Sienci-Labs/Resources/_bp-icons.md

sections: bp-folder ["bp-check","bp-laptop","bp-puzzle-piece","bp-wrench","bp-book","bp-thumbs-up","bp-compress"]
post: bp-caret-right ["bp-file","bp-files","bp-file-text","bp-file-word","bp-file-excel","bp-file-powerpoint","bp-file-image","bp-file-archive","bp-file-audio","bp-file-movie","bp-file-code","bp-image","bp-camera-retro","bp-camera","bp-video-camera","bp-film","bp-play-circle","bp-home","bp-pencil","bp-trash","bp-gear","bp-gears","bp-sliders","bp-tasks","bp-server","bp-plug","bp-lightbulb","bp-life-bouy","bp-key","bp-microphone","bp-flash","bp-power-off","bp-wrench","bp-legal","bp-magic","bp-refresh","bp-info-circle","bp-exclamation-circle","bp-question-circle","bp-music","bp-headphones","bp-volume-up","bp-bullhorn","bp-bell","bp-search","bp-envelope","bp-phone","bp-star-o","bp-star","bp-star-half-empty","bp-user","bp-group","bp-thumbs-up","bp-thumbs-down","bp-comment","bp-comments","bp-check","bp-close","bp-signal","bp-bar-chart","bp-clock","bp-download","bp-lock","bp-unlock-alt","bp-tag","bp-tags","bp-book","bp-bookmark","bp-globe","bp-map-marker","bp-chevron-left","bp-chevron-right","bp-angle-left","bp-angle-right","bp-expand","bp-compress","bp-random","bp-eye","bp-calendar","bp-list-alt","bp-table","bp-briefcase","bp-thumb-tack","bp-trophy","bp-upload","bp-bookmark-o","bp-credit-card","bp-wifi","bp-feed","bp-link","bp-cloud","bp-cloud-download","bp-cloud-upload","bp-flask","bp-scissors","bp-paperclip","bp-dashboard","bp-sitemap","bp-desktop","bp-laptop","bp-tablet","bp-mobile-phone","bp-quote-left","bp-print","bp-folder","bp-folder-open","bp-smile","bp-frown","bp-meh","bp-flag","bp-shield","bp-rocket","bp-paper-plane","bp-bank","bp-language","bp-archive","bp-newspaper","bp-calculator","bp-eyedropper","bp-paint-brush","bp-area-chart","bp-line-chart","bp-pie-chart","bp-diamond","bp-user-secret","bp-safari","bp-chrome","bp-firefox","bp-opera","bp-internet-explorer","bp-map-signs","bp-shopping-bag","bp-shopping-cart","bp-file-pdf","bp-circle","bp-long-arrow-right"]
