Sienci-Labs/Resources/lmmk3/index.md

---
title: LongMill MK3 Post
menu_order: 0
post_status: draft
post_excerpt: Resources and documentation for the LongMill MK3 CNC. You will find info about routers, software, assembly, end mills - everything you need to get started.
post_date: 2026-05-19 08:14:53
taxonomy:
    knowledgebase_cat: lmk3-the-basics lmk3-assembly lmk3-handbook
    knowledgebase_tag:
        - lmk3
custom_fields:
    KBName: LongMill MK3
    basepress_post_icon: bp-caret-right
skip_file: yes
featured_image: _images/post-image.jpg
---

LongMill MK3 page order should be as follows: (last updated as of March 05, 2026)

👍 The Basics

1. Welcome
2. Specifications
    - Machine drawings
    - Carton weights and sizes
3. Prep for your LongMill
(model after the 4x8 one)
    - Add-ons
    - Feeds and Speeds
    - Auto-spin
    - Workspaces and Homing
    - Fundamentals
    - Software
    - Prepare a perfectly flat table so MDF is parallel to it
    - Link to how to setup and use the add-ons
4. Inductive Sensors
    Don’t use LongMill MK2 page, there is a lot of MK2 specific information
    Link to Workspaces and Homing page
5. Closed Loop Stepper Motors
    Link to alarms
6. AutoSpin Router
    Link to Auto-spin knowledge base

🔧 MK3 Assembly

1. Best Practices
2. Unboxing
3. Table Mounting & Surfacing
4. Final Checks
5. First Project

📙 Handbook

1. Squaring & Tramming
2. Maintenance 🛠️
3. Open Source
