Sienci-Labs/Resources/spindlevfd/index.md

---
title: Spindle VFD Post
menu_order: 0
post_status: draft
post_excerpt: Info on how to use Sienci Labs spindles and source third-party spindles.
post_date: 2026-06-02 14:48:53
taxonomy:
    knowledgebase_cat: spindlevfd-handbook
    knowledgebase_tag:
        - spindlevfd
custom_fields:
    KBName: Spindle VFD
    basepress_post_icon: bp-caret-right
skip_file: yes
featured_image: _images/post-image.jpg
---
