Sienci-Labs/Resources/gsender/index.md

---
title: gSender Post
menu_order: 0
post_status: draft
post_excerpt: 
post_date: 2024-07-18 18:14:53
taxonomy:
    knowledgebase_cat: gdocs gs-advanced gs-ex
    knowledgebase_tag:
        - gsender
custom_fields:
    KBName: gSender
    basepress_post_icon: bp-caret-right
skip_file: yes
featured_image: _images/post-image.jpg
---

gSender page order should be as follows:

📙 The Basics

1. Installation
2. Setup & Layout
3. Using gSender
4. Feedback/Problems/Bugs?

Advanced

1. Shortcuts
2. Homing & Limits
3. Calibration
4. Macros & Automations
5. Tool Changing
6. Wireless Control
7. Add-Ons
8. grbl Alarms & Errors

Experimental

1. Edge Features
2. Classic
3. Compile!
