Sienci-Labs/Resources/gsender/gs-additional-features.md

---
title: Additional Features
menu_order: 1
post_status: publish
post_excerpt: Learn the advanced features of gSender such as shortcuts, macros, workspaces, calibration tools, controlling spindles, lasers, coolant, and more.
post_date: 2021-07-01 15:50:00
taxonomy:
    knowledgebase_cat: gs-advanced
    knowledgebase_tag:
        - gsender
custom_fields:
    KBName: gSender
    basepress_post_icon: bp-caret-right
skip_file: no
featured_image: _images/_gsender/_features/gs_fe_p1_KeyShort.jpg
---

This page covers all the advanced features of gSender such as shortcuts, macros, workspaces, calibration tools, controlling spindles, rotary axes, lasers, coolant, and more. Remember, you can always quickly navigate the page by clicking the headings in the 'Page Contents'.

## Touch Plate Setup

gSender has support for three types of touch plates:

1. The **Standard Block** design
1. **Z Probe**, also sometimes referred to as a 'puck'
1. And our specialized **AutoZero** touch plate

If you're trying to set up a custom **Standard Block** plate, use some calipers to make the measurements shown below. Once these are noted down, enter these into gSender's 'Probe' settings in similarly named entries, apply the changes, and now you should find that gSender's probing routine has been altered to fit the shape of your touch plate.



For a custom **Z Probe**, setting up is simple since you just need the thickness of the 'puck'. Enter that value into gSender's 'Probe' settings under 'Z Thickness', apply the changes, and you should be good to go!



The AutoZero touch plate doesn't require any setup at all, other than selecting it, and applying the changes!

## Calibration Tools

The **Tool Tab** is always available near the bottom left of the screen. Here you'll find some tools that you can use to make finer adjustments to your machine for improved performance:

- XY Squaring
- Movement Tuning
- Surfacing

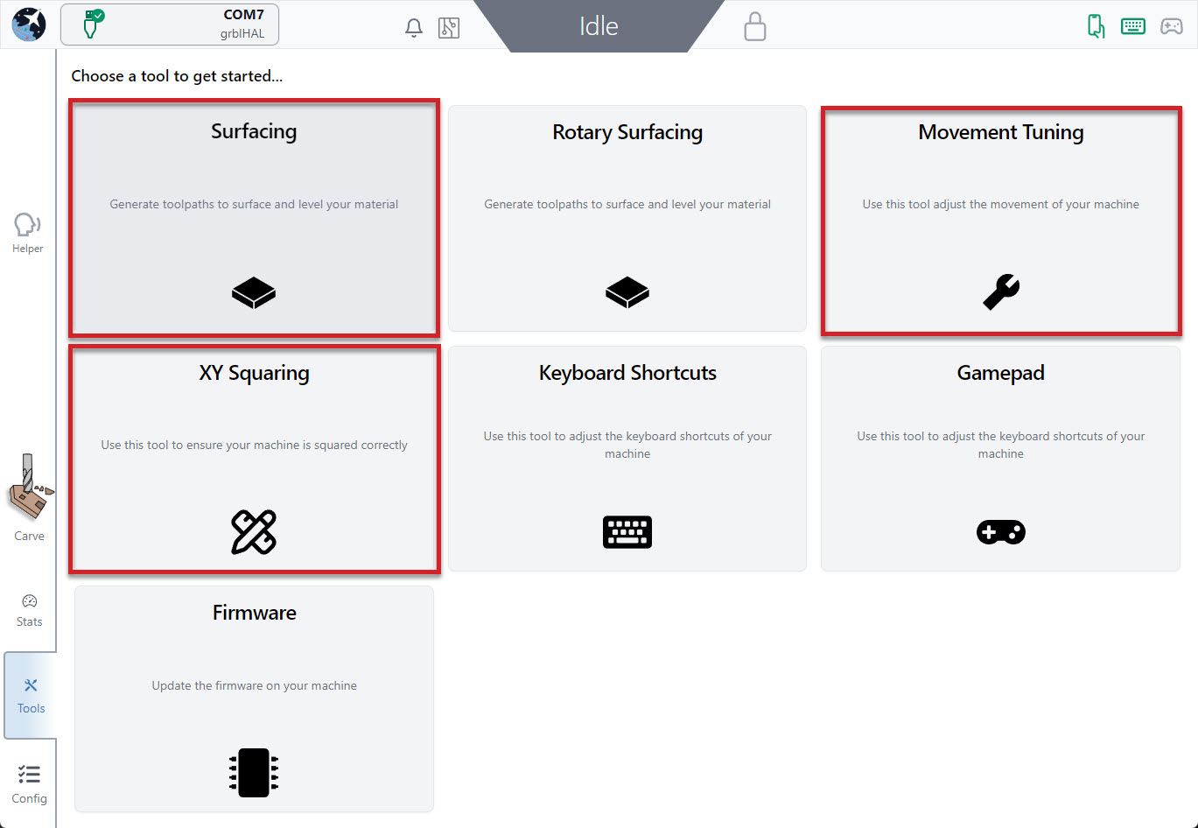
[picture p148: _images/_gsender/_features/_tools/gs_fe_to_main.jpg]


### XY Squaring

When setting up any CNC, like when mounting <a href="https://resources.sienci.com/view/lm-table-mounting/#mounting-your-LongMill">a LongMill to a table</a>, usually a squaring step is needed to ensure cuts don't come out skewed. This **Software Wizard** (step by step guide) is a great asset to help speed things up by turning a typically 'guess-and-check' process into some easy measurements and behind-the-curtain math in 3 main steps:

1. Mark 3 points on your machine to make a triangle (the larger the triangle, the better)
1. Measure & enter the distance between the triangle points
1. See the results and adjust accordingly

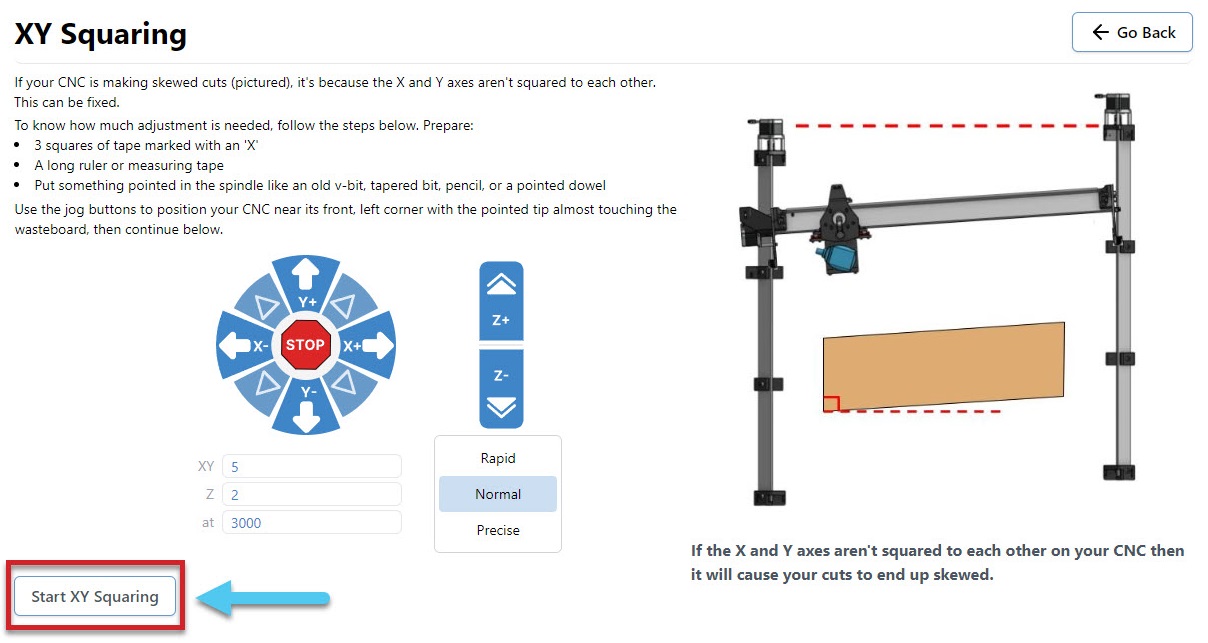
[picture p149: _images/_gsender/_features/_tools/gs_fe_to_xysquaring.jpg]


You will need the following:

- Ruler or measuring tape
- Tapered bit or V-bit
- 3 tape pieces marked with an 'X'

1. Jog the machine to the front left corner, with the bit raised slightly over the surface of your wasteboard
1. **Mark** the point with tape marked with an X, and move the machine as directed (Default 300mm)
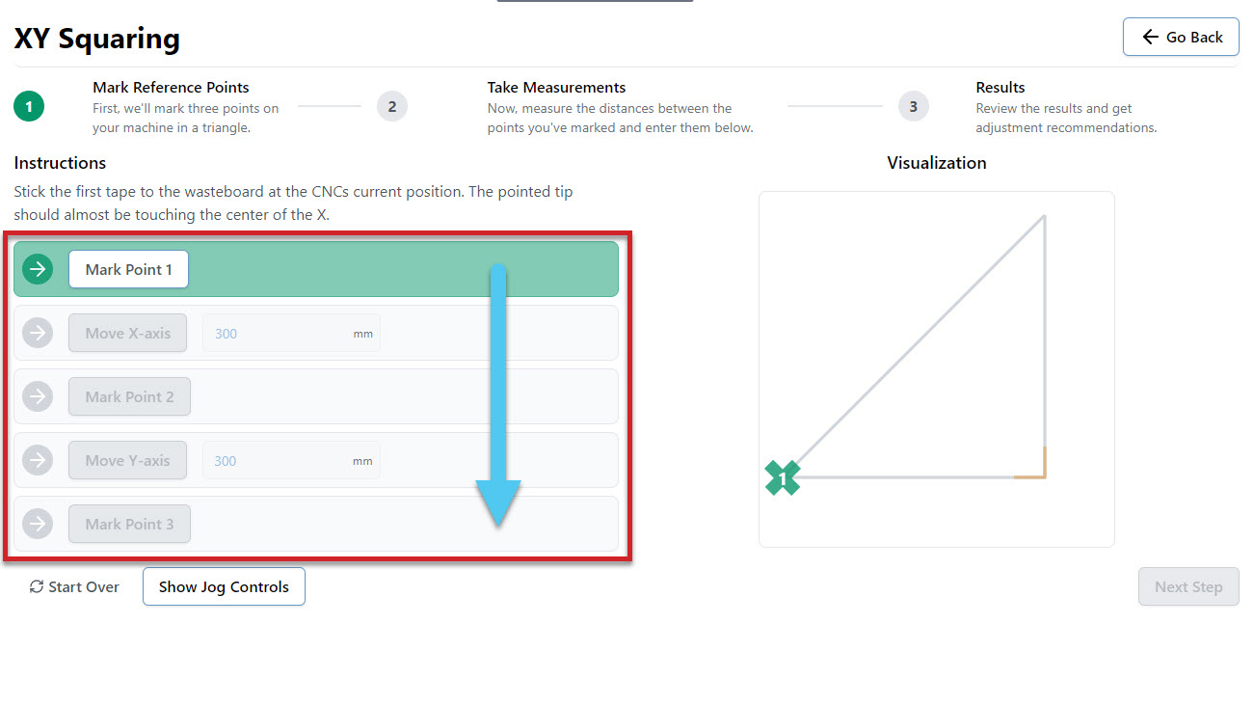
[picture p150: _images/_gsender/_features/_tools/gs_fe_to_xysquaring1.jpg]
  
1. Continue to mark points and move the machine until all boxes are complete and your triangle is marked
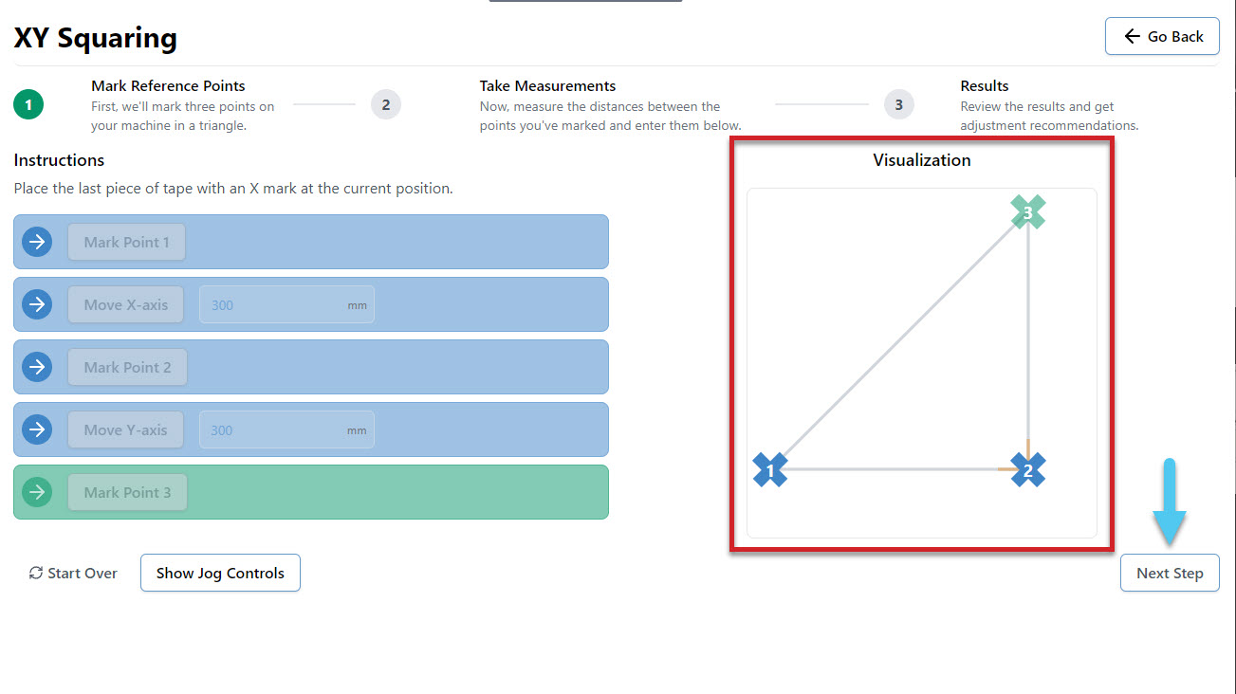
[picture p151: _images/_gsender/_features/_tools/gs_fe_to_xysquaring2.jpg]
  
1. Measure the distance between each X and enter the values into the 3 boxes. For instance you might measure 306mm, instead of the expected 300mm. Hit the Confirm button to move to the results page.
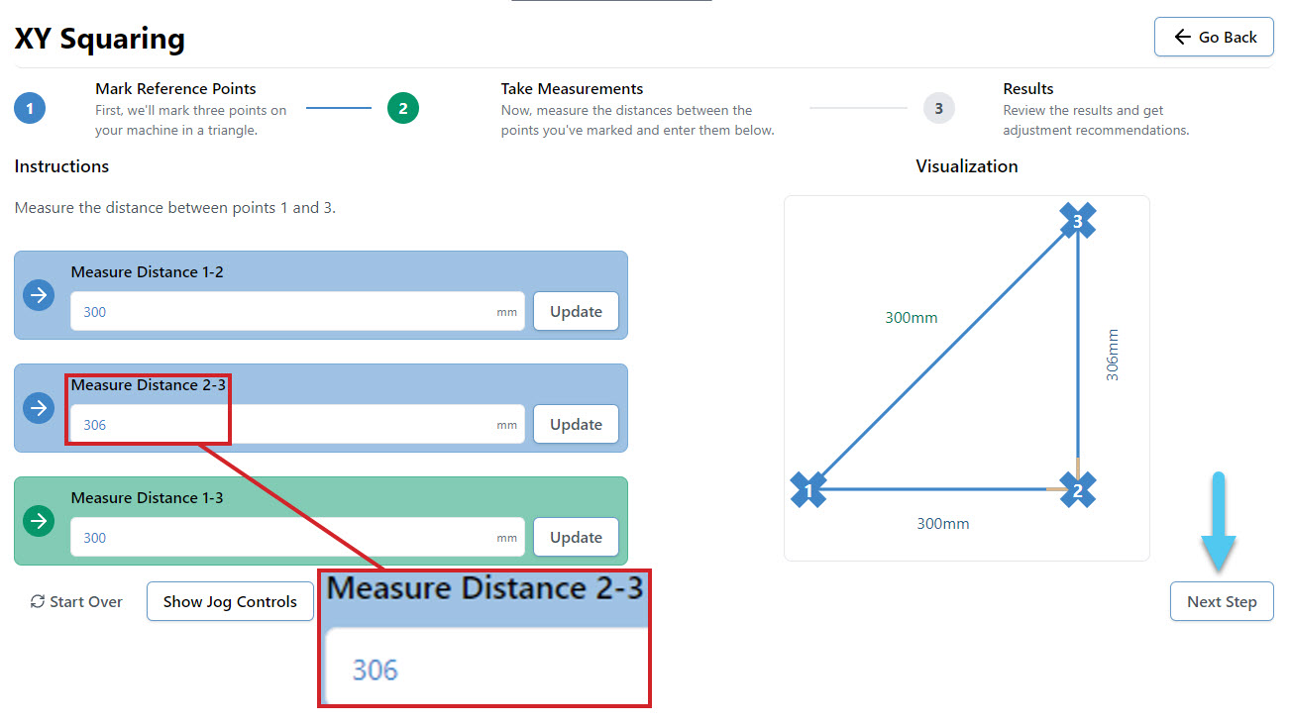
[picture p152: _images/_gsender/_features/_tools/gs_fe_to_xysquaring3.jpg]
  
1. At the end you'll be told how square your machine is and whether you need to take action to adjust it further or if it's close enough that you can leave it. The squaring tool also keeps an eye out for if your steps/mm (axis travel resolution) are off and can adjust those too.
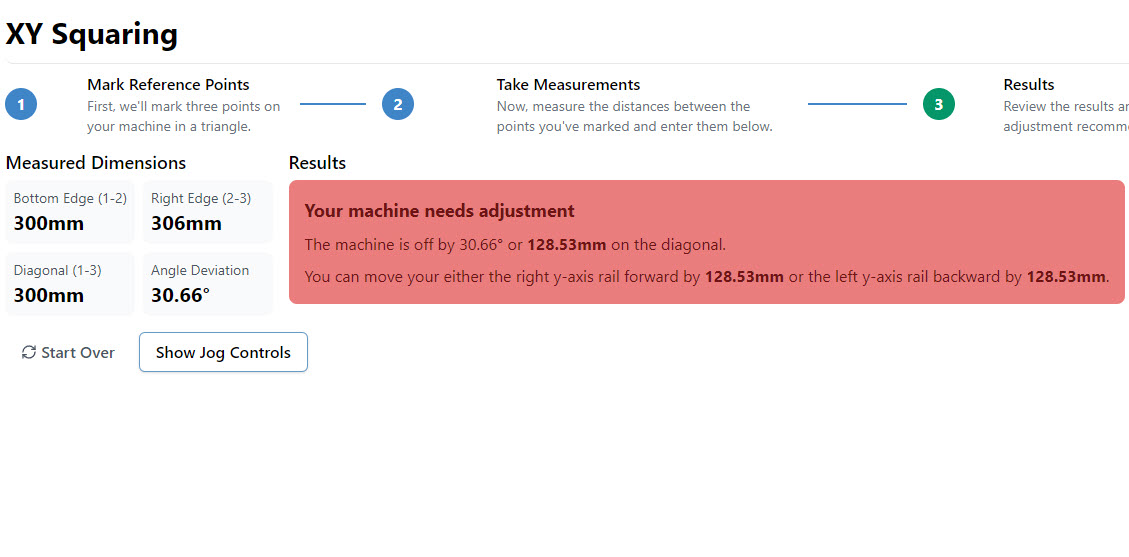
[picture p153: _images/_gsender/_features/_tools/gs_fe_to_xysquaring4.jpg]
  

You can also try watching how this process works in this <a href="https://youtu.be/CCpb70ypulY" target="_blank" rel="noreferrer noopener">user-made video by SparksTech</a>!

### Movement Tuning

Another **Software Wizard** (step by step guide) found in the **Tool tab**. This one is designed to help fine tune how much your motors turn to improve the accuracy of your machine movements. This is done through modifying the EEPROM settings stored on your CNC. You can tune the X, Y and Z axes individually.

You will need:

- Marker or tape
- Measuring tape

1. Jog your machine to the middle of whichever axes you choose to tune, so that there is enough room to complete this procedure. For example, on the X-axis you would jog halfway on the X-axis rail
1. Select what axis to tune on the drop down menu
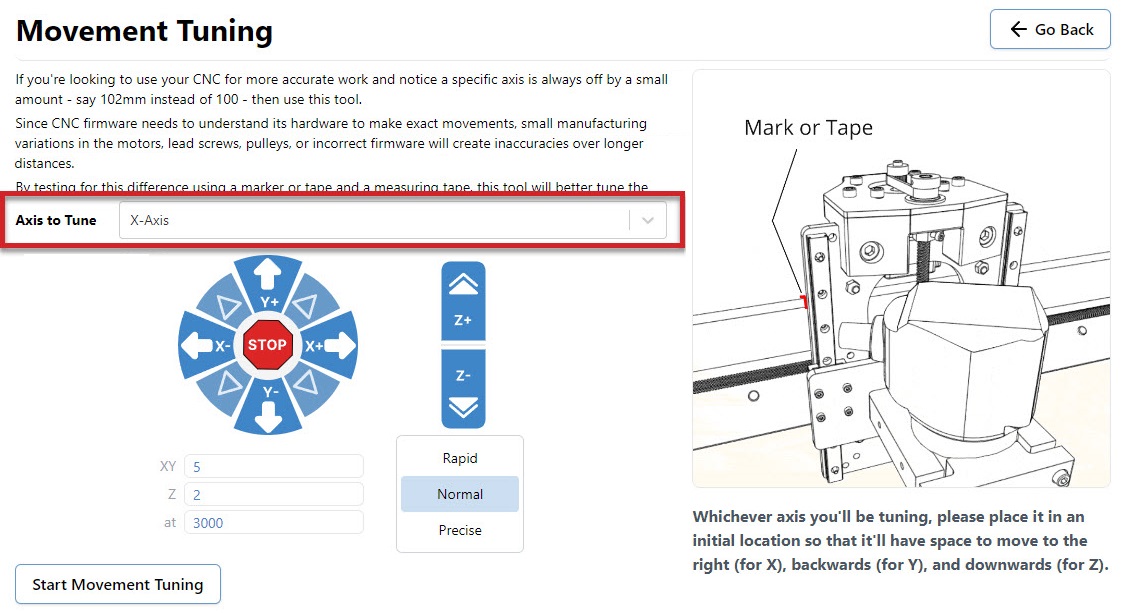
[picture p154: _images/_gsender/_features/_tools/gs_fe_to_movementtuning.jpg]
  
1. **Mark down the starting location** as a reference point on the machine. For example the X-axis tuning references the edge of the XZ gantry on the X rail.
1. **Move** the axis a chosen distance (Default 100mm)
1. **Measure** the distance between the starting location and the finishing location
1. Enter the measured value into the **Set Distance Travelled** box
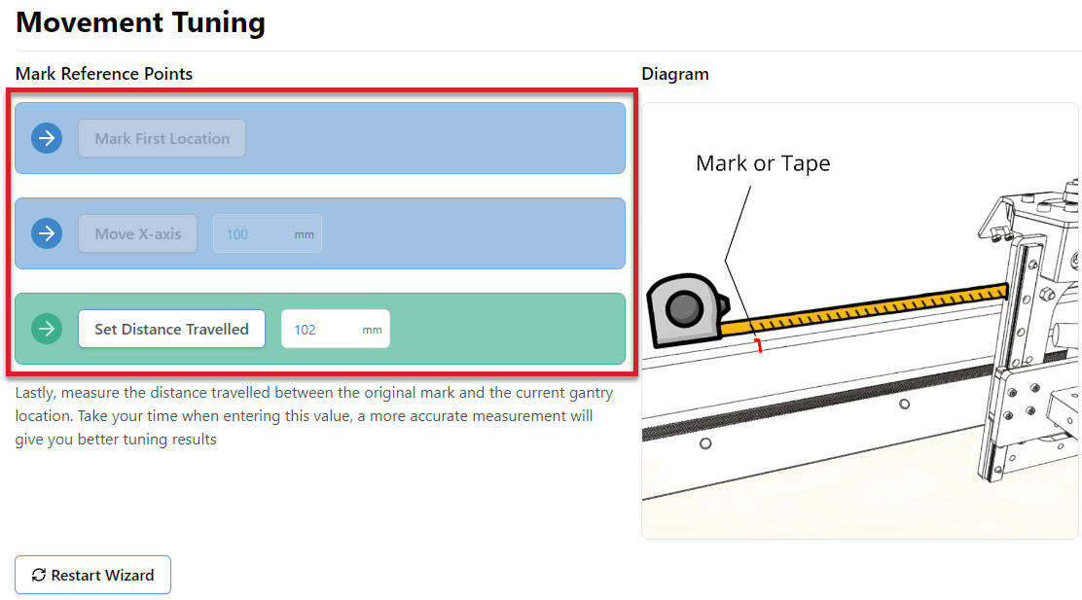
[picture p155: _images/_gsender/_features/_tools/gs_fe_to_movementtuning2.jpg]
  
1. You can now change the EEPROM setting if recommended by the procedure by pressing **Update Steps-per-MM**. This will bring up a popup that explains the change about to be made, and allows you one last chance to cancel the update.
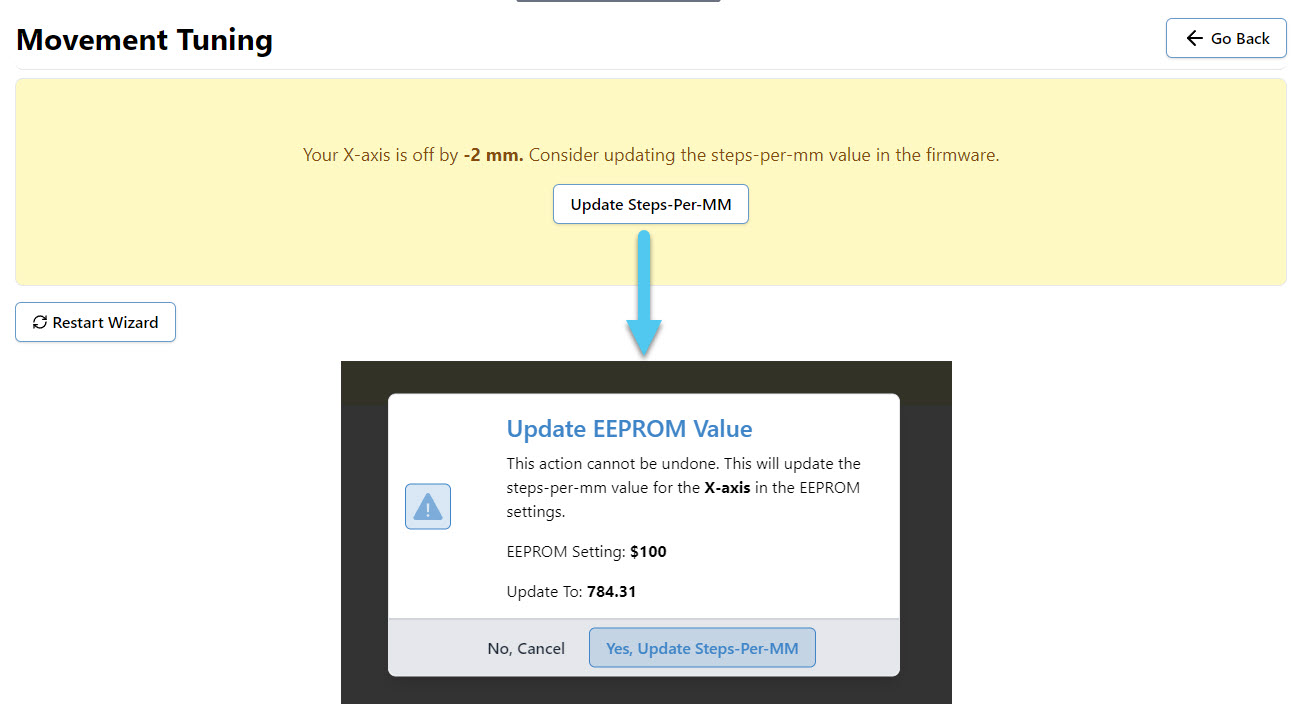
[picture p156: _images/_gsender/_features/_tools/gs_fe_to_movementtuningfin.jpg]
  
1. Repeat the procedure for each axis you wish to tune

### Surfacing

Surfacing the wasteboard of your machine or any project or blank material, can easily be done right inside gSender from the **Tools tab**! This saves the hassle of drawing rectangles in your CAD/CAM program and moving files around until you get the settings right. It's also great for creating a perfectly flat surface of your starting materials, just like a jointer or surface planer would. You can also use the [Rotary Surfacing Tool](#rotary-surfacing-tool) if you are wanting round stock off a rotary axis.

https://youtu.be/hZ8ltb0w3Ao

If you plan to use this tool to surface your wasteboard or larger pieces of material, some extra advice we'd give is to remove any accessories that might get in the way of your machine travelling to its limits as well as have a good vacuum on hand because surfacing can get really messy.

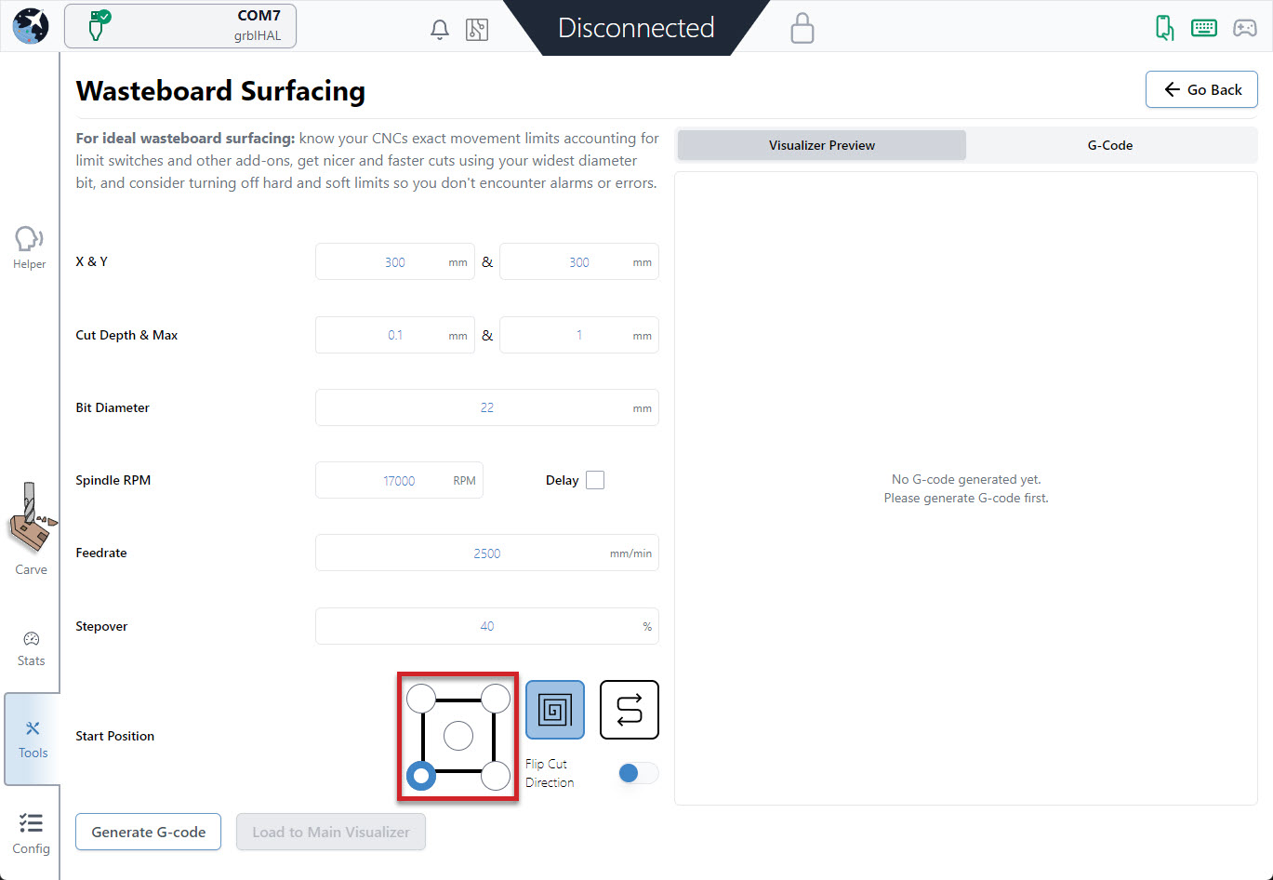
[picture p157: _images/_gsender/_features/_tools/gs_fe_to_surfacing.jpg]


1. Start by entering the settings you'd like to use to generate your surfacing job on the left side:
   - **X & Y**: decides the cutting size (width and depth) you want to surface. If you're surfacing your wasteboard, use the manufacturer's spec on max machine travel or manually jog to the limits to cover the full cutting area, or if you're surfacing a piece of material then you can use a measuring tape.<br>- **AltMill**: 1265mm (49") x 635mm (25") or 1251 (49")<br>- **LongMill MK2**: 818mm (32.2”) or 1278 (50.3”) x 366mm (14.4”) or 866 (34.1”)<br>(if using limit switches, remove about 8mm/0.3” in X and 11mm/0.43” in Y)<br>- **LongMill MK1**: 320mm (12.6”) or 805 (31.7”) x 344mm (13.54”) or 844 (33.23”)<br>(if using limit switches, remove about 35mm/1.38” in X and 24mm/0.94” in Y)<br>(if using magnetic dust shoe, remove about 34mm/1.34” in X)<br>- **Mill One**: 235mm (9.25”) or 257 (10.1”) x 185mm (7.28”)
   - **Cut Depth & Max**: describes how deep you want to cut per pass and the total depth you want to cut down. For larger surfacing bits usually you should keep cut depth below 1mm, max depth should be increased to a couple millimeters if you think your material is very warped.
   - **Bit Diameter** (typically 6 - 25mm): make sure you have the right bit for the job like a surfacing tool or a large, flat end mill since this will give you a better surface finish.
   - **Spindle RPM** (default 17000): only applies if you have an automatic speed control, otherwise set this manually on your router.
   - **Feed rate** (default 2500mm/min): influenced by the RPM, step over, bit diameter, and cut depth. Luckily if you set it incorrectly you'll be able to override it during the job since surfacing can cause burning when cutting too slow or can have worse surface finish when cutting too fast.
   - **Stepover** (default 40%): sticking around 40% tends to be a good balance between speed (using a higher %) and better surface finish (using a lower %).
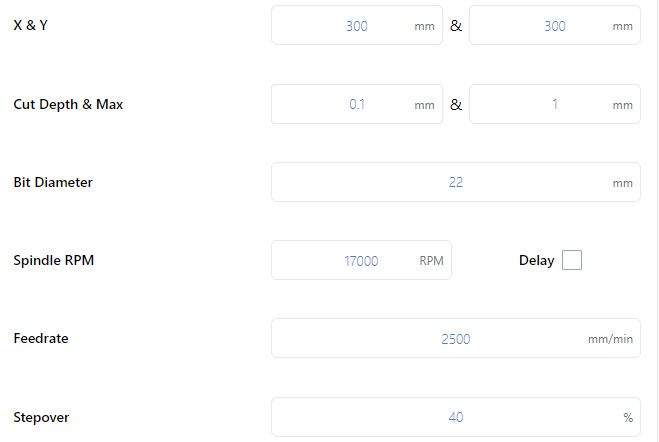
[picture p158: _images/_gsender/_features/_tools/gs_fe_to_surfacing2.jpg]
  
1. Decide where you want to start surfacing from by clicking any of the corners or the center. In most cases the front, left of the machine is the most convenient, and is the default setting. You can also select a surfacing pattern of spiral or zig-zag. The spiral will only cut from the inside-out if the start position is the centre. If you toggle the flip cut direction, the spiral will cut conventional instead of climb, and the zig-zag pattern will cut vertically instead of horizontally.
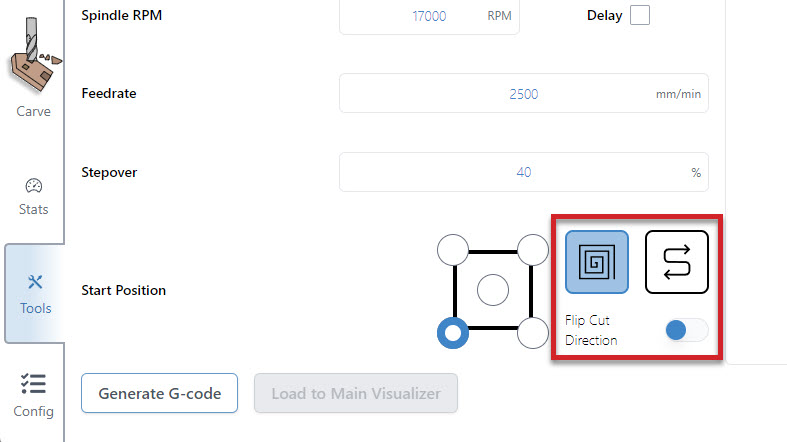
[picture p159: _images/_gsender/_features/_tools/gs_fe_to_surfacing3.jpg]
  
1. Press '**Generate G-code**' and check your surfacing tool path using the 'Visualizer Preview' tab. You can also see the raw g-code using the 'G-code Viewer' tab and can copy and save it to a g-code file if you'd like to use it again later.
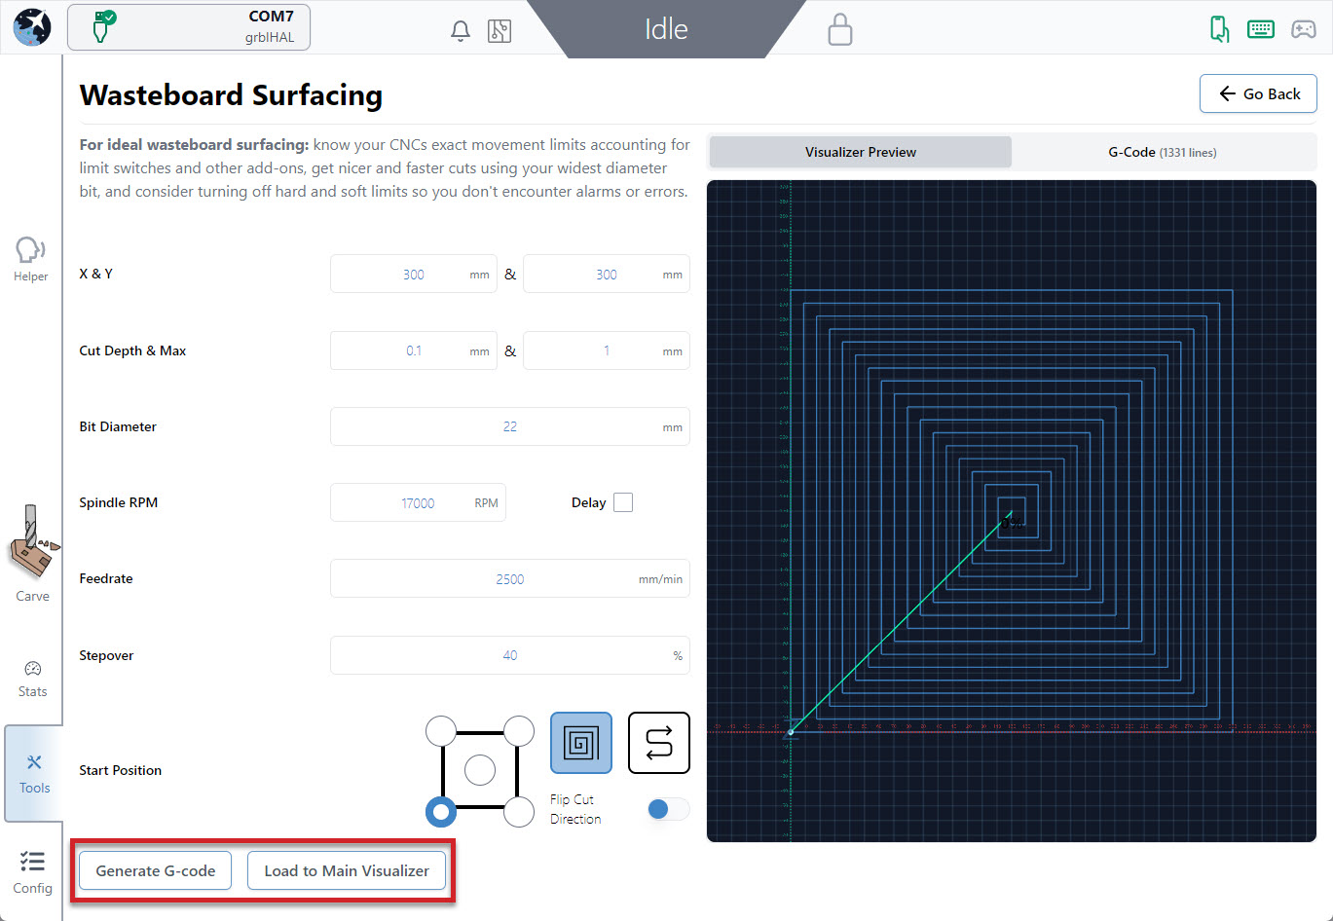
[picture p160: _images/_gsender/_features/_tools/gs_fe_to_surfacing4.jpg]
  
1. Press '**Load to Main Visualizer**' to bring the g-code into gSender's main screen. Make sure that you jog to the starting point and set your zero in the right place before starting the job. You can also press the '**Outline**' button as an easy way to check that you'll be surfacing where you expect and if you find the dimensions aren't correct you can always re-open the surfacing tool, tweak the size, and try again. Feel free to start the job whenever you're ready!
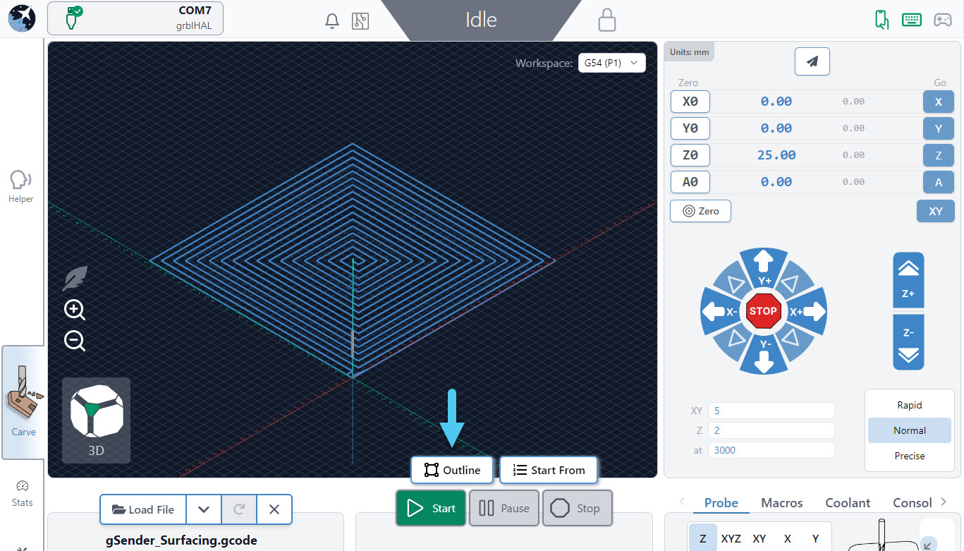
[picture p161: _images/_gsender/_features/_tools/gs_fe_to_surfacing5.jpg]
  

## Spindle & Laser Support

Similar to the manual coolant control, this area is for manual control of a spindle or laser outside of g-code sending. If you have a spindle or laser, you can activate these controls by going to the Config tab ➜ Spindle/Laser section. Here you can enable these functions by flipping the 'Spindle/laser controls' toggle. Don't forget to apply your new settings!



Back at the main Carve screen, you'll see the 'Spindle/Laser' tab at the bottom right. Here you can click to toggle between 'Spindle Mode' and 'Laser Mode', changing your grbl settings for you and displaying buttons specific to each device. For each mode there is also a warning that will appear in the right, top bar of gSender to inform you if the spindle or laser are active. This will happen both during manual control but also during job sending.

In '**Spindle Mode**' you can select your current spindle, adjust the spindle speed with a slider, spin it up in either direction, and stop it again with the 'Stop' button. These are all based on g-code commands that can also be entered into the console manually if desired. The speed slider is set from your grbl firmware settings, so max and min speed can be altered in the Config ➜ Spindle/Laser.



'**Laser Mode**' is very similar, allowing for On/Off control, a slider for setting the laser power during manual control, and a 'Laser Test' button. The laser testing function is handy when troubleshooting your laser setup or for other sorts of locating and alignment because it only enables the laser for a short time before turning it back off again. Though this is much safer than regular on/off control, we still highly advise that you have you have a hand on a kill switch or E-stop during testing or control of either Laser or Spindle modes so that in case something goes wrong with your computer or the program they can still be safely deactivated.



### Laser Diode Support

Some accessories can be really handy to add to a CNC router like a laser diode, drag knife, or pen plotter. These would all perform better on a faster, dedicated machine, but for occasional use why not use the existing motion system of the router to do other things for you? A laser diode in particular can be great because you can clamp the material to carve and then laser engrave afterwards and know that everything is still aligned.

Since many CNCs are coming with diode accessories, gSender has some unique features to also support lasers. Once 'Laser Mode' is turned on, gSender will:

- Automatically apply an offset from the router/spindle to the laser so all your g-code files stay aligned (configured in the Spindle/Laser settings, or with Firmware settings $741 and 742 on the SLB).
- Turn on the laser at low power when running a job outline (enabled in the Spindle/Laser settings). This will help you to better see where your project is going to be located on the material.
- Switch to a specialized visualization designed to show raster engraving images better than typical g-code visualizers. Seeing the laser intensity in the movements is very useful to get a better idea of what your projects are going to look like when they're run. This will only apply to files loaded after 'Laser mode' is enabled, where you'll see the colour change from the default **blue** to **red**.



## Coolant Control / IOT Relay

If you have a coolant control pin on your CNC machine, gSender has a tab for manually controlling it. Under the 'Coolant' tab on the main Carve screen, you can find the 'Mist' and 'Flood' buttons to activate the different modes of coolant use, as well as an indicator for whether the coolant function is active or inactive. This indicator also functions during job sending. You can turn off both coolant pins by pressing the 'Off' button.

Many hobby CNCers don't have a need for coolant and so prefer to use these outputs for controlling other periphery. The most common is an IOT relay that can be used to automatically control a vacuum for dust collection, the CNC's router, LED lighting, and more. See an example of how to set that up here: <a href="https://resources.sienci.com/view/lm-iot-relay/" target="_blank" rel="noopener">https://resources.sienci.com/view/lm-iot-relay/</a>



## Homing / Limits

Before getting into the weeds on how you can set up limit switches and homing on your CNC for various benefits, it would be good to briefly cover some of the basics:

- On the main Carve page, above the jog controls, you should see a set of numbers and buttons that make up your machines 'DRO' (Digital Read Out). You can think of it as similar to a car navigation system.
  - The buttons around this area allow you to make quick movements (blue buttons) and set the <span style="color: #3e85c7;">blue numbers</span> back to a value of 0.
  - You'll see two sets of numbers, where the blue ones on the left are your **<span style="color: #3e85c7; text-decoration: underline;">Work Coordinates</span>** and the gray ones on the right are your **<span style="color: #777; text-decoration: underline;">Machine Coordinates</span>**; these are the two primary coordinate systems that guide a CNCs movements.
  
- A CNC's **<span style="color: #3e85c7; text-decoration: underline;">Work Coordinates</span>** are very often used/edited in day-to-day cutting since they describe the exact location of the project that you're planning to cut.
  - This is effectively the 'working area' of your project.
  - Once you've placed your material on the machine bed, you'll bring the cutting head to the starting point for the project (also known as the 'zero point' or 'origin') then let the machine know that it's now at the starting location.
  - When you're at the starting location for your project, the <span style="color: #3e85c7;">work coordinates</span> should all read as '0', but if you manually move your CNC to the left, down, or towards you then the number will start to decrease, or they'll increase if you move right, up, or away from you.
- The **<span style="color: #777; text-decoration: underline;">Machine Coordinates</span>** starts to become more important once you've set up **Homing** on your CNC
  - These numbers are very similar to <span style="color: #3e85c7;">work coordinates</span>, except they describe the 'working area' of the CNC itself.
  - This means that once you turn on your machine and home it, it'll now know exactly where it's located within its physical size constraints, it'll also know the exact offset between the homing location and the location of your <span style="color: #3e85c7;">work coordinates</span>.
  - This starts to become powerful because you can then do things like resume cutting your job after a loss of connection or power-outage for example. Using homing and <span style="color: #777;">machine coordinates</span> gives your CNC the memory of its location no matter the circumstances.
  - Using <span style="color: #777;">machine coordinates</span> without homing is also still possible, but you'd need to bring your machine to a reliable location using probing or some other method, then power-cycle the machine, since without homing the machine coordinates are set at the time the machine first powers on.
  

### Workspaces

Another concept worth mentioning is **workspaces**. Usually you would only have one 'zero position' per project, but what about cases where:

- You need to reorient your material to cut at it from a different side
- You plan to do a series of carves that require different zero positions
- You want to align your projects to jigs you've fixed to the CNC bed

In these cases, workspaces are basically the ability for you to set multiple **<span style="color: #3e85c7;">work coordinates</span>** that your machine will remember and can toggle between. All you have to do to use these is select a new workspace using the dropdown on the Carve page, after which everything else will continue to behave as normal including zeroing, probing, running files, and more.



In the image below you can see a demonstration of setting up 4 different workspaces to align to jigs on the wasteboard of the CNC. Each of these has their zero set to the bottom left corner, except the circle jig which has the zero placed at the middle.



This is also discussed at about 5:30 of the video below:

https://youtu.be/jmiaWA5tiVw

### Setting up Homing

The summary of the benefits of homing is that it allows your CNC to reliably know its own location. This provides many benefits like job recovery and using workspaces for more complex jobs or batch cutting. To get homing working on your CNC, you'll need:

1. **Limit switches** (also referred to as *end stops* or *homing switches*) which are installed at one or both ends of each movement axis of the CNC. You can see an example of these [on our store](https://sienci.com/product/inductive-sensor-kit-for-the-longmill-mk2/).
1. **Homing enabled in firmware** which can be done through the Config tab
1. **Machine limits set up** to match the physical travel distances of your CNC
1. Any other customization you'd like to make for your particular setup

Going to the Config Tab and scrolling to the Homing/Limits section you'll see an option to turn Homing on:



**grblHAL** machines will also have additional options to choose from, like homing single axes, requiring homing on startup, set machine origin to 0, and more. Typically you'll at least want to turn on 'Set machine origin to 0'.



While you're here, we'd also recommend that you use the lights at the top of the Homing/Limits section to check that all your limit switches are plugged in and working correctly. They should be red by default and light up green when they're triggered, and if that's not the case then you might want to change your settings or check your wiring.

Once you apply settings, you'll find back on the main Carve screen that there are some new buttons available:



1. The **Home** button will help you to manually home your machine any time you need (sends the typical $h command). For your first time homing, have your hand on the machines E-stop in case the homing goes the wrong direction. Many machines home to the front left corner or the back right, so if your machine is behaving incorrectly then go back to Config to adjust your homing directions.
1. Four **Rapid-Travel** buttons to move your CNC at its maximum speed to any of your machine's 4 corners (offset by 5mm). **These should only be used once your machine is homed and you've correctly set up [your machines maximum travel](#setting-limits).**
1. A configurable **Park Location** that acts similarly to the Rapid travel buttons but instead moves to a custom location you set yourself. To set up your parking spot, go to Config ➜ Homing/Limits and scroll down to the bottom of the section. Here you can enter the coordinates of your parking spot manually, or move your router/spindle to the spot you wish to park and hit the **Grab** current position button. Test out your new spot by hitting the 'Go to' button in settings or hitting the 'P' button on the DRO. Don't forget to hit the Apply Settings button to save your new spot!
  

### Setting Limits

Things like machine limits for the **<span style="color: #777; text-decoration: underline;">Machine Coordinate</span>** system are usually set up by the manufacturer and so might never need changing. There are cases though where depending on your model or if you've assembled a kit and installed add-on your maximum travel area might need to be adjusted to properly reflect your machines travel limits.

We recommend you do this especially if you're planning to use the 'quick-travel' buttons. You can find these settings by going to Config ➜ Homing/Limits ➜ X-axis maximum travel (Y, Z-axes are here too). Remember to hit the **Apply Settings** button afterwards.

In this example the Y-axis value has been adjusted.

If you'd like more information on how to set up and use limit switches, read here: <a href="https://resources.sienci.com/view/lm-adding-limit-switches/" target="_blank" rel="noopener">https://resources.sienci.com/view/lm-adding-limit-switches/</a>

### Soft Limits

With homing working, you can optionally choose to turn on soft limits. This feature will keep an eye out after you home your machine to see if any movements are trying to go past your [machine limits](#setting-limits), and stop those movements from happening to protect your machine. Enable these in Config ➜ Homing/Limits ➜ Soft limits enable. Don't forget to hit the Apply Settings button to save!



### Hard Limits

If you have a sensor on both sides of each axis, all 6 sensors can provide you a hardware backup solution, to the software solution provided above with the soft limits. With hard limits on, if your machine get's close to the edge of an axis, your sensor will trigger, stopping any further movement. Enable this in Config ➜ Homing/Limits ➜ Hard limits enable.



## Wireless Control

If you've ever wanted to run your CNC without being stuck right next to it, this is the feature you're looking for. Once enabled, it will allow other devices on the same internet network to connect to the main computer that's running your CNC. These '**remote devices**' can be anything that can connect to the internet and run a web browser, meanwhile the '**inline computer**' plugs into your CNC with a USB or Ethernet cable and will receive commands over the internet from the remote device.

This feature is handy if you'd like to:

- Load in a file from your design computer outside your shop then run it on your computer inside the shop
- Use a tablet as the primary means of controlling your CNC rather than a mouse and keyboard
- Use a phone for occasional use when jogging or running functions
- Leverage a mini PC or Raspberry Pi as the inline (tethered) computer for cheap, fanless, and reliable operation without taxing them with a display, keyboard, and mouse (though this still doesn't create a fully 'headless' setup)

Before diving into the setup, here are some quirks and warnings that are important to keep in mind:

- Both systems need to be on the same internet network to work
- The '**remote device**' needs to be able to run a web browser
- The setup process can be a little more involved, so we don't advise using this feature if you're not confident with troubleshooting your own setup
- You may need to be an Administrator of the inline computer to make the changes needed
- If you intend to use this feature for more important projects or with expensive tools or materials, keep in mind that it will always be inherently less reliable than a hard-wired connection
- This feature is **NOT** intended to enable use of your CNC while **AWAY FROM YOUR WORKSHOP**. A CNC should always be run while you or another knowledgeable operator is in the vicinity to ensure safe machine operation and be able to react if intervention is required. CNCs can cause fires from electronics, material friction, and can have other safety hazards if not properly monitored.

### Wireless Setup

All setup steps need to happen on the inline computer (the computer you'll have connected via USB or Ethernet to your CNC) and have been simplified to mostly happen within gSender:

1. To begin, click the cell phone icon on the top right of the screen.
  
1. This is where wireless control is set up. First, click the '**Enable Wireless Control**' toggle. Second, you'll see the boxes for 'Addr' (address) and 'Port' become available. The default values for these should work but if you have a particular setup or require troubleshooting then consider changing these.
  
1. Once you click the 'Save' button, gSender will automatically restart in order for the changes to take place.
  
1. You'll know the setup was successful if gSender restarts and the remote connect icon is green.
  
1. To connect with your '**remote device**', click the cell phone icon again to open the wireless control settings. If you plan to use a phone, use the camera to scan the QR code, and for any other device 'copy' the text at the bottom right  into the address bar of a web browser like Chrome or Edge. After the page loads, you should see a copy of gSender running in the web browser!
  
1. If there was a problem during setup, then you might've encountered a firewall or unavailable port. Solutions to these are covered in the **[troubleshooting](#troubleshooting)** section.

### Using gSender Remotely

With setup complete, regular use is very straightforward:

1. As long as your 'inline computer' is on and connected to your CNC, and your CNC is powered on, then re-using the same text on the web browser of any device will give you access to a copy of gSender running fully remotely. Example text could look like this "192.168.68.155:8000" where for the phone interface it would have "/#/remote" added onto the end.
1. For phones and tablets, it can also be easy to re-use this webpage by saving it to a bookmark on your home-screen so you can open Remote gSender easily anytime you want! <a href="https://youtu.be/UrlDJOY3i-8">Check out this video</a> for details.
1. Once connected, you'll be able to control your CNC remotely with most of the same features and functions you’d normally expect:
   - Use both the remote and inline devices simultaneously to control your CNC like jogging, opening and closing files, probing, macros, and more
   - Notice that both their screens look exactly the same so you can watch the visualizer move around or check on the machine state
   - On phones the screen will look different since we've optimized it for jogging, setting zeros, and probing
   - When you click to 'load a file' you'll only be able to load files from the device you're currently on, don't expect to gain access to the files stored on the opposite device. However once the file is loaded into gSender, you'll be able to run it from any device.
   - There can be multiple remote devices all connected to the same inline computer at the same time to control your CNC from multiple devices. There can also be multiple inline computers controlled from the same remote computer, giving you multi-CNC control from the same device.
1. Some gSender-specific 'local' settings like won't carry over to the remote device so if you want to make sure files are run the same way every time you'll need to transfer your gSender settings over by following the ['Transfer Settings' instructions](#gsender-preferences)

### Troubleshooting

If you ran into issues during remote control setup, here are some checks you can make:

1. Make sure you have gSender open, have gSender connected to your CNC, and you've turned wireless control on
1. Ensure both your computers / devices are on the same internet network and the IP numbers match on both devices
1. If on the remote device you get a popup for "Server Connection Lost", this just means that either gSender on the inline computer was closed or the shared internet is disconnecting. You should be able to fix this by restarting gSender on the inline device, then clicking "Attempt Reconnect" on the remote device.

1. If there was a problem using the specified IP address or Port, you'll get an error window to let you know. In this case you should be able to reopen gSender, go back to the Wireless Control settings, and try another IP or Port until the setup is successful. Common port values are 3000, 8000, and 8080 and generally don't go below 1024 since those are considered privileged. Changing IP addresses can also help if you're running a VPN or need a different internal IP to external IP mapping.
  
1. If you have a Windows Security Alert window pop up during setup, it means your inline computers firewall isn't allowing gSender to communicate to other devices on your network.
   - Check the boxes beside "Private networks" and "Public networks" and click the 'Allow access' button
   
   - If you don't see this popup, click Start and open your computer's Control Panel
   
   - Open the 'System and Security' settings
   
   - Open the 'Windows Defender Firewall' and go to its 'Advanced settings'
   
   - In the column on the left, click on 'Inbound Rules' and then find and double-click on 'gSender'. There might be three options of gSender to click on, you'll want to click on the version that has the word “All” under the 'Profile' column
   
   - In the pop-up box, click on the tab labelled 'Protocols and Ports'. By 'Local port:' you'll want to use the drop-down menu to select "Specific Ports" and then type in the default port of "8000". If you have added a custom port to gSender's Shortcut properties, you'll need to type in that number instead. Once you hit 'Apply', you can check to see if this resolved your problem.
   
   - On newer devices you might alternatively need to go to your Windows security tab, and click the Allow an app through firewall text.
   
   - Scroll down until you see gSender, click on Change Settings, then enable gSender to communicate through the firewall by clicking the checkbox.
   
1. If on Mac, Linux, or Pi you find that you can't connect with outside devices or just want some extra safety you might want to try opening the Universal FireWall (UFW) on a given port to allow external access. This can be started with `sudo ufw enable` (if UFW is not found then install it using `sudo apt-get install ufw` and your root password) then opening the desired port, for example `sudo ufw allow 8080` opens port 8080 for external access. If you want to see what ports are already open, you can use `ufw status verbose`.
1. If when gSender reopens you're met with a white screen, this means an error has occurred that we weren't able to detect. This is rare, but unless we can find some other way to manage this the only fix is to uninstall gSender and reinstall it again.

## Macros

Macros are standalone buttons within the gSender interface that allow you to execute a series of g-code commands when they're run. Macros can come in handy for a variety of uses:

- Button to run a v-carve or laser engraving of a common insignia into the back of your wood pieces
- Perform a specialized probing function for a particular jig you've set up
- Apply a predetermined offset that allows you to easily array your cutting jobs

You can create macros using the '+' button under the 'Macros' tab.



Here you'll see a space for inputting your custom g-code and adding a name and description for the macro. Advanced users may also want to leverage 'Macro Variables' which allow for greater g-code manipulation and pseudo-programming. Press 'Add New Macro' when completed.



New macros will appear as buttons in the 'Macro' tab that can be rearranged by dragging them around. These buttons will display the macro name, show the description if you hover your mouse over them, and can always be later altered or deleted by clicking on their '...' button.



Any macro can be run by pressing it. Once running, you should see the macro start to pulse green while a toast notification on the bottom right hand side of gSender also notifies you that it's running.



Macros can also be ran using shortcuts. Every time you create a new macro it'll become available on the shortcuts list for you to assign a key or gamepad button to. Add your keybindings and press the Active toggle to enable the shortcut.



You can share macros with other users or transfer them between computers by using the import and export features. **To import one or multiple macros, just press the button on the left** and a browsing window will appear so that you can select the macros you wish to import. Similarly, **to export all your current macros, press the button on the right** and it'll open a save window, to generate a save file for you.



### Advanced Macros

gSenders Macro architecture is based on **JavaScript** and uses the Esprima library (<a href="https://esprima.org/" target="_blank" rel="noopener">https://esprima.org/</a>) and so will theoretically support any code that it does. This is exciting because Macros can move far past basic variables if you'd like to perform advanced functions on your CNC:

If you want some initial inspiration, see other macros [**made by our community**](#community-macros) or ones <a href="https://github.com/cncjs/CNCjs-Macros/blob/master/Hole_Center" target="_blank" rel="noopener"><b>made for CNCjs</b></a> (another g-code sender) which should also work in gSender. Otherwise, here are some other points of guidance:

1. You'll want to develop your understanding of typical <a href="https://linuxcnc.org/docs/html/gcode/g-code.html" target="_blank" rel="noopener">g-codes</a> and <a href="https://linuxcnc.org/docs/devel/html/gcode/m-code.html" target="_blank" rel="noopener">m-codes</a> that are used for CNC control (the pages linked are very good sources for that)
1. The "Macro Variables" dropdown in gSender shows many of the most commonly used operations when making your own macro
1. Make your own variable with `%variable = value_you_want_to_set` (ex. % probeSpeed = 150)
1. Use your variable in g-code, like `G21 G91 G0 X[variable]` (moves the X-axis by the amount set in the variable)
1. Test your code by printing it to the console `([variable])`
1. Make dialog boxes appear on the screen to confirm a value or position by putting in an M0 line with a comment, for example `M0 ;Remember to turn on your router before the next step` which will pause the macro and give you the option to 'continue' or 'cancel'
1. Start experimenting with basic math using numbers and variables like `%combo = (variable + variable2 + 4)/2` (Hint: you don't need square brackets around variable names when the line starts with `%`, <a href="https://forum.sienci.com/t/macro-gcode-question/21399/6" target="_blank" rel="noopener">explanation</a>)
1. Use global variables `global.variable` if you want variables that you can use in other macros (note that these get reset once gSender is closed)
1. Read up on all the other Math features available like <a href="https://developer.mozilla.org/en-US/docs/Web/JavaScript/Reference/Global_Objects/Math" target="_blank" rel="noopener">absolute value, rounding, and trigonometry</a> (become very useful for more advanced probing cycles for example)
1. Start to add more logic to your code using ternary expressions to choose between two outcomes (e.g. `%variable = (30 > 20) ? 10 : 20` which is checking if 30 is bigger than 20, and if it is it'll make the variable = 10, otherwise it'll make the variable = 20).
1. Here's an example of a more advanced macro, made by gSenders Lead Developer, which shows off much of the guidance given above. This macro was made for our new <a href="https://sienci.com/product/slb/" target="_blank" rel="noopener">SLB control board</a> in order to cycle between its 3 <a href="https://resources.sienci.com/view/slb-manual/#status-lights" target="_blank" rel="noopener">status light states</a>.
   - The macro is only 3 lines. First it checks what the current light state is and sets it to 0 if it doesn't have a state. Next, it sets the lights to the current state but applies a modulus of 3 since we can only have a state value of 0, 1, or 2 so we'll get an error if the value is 3 or above. Lastly, it adds +1 to the state so that if the macro is run again it'll put the lights into a new state.
   - `%nextLight = global.lightState || 0`
   - `M356 P0 Q[nextLight % 3]`
   - `%global.lightState = Number(nextLight) + 1`
1. Store many variables in an array so that those variables can be used in other macros without assigning them all as global
   - `%setup = {}`
   - `%setup.this = 0`
   - `%setup.that = 1`
   - `%global.setup = setup`
   - then in the other macro `%setup = global.setup`
1. Create functions that you can then call later such as `%rapid = function (x, y) {return 'G53 G90 G0 X' + x + ' Y' + y + '\n'}` then later run it with `[rapid(x, y)]`
1. Read more about the Esprima library here: <a href="https://docs.esprima.org/en/latest/syntactic-analysis.html" target="_blank" rel="noopener">https://docs.esprima.org/en/latest/syntactic-analysis.html</a>

### Community Macros

If you'd like to add your own macros to this page, [edit the page on GitHub](https://github.com/Sienci-Labs/Resources?tab=readme-ov-file#making-changes) and use the template below for each macro.

[su_spoiler title="<b>Macro Title</b>" open="no" style="fancy" icon="chevron" anchor_in_url="yes"]
**Author:** John D.<br>
**Updated:** Aug 7, 2024

**Description:** Describe the function of the macro, what hardware it's for, and any other details a user may need to configure or steps to run it.

**Code:**

```js
Paste your macro code here.
```

[/su_spoiler]

<b><span class="redText">Disclaimer!</span> These Macros are submitted by our community. They aren't vetted by us and might cause damage to your machine so use them at your own risk!</b> Please review the code and test it before assuming it will work with your machine setup.

[su_spoiler title="<b>Bump Z-axis zero down</b>" open="no" style="fancy" icon="chevron" anchor_in_url="yes"]
**Author:** Chris T.<br>
**Updated:** Jan 5, 2026

**Description:** For when you're doing very precise carving and want to tweak the Z-axis zero slightly without taking a while to type in a new value or re-zero. Only works if you’re in the default G54 workspace, would require some more changes if you want it to intelligently work in other workspaces.

**Code:**

```js
G10 L20 P0 Z[posz + 0.1]

//if you'd like to do this in imperial, use the code below
%newPos = [posz/25.4 + 0.004]
G10 L20 P0 Z[newPos*25.4]
```

[/su_spoiler]

[su_spoiler title="<b>SLB Light-Cycling</b>" open="no" style="fancy" icon="chevron" anchor_in_url="yes"]
**Author:** Kevin G.<br>
**Updated:** Apr 15, 2024

**Description:** Currently only supports the SLB. Allows you to cycle the status light between it's three states of 'Automatic', 'All white', and 'Off' so you can change the light output easily.

**Code:**

```js
%nextLight = global.lightState || 0
M356 P0 Q[nextLight % 3]
%global.lightState = Number(nextLight) + 1
```

[/su_spoiler]

## Console

The console is a tab that you can access at the bottom right hand side of the gSender window. The text here shows a truer representation of the communication that happens between your computer and your CNC. As you start to understand more about your machine, this is a great tab to reference so you can see if commands are being properly sent, received, and executed. It's also great for troubleshooting since you can:

- Manually send g-code commands to your CNC
- Check for errors or alarms and the g-code that caused them (normally the line that comes before)
- Copy text straight from the console to send in an email for help by clicking the '...' button next to 'Run', then clicking 'Copy last 50 lines'.
- Even open the console in another window by pressing the top, right icon to help you see more console text at a time (if you press the button again once you reconnect to your CNC, it'll reconnect the console stream to the original window too)

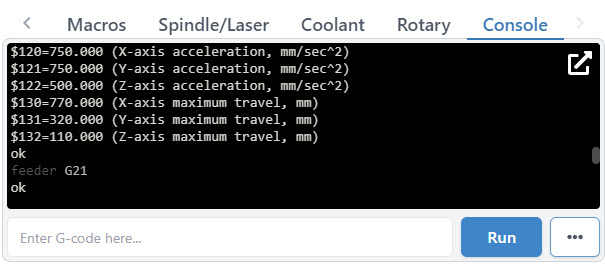
[picture p162: _images/_gsender/_features/gs_fe_console-tab.jpg]


When you first start up gSender, the console will display EEPROM settings that are sent from the Arduino in the control box. These EEPROM settings control parameters for your CNC such as:

- Maximum speed and acceleration in each axis
- Boundaries of the work area
- Direction of each axis movement
- Limit switch settings

To access EEPROM settings again, enter in “$$” into the console and hit the 'Enter' key or click the 'Run' button. These settings can be changed via the console as well as the Firmware Tool which we've designed as a much more visual way to alter machine settings.

## Automations

A powerful feature to control your accessories automatically (like turning on/off a spindle or vacuum) or to run movement macros that are custom to your machine. 'Program Events' (formerly "Start/Stop G-code")' in gSenders settings automatically apply g-code to your cutting job at the start, end, or if you stop, pause, or resume the job. The 'Stop' event is there to ensure that "ending g-code" is always run even if you have to stop a job prematurely. You can also toggle these on and off if you don't want them run for specific jobs.

Three massive perks to setting up automations this way are:

1. There's no need to get into the weeds customizing your CAM post processor
1. gSender is able to send code when you pause, resume, or emergency stop your machine, all of which a g-code file on its own would never be able to do
1. This additional amount of control will make your CNC safer to use

For example, if you were to add M3/M5 commands to your CAM post processor to control your spindle but then chose to pause your job midway to check something, then most CNCs wouldn't know to stop spinning your spindle or retract it since g-code files can't carry this information; this is where gSender is able to the heavy lifting.

For the text-box of the situation you want the action to happen, type in the g-code commands you wish to run, then press the '**Update**' button to save it. For example, if you installed an IOT relay to turn your router and vacuum on and off and wanted to make sure they were enabled for every job you ran, you could add:

- "**M8**" for Start and Resume
- "**M9**" for Stop and Pause
- If you wanted to add a delay to give your vacuum or router time to fully turn on, then you could add "**G4 P5**" after the M8 for a delay of 5 seconds (you can customize that delay to your equipment)
- If you wanted to keep the vacuum and router running during a pause, then you don't need to add "**M9**" to Pause
- All this can also apply to automatically control a spindle, where you'd instead use "**M3**" and "**M5**", you can also add a delay with "**G4 P#**"
- If you want to raise the Z-axis on Pause and lower it on Resume, you could also add:
  - "%global.move=modal.distance" then "G91 G0 Z-5" for Pause to move 5mm out of the way
  - "G91 G0 Z5" then "[global.move]" for Resume to move back down



## Tool Changing

For CNC machines, tool changes are pauses that are programmed in the g-code for a user to switch out the cutting tool for a different one, or the machine to do that automatically. The workflow can also sometimes involve pausing until the user tells it to continue, usually through a 'Resume' and/or 'Confirm Tool Change' button on the machine interface. This allows you to run multiple toolpaths (cutting operations) within one g-code file.

The g-code for tool changing is an M6 command. gSender is quite capable when it comes to customizing CNCs for tool changing, even having full Wizards built-in. The tool change options are in Config ➜ **Tool Changing**. You can select from one of 6 different options, and even choose to 'passthrough' the M6 and T commands to the CNC controller for CNCs that are capable of handling tool changes on their own.



You can **Ignore** any M6 tool change commands, **Pause** the job when a tool change is recognized, or select one of the **Wizards** that will guide you through pre-set tool changing methods. In the image below, you can see an example of the Helper window opening up to show the **Standard Re-zero Wizard** with all of its guided steps.



If you are using one of the wizard options, know that you can access all other gSender controls while the wizard is open like jogging and zeroing. It also has flexibility to go back a step if you missed something or had a mistake, or to be minimized temporarily if you want to check the visualizer.

1. **Ignore**<br>This simply ignores any M6 commands in the g-code file. This is the default option since it's perfect for beginners that only make projects with one tool or those that create separate files for each tool and prefer to manually perform tool changes between files.
1. **Pause**<br>Pauses gSender at the tool change point, as if you had hit the pause button manually. This gives you freedom to jog, zero, or anything else you'd like, and is great for those that are running multi-tool files but want to use a different process than the Wizards provide. This could be a manual probing process, a different tool changing approach, or running custom macros to support your machines specific hardware. gSender is compatible with tool length sensors like the Carbide 3D bitsetter, and our community has compiled a <a href="https://forum.sienci.com/t/bitsetter-and-other-tool-length-sensors-supported-in-gSender/3877/4">list of macros</a> for tool changing that you can use when you are paused. Just note that pausing can't always guarantee keeping track of your movements and actions when it comes time to resume the job so try to ensure you get back to the starting point and set zeros correctly.
1. **Standard Re-zero** (Wizard)<br>Titled 'standard' because it's exactly the same as the standard process you might normally follow for running a file, changing the tool, re-zeroing Z, then running the next file except it's applied to a single file with multiple toolpaths. Since the process is so familiar, this is a great way to dip your toes into tool changing within one file. Compatible with using a touch plate or the paper method, zero out at a predetermined spot (usually at the front left corner), and use jogging to move around. The advantage of introducing this extra automation and guidance during tool changes is that you don't have to worry about custom macros and it reminds you of simple steps like turning the router back on or zeroing Z.
1. **Flexible Re-zero** (Wizard)<br>Similar to the 'standard' wizard with similar steps and manual movements but provides the ability to zero Z off a point that wasn't your starting Z when it comes time to change the tool. This is useful if you tend to carve away your material and lose the starting Z or you don't have limit switches but would like a process similar to a tool length sensor.
1. **Fixed Tool Sensor** (Wizard)<br>This is the most automated setting where all probes and movements are done for you, you only need to intervene by changing the tools. Set up the job and zero normally then expect the machine to move to the sensor location when it reaches a tool change, verify tool length, prompt for a change, probe new tool, then resume cutting. Your machine will need to be homed, have limit switches, and have a tool length sensor (compatible with Carbide 3D bitsetter for example) in order for this option to work. To set up the sensor mount the router/spindle as far down as you might typically put it, with the longest bit mounted in it, then jog it to hover over the tool length sensor with some room to spare and open Config ➜ **Tool Changing** to **Grab** that location, then apply the new settings. This will be the spot your machine moves to every tool change so if it's too low or your sensor doesn't work it'll run into the sensor. You can also enter these coordinates manually, and test them with the **Go To** button.
  
1. **Code**<br>You can enter your own macros before and after the tool change with this strategy selected which is fairly powerful for making tool changing processes that are more automated than just pausing.
  

You can also learn more about how some of this works by checking out this user-made video by SparksTech!

https://youtu.be/kyu2RsZaUA4

## Rotary / 4th-axis

gSender has a unique ability to control a rotary axis on normal, 3-axis grbl and grblHAL machines which we call "rotary mode", as well as typical 4-axis rotary setups on grblHAL machines. The difference between these two is just a matter of how you set it up and whether your machine has enough unique drivers to control either 3 or 4 unique axes.

In either case, the setup starts by going to Config ➜ Rotary and enabling the rotary controls. Don't forget to hit the 'Apply Settings' button!



Once done, you will see an additional tab at the bottom right of the main Carve screen, called 'Rotary'. For 4-axis setups, you'll immediately have access to all buttons and it's unlikely that you'd want to switch over to 'rotary mode', meanwhile for 3-axis setups you'll notice that some buttons will be grayed out before you've switched to rotary mode, or once you're in rotary mode. This is because some actions require movement in the Y-axis and others require movement in the A-axis, and since you have a 3-axis machine you can only do one or the other at a time:



- **Rotary Toggle** - for toggling between [Rotary Mode](https://resources.sienci.com/view/vx-electronics/) and [4-axis Mode](https://resources.sienci.com/view/vx-closed-loop-motor/), or if you're using a 3-axis machine the only option will be rotary mode
- **Rotary Surfacing** - an easy tool for turning square stock into round stock
- **Mounting Setup** (<a href="https://sienci.com/product/vortex-rotary-axis/">Vortex-specific</a>) - helps to drill holes into your wasteboard to mount the Vortex track to your CNC
- **Probe Rotary Z-axis** - automatically probe to find the Z-axis zero
- **Y-axis Alignment** - automatically probe to align the Y-axis to the center of the A-axis

<em><b>Note:</b> you'll always want to first mount ([Mounting Setup](#mounting-setup)) and align ([Y-Axis Alignment](#y-axis-alignment)) your rotary axis before moving forward with any of the other features like: switching to rotary mode, using the jog controls, rotary surfacing, or any other rotary actions.</em>

- **Jog Control** - You'll also see new options to rotate the A-axis, go to Zero, set Zero, and adjust speeds



### Mounting Setup

When mounting a rotary axis, it's important to be parallel to the X-axis, and helpful to have a repeatable position so you can reliably mount and unmount the rotary, depending on when you want to use it. If you have your own rotary axis, this is a step that you'll have to do yourself.

For those who might have our Vortex rotary axis, the '**Rotary Mounting Setup**' button is a specific macro that cuts into the machine wasteboard to help you fasten the rotary with perfect parallel alignment. Check out our <a href="https://resources.sienci.com/view/vx-mounting-your-vortex/#creating-the-mounting-holes">Vortex Resources</a> for more details on how to use this wizard.

### Y-axis Alignment

When switching from regular CNC use to Rotary Mode, you will probe to align the Y-axis along the A-axis. You can do this in the Rotary Tab by hitting the **Y-axis Alignment button**. Check out our <a href="https://resources.sienci.com/view/vx-first-project/#y-axis-alignment">Vortex Resources</a> for more information on aligning your Y-axis when setting up your Vortex.

### Rotary Mode Toggle

Moreso meant for 3-axis machines, this toggle can only happen once you've got your rotary axis set up properly, because after switching it'll assume you've changed your motor wiring to be connected to your A-axis instead of your Y-axis.

The idea is that once you're in this "rotary mode", gSender does the legwork to swap firmware settings over to your rotary setup, translate A-axis movements to your machine as if they were Y-axis movements, and as long as you've done the alignment and swapped over your wires then your rotary A-axis should now be good to go!



When you enable Rotary Mode, you will see a popup warning you of the changes that will be made by continuing:

- The current position of your Y-axis will be set to Zero
- Your hard limits may be turned off
- Other firmware values might get updated to suit your rotary



Once enabled, you will see a confirmation appear in the bottom right corner and several changes will happen in gSender:

- The **Mounting Setup** and **Y-axis Alignment** buttons will become grayed out
- The **Rotary Surfacing** and **Probe Rotary Z-axis** buttons will become available
- The **Go** buttons for the Y and Z-axes will become grayed out
- The **Y0** button will become grayed out
- The '**XY**' Go button will be changed to '**XA**'
- The **Y-axis jogging** buttons will become grayed out



### Rotary Probing

In a similar fashion to regular cnc machining where you set a zero position in relation to the stock you are using, we will do the same when rotary carving. Two differences are that we don't need to enter a tool diameter and each axis will be set separately.

#### Setting Z-axis

You can set your **Z-axis** to either the rotating axis center, or the surface of your stock in a similar fashion to regular CNCing. We recommend using the axis center, as that allows you to make use of the Vortex's built in Z-axis probing functionality.

To do this, jog the cutting bit to be hovering approximately ~15mm just above the chuck. **Double check that your probing wires are in place before proceeding!**



In gSender, select the rotary axis tab, then click '**Probe Rotary Z-axis**' and the Z-axis will begin probing automatically, setting the Z-zero point for you. This will need to be done for each tool change in addition to the beginning of each job.



#### Setting X & A-axis

Setting both the X-axis and the A-axis are done manually.

- To set your **X-axis**, jog to wherever you'd like the job to start then click '**X0**' to set your X-zero point. Make sure this is far enough from the chuck to ensure there won't be any collisions with your cutting bit, workholding or screws.
- To set your **A-axis**, simply click '**A0**' at the beginning of each job, under the Rotary Jog Controls. Note that if this isn't done, the rotary will spin back to zero before the job starts.

### Rotary Surfacing tool

he Rotary Surfacing button will allow you to turn square stock down to a cylinder. We recommend using a **¼ inch upcut end mill** for turning stock, as it's the most efficient.



Now you will see the Rotary Surfacing Tool. Here you will enter details about your stock length, start and final dimensions. You will also see spots for Bit Diameter, Step over, Spindle RPM, and Feed rate.



Rotary surfacing is similar to the regular XYZ surfacing tool. Let's explore this a bit further.

1. Your **start diameter** is the largest diameter on your stock. Usually this means the diagonal distance from opposite corners if you're starting with square or rectangular stock.



1. Your final diameter is determined by the short side of your stock.



1. With a starting height of 90mm and a finished height of 63.5mm, we are removing 26.5mm of material. **However**, since we have the Z-axis set at the center of the material, we will need to divide that 26.5mm in half. We are basically taking 13.25mm off of the top and the bottom. If you want a single pass, your step down would be 13.25mm. Dividing that by two and setting the step down to 6.625mm, means that we will be doing two passes. This will produce a piece of round stock with the maximum diameter possible.

<p style="text-align: center;"><b>(Start Height - Finishing Height) / 2 = Total Step down for ONE pass</b></p>



### Rotary Settings

When you go to Config ➜ Rotary, you'll be able to enter your own settings, reset the default settings and turn Hard Limits on/off.



## More

There's always more to learn about gSender including many videos of lesser-known tips, setups on different CNCs, and open source modifications people have made. For example, check out these videos of Chris showing off some common and less-common tips about how to improve your gSender experience!

https://youtu.be/md_iU6Sgi6k

https://youtu.be/hJfGpHq0Hr0
