Sienci-Labs/Resources/cnc-fun/index.md

---
title: General Post
menu_order: 0
post_status: draft
post_excerpt: Resources and documentation for general CNC work. You will find info about routers, software, end mills, add ons, and more  - everything you need to get started.
post_date: 2024-07-18 18:14:53
taxonomy:
    knowledgebase_cat: the-basics software add-ons handbook
    knowledgebase_tag:
        - cnc fundamentals
custom_fields:
    KBName: Fundamentals
    basepress_post_icon: bp-caret-right
skip_file: yes
featured_image: _images/post-image.jpg
---

General CNC page order should be as follows: (last updated as of Aug 21, 2025)

👍 The Basics

1. Welcome!
2. CNC Machines
3. Prepping to own
4. Cutting Tools
5. Materials
6. Workholding
7. Router vs Spindle --> Routers/Spindles + Spindles & Trim Routers + Tools and Router
8. Safety
9. Table Setup --> Table Mounting + Table Setup + Table/Enclosure + Wasteboard & Fixtures
10. Dust Collection

💻 Software

1. Software Explained
2. Choosing Software
3. Post Processors
4. System Requirements
5. Visualizers
6. Software Table

↔️ Add-ons

1. Touch-plate
2. Limit Switches
3. T-Track & Clamps
4. Laser
5. IOT Relay
6. Spindle Kit

📙 Handbook

1. Machine Coordinates & Setting Zero (gSender features draft)
2. Feeds & Speeds
3. Running Jobs Checklist --> Your First Project + Running Jobs + CNC Pre-Flight Checklist
4. Sanding & Finishing
5. Project Inspirations --> Explore Projects + Design Files
6. Common CNC Terms
7. Advanced / Open Source
