Sienci-Labs/Resources/atc/index.md

---
title: ATC Post
menu_order: 0
post_status: draft
post_excerpt: 
post_date: 2026-02-09 10:16:53
taxonomy:
    knowledgebase_cat: atc-basics atc-assembly
    knowledgebase_tag: 
custom_fields:
    KBName: AutoToolChanger
    basepress_post_icon: bp-caret-right
skip_file: yes
featured_image: _images/post-image.jpg
---

Atc page order should be as follows: (last updated as of Feb, 2026)

👍 ATC Basics

1. Welcome 👋
2. ATC Specifications
3. Safety

🔧 ATC Assembly

1. Before You Begin
2. Unboxing 📦
3. Spindle
4. VFD
5. Air Filter & Compressor
6. Tool Rack & TLS
7. Software
8. Dust Shoe
9. Final Checks
