Sienci-Labs/Resources/altmill/index.md

---
title: AltMill Post
menu_order: 0
post_status: draft
post_excerpt: 
post_date: 2024-07-18 18:14:53
taxonomy:
    knowledgebase_cat: am-basics am-mk2-assembly am-troubleshooting am-software am-handbook am-add-ons am-assembly
    knowledgebase_tag: 
custom_fields:
    KBName: AltMill CNC
    basepress_post_icon: bp-caret-right
skip_file: yes
featured_image: _images/post-image.jpg
---

AltMill page order should be as follows: (last updated as of Nov 21, 2025)

👍 Basics

1. Welcome 👋
2. I Have Questions!
3. 4x4 & 2x4 Specifications
4. Altmill 4x8 Specifications
5. SLB-EXT Controller
6. Prep for your AltMill
7. ER Collets
8. Spindles and Trim Routers
9. Safety

🔧 MK2 Assembly

1. 0. Best Practices
2. 1. Unboxing 📦
3. 2. Table Setup
4. 3. Gantry
5. 4. Z-axis Assembly
6. 5. Motors
7. 6. Drag Chain Ends 🔗
8. 7. Wiring and Spindle
9. 8. Controller Setup
10. 9. First Movements
11. 10. Spindle Kit Setup
12. 11. Surfacing Wasteboard 🟫
13. 12. Final Checks

🧩 Troubleshooting

1. Common Key Solutions 🔑
2. Machine Control
3. Spindle
4. Homing and Machine Limits
5. Movement and Power
6. CNC Pre-Flight Checklist 📋

💻 Software

1. Software Explained
2. Post Processors
3. System Requirements 📊
4. Design Files

📙 Handbook

1. Squaring & Tramming
2. Maintenance 🛠️
3. Spindle Commands
4. Closed Loop Stepper Motors
5. Third-Party Spindles
6. VFD Settings
7. CNC Terminology 💬
8. Open Source 🥽

↔️ Add-ons

1. Spindle Kit
2. Dust Shoe
3. Laser
4. AutoZero Touch Plate

🔧 MK1 Assembly

1. 0. Best Practices
2. 1. Unboxing 📦
3. 2. Table Setup
4. 3. Gantry
5. 4. Z-axis Assembly
6. 5. Motors
7. 6. Dust Shields
8. 7. Drag Chain Ends 🔗
9. 8. Wiring
10. 9. Controller Setup
11. 10. First Movements
12. 11. Spindle Kit Setup
13. 12. Wasteboard 🟫
14. 13. Final Checks
