Sienci-Labs/Resources/gcontrol/index.md

---
title: gControl Post
menu_order: 0
post_status: draft
post_excerpt: 
post_date: 2024-07-18 18:14:53
taxonomy:
    knowledgebase_cat: gc-basics gc-assembly gc-handbook gc-advanced
    knowledgebase_tag: 
custom_fields:
    KBName: gControl Computer
    basepress_post_icon: bp-caret-right
skip_file: yes
featured_image: _images/post-image.jpg
---

gControl page order should be as follows: (last updated as of Nov 21, 2025)

👍 The Basics

1. Welcome!
2. System Specifications

🔧 Assembly

1. gControl Assembly

📙 Handbook

1. Setup and Customizations
2. Networking and Sharing
3. gControl Images

🔧 Advanced

1. gControl Memory and Storage Upgrades
