Sienci-Labs/Resources/laserbeam/index.md

---
title: LaserBeam Post
menu_order: 0
post_status: draft
post_excerpt: 
post_date: 2021-12-23 12:56:20
taxonomy:
    knowledgebase_cat: lb-user-safety-manual lb-the-basics lb-software lb-assembly lb-handbook
    knowledgebase_tag:
        - laser
custom_fields:
    KBName: LaserBeam
    basepress_post_icon: bp-caret-right
skip_file: yes
featured_image: 
---

LaserBeam page order should be as follows: (last updated as of Oct 1, 2024)

📁 Safety

1. User & Safety Manual

👍 The Basics

1. Welcome
2. Laser Diode
3. Laser Driver
4. Lenses
5. Laser Safety Glasses
6. LaserBeam Demos
7. FAQ

💻 Software

1. Choosing Laser Software
2. Laser Test LightBurn Files
3. Using Offsets in gSender

🔧 Assembly

1. Unboxing
2. Introduction
3. Mounting Laser Assembly
4. Cables and Connections
5. Driver Power Supply
6. Turning Driver On
7. Setting Max Current DIP Switch
8. Installing Lens
9. LightBurn Settings
10. gSender Settings
11. Test Out Your Laser
12. Focusing
13. Set XY Zero
14. Vortex Riser Mount
15. Magnetic Mount

📙 Handbook

1. Air Assist
2. Material Guide
3. Cleaning & Maintenance
4. Files for Download
5. Common Issues and Fixes
6. Troubleshooting Files
