Sienci-Labs/Resources/vortex/index.md

---
title: Vortex Post
menu_order: 0
post_status: draft
post_excerpt: Resources for the Vortex Rotary Axis by Sienci Labs. Still in progress, but soon find all information on assembly, technology introduction, toolpaths, and more.
post_date: 2023-08-03 12:26:18
taxonomy:
    knowledgebase_cat: vx-basics vx-assembly vx-projects vx-handbook
    knowledgebase_tag:
        - vortex
custom_fields:
    KBName: Vortex Rotary Axis
    basepress_post_icon: bp-caret-right
skip_file: yes
featured_image: _images/post-image.jpg
---

Vortex page order should be as follows: (last updated as of Nov 5, 2025)

👍 The Basics

1. Welcome!
2. Software

🔧 Assembly

1. Unboxing
2. Headstock
3. Tailstock
4. Track
5. Electronics - Open Loop Motor
6. Electronics - Closed Loop Motor
7. Table Setup
8. Quick Start Guide

📙 Handbook

1. Your First Project
2. Your Second Project
3. Find 3D Models
4. Chuck & Workholding
5. Rotary Feeds & Speeds
6. Troubleshooting
7. Maintenance
8. Using other CNC routers
