Sienci-Labs/Resources/lmmk2/index.md

---
title: LongMill MK2 Post
menu_order: 0
post_status: draft
post_excerpt: Resources and documentation for the LongMill MK2 CNC. You will find info about routers, software, assembly, end mills - everything you need to get started.
post_date: 2024-07-18 18:14:53
taxonomy:
    knowledgebase_cat: lmk2-the-basics lmk2-software lmk2-assembly lmk2-add-ons lmk2-handbook lmk2-advanced
    knowledgebase_tag:
        - mk2
        - mk2-5
custom_fields:
    KBName: LongMill MK2
    basepress_post_icon: bp-caret-right
skip_file: yes
featured_image: _images/post-image.jpg
---

LongMill MK2 page order should be as follows: (last updated as of Feb 20, 2025)

👍 The Basics

1. Welcome!
2. CNC Routers (MK1 & MK2 same)
3. Materials (MK1 & MK2 same except link to dust shoe)
4. Cutting Tools 🌀 (MK1 & MK2 same)
5. Workholding 🕳️ (MK1 & MK2 same)
6. Routers / Spindles (MK1 & MK2 same)
7. Dust Collection (MK1 & MK2 same except pic & link)
8. Touch Plates ⚡ (MK1 & MK2 same except link to touch plate)
9. Table / Enclosure (MK1 & MK2 same except table size and OS)

💻 Software

1. Software Explained 🗣️ (MK1 & MK2 same)
2. Choosing Software 🎛️ (MK1 & MK2 same except one link)
3. Post Processors (MK1 & MK2 same)
4. Visualizers (MK1 & MK2 same)
5. Software Table (MK1 & MK2 same)
6. System Requirements 📊 (MK1 & MK2 same except one link)

🔧 Assembly

1. Unboxing 📦
2. X & Z-Axes
3. Y-Axis Gantries
4. Axes Completion 🗜️
5. Motors & Wiring
6. Checks & 1st Moves
7. Table Mounting 📐
8. Your First Project
9. Extra 48x30 Steps

↔️ Add-ons

1. Touch Plate (MK1 & MK2 same)
2. Dust Shoe & Shields
3. Limit Switches ⛔   revisit)
4. T-Track & Clamps (MK1 & MK2 same except title and link)
5. 48" Extension Kit
6. Laser 🔥 (MK1 & MK2 same)
7. LongMill Spindle Kit   *****
8. Automated / IOT Relay (MK1 & MK2 same)

📙 Handbook

1. Your MK2
2. Tools & Router (MK1 "Feeds & Speeds" & MK2 same)
3. Feeds & Speeds ⏩
4. Wasteboard & Fixtures   revisit)
5. Running Jobs
6. Sanding & Finishing (MK1 & MK2 same)
7. Explore Projects 🪑 (MK1 & MK2 same)
8. Maintenance 🛠️ (MK1 & MK2 close, diff pics, bottom text)
9. CNC Issues & Fixes 🩹   revisit)
10. Common CNC Terms (MK1 & MK2 same)

🧩 Advanced

1. Open Source 🥽 (MK1 & MK2 half overlap)
2. LongBoard Details (MK1 & MK2 close, MK2 in text and link)
3. grbl Firmware 🤖 (MK1 & MK2 close, MK2 in text and link)
4. EEPROM Settings (MK1 & MK2 different values)
5. Stepper Driver Current (MK1 & MK2 same)
6. Changing Microstepping (MK1 & MK2 same)
