Sienci-Labs/Resources/longmill/index.md

---
title: LongMill Post
menu_order: 0
post_status: draft
post_excerpt: Resources and documentation for the LongMill Benchtop CNC. You will find info about routers, software, assembly, end mills - everything you need to get started.
post_date: 2024-07-18 18:14:53
taxonomy:
    knowledgebase_cat: lm-the-basics lm-software lm-assembly lm-advanced
    knowledgebase_tag:
        - mk1
custom_fields:
    KBName: LongMill CNC
    basepress_post_icon: bp-caret-right
skip_file: yes
featured_image: _images/post-image.jpg
---

LongMill page order should be as follows:

👍 The Basics

1. Welcome!
2. CNC Routers
3. Cutting Tools
4. Feeds & Speeds
5. Materials
6. Workholding
7. Routers / Spindles
8. Dust Collection
9. Touch Plates
10. Table / Enclosure
11. Common CNC Terms

💻 Software

1. Software Explained 🗣️
2. Choosing Software 🎛️
3. Post Processors
4. Visualizers
5. Software Table
6. System Requirements 📊

🔧 Assembly

1. Unboxing 📦
2. XZ-Axis Gantry
3. Y-Axis Gantries
4. X-Axis Rail 📏
5. Y-axis Rails
6. Drag Chains and Wiring
7. Electronics
8. Table Mounting 📐
9. Starter Projects 🧱
10. Assembling Add-ons
11. 48" Extension Kit
12. Wasteboard Surfacing
13. More Projects 🪑
14. Maintenance 🛠️
15. Common Issues & Fixes 🩹

🧩 Advanced

1. Open Source & Modifications 🥽
2. Noise, EMI, & Grounding
3. Tool Changing
4. Inductive Sensors
5. Custom Limit Switches
6. IOT Relay Control
7. Adding a Laser
8. grbl Firmware
9. EEPROM Settings
10. Adjusting Stepper Driver Current
11. Changing Microstepping
12. LongBoard Details 🤖
