Sienci-Labs/Resources/vortex/ytsb-vx-where_to_find_3d_models.md

---
title: ytsb Find 3D Models
menu_order: 0
post_status: draft
post_excerpt: 
post_date: 2024-07-18 18:14:53
taxonomy:
    knowledgebase_cat: vx-basics vx-assembly vx-projects vx-handbook
    knowledgebase_tag:
        - vortex
custom_fields:
    KBName: Vortex
    basepress_post_icon: bp-caret-right
skip_file: yes
featured_image: _images/post-image.jpg
---

The Vortex, and any generic rotary axis, is especially well suited to carving full 3D objects as it has access to all sides of the material. While this is only one of the types of carvings that you can do, with the other being normal 2D scarves that wrap around your stock cylinder, carving full 3D models can add a lot of fun to your Vortex experience.

If you’ve had experience creating your own 3D models, you’ll know that you can export your model from your modelling software and import them into VCarve / Aspire then keep working from there. If you have never created your own model before though, don’t sweat it, since luckily enough there has recently emerged many online sources for downloading good quality 3D models - many of them for free. These models are largely for 3D printing and have detail on all sides, so they are perfect for being carved on a rotary as well.



To help you get started, we recommend that you check out one of the following websites. Most of the models are available in a **.stl** OR **.obj** file format which is what you will want for use with Vectric software.

<ul>
  <li><a href="https://www.thingiverse.com/">Thingiverse</a> (Free)</li>
  <li><a href="https://www.printables.com/">Printables</a> (Free)</li>
  <li><a href="https://cults3d.com/">Cults</a> (Sometimes paid)</li>
  <li><a href="https://www.myminifactory.com/">MyMiniFactory</a> (Mostly paid)</li>
  <li><a href="https://www.etsy.com/">Etsy</a> (Commission work)</li>
</ul>
