Sienci-Labs/Resources/vortex/ytsb-vx-workholding_vortex_chuck.md

---
title: ytsb Chuck & Workholding
menu_order: 0
post_status: draft
post_excerpt: 
post_date: 2024-07-18 18:14:53
taxonomy:
    knowledgebase_cat: vx-basics vx-assembly vx-projects vx-handbook
    knowledgebase_tag:
        - vortex
custom_fields:
    KBName: Vortex
    basepress_post_icon: bp-caret-right
skip_file: yes
featured_image: _images/post-image.jpg
---

Even with regular XYZ CNC machining, setting up workholding for your material can be one of the more challenging aspects of a project.

## Clamping Jaws

The four-jaw chuck used on the Vortex includes two sets of jaws:



<ul>
  <li>A <b>Default</b> set of jaws for material that is 0-0.9” diameter. This ‘internal’ set of jaws has the ability to clamp the internal diameter of hollow objects such as pipes, cups, or any other internal geometry.These are named <b>Default</b> because they come installed on your Vortex!</li>
</ul>



<ul>
  <li>An <b>Alternative</b> set of jaws (for stock that is 1-2.5” diameter).</li>
</ul>



To swap out these two sets, simply insert the chuck key into the chuck, and turn this counterclockwise until each jaw falls out. Grab the set of chuck jaws you’ll be swapping in, and check the side of each jaw for a small number (1-4) etched into the side.



Peer into the front of the chuck and look through the slots of the chuck and find the number which corresponds to each individual jaw.



Insert the key into the chuck, turning this either clockwise or counterclockwise. Peering inside the chuck, you’ll see the starting point of the steel spiral rotating inside the chuck. Turn the chuck key such that the start of this steel spiral is aligned with the slot labelled 1.



Grab jaw 1 and slide it into slot 1, ensuring that it is fully seated. The tapered point of the jaw goes in first. (On both sets of jaws)

Turning the chuck key a full turn clockwise will fully engage this first jaw inside the steel spiral.


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
