Sienci-Labs/Resources/mill-one/index.md

---
title: Mill One Post
menu_order: 0
post_status: draft
post_excerpt: Hello there! This resources manual will be your comprehensive guide on everything you need to know to start cutting with your Mill One including assembly, software, CNC use, and maintenance.
post_date: 2021-05-07 22:42:00
taxonomy:
    knowledgebase_cat: mo-basics mo-software mo-assembly mo-more
    knowledgebase_tag:
        - mill-one
custom_fields:
    KBName: Mill One CNC
    basepress_post_icon: bp-caret-right
skip_file: yes
featured_image: _images/post-image.jpg
---

Mill One page order should be as follows:

👍 The Basics

1. Welcome
2. Router Options
3. Workholding Methods
4. Cutting Tool Guide
5. Feeds & Speeds

💻 Software

1. Basic Toolchain
2. CAD
3. CAM
4. G-Code Senders

🔧 Assembly

1. Unboxing
2. Assemble
3. Firmware
4. Preparing to Cut
5. Running the Job
6. More Projects
7. Machine Maintenance
8. Troubleshooting Guide

📙 More

1. Open Source & Mods
2. Touch Plate Wiring
3. Changing Acceleration Settings
4. Safety Manual
5. Warranty
