Sienci-Labs/Resources/_downloads/Open source Hardware BOMs (Sienci Labs).xlsx

Sheet: LongMill MK2
LongMill MK2 Bill of Materials |  | sales ongoing |  |  | **Please note that some quantities or values may not be exact due to changes or extra hardware included. Also, all documentation is prepared with care but there's no guarantee that all provided quantities or information is exact or correct.**
Last updated: | 2023-02-28
 |  |  |  |  |  | = brand new design from the last version
Part | Notes | Quantity | Packed extras | Location |  | = different design but the last version could accept the new one without much issue
X-gantry | ¼” mild steel, powder coated | 1 |  | X-axis |  | = green hardware bag
Y-gantry | ¼” mild steel, powder coated, 'EX'-type for 48x30 | 2 |  | Y-axis |  | = yellow hardware bag
Y-axis Foot | 5/32" mild steel, bent, powder coated, tapped | 4 |  | Y-axis
Drag Chain Mount | 12 Ga mild steel, galvanized, tapped | 1 |  | Y-axis
Z-gantry | ¼” mild steel, powder coated | 1 |  | Z-axis |  | Some of the notable BOM changes for the 48x30 model include: - Longer X-rail - T12 lead screw - Larger T12 bearings, coupler, anti-backlash nuts, and locking nut - Longer drag chain - Drag chain hangers with zip ties - Extension cables for the router, stepper motors, and inductive sensors - An Allen key set with a handle
Z-axis Motor Mount | Aluminum, machined, tapped, anodized | 1 |  | Z-axis
X-axis Rail (custom extrusion) | 990mm for 12x30 & 30x30 models, 1450mm for 48x30 | 1 |  | X-axis
Y-axis Rail (custom extrusion) | 490mm for 12x30, 990mm for 30x30 & 48x30 models | 2 |  | Y-axis
Middle Foot | 3D printed, qty of 12x30 x2, 30x30 x4, 48x30 x4 | 4 |  | Y-axis
1500mm ACME Lead Screw | T12-8mm 4-start, qty of 48x30 x1 | 3 |  | X & Y-axis
1030mm ACME Lead Screw | T8-8mm 4-start, qty of 12x30 x1, 30x30 x3, 48x30 x2
530mm ACME Lead Screw | T8-8mm 4-start, qty of 12x30 x2
200mm ACME Lead Screw | T8-8mm 4-start | 1 |  | Z-axis
T8 Delrin Anti-backlash Nut | M5-16mm socket head cap as adjustment set screw | 4 | 1 | X, Y, & Z-axis
T12 Delrin Anti-backlash Nut | M5-16mm SHC set screw, qty of 48x30 x1
T8 ACME Locking Nut | brass, M3-5mm socket head cap set screw | 4 |  | X, Y, & Z-axis
T12 ACME Locking Nut | brass, M3-5mm SHC set screw, qty of 48x30 x1
ACME Nut Cover | 3D printed, for the Y-axis T8 nuts | 2 |  | Y-axis
608ZZ Flange Bearing | deep groove, C5 clearance | 8 |  | X, Y, & Z-axis
6001ZZ Flange Bearing | deep groove, for T12 lead screw, qty of 48x30 x2
1/4" to 8mm Coupler | custom precision solid type, aluminum | 4 |  | X, Y, & Z-axis
1/4" to 12mm Coupler | custom precision solid type, aluminum, qty of 48x30 x1
Delrin V-wheel | custom precision machined, delrin, 625ZZ bearing x2 | 12 | 2 | X & Y-axis
M5 Eccentric Nut | custom long bore | 6 | 2 | X & Y-axis
MGN12-200 Rail | threaded mounting holes | 2 |  | Z-axis
MGN12 Block | long block | 2 |  | Z-axis
35mm Motor Spacers | aluminum | 16 |  | X & Y-axis
NEMA 23 Motor | 2-phase, 1.8°, 2.8A / phase, 175ozin, through holes | 4 |  | X, Y, & Z-axis
Motor Harnesses | 2.5m long, braided nylon sleeve, 20 AWG stranded wire, VAL-U-LOK connectors | 4 |  | X, Y, & Z-axis
Router Mount | aluminum, mount diameters of 65, & 80mm, custom thicker 25.4mm stock | 1 |  | Z-axis
15x20mm Channel Drag Chain | all kits come with 1000mm long lengths, but can be shortened to match the machine, 48x30 comes with one 1400mm length | 2 |  | X & Y-axis
Chain Aligner | 3D printed, keeps the chain aligned in the Y-axis | 1 |  | Y-axis
Drag Chain Hangers | 3D printed, bundles extension cables for 48x30 model | 2 |  | X-axis
24V 12.5A Power Supply | 100-130VAC, 50/60Hz, fully enclosed, American Plug | 1 |  | Electronics
USB type B Cable | 1m long, shielded, ferrite bead choke | 1 |  | Electronics
E-stop | remote box power control, mountable | 1 |  | Electronics
LongBoard CNC Controller | 4 drivers and an Arduino Uno are sub-components. See LongBoard BOM for more details: https://docs.google.com/spreadsheets/d/1qlHlp576s9GIBMPfp4JU8Yr7xBM5gUNruvHFBVFoDOM/edit | 1 |  | Electronics
AC Power Extension Cable | 16AWG typical 6' heavy-duty indoor AC extension cable | 1 |  | Electronics
NEMA 23 Motor Extension Cable | 20AWG 2100mm length, standard 5.08 terminal | 1 |  | Electronics
Inductive Sensor Extension Cable | 24AWG 2100mm length, standard XH4P JST connector | 1 |  | Electronics
Main Body | 10 Ga mild steel, bent to shape & powder coated | 1 |  | Electronics
Left Side Wall | 10 Ga mild steel, bent to shape & powder coated | 1 |  | Electronics
Right Side Wall | 10 Ga mild steel, bent to shape & powder coated | 1 |  | Electronics
Box Top | laser cut out of 1/4" acrylic | 1 |  | Electronics
M3-10 screw (hex socket head cap) | SEMS screws (integrated washer and lock washer) | 8 |  | Z-axis rails
M3-12 screw (hex socket head cap) |  | 8 |  | Z-axis rails
M3-18 screw (hex socket head cap) |  | 4 |  | Z-axis rails
M4-8 bolt (hex socket head cap) |  | 8 |  | Control box assembly
M4-16 bolt (hex socket head cap) |  | 4 |  | Control box assembly
M4 nylon lock nut |  | 8 |  | Control box assembly
M5-10 bolt (hex socket head cap) | SEMS screws (integrated washer and lock washer) | 10 | 2 | Drag chain and Dust cover mounting
M5-16 bolt (hex socket head cap) |  | 4 | 1 | Delrin nut set screws
M5-25 bolt (hex socket head cap) | SEMS screws (integrated washer and lock washer) | 48 | 2 | Rail, V-wheels, Nut blocks, Middle feet, Router mount
M5-50 bolt (hex socket head cap) | integrated lock washer | 16 | 2 | Motor fastening
M5 nylon lock nut |  | 16 | 8 | V-wheels & Nut blocks
M5 t-nut |  | 8 | 12 | Drag chain mounting
M5 washer | switched to higher-grade to not deflect during tightening | 12 | 8 | V-wheels
#10 nylon washer |  | 16 | 2 | Stepper Motors
#8 x 1" wood screw |  | 16 | 4 | Waste board mounting
Zip ties |  | 4 |  | Extension cables
 | # Unique Primary Mechanics: | 25
 | # Unique Parts: | 53
 | Total: | 292

Sheet: Vortex Rotary
Bill of Materials for Add-ons |  |  | **Please note that some quantities or values may not be exact due to changes or extra hardware included. Also, all documentation is prepared with care but there's no guarantee that all provided quantities or information is exact or correct.**
Last updated: | 2023-08-29
AutoZero Touch Plate
Part | Notes | Quantity | Packed extras
Rotary Axis Track | 800mm Aluminum Extrusion, Standard track for all Vortex configurations | 1
Rotary Axis Track Extension | 460mm Aluminum Extrusion, Extension track for the 48" configurations | 1
Headstock Body | Aluminum, machined, tapped, black anodized | 1
Headstock Motor Standoff | Aluminum, machined, tapped, black anodized | 2
Tailstock Body | Aluminum, machined, tapped, black anodized | 1
Headstock Shaft | SS304, turned | 1
Chuck Backplate | SS304, turned | 1
Live Center Shaft | Aluminum, turned, knurled, tapped, red anodized | 1
Live Center Point | Steel, turned | 1
Headstock Bearing Spacer | Steel, turned | 1
Headstock Bearing Retainer | Laser cut sheet metal | 1
Cam Lever | Aluminum, machined, red anodized | 1
K12 80mm 4 Jaw Chuck | Standard 4 jaw chuck, SANOU brand, includes second set of jaws and chuck key | 1
NEMA 23 Motor | Same motor used in LongMill MK2 | 1
6204-RS Ball Bearing | Headstock Bearings, C5 internal clearance class, P6 tolerance class | 2
608-RS Ball Bearing | Tailstock Livecenter Bearings, C5 internal clearance class, P6 tolerance class | 2
GT2 80T Pulley | Standard size with 16mm ID bore, M5 Set Screws | 1
GT2 18T Pulley | 6.35mm bore, for 10mm width belt, M4 Set Screws | 1
GT2 belt, 10mm width, 220mm length | Closed Loop Belt | 1
M20x1 thin hex nut | Used to secure headstock shaft and preload headstock bearings | 1
M6 square head bolt | Used in tailstock locking | 1
M6 barrel nut (10mm diameter, 20mm LG) | Used in tailstock cam lever | 1
Cam lever washer | Off the shelf, injection molded, used with cam lever in tailstock | 1
25mm/M25 Bore ID Circlip | Used in live center shaft to secure the 608-RS Bearings | 1
MK2 Dust Shoe - Magnet | Used in 3DP rear cover | 1
Headstock Front Cover - Top | 3D Printed, black PLA | 1
Headstock Front Cover - Bottom | 3D Printed, black PLA | 1
Headstock Rear Cover - Top | 3D Printed, black PLA | 1
Headstock Rear Cover - Bottom | 3D Printed, black PLA | 1
Tailstock Front Cover | 3D Printed, black PLA | 1
Tailstock Rear Cover | 3D Printed, black PLA | 1
Locking Knob | 3D Printed, red PLA, To be assembled with a 1/4-20 threaded insert, same as T-track set clamping knob | 1
Extrusion Track Cap | 3D Printed, black PLA | 2
M5-50mm SEMS Socket Head Cap Screw | Plated, For tensioning mechanism through the headstock | 4 | 1
M5-25mm Socket Head Cap Screw | Black oxide, used throughout | 13 | 2
M5-16mm Socket Head Cap Screw | Black oxide, used throughout, three used to attach the retainer to the headstock | 9 | 2
M6-16mm Button Head Cap Screw | Stainless steel, for mounting headstock to extrusion track and chuck to backplate | 7 | 2
Hex Head Machine Screw, ¼”-20 x 2" Fully Threaded | SS304, for tailstock locking knob and adjusting live center | 2
1/4-20 Hex Nut | Zinc, used in tailstock screw | 1 | 1
Flat Head Cap Screw, ¼-20 x 3/4" | SS304, for mounting of extrusion track to wasteboard **Extension Track requires an additional 4 screws | 6 | 8
Threaded Insert, ¼”-20 x 1/2 | Zinc plated, for mounting plate, one used in tailstock locking knob. **Extension Track requires an additional 4 inserts | 7 | 6
Self tapping #4 screw | Used in ends of the extrusion track | 4 | 2
Rotary Switch PCB | 2 Layer PCB, 2oz copper, Black Silkscreen | 1
Rotary Switch Enclosure | 3D Printed, black PLA | 1
Rotary Switch Cover | Laser cut acrylic | 1
1000MM JST XH2.54 Extension Cable Male-Male | For connecting switching PCB to LongBoard | 1
1000MM 5.08 Extension Cable Male-Male | For connecting switching PCB to LongBoard | 2
Inductive sensor | 35mm long, M12-1mm thread, NPN-N/O, JST XH 2.54mm 4 pin connector | 1
Banana plug and connector | Cable used for probing functionality, same harness used in touch probes | 1
 | # Unique Parts: | 49
 | Total: | 98

Sheet: Add-ons
Bill of Materials for Add-ons |  |  | **Please note that some quantities or values may not be exact due to changes or extra hardware included. Also, all documentation is prepared with care but there's no guarantee that all provided quantities or information is exact or correct.**
Last updated: | 2023-03-01
AutoZero Touch Plate
Part | Notes | Quantity | Packed extras
Touch plate | aluminum, special nickel coating | 1
Wiring harness | custom made, 1.5m long, 20AWG 2-wire stranded, 2.54mm terminal connector, strong neodymium magnet, gold plated 5mm ECS5 jack | 1
 | # Unique Parts: | 2
 | Total: | 2
Touch Plate (3-axis / block-style)
Part | Notes | Quantity | Packed extras
Touch plate | aluminum | 1
Banana plug |  | 1
Attaching magnet | N32 strength, D15mm, countersunk | 1
Magnet cover | 3D printed | 1
Ring terminal crimp |  | 1
M4 hex nut |  | 1
M4-10 bolt (countersunk, flat head) |  | 1
Wiring harness | 20AWG, stranded, 2 pin red black, 1.5m long | 1
 | # Unique Parts: | 8
 | Total: | 8
T-Track and Hold Down Clamps
Part | Notes | Quantity | Packed extras
T-Track rails | anodized 6061 extruded aluminum, 36" long | 6
Clamp | 10 Ga galvanized steel | 6
Clamp knob | 3D printed | 6
Clamp end cap | 3D printed | 6
¼”-20 x 13mm threaded insert | fastened into clamp knobs | 6
¼" flat washer | zinc USS | 6
¼”-20 x 2 ½” bolt (hex head) | fully threaded | 12
#8-32 x 3/4" countersunk wood screws | for mounting the T-Track extrusion | 60 | 40
 | # Unique Parts: | 8
 | Total: | 108
MK2 Magnetic Dust Shoe
Part | Notes | Quantity | Packed extras
Dust Shoe Body | 3D printed | 1
Acrylic Window | laser cut out of 3mm acrylic | 1
Mounting Bracket | 10 Ga mild steel, bent, galvanized | 1
Release Trigger | 1/4" mild steel, bent, galvanized | 1
Trigger Spring | k = 1.6N/mm, OD = 8mm, L = 20mm | 1 | 1
Mounting Magnet | N45 strength, D20mm, countersunk | 3
Bristle Strip | ~255mm long strip, 28mm bristle length, backing 4.4mm wide by 4.3mm tall | 1
M5-16 bolt (hex socket head cap) | attaches mounting plate to X-gantry | 2 | 1
M5 nylon locknut |  | 2 | 1
M5 washer | for shimming shoe location | 2 | 1
M4-16 bolt (hex socket head cap) | attaches release trigger to dust shoe body | 1
M4 nylon locknut |  | 1
#6x3/4" wood screw | countersunk Robertson head, mounts magnets to shoe body | 2
#4x3/8" wood screw | pan Philips head, mounts window to shoe body | 3
 | # Unique Parts: | 14
 | Total: | 22
MK2 Inductive Sensor Kit
Part | Notes | Quantity | Packed extras
Inductive sensor | 35mm long, M12-1mm thread, NPN-N/O, JST XH 2.54mm 4 pin connector | 3
Y-axis sensor bracket | 14 Ga, bent to shape & galvanized | 1
M5-10 bolt (hex socket head cap) | SEMS screws (integrated washer and lock washer) | 1
M5 t-nut |  | 1
M12 nut | M12-1mm | 6
Tooth lock washer | M12 sized | 6
 | # Unique Parts: | 6
 | Total: | 18
MK2 Dust Shields
Part | Notes | Quantity | Packed extras
Dust shield | stainless steel, laser cut and bent | 2
M5-10 bolt (hex socket head cap) | SEMS screws (integrated washer and lock washer) | 2
 | # Unique Parts: | 2
 | Total: | 4
MK1 Magnetic Dust Shoe |  |  | (introduced for V3)
Part | Notes | Quantity | Packed extras
Dust shoe base | laser cut out of 1/4" acrylic | 1
Bristle ring | 3D printed | 1
Hose mount | 3D printed | 1
Mounting plate | 10 Ga mild steel, galvanized | 1
Magnets | N45 strength, D16mm, M6-8mm thread | 4
Brush strip | split up into 3 pieces: 145, 115, & 95mm long | 1
Viewing window | PETG copolyester | 1 | 1
M5-16 bolt (hex socket head cap) | attaches mounting plate to X-gantry | 2
M5 nylon lock nut |  | 2
M4-25 bolt (hex socket head cap) | attaches bristle ring and shoe base to hose mount | 3
M4 nylon lock nut |  | 3 | 1
M3-12 bolt (hex socket head cap) | attaches shoe base and viewing window to bristle ring | 3 | 1
M3 nylon lock nut |  | 3 | 1
 | # Unique Parts: | 13
 | Total: | 26
MK1 Inductive Sensor Kit
Part | Notes | Quantity | Packed extras
Inductive sensor | 35mm long, M12-1mm thread, NPN-N/O, JST XH 2.54mm 4 pin connector | 3
X-axis sensor mount | 3D printed | 1
Y-axis sensor mount | 3D printed | 1
Z-axis sensor mount | 3D printed | 1
M3-0.5 brass heat inserts | Heat-pressed into printed parts | 6
M3-10mm bolt (hex socket head cap) | Screwed into brass inserts | 6
M12 nut | M12-1mm | 6
Tooth lock washer | M12 sized | 6
Ceramic capacitors | 3 0.1uF – (104), for use in Rev 1.1 & 1.2 LongBoard | 3 | 1
 | # Unique Parts: | 9
 | Total: | 33
MK1 Original Dust Shoe
Part | Notes | Quantity | Packed extras
Dust shoe base | CNCd on a LongMill out of 9mm ply | 1
Bristle ring | 3D printed | 1
Hose adapter | 3D printed | 1
Left arm mount | 3D printed | 1
Right arm mount | 3D printed | 1
2020 aluminum extrusion | 6 inches long | 2
Backing plate | 10 Ga mild steel, galvanized | 1
T-nuts | M5 threading | 6
Brush strip | split up into 2 pieces: 280 & 140mm long | 1
Knobs | 3D printed | 2
M5-25 bolt (hex head) | pressed into 3D printed knobs | 2
M5-8 bolt (hex socket head cap) | attaches extrusion to backing plate | 4
M5-16 bolt (hex socket head cap) | attaches backing plate to X-gantry | 2
M5 nylon lock nut |  | 2
M4-16 bolt (hex socket head cap) | attaches arms and bristle ring | 4
M4-20 bolt (hex socket head cap) | attaches arms and bristle ring | 2
M4 nylon lock nut |  | 6
 | # Unique Parts: | 17
 | Total: | 39
Mill One Anti-backlash ACME Nut Kit |  |  | (introduced for V2)
Part | Notes | Quantity | Packed extras
ACME nut holder | 3D printed, strengthened from V2 | 3
ACME nut | T8-8mm 4-start, brass, keyed for the leading nut | 3
ACME nut | T8-8mm 4-start, brass, leading nut for backlash compensation | 3
Backlash spring | keeps nuts under tension for backlash compensation | 3
M3-12 screw (hex socket head cap) | mounts ACME nuts to the printed nut holder | 12 | 2
M3 hex nut |  | 12 | 2
 | # Unique Parts: | 6
 | Total: | 36

Sheet: LongMill V4b
LongMill V4b Bill of Materials |  | ~1100 sold |  |  | **Please note that some quantities or values may not be exact due to changes or extra hardware included. Also, all documentation is prepared with care but there's no guarantee that all provided quantities or information is exact or correct.**
Last updated: | 2023-02-28
 |  |  |  |  |  | = brand new design from the last version
Part | Notes | Quantity | Packed extras | Location |  | = different design but the last version could accept the new one without much issue
X axis steel gantry | ¼” mild steel, powder coated | 1 |  | X-axis |  | = green hardware bag
X-axis shoulder bracket | 10 Ga mild steel, galvanized | 4 |  | X-axis |  | = red hardware bag
Drag chain mount | 10 Ga mild steel, galvanized | 1 |  | X-axis |  | = yellow hardware bag
Y axis steel gantry | ¼” mild steel, powder coated | 2 |  | Y-axis
Z axis steel gantry | ¼” mild steel, powder coated | 1 |  | Z-axis
Z axis motor plate | 10 Ga mild steel, powder coated | 1 |  | Z-axis
3x3x990 X-axis rail | on 12x30 and 30x30 models only | 1 |  | X-axis
3x3x500 X-axis rail | on 12x12 model only |  |  | X-axis
3x3x900 reinforcement rail | on 12x30 and 30x30 models only | 1 |  | X-axis
2x2x1000mm Y-axis rail | on 30x30 model only | 2 |  | Y-axis
2x2x500mm Y-axis rail | on 12x12 and 12x30 models only |  |  | Y-axis
Front, left foot | 3D printed | 1 |  | Y-axis
Front, right foot | 3D printed | 1 |  | Y-axis
Back, left foot | 3D printed | 1 |  | Y-axis
Back, right foot | 3D printed | 1 |  | Y-axis
Middle foot | 3D printed - 1pc on 12x12 and 12x30, 3pcs on 30x30 | 3 |  | Y-axis
Drag chain foot | 3D printed, adjust wing shape | 1 |  | Y-axis
Z-axis motor mount | 3D printed | 1 |  | Z-axis
1030mm ACME lead screw | 1pc on the 12x30, 3pcs on the 30x30, T8-8mm 4-start | 3 |  | X & Y-axis
530mm ACME lead screw | 2pcs on the 12x30, 3pcs on the 12x12, T8-8mm 4-start |  |  | X & Y-axis
200mm ACME lead screw | T8-8mm 4-start | 1 |  | Z-axis
Delrin anti-backlash block | with set screw and hex nut for locking | 4 | 1 | X, Y, & Z-axis
ACME locking hex nut | brass, M3-5mm socket head cap set screw | 4 | 2 | X, Y, & Z-axis
608ZZ flange bearing | deep groove | 8 |  | X, Y, & Z-axis
1/4" to 8mm coupler | solid type with split, aluminum | 3 |  | X, Y, & Z-axis
20T pulley, 1/4" bore | with set screws | 1 |  | Z-axis
20T pulley, 8mm bore | with set screws | 1 |  | Z-axis
132mm GT2 belt loop |  | 1 |  | Z-axis
Delrin v-wheel |  | 12 |  | X & Y-axis
M5 eccentric nut | custom long bore | 6 | 2 | X & Y-axis
MGN12-200 rail | threaded mounting holes | 2 |  | Z-axis
MGN12 block | long block | 2 |  | Z-axis
35mm motor spacers | aluminum | 12 |  | X & Y-axis
NEMA 23 motor (unthreaded) | for X and Y axis | 3 |  | X & Y-axis
NEMA 23 motor (threaded) | for Z axis | 1 |  | Z-axis
Motor harnesses | 2.5m long, braided nylon sleeve, 20 AWG stranded wire, VAL-U-LOK connectors | 4 |  | X, Y, & Z-axis
Router mount | aluminum, mount diameters of 65, & 80mm, custom thicker 25.4mm stock | 1 |  | Z-axis
15x20mm channel drag chain | all kits come with 1000mm long lengths, but can be shortened to match the machine | 2 |  | X & Y-axis
24V 10A power supply | fully enclosed | 1 |  | Electronics
AC cable | US/North America Plug | 1 |  | Electronics
USB type B cable | 1m long, shielded & ferrite bead choke | 1 |  | Electronics
E-stop | remote box power control, mountable | 1 |  | Electronics
LongBoard CNC controller | See LongBoard BOM for more details: https://docs.google.com/spreadsheets/d/1qlHlp576s9GIBMPfp4JU8Yr7xBM5gUNruvHFBVFoDOM/edit | 1 |  | Electronics
Main body | 10 Ga mild steel, bent to shape & powder coated | 1 |  | Electronics
Left side wall | 10 Ga mild steel, bent to shape & powder coated | 1 |  | Electronics
Right side wall | 10 Ga mild steel, bent to shape & powder coated | 1 |  | Electronics
Box top | laser cut out of 1/4" acrylic | 1 |  | Electronics
M3-10 screw (hex socket head cap) | SEMS screws (integrated washer and lock washer) | 8 |  | Z-axis rails
M3-12 screw (hex socket head cap) |  | 8 |  | Z-axis rails
M3-18 screw (hex socket head cap) |  | 4 |  | Z-axis rails
M4-8 bolt (hex socket head cap) |  | 8 |  | Control box assembly
M4-16 bolt (hex socket head cap) |  | 11 | 3 | Drag chain mounting & Control box assembly
M4 nylon lock nut |  | 14 | 4 | Drag chain mounting & Control box assembly
M5-25 bolt (hex socket head cap) |  | 36 | 4 | V-wheels, Nut blocks, Z-axis motor mounting
M5-50 bolt (hex socket head cap) |  | 12 | 2 | Motor fastening
M5 nylon lock nut |  | 28 | 8 | V-wheels, Nut blocks, Motor fastening
M5 washer |  | 12 | 2 | V-wheels
M8-16 screw (hex socket head cap) |  | 38 | 4 | X-axis & Y-axis
M8-25 bolt (hex socket head cap) |  | 2 |  | X-axis shoulders & Z-axis mount
M8 hex nut |  | 2 |  | X-axis shoulders & Z-axis mount
M8 washer |  | 3 | 5 | Lead screw spacing
#8 x 1-¼" particle board screw | for mounting to MDF, washer head prevents from splitting the 3D printed feet, the 1-¼" and 1-½" lengths are interchangeable for the foot fronts & the 2" length is for the foot diagonal | 8 | 2
#8 x 1-½" particle board screw
#8 x 2" particle board screw |  | 8 | 2
 | # Unique Primary Mechanics: | 35
 | # Unique Parts: | 60
 | Total: | 305

Sheet: LongMill V4
LongMill V4 Bill of Materials |  | ~1000 sold |  |  | **Please note that some quantities or values may not be exact due to changes or extra hardware included. Also, all documentation is prepared with care but there's no guarantee that all provided quantities or information is exact or correct.**
Last updated: | 2023-02-27
 |  |  |  |  |  | = brand new design from the last version
Part | Notes | Quantity | Packed extras | Location |  | = different design but the last version could accept the new one without much issue
X axis steel gantry | ¼” mild steel, powder coated, wider holes & wheel spacing | 1 |  | X-axis |  | = green hardware bag
Y axis steel gantry | ¼” mild steel, powder coated, removed legacy holes | 2 |  | Y-axis |  | = red hardware bag
Z axis steel gantry | ¼” mild steel, powder coated, reduced width | 1 |  | Z-axis |  | = yellow hardware bag
Z axis motor plate | 10 Ga mild steel, powder coated, notch for paint bump | 1 |  | Z-axis
3x3x990 X-axis rail | on 12x30 and 30x30 models only | 1 |  | X-axis
3x3x500 X-axis rail | on 12x12 model only |  |  | X-axis
3x3x900 reinforcement rail | on 12x30 and 30x30 models only | 1 |  | X-axis
2x2x1000mm Y-axis rail | on 30x30 model only | 2 |  | Y-axis
2x2x500mm Y-axis rail | on 12x12 and 12x30 models only |  |  | Y-axis
Front, left foot | 3D printed, slotted M8 | 1 |  | Y-axis
Front, right foot | 3D printed, slotted M8 | 1 |  | Y-axis
Back, left foot | 3D printed, slotted M8 | 1 |  | Y-axis
Back, right foot | 3D printed, slotted M8 | 1 |  | Y-axis
Middle foot | 3D printed - 1pc on 12x12 and 12x30, 3pcs on 30x30 | 3 |  | Y-axis
Drag chain foot | 3D printed, slotted M8 | 1 |  | Y-axis
Drag chain mount | 3D printed | 1 |  | X-axis
Z-axis motor mount | 3D printed | 1 |  | Z-axis
X-axis shoulder bracket | 3D printed | 2 |  | X-axis
1030mm ACME lead screw | 1pc on the 12x30, 3pcs on the 30x30, T8-8mm 4-start | 3 |  | X & Y-axis
530mm ACME lead screw | 2pcs on the 12x30, 3pcs on the 12x12, T8-8mm 4-start |  |  | X & Y-axis
200mm ACME lead screw | T8-8mm 4-start | 1 |  | Z-axis
Delrin anti-backlash block | with set screw and hex nut for locking | 4 | 1 | X, Y, & Z-axis
ACME locking hex nut | SS304, M3-5mm socket head cap set screw | 4 | 2 | X, Y, & Z-axis
608ZZ flange bearing | deep groove, C5 clearance | 8 |  | X, Y, & Z-axis
1/4" to 8mm coupler | solid type with split, aluminum | 3 |  | X, Y, & Z-axis
20T pulley, 1/4" bore | with set screws | 1 |  | Z-axis
20T pulley, 8mm bore | with set screws | 1 |  | Z-axis
132mm GT2 belt loop |  | 1 |  | Z-axis
Delrin v-wheel |  | 12 |  | X & Y-axis
M5 eccentric nut | custom long bore | 6 | 2 | X & Y-axis
MGN12-200 rail | threaded mounting holes | 2 |  | Z-axis
MGN12 block | long block | 2 |  | Z-axis
35mm motor spacers | aluminum | 12 |  | X & Y-axis
NEMA 23 motor (unthreaded) | for X and Y axis, notched shaft | 3 |  | X & Y-axis
NEMA 23 motor (threaded) | for Z axis, notched shaft | 1 |  | Z-axis
Motor harnesses | 2.5m long, braided nylon sleeve, 20 AWG stranded wire, VAL-U-LOK connectors | 4 |  | X, Y, & Z-axis
Router mount | aluminum, mount diameters of: 52, 65, 71, & 80mm, comes with two M5-20 screws for front clamping | 1 |  | Z-axis
15x20mm channel drag chain | all kits come with 1000mm long lengths, but can be shortened to match the machine | 2 |  | X & Y-axis
24V 10A power supply | fully enclosed | 1 |  | Electronics
AC cable | US/North America Plug | 1 |  | Electronics
USB type B cable | 1m long, shielded & ferrite bead choke | 1 |  | Electronics
E-stop | remote box power control, mountable | 1 |  | Electronics
LongBoard CNC controller | See LongBoard BOM for more details: https://docs.google.com/spreadsheets/d/1qlHlp576s9GIBMPfp4JU8Yr7xBM5gUNruvHFBVFoDOM/edit | 1 |  | Electronics
Main body | 10 Ga mild steel, bent to shape & powder coated | 1 |  | Electronics
Left side wall | 10 Ga mild steel, bent to shape & powder coated | 1 |  | Electronics
Right side wall | 10 Ga mild steel, bent to shape & powder coated | 1 |  | Electronics
Box top | laser cut out of 1/4" acrylic | 1 |  | Electronics
M3-10 screw (hex socket head cap) | SEMS screws (integrated washer and lock washer) | 8 |  | Z-axis rails
M3-12 screw (hex socket head cap) |  | 8 |  | Z-axis rails
M3-18 screw (hex socket head cap) |  | 4 |  | Z-axis rails
M4-8 bolt (hex socket head cap) |  | 8 |  | Control box assembly
M4-16 bolt (hex socket head cap) |  | 11 | 3 | Drag chain mounting & Control box assembly
M4 nylon lock nut |  | 14 | 4 | Drag chain mounting & Control box assembly
M5-12 screw (hex socket head cap) |  | 4 | 2 | Router mount
M5-25 bolt (hex socket head cap) |  | 26 | 9 | V-wheels, Nut blocks, Z-axis motor mounting
M5-50 bolt (hex socket head cap) |  | 12 | 2 | Motor fastening
M5 nylon lock nut |  | 28 | 8 | V-wheels, Nut blocks, Motor fastening
M5 washer |  | 12 | 2 | V-wheels
M8-16 screw (hex socket head cap) |  | 30 | 4 | X-axis & Y-axis
M8-25 bolt (hex socket head cap) |  | 10 | 2 | X-axis shoulders & Z-axis mount
M8 hex nut |  | 10 | 2 | X-axis shoulders & Z-axis mount
M8 washer |  | 3 | 5 | Lead screw spacing
#8 x 1-¼" particle board screw | for mounting to MDF, washer head prevents from splitting the 3D printed feet, the 1-¼" and 1-½" lengths are interchangeable for the foot fronts & the 2" length is for the foot diagonal | 8 | 12
#8 x 1-½" particle board screw
#8 x 2" particle board screw |  | 8 | 2
 | # Unique Parts: | 61
 | Total: | 305

Sheet: LongMill V3
LongMill V3 Bill of Materials |  | ~450 sold |  |  | **Please note that some quantities or values may not be exact due to changes or extra hardware included. Also, all documentation is prepared with care but there's no guarantee that all provided quantities or information is exact or correct.**
Last updated: | 2023-02-27
 |  |  |  |  |  | = brand new design from the last version
Part | Notes | Quantity | Packed extras | Location |  | = different design but the last version could accept the new one without much issue
X axis steel gantry | ¼” mild steel, powder coated, new shoe mounting | 1 |  | X-axis |  | = green hardware bag
Y axis steel gantry | ¼” mild steel, powder coated | 2 |  | Y-axis |  | = red hardware bag
Z axis steel gantry | ¼” mild steel, powder coated | 1 |  | Z-axis |  | = yellow hardware bag
Z axis motor plate | 10 Ga mild steel, powder coated | 1 |  | Z-axis
3x3x990 X-axis rail | on 12x30 and 30x30 models only | 1 |  | X-axis
3x3x500 X-axis rail | on 12x12 model only, made slightly longer |  |  | X-axis
3x3x900 reinforcement rail | on 12x30 and 30x30 models only | 1 |  | X-axis
2x2x1000mm Y-axis rail | on 30x30 model only | 2 |  | Y-axis
2x2x500mm Y-axis rail | on 12x12 and 12x30 models only |  |  | Y-axis
Front, left foot | 3D printed | 1 |  | Y-axis
Front, right foot | 3D printed | 1 |  | Y-axis
Back, left foot | 3D printed | 1 |  | Y-axis
Back, right foot | 3D printed | 1 |  | Y-axis
Middle foot | 3D printed - 1pc on 12x12 and 12x30, 3pcs on 30x30 | 3 |  | Y-axis
Drag chain foot | 3D printed | 1 |  | Y-axis
Drag chain mount | 3D printed | 1 |  | X-axis
Z-axis motor mount | 3D printed | 1 |  | Z-axis
X-axis shoulder bracket | 3D printed | 2 |  | X-axis
1030mm ACME lead screw | 1pc on the 12x30, 3pcs on the 30x30, T8-8mm 4-start | 3 |  | X & Y-axis
530mm ACME lead screw | 2pcs on the 12x30, 3pcs on the 12x12, T8-8mm 4-start |  |  | X & Y-axis
200mm ACME lead screw | T8-8mm 4-start | 1 |  | Z-axis
Delrin anti-backlash block | with set screw and hex nut for locking | 4 | 1 | X, Y, & Z-axis
ACME locking hex nut | SS304, M3-5mm socket head cap set screw, thickened | 4 | 2 | X, Y, & Z-axis
608ZZ flange bearing | deep groove | 8 |  | X, Y, & Z-axis
1/4" to 8mm coupler | jaw type | 3 |  | X, Y, & Z-axis
20T pulley, 1/4" bore | with set screws | 1 |  | Z-axis
20T pulley, 8mm bore | with set screws | 1 |  | Z-axis
132mm GT2 belt loop |  | 1 |  | Z-axis
Delrin v-wheel |  | 12 |  | X & Y-axis
M5 eccentric nut | custom long bore | 6 | 2 | X & Y-axis
MGN12-200 rail | threaded mounting holes | 2 |  | Z-axis
MGN12 block | long block | 2 |  | Z-axis
35mm motor spacers | aluminum | 12 |  | X & Y-axis
NEMA 23 motor (unthreaded) | for X and Y axis, notched shaft | 3 |  | X & Y-axis
NEMA 23 motor (threaded) | for Z axis, notched shaft | 1 |  | Z-axis
Motor harnesses | 2.5m long, braided nylon sleeve, 20 AWG stranded wire, VAL-U-LOK connectors | 4 |  | X, Y, & Z-axis
Router mount | aluminum, mount diameters of: 52, 65, 71, & 80mm, comes with two M5-20 screws for front clamping | 1 |  | Z-axis
15x20mm channel drag chain | all kits come with 1000mm long lengths, but can be shortened to match the machine | 2 |  | X & Y-axis
24V 10A power supply | fully enclosed | 1 |  | Electronics
AC cable | US/North America Plug | 1 |  | Electronics
USB type B cable | 1m long, shielded & ferrite bead choke | 1 |  | Electronics
E-stop | remote box power control, mountable | 1 |  | Electronics
LongBoard CNC controller | See LongBoard BOM for more details: https://docs.google.com/spreadsheets/d/1qlHlp576s9GIBMPfp4JU8Yr7xBM5gUNruvHFBVFoDOM/edit | 1 |  | Electronics
Main body | 10 Ga mild steel, bent to shape & powder coated | 1 |  | Electronics
Left side wall | 10 Ga mild steel, bent to shape & powder coated | 1 |  | Electronics
Right side wall | 10 Ga mild steel, bent to shape & powder coated | 1 |  | Electronics
Box top | laser cut out of 1/4" acrylic | 1 |  | Electronics
M3-10 screw (hex socket head cap) | SEMS screws (integrated washer and lock washer) | 8 |  | Z-axis rails
M3-12 screw (hex socket head cap) |  | 8 |  | Z-axis rails
M3-18 screw (hex socket head cap) |  | 4 |  | Z-axis rails
M4-8 bolt (hex socket head cap) |  | 8 |  | Control box assembly
M4-16 bolt (hex socket head cap) |  | 11 | 3 | Drag chain mounting & Control box assembly
M4 nylon lock nut |  | 14 | 4 | Drag chain mounting & Control box assembly
M5-12 screw (hex socket head cap) |  | 4 | 2 | Router mount
M5-25 bolt (hex socket head cap) |  | 26 | 9 | V-wheels, Nut blocks, Z-axis motor mounting
M5-50 bolt (hex socket head cap) |  | 12 | 2 | Motor fastening
M5 nylon lock nut |  | 28 | 8 | V-wheels, Nut blocks, Motor fastening
M5 washer |  | 12 | 2 | V-wheels
M8-16 screw (hex socket head cap) |  | 30 | 4 | X-axis & Y-axis
M8-25 bolt (hex socket head cap) |  | 10 | 2 | X-axis shoulders & Z-axis mount
M8 hex nut |  | 10 | 2 | X-axis shoulders & Z-axis mount
M8 washer |  | 3 | 5 | Lead screw spacing
#8 x 1-¼" particle board screw | for mounting to MDF, washer head prevents from splitting the 3D printed feet, the 1-¼" and 1-½" lengths are interchangeable for the foot fronts & the 2" length is for the foot diagonal | 8 | 12
#8 x 1-½" particle board screw
#8 x 2" particle board screw |  | 8 | 2
 | # Unique Parts: | 61
 | Total: | 305

Sheet: LongMill V2
LongMill V2 Bill of Materials |  | ~400 sold |  |  | **Please note that some quantities or values may not be exact due to changes or extra hardware included. Also, all documentation is prepared with care but there's no guarantee that all provided quantities or information is exact or correct.**
Last updated: | 2023-02-25
 |  |  |  |  |  | = brand new design from the last version
Part | Notes | Quantity | Packed extras | Location |  | = different design but the last version could accept the new one without much issue
X axis steel gantry | ¼” mild steel, powder coated, wider holes & shoe mount | 1 |  | X-axis |  | = green hardware bag
Y axis steel gantry | ¼” mild steel, powder coated, wider holes & wheel spacing | 2 |  | Y-axis |  | = red hardware bag
Z axis steel gantry | ¼” mild steel, powder coated, notched for more travel | 1 |  | Z-axis |  | = yellow hardware bag
Z axis motor plate | 10 Ga mild steel, powder coated, bent arm | 1 |  | Z-axis
3x3x990 X-axis rail | on 12x30 and 30x30 models only | 1 |  | X-axis
3x3x500 X-axis rail | on 12x12 model only |  |  | X-axis
3x3x900 reinforcement rail | on 12x30 and 30x30 models only | 1 |  | X-axis
2x2x1000mm Y-axis rail | on 30x30 model only | 2 |  | Y-axis
2x2x500mm Y-axis rail | on 12x12 and 12x30 models only |  |  | Y-axis
Front, left foot | 3D printed, printing chamfers, flange bore | 1 |  | Y-axis
Front, right foot | 3D printed, printing chamfers, flange bore | 1 |  | Y-axis
Back, left foot | 3D printed, printing chamfers, flange bore | 1 |  | Y-axis
Back, right foot | 3D printed, printing chamfers, flange bore | 1 |  | Y-axis
Middle foot | 3D printed - 1pc on 12x12 and 12x30, 3pcs on 30x30 | 3 |  | Y-axis
Drag chain foot | 3D printed, printing chamfers | 1 |  | Y-axis
Drag chain mount | 3D printed | 1 |  | X-axis
Z-axis motor mount | 3D printed, remove arm | 1 |  | Z-axis
X-axis shoulder bracket | 3D printed, thicker walls | 2 |  | X-axis
1030mm ACME lead screw | 1pc on the 12x30, 3pcs on the 30x30, T8-8mm 4-start | 3 |  | X & Y-axis
530mm ACME lead screw | 2pcs on the 12x30, 3pcs on the 12x12, T8-8mm 4-start |  |  | X & Y-axis
200mm ACME lead screw | T8-8mm 4-start | 1 |  | Z-axis
Delrin anti-backlash block | with set screw and hex nut for locking | 4 | 1 | X, Y, & Z-axis
ACME locking hex nut | SS304, uses M3-5mm hex socket head cap set screw | 4 | 2 | X, Y, & Z-axis
608ZZ flange bearing | deep groove | 8 |  | X, Y, & Z-axis
1/4" to 8mm coupler | jaw type | 3 |  | X, Y, & Z-axis
20T pulley, 1/4" bore | with set screws | 1 |  | Z-axis
20T pulley, 8mm bore | with set screws | 1 |  | Z-axis
132mm GT2 belt loop |  | 1 |  | Z-axis
Delrin v-wheel |  | 12 |  | X & Y-axis
M5 eccentric nut | custom long bore | 6 | 2 | X & Y-axis
MGN12-200 rail | threaded mounting holes | 2 |  | Z-axis
MGN12 block | long block | 2 |  | Z-axis
35mm motor spacers | aluminum | 12 |  | X & Y-axis
NEMA 23 motor (unthreaded) | for X and Y axis, notched shaft | 3 |  | X & Y-axis
NEMA 23 motor (threaded) | for Z axis, notched shaft | 1 |  | Z-axis
Motor harnesses | 2.5m long, braided nylon sleeve, 22AWG stranded wire, XHP-11 connectors | 4 |  | X, Y, & Z-axis
Router mount | aluminum, mount diameters of: 52, 65, 71, & 80mm, comes with two M5-20 screws for front clamping | 1 |  | Z-axis
15x20mm channel drag chain | all kits come with 1000mm long lengths, but can be shortened to match the machine | 2 |  | X & Y-axis
24V 10A power supply | fully enclosed | 1 |  | Electronics
AC cable | US/North America Plug | 1 |  | Electronics
USB type B cable | 1m long, shielded & ferrite bead choke | 1 |  | Electronics
LongBoard CNC controller | See LongBoard BOM for more details: https://docs.google.com/spreadsheets/d/1qlHlp576s9GIBMPfp4JU8Yr7xBM5gUNruvHFBVFoDOM/edit | 1 |  | Electronics
Main body | 10 Ga mild steel, powder coated & bent to shape | 1 |  | Electronics
Left side wall | 10 Ga mild steel, powder coated & bent to shape | 1 |  | Electronics
Right side wall | 10 Ga mild steel, powder coated & bent to shape | 1 |  | Electronics
Box top | laser cut out of 1/4" acrylic | 1 |  | Electronics
M3-10 screw (hex socket head cap) |  | 8 |  | Z-axis rails
M3-12 screw (hex socket head cap) |  | 8 |  | Z-axis rails
M3-18 screw (hex socket head cap) |  | 4 |  | Z-axis rails
M3 washer |  | 20 |  | Z-axis rails
M4-8 bolt (hex socket head cap) |  | 8 |  | Control box assembly
M4-16 bolt (hex socket head cap) |  | 7 | 3 | Drag chain mounting
M4-20 bolt (hex socket head cap) |  | 4 |  | Control box assembly
M4 nylon lock nut |  | 14 | 4 | Drag chain mounting & Control box assembly
M4 spacer | nylon, 5mm thick | 4 |  | Control box assembly
M5-12 screw (hex socket head cap) |  | 4 | 2 | Router mount
M5-25 bolt (hex socket head cap) |  | 26 | 4 | V-wheels, Nut blocks, Z-axis motor mounting
M5-50 bolt (hex socket head cap) |  | 12 | 2 | Motor fastening
M5 nylon lock nut |  | 28 | 8 | V-wheels, Nut blocks, Motor fastening
M5 washer |  | 12 | 2 | V-wheels
M8-16 screw (hex socket head cap) |  | 30 | 4 | X-axis & Y-axis
M8-25 bolt (hex socket head cap) |  | 10 | 2 | X-axis shoulders & Z-axis mount
M8 hex nut |  | 10 | 2 | X-axis shoulders & Z-axis mount
M8 washer |  | 3 | 5 | Lead screw spacing
#8 x 1-¼" particle board screw | for mounting to MDF, washer head prevents from splitting the 3D printed feet, the 1-¼" and 1-½" lengths are interchangeable for the foot fronts & the 2" length is for the foot diagonal | 8 | 12
#8 x 1-½" particle board screw
#8 x 2" particle board screw |  | 8 | 2
 | # Unique Parts: | 63
 | Total: | 328

Sheet: LongMill V1
LongMill V1 Bill of Materials |  | ~400 sold |  |  | **Please note that some quantities or values may not be exact due to changes or extra hardware included. Also, all documentation is prepared with care but there's no guarantee that all provided quantities or information is exact or correct.**
Last updated: | 2023-02-25
Part | Notes | Quantity | Packed extras | Location
X axis steel gantry | ¼” mild steel, powder coated | 1 |  | X-axis
Y axis steel gantry | ¼” mild steel, powder coated | 2 |  | Y-axis
Z axis steel gantry | ¼” mild steel, powder coated | 1 |  | Z-axis
Z axis motor plate | 10 Ga mild steel, powder coated | 1 |  | Z-axis
3x3x990 X-axis rail | on 12x30 and 30x30 models only | 1 |  | X-axis
3x3x500 X-axis rail | on 12x12 model only |  |  | X-axis
3x3x900 reinforcement rail | on 12x30 and 30x30 models only | 1 |  | X-axis
2x2x1000mm Y-axis rail | on 30x30 model only | 2 |  | Y-axis
2x2x500mm Y-axis rail | on 12x12 and 12x30 models only |  |  | Y-axis
Front, left foot | 3D printed | 1 |  | Y-axis
Front, right foot | 3D printed | 1 |  | Y-axis
Back, left foot | 3D printed | 1 |  | Y-axis
Back, right foot | 3D printed | 1 |  | Y-axis
Middle foot | 3D printed - 1pc on 12x12 and 12x30, 3pcs on 30x30 | 3 |  | Y-axis
Drag chain foot | 3D printed | 1 |  | Y-axis
Drag chain mount | 3D printed | 1 |  | X-axis
Z-axis motor mount | 3D printed | 1 |  | Z-axis
X-axis shoulder bracket | 3D printed | 2 |  | X-axis
1030mm ACME lead screw | 1pc on the 12x30, 3pcs on the 30x30, T8-8mm 4-start | 3 |  | X & Y-axis
530mm ACME lead screw | 2pcs on the 12x30, 3pcs on the 12x12, T8-8mm 4-start |  |  | X & Y-axis
200mm ACME lead screw | T8-8mm 4-start | 1 |  | Z-axis
Delrin anti-backlash block | with set screw and hex nut for locking | 4 |  | X, Y, & Z-axis
ACME locking hex nut | SS304, uses M3-5mm hex socket head cap set screw | 4 |  | X, Y, & Z-axis
608ZZ flange bearing | deep groove | 8 |  | X, Y, & Z-axis
1/4" to 8mm coupler | solid type with split, aluminum | 3 |  | X, Y, & Z-axis
20T pulley, 1/4" bore | with set screws | 1 |  | Z-axis
20T pulley, 8mm bore | with set screws | 1 |  | Z-axis
132mm GT2 belt loop |  | 1 |  | Z-axis
Delrin v-wheel |  | 12 |  | X & Y-axis
M5 eccentric nut | custom long bore | 6 |  | X & Y-axis
MGN12-200 rail | through mounting holes | 2 |  | Z-axis
MGN12 block | long block | 2 |  | Z-axis
35mm motor spacers | aluminum | 12 |  | X & Y-axis
NEMA 23 motor (unthreaded) | for X and Y axis, notched shaft | 3 |  | X & Y-axis
NEMA 23 motor (threaded) | for Z axis, notched shaft | 1 |  | Z-axis
Motor harnesses | 2m long, braided nylon sleeve, 22AWG stranded wire, XHP-11 connectors | 4 |  | X, Y, & Z-axis
Router mount | aluminum, mount diameters of: 52, 65, 71, & 80mm, comes with two M5-20 screws for front clamping | 1 |  | Z-axis
15x20mm channel drag chain | all kits come with 1000mm long lengths, but can be shortened to match the machine | 2 |  | X & Y-axis
24V 10A power supply | fully enclosed | 1 |  | Electronics
AC cable | US/North America Plug | 1 |  | Electronics
USB type B cable | 1m long, shielded & ferrite bead choke | 1 |  | Electronics
LongBoard CNC controller | See LongBoard BOM for more details: https://docs.google.com/spreadsheets/d/1qlHlp576s9GIBMPfp4JU8Yr7xBM5gUNruvHFBVFoDOM/edit#gid=0 | 1 |  | Electronics
Box top | laser cut out of 1/4" acrylic | 1 |  | Electronics
Left side wall | laser cut out of 1/4" acrylic | 1 |  | Electronics
Right side wall | laser cut out of 1/4" acrylic | 1 |  | Electronics
Front wall | 16 Ga stainless steel | 1 |  | Electronics
Back wall | 16 Ga stainless steel | 1 |  | Electronics
Bottom plate | 16 Ga stainless steel | 1 |  | Electronics
Top front bracket | 3D printed | 1 |  | Electronics
Top Rear bracket | 3D printed | 1 |  | Electronics
Bottom front bracket | 3D printed | 1 |  | Electronics
Bottom rear bracket | 3D printed | 1 |  | Electronics
Long spacer | 3D printed | 1 |  | Electronics
M4 spacer | 3D printed, 5mm thick | 2 |  | Electronics
M3-10 screw (hex socket head cap) |  | 8 |  | Z-axis rails
M3-16 screw (hex socket head cap) |  | 8 |  | Z-axis rails
M3-18 screw (hex socket head cap) |  | 4 |  | Z-axis rails
M3 washer |  | 12 |  | Z-axis rails
M3 nylon lock nut |  | 12 |  | Z-axis rails
M4-8 bolt (hex socket head cap) |  | 4 |  | Control box assembly
M4-12 bolt (hex socket head cap) |  | 8 |  | Control box assembly
M4-16 bolt (hex socket head cap) |  | 7 |  | Drag chain mounting
M4-20 bolt (hex socket head cap) |  | 4 |  | Control box assembly
M4 hex nut |  | 16 |  | Control box assembly
M4 nylon lock nut |  | 6 |  | Drag chain mounting
M5-12 screw (hex socket head cap) |  | 4 |  | Router mount
M5-25 bolt (hex socket head cap) |  | 26 | 4 | V-wheels, Nut blocks, Z-axis motor mounting
M5-50 bolt (hex socket head cap) |  | 12 |  | Motor fastening
M5 nylon lock nut |  | 28 | 2 | V-wheels, Nut blocks, Motor fastening
M5 washer |  | 12 |  | V-wheels
M8-16 screw (hex socket head cap) |  | 30 | 2 | X-axis & Y-axis
M8-25 bolt (hex socket head cap) |  | 10 |  | X-axis shoulders & Z-axis mount
M8 hex nut |  | 10 | 2 | X-axis shoulders & Z-axis mount
M8 washer |  | 3 | 1 | Lead screw spacing
#8 x 1-¼" particle board screw | for mounting to MDF, washer head prevents from splitting the 3D printed feet, the 1-¼" and 1-½" lengths are interchangeable for the foot fronts & the 2" length is for the foot diagonal | 8 | 12
#8 x 1-½" particle board screw
#8 x 2" particle board screw |  | 8 | 2
 | # Unique Parts: | 73
 | Total: | 349

Sheet: Mill One V3
 | https://sienci.com/2018/07/17/sienci-mill-one-v3-updates/
Mill One V3 Bill of Materials |  | ~100 sold |  | **Please note that some quantities or values may not be exact due to changes or extra hardware included. Also, all documentation is prepared with care but there's no guarantee that all provided quantities or information is exact or correct.**
Last updated: | 2023-03-06
 |  |  |  |  | = brand new design from the last version
Part | Notes | Quantity | Location |  | = different design but the last version could accept the new one without much issue
XZ-gantry | ¼” mild steel, powder coated, notched to allow more X-axis movement | 1 | X & Z-axis
Y-gantry | ¼” mild steel, powder coated and tapped | 1 | Y-axis
Wasteboard | ½” routed MDF | 1 | Y-axis
2x2x400mm rail | aluminum, used for X and Y axes | 2 | X & Y-axis
2x2x200mm rail | aluminum, used for Z axis, added 2nd router mount hole | 1 | Z-axis
ACME nut holder | 3D printed, strengthened from V2 | 3 | X, Y, & Z-axis
Angle mount | 3D printed | 5 | X, Y, & Z-axis
Router mount | 3D printed, strengthened from V2 and 2-hole fastening | 1 | Z-axis
Router mount adapter | 3D printed, adapter to Ridgid trim router, longer | 1 | Z-axis
Frame bracket | 10 Ga mild steel, powder coated and tapped | 8 | Enclosure
Frame - left | ½” routed MDF | 1 | Enclosure
Frame - right |  | 1 | Enclosure
Frame - back |  | 1 | Enclosure
Frame - front |  | 1 | Enclosure
Acrylic window | ⅛' laser cut acrylic, engraved "Sienci Labs" | 1 | Enclosure
400mm ACME lead screw | T8-8mm 4-start, used for X and Y axes | 2 | X & Y-axis
150mm ACME lead screw | T8-8mm 4-start, used for Z axis | 1 | Z-axis
ACME nut | T8-8mm 4-start, brass | 3 | X, Y, & Z-axis
5mm to 8mm coupler | solid type with split, aluminum | 3 | X, Y, & Z-axis
Delrin v-wheel |  | 12 | X, Y, & Z-axis
M5 eccentric nut | steel, custom long bore | 6 | X, Y, & Z-axis
NEMA 17 motor (threaded) | drives all CNC axes | 3 | X, Y, & Z-axis
Motor harnesses | 950mm long, 4-wire, 24 AWG stranded wire, JST PH2.0 6-Pin & JST RE 4-pin connectors | 3 | X, Y, & Z-axis
Electronics housing | 3D printed with wire routing and clip for power jack | 1 | Electronics
Electronics cover | 3D printed, snaps onto electronics holder for dust shielding | 1 | Electronics
Arduino Uno | an open-source microcontroller board based on the Microchip ATmega328P microcontroller and developed by Arduino.cc used to perform all the processing necessary to convert g-code into stepper motor movements and other CNC functionality when running GRBL firmware (https://github.com/gnea/grbl). | 1 | Electronics
CNC shield | an open-source, compact, and modular design by Protoneer which routes the Uno's IO into pinouts for motor drivers, limit switches, and more (https://blog.protoneer.co.nz/arduino-cnc-shield/) | 1 | Electronics
Stepper motor driver | common Allegro A4988 bipolar microstepping motor driver with adjustable current limiting, over-current and over-temperature protection, rated for 8-35V and 1-2A per phase depending on cooling | 3 | Electronics
Driver heatsink | aluminum with backing adhesive | 3 | Electronics
Header jumper | 2 pin "shunts" set the microstepping on the CNC shield | 6 | Electronics
DC power jack | 5.5 x 2.1mm female barrel power jack, threaded housing | 1 | Electronics
24V 5A power supply | enclosed with indicator light, 100-240V at 50-60hz | 1 | Electronics
AC cable | typically a US/North America 2-prong plug | 1 | Electronics
USB type B cable | 1m long, shielded & ferrite bead choke | 1 | Electronics
M3-8 screw (hex socket head cap) |  | 12 | Motor mounting
M3-12 screw (hex socket head cap) |  | 12 | ACME nuts
M3 hex nut |  | 12 | ACME nuts
M5-25 bolt (hex socket head cap) |  | 16 | ACME nut mounting, V-wheels
M5 hex nut |  | 10 | ACME nut mounting, V-wheels
M5 washer |  | 12 | V-wheels
M8-15 screw (hex socket head cap) |  | 30 | Angle & Router mounts, Frame mounting
M8-25 bolt (hex socket head cap) |  | 10 | Router mount & Frame mounting
M8 hex nut |  | 10 | Router mount & Frame mounting
 | # Unique Parts: | 43
 | Total: | 206

Sheet: Mill One V2
Mill One V2 Bill of Materials |  | ~200 sold |  | **Please note that some quantities or values may not be exact due to changes or extra hardware included. Also, all documentation is prepared with care but there's no guarantee that all provided quantities or information is exact or correct.**
Last updated: | 2023-03-06
 |  |  |  |  | = brand new design from the last version
Part | Notes | Quantity | Location |  | = different design but the last version could accept the new one without much issue
XZ-gantry | ¼” mild steel, powder coated | 1 | X & Z-axis
Y-gantry | ½” black HDPE, machined | 1 | Y-axis
2x2x400mm rail | aluminum, used for X and Y axes | 2 | X & Y-axis
2x2x200mm rail | aluminum, used for Z axis | 1 | Z-axis
ACME nut holder | 3D printed, strengthened from V1 | 3 | X, Y, & Z-axis
Angle mount | 3D printed, strengthened from V1 | 5 | X, Y, & Z-axis
Router mount | 3D printed, strengthened from V1, notched to allow Ridgid trim router to orient at 45 degrees | 1 | Z-axis
Router mount adapter | 3D printed, adapter to smaller diameter of Ridgid trim router | 1 | Z-axis
Frame bracket | 10 Ga mild steel, powder coated and tapped | 8 | Enclosure
Frame - left | ½” routed MDF, added top holes for more frame rigidity | 1 | Enclosure
Frame - right |  | 1 | Enclosure
Frame - back |  | 1 | Enclosure
Frame - front |  | 1 | Enclosure
Acrylic window | ⅛' laser cut acrylic, engraved "Sienci Labs" | 1 | Enclosure
400mm ACME lead screw | T8-8mm 4-start, used for X and Y axes | 2 | X & Y-axis
200mm ACME lead screw | T8-8mm 4-start, used for Z axis | 1 | Z-axis
ACME nut | T8-8mm 4-start, brass, threaded mounting holes | 3 | X, Y, & Z-axis
5mm to 8mm coupler | solid type, aluminum | 3 | X, Y, & Z-axis
Delrin v-wheel |  | 12 | X, Y, & Z-axis
M5 eccentric nut | steel, custom long bore | 6 | X, Y, & Z-axis
NEMA 17 motor (threaded) | drives all CNC axes | 3 | X, Y, & Z-axis
Motor harnesses | 950mm long, 4-wire, 24 AWG stranded wire, JST PH2.0 6-Pin & JST RE 4-pin connectors | 3 | X, Y, & Z-axis
Electronics housing | 3D printed with wire routing and threaded jack | 1 | Electronics
Electronics cover | 3D printed, snaps onto electronics holder for dust shielding | 1 | Electronics
Arduino Uno | an open-source microcontroller board based on the Microchip ATmega328P microcontroller and developed by Arduino.cc used to perform all the processing necessary to convert g-code into stepper motor movements and other CNC functionality when running GRBL firmware (https://github.com/gnea/grbl). | 1 | Electronics
CNC shield | an open-source, compact, and modular design by Protoneer which routes the Uno's IO into pinouts for motor drivers, limit switches, and more (https://blog.protoneer.co.nz/arduino-cnc-shield/) | 1 | Electronics
Stepper motor driver | common Allegro A4988 bipolar microstepping motor driver with adjustable current limiting, over-current and over-temperature protection, rated for 8-35V and 1-2A per phase depending on cooling | 3 | Electronics
Driver heatsink | aluminum with backing adhesive | 3 | Electronics
Header jumper | 2 pin "shunts" set the microstepping on the CNC shield | 6 | Electronics
DC power jack | 5.5 x 2.1mm female barrel power jack, threaded housing | 1 | Electronics
24V 5A power supply | enclosed with indicator light, 100-240V at 50-60hz | 1 | Electronics
AC cable | typically a US/North America 2-prong plug | 1 | Electronics
USB type B cable | 1m long, shielded & ferrite bead choke | 1 | Electronics
M3-8 screw (hex socket head cap) |  | 24 | ACME nut & Motor mounting
M5-25 bolt (hex socket head cap) |  | 16 | ACME nut mounting, V-wheels
M5 hex nut |  | 10 | ACME nut mounting, V-wheels
M5 washer |  | 12 | V-wheels
M8-15 screw (hex socket head cap) |  | 28 | Angle & Router mounts, Frame mounting
M8-25 bolt (hex socket head cap) |  | 10 | Router mount & Frame mounting
M8 hex nut |  | 10 | Router mount & Frame mounting
 | # Unique Parts: | 40
 | Total: | 191

Sheet: Mill One V1
Mill One V1 Bill of Materials |  | ~100 sold |  | **Please note that some quantities or values may not be exact due to changes or extra hardware included. Also, all documentation is prepared with care but there's no guarantee that all provided quantities or information is exact or correct.**
Last updated: | 2023-02-25
Part | Notes | Quantity | Location
XZ-gantry | ¼” mild steel, powder coated | 1 | X & Z-axis
Y-gantry | ½” black HDPE, machined | 1 | Y-axis
2x2x400mm rail | aluminum, used for X and Y axes | 2 | X & Y-axis
2x2x200mm rail | aluminum, used for Z axis | 1 | Z-axis
ACME nut holder | 3D printed | 3 | X, Y, & Z-axis
Angle mount | 3D printed | 5 | X, Y, & Z-axis
Router mount | 3D printed | 1 | Z-axis
Frame bracket | 3D printed | 4 | Enclosure
Frame - left | ½” routed MDF | 1 | Enclosure
Frame - right |  | 1 | Enclosure
Frame - back |  | 1 | Enclosure
Frame - front |  | 1 | Enclosure
Acrylic window | ⅛' laser cut acrylic | 1 | Enclosure
400mm ACME lead screw | T8-8mm 4-start, used for X and Y axes | 2 | X & Y-axis
200mm ACME lead screw | T8-8mm 4-start, used for Z axis | 1 | Z-axis
ACME nut | T8-8mm 4-start, brass | 3 | X, Y, & Z-axis
5mm to 8mm coupler | solid type, aluminum | 3 | X, Y, & Z-axis
Delrin v-wheel |  | 12 | X, Y, & Z-axis
M5 eccentric nut | steel, custom long bore | 6 | X, Y, & Z-axis
NEMA 17 motor (threaded) | drives all CNC axes | 3 | X, Y, & Z-axis
Motor harnesses | 950mm long, 4-wire, 24 AWG stranded wire, JST PH2.0 6-Pin & JST RE 4-pin connectors | 3 | X, Y, & Z-axis
Electronics housing | 3D printed with wire routing and optional fan mount | 1 | Electronics
Arduino Uno | an open-source microcontroller board based on the Microchip ATmega328P microcontroller and developed by Arduino.cc used to perform all the processing necessary to convert g-code into stepper motor movements and other CNC functionality when running GRBL firmware (https://github.com/gnea/grbl). | 1 | Electronics
CNC shield | an open-source, compact, and modular design by Protoneer which routes the Uno's IO into pinouts for motor drivers, limit switches, and more (https://blog.protoneer.co.nz/arduino-cnc-shield/) | 1 | Electronics
Stepper motor driver | common Allegro A4988 bipolar microstepping motor driver with adjustable current limiting, over-current and over-temperature protection, rated for 8-35V and 1-2A per phase depending on cooling | 3 | Electronics
Driver heatsink | aluminum with backing adhesive | 3 | Electronics
Header jumper | 2 pin "shunts" set the microstepping on the CNC shield | 6 | Electronics
DC power jack | 5.5 x 2.1mm female barrel power jack to 2 pin terminal | 1 | Electronics
Power wires | 22 AWG red and black, carries 24V to CNC shield | 2 | Electronics
Jack holding clip | 3D printed, only needed if the DC jack fit isn't snug | 1 | Electronics
24V 5A power supply | enclosed with indicator light, 100-240V at 50-60hz | 1 | Electronics
AC cable | typically a US/North America 2-prong plug | 1 | Electronics
USB type B cable | 1m long, shielded & ferrite bead choke | 1 | Electronics
M3-8 screw (hex socket head cap) |  | 12 | Motor mounting
M3-15 screw (hex socket head cap) |  | 6 | ACME nuts
M3 hex nut |  | 6 | ACME nuts
M5-25 bolt (hex socket head cap) |  | 16 | ACME nut mounting, V-wheels
M5 hex nut |  | 10 | ACME nut mounting, V-wheels
M5 washer |  | 12 | V-wheels
M8-15 screw (hex socket head cap) |  | 12 | Angle & Router mounts
M8-25 bolt (hex socket head cap) |  | 26 | Frame mounting and Router mount
M8 hex nut |  | 26 | Frame mounting and Router mount
 | # Unique Parts: | 42
 | Total: | 204
