Sienci-Labs/Resources/_downloads/_longmill/_hardware-files/Open Source LongBoard BOMs (Sienci Labs).xlsx

Sheet: Rev 1.4.21.4.3
Bill of Materials for LongBoard (Rev 1.4.2/1.4.3) |  |  | We made the LongBoard design open-source so you could reproduce it via PCB milling, etching, or an online service. We also strive to use components that are easy to source; we use LCSC but other options include Digikey, Arrow, and likely other manufacturers local to you.
Last updated: | 2021-07-20 |  | You can find additional documentation regarding the LongBoard here: https://resources.sienci.com/view/lm-longboard-documentation/
 |  |  |  |  | https://resources.sienci.com/view/lm-open-source-and-modifications/
 |  |  | **Please note that all documentation is prepared with care but there's no guarantee that all provided quantities or information is exact or correct.**
Part | Notes | Quantity | Location / Designation | Manufacturer Part # or SKU | Example link for purchase
LongBoard Rev 1.4.2/1.4.3 PCB | 600/1000 produced, 2.4mm thick, 107.7x269.28mm, FR4 TG130, black, HASL finish. Mounting holes make nearly centered rectangle of 96.03x258.15mm | 1 | Board |  | Must be manually reproduced via the provided PCB schematics
PCB SMD Nut (M4, 5mm standoff) | Increase ease of assembly of board into enclosure by mounting via PCB nuts rather than traditional, separated nuts | 4 | M1, M2, M3, M4 | SMTSO-40-50-M-T-J | https://www.alibaba.com/product-detail/PCB-Standoff-Manufacturer-s-direct-supply_60795106729.html
Terminal Block connector (2-pin 1-level, 5.08mm) | Plug that carries DC power to the board | 1 | P15 | WJ2EDGRC-5.08-2P | https://lcsc.com/product-detail/Pluggable-System-Terminal-Block_Ningbo-Kangnex-Elec-WJ2EDGRC-5-08-2P_C3697.html
Terminal Block connector (2-pin 1-level, 5.08mm, straight) | Plug that routes positive DC power through the e-stop switch before connecting it to the rest of the board | 1 | SW4 | WJ2EDGV-5.08-2P | https://lcsc.com/product-detail/Pluggable-System-Terminal-Block_Ningbo-Kangnex-Elec-WJ2EDGV-5-08-2P_C8461.html
Diode (SMD, schottky barrier) | Part of input power management | 1 | D1 | SVM1550UB_R2_00001 | https://lcsc.com/product-detail/Schottky-Barrier-Diodes-SBD_SVM1550UB_C138358.html
LED (SMD, orange/617~626nm) | Top-facing LED acts as indicator that board is receiving power | 1 | D9 | 2SA0603V32F0SW001 | https://lcsc.com/product-detail/Light-Emitting-Diodes-LED_Brightek-Optoelectronics-2SA0603V32F0SW001_C233190.html
Capacitor (SMD, 1uF) | Work together to suppress arcing on the 24V board power input when the e-stop is used to toggle power on and off | 1 | C10 | 1206B105K101NT | https://lcsc.com/product-detail/Multilayer-Ceramic-Capacitors-MLCC-SMD-SMT_FH-Guangdong-Fenghua-Advanced-Tech-1206B105K101NT_C91151.html
Resistor (SMD, 162Ω) |  | 1 | R11 | CR1210F162RP05Z | https://lcsc.com/product-detail/Chip-Resistor-Surface-Mount_Ever-Ohms-Tech-CR1210F162RP05_C174452.html
Transient Voltage Suppressor (bi-directional) |  | 1 | D11 | SMBJ58CA | https://lcsc.com/product-detail/Others_SEMIWARE-SMBJ58CA_C294920.html
Voltage Regulator (linear) | Part of the voltage regulation circuitry. Designed to receive 24V as input and supply 12V as output to a maximum of ~1A via the fan plug. | 1 | U1 | LM317TG | https://lcsc.com/product-detail/Voltage-References_ON-Semicon_LM317TG_ON-Semicon-ON-LM317TG_C89320.html
Capacitor (SMD, 100nF) | Part of the voltage regulation circuitry. Also for noise filtering on the Play/Pause/Stop buttons, limits switches, and probe lines. R10 manages current for inline LED. | 9 | C1, C2, C3, C4, C5, C6, C7, C8, C9 | 0603F104M500NT | https://lcsc.com/product-detail/Multilayer-Ceramic-Capacitors-MLCC-SMD-SMT_100nF-104-20-50V_C42998.html
Resistor (SMD, 10kΩ) |  | 8 | R1, R3, R4, R5, R6, R7, R8, R9 | RC0603FR-0710KL | https://lcsc.com/product-detail/Chip-Resistor-Surface-Mount_YAGEO-RC0603FR-0710KL_C98220.html
Resistor (SMD, 1.15kΩ) |  | 2 | R2, R10 | 0603WAF1151T5E | https://lcsc.com/product-detail/Chip-Resistor-Surface-Mount_Uniroyal-Elec-0603WAF1151T5E_C22834.html
Diode (SMD, general purpose) | Run inline for all board 5V IO (limits, SpinPWM, SpinDir, Probe, and Coolant) to protect against incorrect wiring | 9 | D2, D3, D4, D5, D6, D7, D8, D10, D12 | GS1002FL_R1_00001 | https://lcsc.com/product-detail/Others_PANJIT-International-GS1002FL_C353853.html
Tactile Switch (SPST) | Top-mounted Play/Pause/Stop buttons for manual machine control. Common tactile switch with extended switch height. | 3 | SW1, SW2, SW3 | TC-1103-C-U | https://lcsc.com/product-detail/Tactile-Switches_XKB-Enterprise-TC-1103-C-U_C318968.html
Pin Header (1*10, 2.54mm, male) | For connection to Arduino Uno board | 1 | A1 | C57369 | https://lcsc.com/product-detail/Pin-Header-Female-Header_Boom-Precision-Elec-Headers-Pins-2-54mm-1-10P_C57369.html
Pin Header (1*8, 2.54mm, male) |  | 2 | A1 | Z-211-0811-0021-001 | https://lcsc.com/product-detail/Pin-Header-Female-Header_Nextronics-Engineering-Z-211-0811-0021-001_C190820.html
Pin Header (1*6, 2.54mm, male) |  | 1 | A1 | A2541WV-6P | https://lcsc.com/product-detail/Pin-Header-Female-Header_Changjiang-Connectors-A2541WV-6P_C225481.html
XH connector (4-pin 1-level, 2.5mm) | Connect to the limit sensing circuitry for homing or hardstops. The XH connector is very common so it makes for easy connection of a variety of plug-in limit sensors. | 3 | P12, P13, P14 | S4B-XH-A-1(LF)(SN) | https://lcsc.com/product-detail/Wire-To-Board-Wire-To-Wire-Connector_JST-Sales-America_S4B-XH-A-1-LF-SN_JST-Sales-America-S4B-XH-A-1-LF-SN_C163037.html
Terminal Block connector (5-pin 1-level, 3.81mm) | Alternative connection point for limit sensing sensors | 1 | P2 | WJ15EDGRC-3.81-5P | https://lcsc.com/product-detail/Pluggable-System-Terminal-Block_Ningbo-Kangnex-Elec-WJ15EDGRC-3-81-5P_C8395.html
Terminal Block connector (4-pin 1-level, 5.08mm) | For connection to Stepper Motors | 4 | P4, P5, P6, P7 | WJ2EDGRC-5.08-4P | https://lcsc.com/product-detail/Pluggable-System-Terminal-Block_Ningbo-Kangnex-Elec-WJ2EDGRC-5-08-4P_C8446.html
Terminal Block connector (2-pin 1-level, 3.81mm) | Connector used for all other IO on the board, including 12V fan line, spindle control, coolant control, and probe input | 5 | P1, P3, P16, P17, P18 | WJ15EDGRC-3.81-2P | https://lcsc.com/product-detail/Pluggable-System-Terminal-Block_Ningbo-Kangnex-Elec-WJ15EDGRC-3-81-2P_C8387.html
TB6600 Stepper Driver Board | Built around the TB6600HG PWM Chopper-Type bipolar Stepping Motor Driver IC from Toshiba, these board modules are ubiquitous, open-source, and provide an effective means for stepper motor control at a hobby-level. There is one driver allocated per motor: one for X, two for Y, and one for Z. The datasheet for the driver chip can be found here: https://toshiba.semicon-storage.com/us/semiconductor/product/motor-driver-ics/stepping-motor-driver-ics/detail.TB6600HG.html | 4 | Driver |  | https://www.amazon.ca/KOOBOOK-TB6600HG-Stepper-Controller-Replace/dp/B07S9QBCBS/
Arduino Uno | An open-source microcontroller board based on the Microchip ATmega328P microcontroller and developed by Arduino.cc This board performs all of the processing necessary to convert incoming gcode into stepper motor movements with other CNC functionality built-in when flashed with the GRBL firmware (https://github.com/gnea/grbl). | 1 | Uno |  | https://store.arduino.cc/usa/arduino-uno-rev3
Terminal Block plug (5-pin 1-level, 3.81mm) | Plugs into the alternative connector for limit sensing sensors. Normally found already plugged into the LongBoard. | 1 | Plugs | WJ15EDGK-3.81-5P | https://lcsc.com/product-detail/Pluggable-System-Terminal-Block_Ningbo-Kangnex-Elec-WJ15EDGK-3-81-5P_C3804.html
Terminal Block plug (2-pin 1-level, 3.81mm) | Plugs into all remaining LongBoard IO. Normally found already plugged into the LongBoard's matching ports. | 5 | Plugs | WJ15EDGK-3.81-2P | https://lcsc.com/product-detail/Pluggable-System-Terminal-Block_Ningbo-Kangnex-Elec-WJ15EDGK-3-81-2P_C8466.html
LongBoard External Supporting Components
Terminal Block plug (4-pin 1-level, 5.08mm) | Plugs for the four stepper motors. Already come pre-wired onto the wiring harnesses for the LongMill (one for each motor). | 4 | Plugs | WJ2EDGK-5.08-4P | https://lcsc.com/product-detail/Pluggable-System-Terminal-Block_Ningbo-Kangnex-Elec-WJ2EDGK-5-08-4P-14-00A_C71372.html
Terminal Block plug (2-pin 1-level, 5.08mm) | Plugs into the DC power connector and e-stop connector on the Longboard and normally comes pre-wired onto the DC side of the LongMill power supply and on the end of the e-stop wiring harness | 2 | Plugs | WJ2EDGK-5.08-2P | https://lcsc.com/product-detail/Pluggable-System-Terminal-Block_Ningbo-Kangnex-Elec-WJ2EDGK-5-08-2P-14-00A_C71370.html
24V 10A power supply | Fully enclosed power brick with LED indicator light. Accepts 110-240V and 50-60hz. | 1 | Power Brick |  | https://www.amazon.ca/LED-Power-Supply-Adapter-24V/dp/B07K9KTMFT
AC cable | We provide this as a US / North American plug | 1 | Power Brick |  | https://www.amazon.ca/LIANSUM-Samsung-Toshiba-ViewSonic-Computer/dp/B08V8QRNQ9/
E-stop switch & box | Plugs into the top-facing plug on the LongBoard to act as its power switch and also to terminate all power to the CNC in case of an emergency. Has holes for mounting to a variety of surfaces. | 1 | E-stop |  | https://www.amazon.ca/Baomain-Emergency-Button-Weatherproof-Pushbutton/dp/B00NTT91Y0/
USB type B cable | 1m long, shielded & ferrite bead choke cable for communication from a separate computing device to the on-board Arduino | 1 | USB Cable |  | https://www.amazon.ca/Hi-Speed-Cable-Ferrite-Chokes-3-Ft/dp/B008VOPCGY
 | # Unique Parts: | 32
 | Total: | 82

Sheet: Rev 1.3
Bill of Materials for LongBoard (Rev 1.3) |  |  | We made the LongBoard design open-source so you could reproduce it via PCB milling, etching, or an online service. We also strive to use components that are easy to source; we use LCSC but other options include Digikey, Arrow, and likely other manufacturers local to you.
Last updated: | 2021-07-20 |  | You can find additional documentation regarding the LongBoard here: https://resources.sienci.com/view/lm-longboard-documentation/
 |  |  |  |  | https://resources.sienci.com/view/lm-open-source-and-modifications/
 |  |  | **Please note that all documentation is prepared with care but there's no guarantee that all provided quantities or information is exact or correct.**
Part | Notes | Quantity | Location / Designation | Manufacturer Part # or SKU | Example link for purchase
LongBoard Rev 1.3 PCB | 250 produced, 2.4mm thick, 107.7x269.28mm, FR4 TG130, black, HASL finish. Mounting holes make nearly centered rectangle of 96.03x258.15mm | 1 | Board |  | Must be manually reproduced via the provided PCB schematics
Terminal Block connector (2-pin 1-level, 5.08mm) | Plug that carries DC power to the board | 1 | P15 | WJ2EDGRC-5.08-2P | https://lcsc.com/product-detail/Pluggable-System-Terminal-Block_Ningbo-Kangnex-Elec-WJ2EDGRC-5-08-2P_C3697.html
Rocker Switch (SPST) | Manual switch to control power to the board | 1 | SW4 | SS11-BBIWQ-R20-R | https://lcsc.com/product-detail/Others_Legion-SS11-BBIWQ-R20-R_C309066.html
Diode (SMD, schottky barrier) | Part of input power management | 1 | D1 | SVM1550UB_R2_00001 | https://lcsc.com/product-detail/Schottky-Barrier-Diodes-SBD_SVM1550UB_C138358.html
Voltage Regulator (linear) | Part of the voltage regulation circuitry. Designed to receive 24V as input and supply 12V as output to a maximum of ~1A via the fan plug. | 1 | U1 | LM317AHVT | https://lcsc.com/product-detail/Linear-Voltage-Regulators_ON-Semicon_LM317AHVT_ON-Semicon-ON-LM317AHVT_C111074.html
Capacitor (SMD, 100nF) | Part of the voltage regulation circuitry. Capacitors also for noise filtering on the Play/Pause/Stop buttons, limits switches, and probe lines. | 9 | C1, C2, C3, C4, C5, C6, C7, C8, C9 | 0603F104M500NT | https://lcsc.com/product-detail/Multilayer-Ceramic-Capacitors-MLCC-SMD-SMT_100nF-104-20-50V_C42998.html
Resistor (SMD, 10kΩ) |  | 1 | R1 | 0603WAF1002T5E | https://lcsc.com/product-detail/Chip-Resistor-Surface-Mount_Uniroyal-Elec-0603WAF1002T5E_C25804.html
Resistor (SMD, 1.15kΩ) |  | 1 | R2 | 0603WAF1151T5E | https://lcsc.com/product-detail/Chip-Resistor-Surface-Mount_Uniroyal-Elec-0603WAF1151T5E_C22834.html
Tactile Switch (SPST) | Top-mounted Play/Pause/Stop buttons for manual machine control. Common tactile switch with extended switch height. | 3 | SW1, SW2, SW3 | TC-1103-C-U | https://lcsc.com/product-detail/Tactile-Switches_XKB-Enterprise-TC-1103-C-U_C318968.html
Pin Header (1*10, 2.54mm, male) | For connection to Arduino Uno board | 1 | A1 | C57369 | https://lcsc.com/product-detail/Pin-Header-Female-Header_Boom-Precision-Elec-Headers-Pins-2-54mm-1-10P_C57369.html
Pin Header (1*8, 2.54mm, male) |  | 2 | A1 | Z-211-0811-0021-001 | https://lcsc.com/product-detail/Pin-Header-Female-Header_Nextronics-Engineering-Z-211-0811-0021-001_C190820.html
Pin Header (1*6, 2.54mm, male) |  | 1 | A1 | A2541WV-6P | https://lcsc.com/product-detail/Pin-Header-Female-Header_Changjiang-Connectors-A2541WV-6P_C225481.html
XH connector (4-pin 1-level, 2.5mm) | Connect to the limit sensing circuitry for homing or hardstops. The XH connector is very common so it makes for easy connection of a variety of plug-in limit sensors. | 3 | P12, P13, P14 | S4B-XH-A-1(LF)(SN) | https://lcsc.com/product-detail/Wire-To-Board-Wire-To-Wire-Connector_JST-Sales-America_S4B-XH-A-1-LF-SN_JST-Sales-America-S4B-XH-A-1-LF-SN_C163037.html
Terminal Block connector (5-pin 1-level, 3.81mm) | Alternative connection point for limit sensing sensors | 1 | P2 | WJ15EDGRC-3.81-5P | https://lcsc.com/product-detail/Pluggable-System-Terminal-Block_Ningbo-Kangnex-Elec-WJ15EDGRC-3-81-5P_C8395.html
Terminal Block connector (4-pin 1-level, 5.08mm) | For connection to Stepper Motors | 4 | P4, P5, P6, P7 | WJ2EDGRC-5.08-4P | https://lcsc.com/product-detail/Pluggable-System-Terminal-Block_Ningbo-Kangnex-Elec-WJ2EDGRC-5-08-4P_C8446.html
Terminal Block connector (2-pin 1-level, 3.81mm) | Connector used for all other IO on the board, including 12V fan line, spindle control, coolant control, and probe input | 5 | P1, P3, P16, P17, P18 | WJ15EDGRC-3.81-2P | https://lcsc.com/product-detail/Pluggable-System-Terminal-Block_Ningbo-Kangnex-Elec-WJ15EDGRC-3-81-2P_C8387.html
TB6600 Stepper Driver Board | Built around the TB6600HG PWM Chopper-Type bipolar Stepping Motor Driver IC from Toshiba, these board modules are ubiquitous, open-source, and provide an effective means for stepper motor control at a hobby-level. There is one driver allocated per motor: one for X, two for Y, and one for Z. The datasheet for the driver chip can be found here: https://toshiba.semicon-storage.com/us/semiconductor/product/motor-driver-ics/stepping-motor-driver-ics/detail.TB6600HG.html | 4 | Driver |  | https://www.amazon.ca/KOOBOOK-TB6600HG-Stepper-Controller-Replace/dp/B07S9QBCBS/
Arduino Uno | An open-source microcontroller board based on the Microchip ATmega328P microcontroller and developed by Arduino.cc This board performs all of the processing necessary to convert incoming gcode into stepper motor movements with other CNC functionality built-in when flashed with the GRBL firmware (https://github.com/gnea/grbl). | 1 | Uno |  | https://store.arduino.cc/usa/arduino-uno-rev3
Terminal Block plug (5-pin 1-level, 3.81mm) | Plugs into the alternative connector for limit sensing sensors. Normally found already plugged into the LongBoard. | 1 | Plugs | WJ15EDGK-3.81-5P | https://lcsc.com/product-detail/Pluggable-System-Terminal-Block_Ningbo-Kangnex-Elec-WJ15EDGK-3-81-5P_C3804.html
Terminal Block plug (2-pin 1-level, 3.81mm) | Plugs into all remaining LongBoard IO. Normally found already plugged into the LongBoard's matching ports. | 5 | Plugs | WJ15EDGK-3.81-2P | https://lcsc.com/product-detail/Pluggable-System-Terminal-Block_Ningbo-Kangnex-Elec-WJ15EDGK-3-81-2P_C8466.html
LongBoard External Supporting Components
Terminal Block plug (4-pin 1-level, 5.08mm) | Plugs for the four stepper motors. Already come pre-wired onto the wiring harnesses for the LongMill (one for each motor). | 4 | Plugs | WJ2EDGK-5.08-4P | https://lcsc.com/product-detail/Pluggable-System-Terminal-Block_Ningbo-Kangnex-Elec-WJ2EDGK-5-08-4P-14-00A_C71372.html
Terminal Block plug (2-pin 1-level, 5.08mm) | Plugs into the DC power connector on the Longboard and normally comes pre-wired onto the DC side of the LongMill power supply | 1 | Plugs | WJ2EDGK-5.08-2P | https://lcsc.com/product-detail/Pluggable-System-Terminal-Block_Ningbo-Kangnex-Elec-WJ2EDGK-5-08-2P-14-00A_C71370.html
24V 10A power supply | Fully enclosed power brick with LED indicator light. Accepts 110-240V and 50-60hz. | 1 | Power Brick |  | https://www.amazon.ca/LED-Power-Supply-Adapter-24V/dp/B07K9KTMFT
AC cable | We provide this as a US / North American plug | 1 | Power Brick |  | https://www.amazon.ca/LIANSUM-Samsung-Toshiba-ViewSonic-Computer/dp/B08V8QRNQ9/
USB type B cable | 1m long, shielded & ferrite bead choke cable for communication from a separate computing device to the on-board Arduino | 1 | USB Cable |  | https://www.amazon.ca/Hi-Speed-Cable-Ferrite-Chokes-3-Ft/dp/B008VOPCGY
 | # Unique Parts: | 25
 | Total: | 55

Sheet: Rev 1.2
Bill of Materials for LongBoard (Rev 1.2) |  |  | We made the LongBoard design open-source so you could reproduce it via PCB milling, etching, or an online service. We also strive to use components that are easy to source; we use LCSC but other options include Digikey, Arrow, and likely other manufacturers local to you.
Last updated: | 2021-07-20 |  | You can find additional documentation regarding the LongBoard here: https://resources.sienci.com/view/lm-longboard-documentation/
 |  |  |  |  | https://resources.sienci.com/view/lm-open-source-and-modifications/
 |  |  | **Please note that all documentation is prepared with care but there's no guarantee that all provided quantities or information is exact or correct.**
Part | Notes | Quantity | Location / Designation | Manufacturer Part # or SKU | Example link for purchase
LongBoard Rev 1.2 PCB | 400 produced, 1.6mm thick, 107.7x259.28mm, FR4 TG130, black, HASL finish. Mounting holes located at ~: 3.7 & 4.7, 102 & 5, 5.4 & 254, 101.5 & 242.7 | 1 | Board |  | Must be manually reproduced via the provided PCB schematics. This board's mounting holes are not compatible with the current LongBoard Controller enclosure design.
Terminal Block connector (2-pin 1-level, 5.08mm) | Plug that carries DC power to the board | 1 | P15 | WJ2EDGRC-5.08-2P | https://lcsc.com/product-detail/Pluggable-System-Terminal-Block_Ningbo-Kangnex-Elec-WJ2EDGRC-5-08-2P_C3697.html
Rocker Switch (SPST) | Manual switch to control power to the board | 1 | SW4 | SS11-BBIWQ-R20-R | https://lcsc.com/product-detail/Others_Legion-SS11-BBIWQ-R20-R_C309066.html
Diode (SMD, schottky barrier) | Part of input power management | 1 | D1 | SVM1550UB_R2_00001 | https://lcsc.com/product-detail/Schottky-Barrier-Diodes-SBD_SVM1550UB_C138358.html
Voltage Regulator (linear) | Part of the voltage regulation circuitry. Designed to receive 24V as input and supply 12V as output to a maximum of ~1A via the fan plug. | 1 | U1 | LM317AHVT | https://lcsc.com/product-detail/Linear-Voltage-Regulators_ON-Semicon_LM317AHVT_ON-Semicon-ON-LM317AHVT_C111074.html
Capacitor (SMD, 100nF) | Part of the voltage regulation circuitry | 2 | C1,C2 | 0603F104M500NT | https://lcsc.com/product-detail/Multilayer-Ceramic-Capacitors-MLCC-SMD-SMT_100nF-104-20-50V_C42998.html
Resistor (SMD, 10kΩ) |  | 1 | R1 | 0603WAF1002T5E | https://lcsc.com/product-detail/Chip-Resistor-Surface-Mount_Uniroyal-Elec-0603WAF1002T5E_C25804.html
Resistor (SMD, 1.15kΩ) |  | 1 | R2 | 0603WAF1151T5E | https://lcsc.com/product-detail/Chip-Resistor-Surface-Mount_Uniroyal-Elec-0603WAF1151T5E_C22834.html
Tactile Switch (SPST) | Top-mounted Play/Pause/Stop buttons for manual machine control. Common tactile switch with extended switch height. | 3 | SW1, SW2, SW3 | TC-1103-C-U | https://lcsc.com/product-detail/Tactile-Switches_XKB-Enterprise-TC-1103-C-U_C318968.html
Pin Header (1*10, 2.54mm, male) | For connection to Arduino Uno board | 1 | A1 | C57369 | https://lcsc.com/product-detail/Pin-Header-Female-Header_Boom-Precision-Elec-Headers-Pins-2-54mm-1-10P_C57369.html
Pin Header (1*8, 2.54mm, male) |  | 2 | A1 | Z-211-0811-0021-001 | https://lcsc.com/product-detail/Pin-Header-Female-Header_Nextronics-Engineering-Z-211-0811-0021-001_C190820.html
Pin Header (1*6, 2.54mm, male) |  | 1 | A1 | A2541WV-6P | https://lcsc.com/product-detail/Pin-Header-Female-Header_Changjiang-Connectors-A2541WV-6P_C225481.html
XH connector (4-pin 1-level, 2.5mm) | Connect to the limit sensing circuitry for homing or hardstops. The XH connector is very common so it makes for easy connection of a variety of plug-in limit sensors. | 3 | P12, P13, P14 | S4B-XH-A-1(LF)(SN) | https://lcsc.com/product-detail/Wire-To-Board-Wire-To-Wire-Connector_JST-Sales-America_S4B-XH-A-1-LF-SN_JST-Sales-America-S4B-XH-A-1-LF-SN_C163037.html
Terminal Block connector (5-pin 1-level, 3.81mm) | Alternative connection point for limit sensing sensors | 1 | P2 | WJ15EDGRC-3.81-5P | https://lcsc.com/product-detail/Pluggable-System-Terminal-Block_Ningbo-Kangnex-Elec-WJ15EDGRC-3-81-5P_C8395.html
Terminal Block connector (4-pin 1-level, 5.08mm) | For connection to Stepper Motors | 4 | P4, P5, P6, P7 | WJ2EDGRC-5.08-4P | https://lcsc.com/product-detail/Pluggable-System-Terminal-Block_Ningbo-Kangnex-Elec-WJ2EDGRC-5-08-4P_C8446.html
Terminal Block connector (2-pin 1-level, 3.81mm) | Connector used for all other IO on the board, including 12V fan line, spindle control, coolant control, and probe input | 5 | P1, P3, P16, P17, P18 | WJ15EDGRC-3.81-2P | https://lcsc.com/product-detail/Pluggable-System-Terminal-Block_Ningbo-Kangnex-Elec-WJ15EDGRC-3-81-2P_C8387.html
TB6600 Stepper Driver Board | Built around the TB6600HG PWM Chopper-Type bipolar Stepping Motor Driver IC from Toshiba, these board modules are ubiquitous, open-source, and provide an effective means for stepper motor control at a hobby-level. There is one driver allocated per motor: one for X, two for Y, and one for Z. The datasheet for the driver chip can be found here: https://toshiba.semicon-storage.com/us/semiconductor/product/motor-driver-ics/stepping-motor-driver-ics/detail.TB6600HG.html | 4 | Driver |  | https://www.amazon.ca/KOOBOOK-TB6600HG-Stepper-Controller-Replace/dp/B07S9QBCBS/
Arduino Uno | An open-source microcontroller board based on the Microchip ATmega328P microcontroller and developed by Arduino.cc This board performs all of the processing necessary to convert incoming gcode into stepper motor movements with other CNC functionality built-in when flashed with the GRBL firmware (https://github.com/gnea/grbl). | 1 | Uno |  | https://store.arduino.cc/usa/arduino-uno-rev3
Terminal Block plug (5-pin 1-level, 3.81mm) | Plugs into the alternative connector for limit sensing sensors. Normally found already plugged into the LongBoard. | 1 | Plugs | WJ15EDGK-3.81-5P | https://lcsc.com/product-detail/Pluggable-System-Terminal-Block_Ningbo-Kangnex-Elec-WJ15EDGK-3-81-5P_C3804.html
Terminal Block plug (2-pin 1-level, 3.81mm) | Plugs into all remaining LongBoard IO. Normally found already plugged into the LongBoard's matching ports. | 5 | Plugs | WJ15EDGK-3.81-2P | https://lcsc.com/product-detail/Pluggable-System-Terminal-Block_Ningbo-Kangnex-Elec-WJ15EDGK-3-81-2P_C8466.html
LongBoard External Supporting Components
Terminal Block plug (4-pin 1-level, 5.08mm) | Plugs for the four stepper motors. Already come pre-wired onto the wiring harnesses for the LongMill (one for each motor). | 4 | Plugs | WJ2EDGK-5.08-4P | https://lcsc.com/product-detail/Pluggable-System-Terminal-Block_Ningbo-Kangnex-Elec-WJ2EDGK-5-08-4P-14-00A_C71372.html
Terminal Block plug (2-pin 1-level, 5.08mm) | Plugs into the DC power connector on the Longboard and normally comes pre-wired onto the DC side of the LongMill power supply | 1 | Plugs | WJ2EDGK-5.08-2P | https://lcsc.com/product-detail/Pluggable-System-Terminal-Block_Ningbo-Kangnex-Elec-WJ2EDGK-5-08-2P-14-00A_C71370.html
24V 10A power supply | Fully enclosed power brick with LED indicator light. Accepts 110-240V and 50-60hz. | 1 | Power Brick |  | https://www.amazon.ca/LED-Power-Supply-Adapter-24V/dp/B07K9KTMFT
AC cable | We provide this as a US / North American plug | 1 | Power Brick |  | https://www.amazon.ca/LIANSUM-Samsung-Toshiba-ViewSonic-Computer/dp/B08V8QRNQ9/
USB type B cable | 1m long, shielded & ferrite bead choke cable for communication from a separate computing device to the on-board Arduino | 1 | USB Cable |  | https://www.amazon.ca/Hi-Speed-Cable-Ferrite-Chokes-3-Ft/dp/B008VOPCGY
 | # Unique Parts: | 25
 | Total: | 48
