Sienci-Labs/Resources/_community-docs/Selling-Calculator.xlsm

CNC WORKSHOP PRICE CALCULATOR |  |  |  |  |  |  |  | Selling Price Review
 |  |  |  |  |  |  | A Basic Calculator for Hobby and Small Shops
 |  |  | Product/Customer:
format xx/xx/xxxx |  |  | Date: |  |  |  |  |  |  |  |  | Selling Price: | $0.00
 |  | Markup %: |  |  |  | 50
 |  |  |  |  | desired return |  |  |  |  |  |  | Shipping Charge: | $0.00
 |  |  |  |  | Shipping Cost: $ |  |  |  |  | Sales Tax: |  |  | $0.00
 |  |  |  |  | amount paid by you
 |  |  |  |  | Shipping Charge: $ |  |  |  |  |  |  | TOTAL PRICE to Customer: | $0.00
 |  |  |  |  | amount charged to buyer
FALSE |  |  |  |  | Sales Tax: % | 0.00 |  |  | Less Selling and Transaction Costs
 |  |  | Charge Sales Tax on Shipping |  |  |  |  |  |  |  | Selling Cost: |  | $0.00
 |  |  |  |  |  |  |  |  |  |  | Transaction Cost: |  | $0.00
 |  | Selling Cost (e.g. Amazon, eBay or Etsy Fees)
 |  |  |  | Percentage % | 0.0 |  |  |  |  |  |  | Total Revenue: | $0.00
 |  |  |  | and/or Fixed $ | $0.00 |  |  |  |  |  |  | Total Profit: | $0.00
 |  | Transaction Cost (e.g. CC or PayPal Fees) |  |  |  |  |  |  |  |  |  | Profit Margin: | 0.0%
 |  |  |  | Percentage % | 0.0
 |  |  |  | and/or Fixed $ | $0.00 |  |  |  | Profit - Does not include your hourly wage.
 |  |  |  |  |  |  |  |  | What is % Markup? Markup is the difference between your selling price and your cost. It is the % of the product cost added to the total cost to cover business expenses and create a profit.
 |  | FILL OUT FOR ITEM COST:
 |  |  |  |  | Your Expected Hourly Wage: | $35.00
 |  |  |  |  | Cost of Materials:
 |  |  |  |  | Cost of Design:
 |  |  |  |  |  |  |  |  | Overhead Cost - Expressed as a % of your hourly wage to cover rent, insurance, etc.
 |  |  |  |  | Minutes of your time on Product:
 |  |  |  |  | Minutes Designing:
 |  | Minutes with Client: |  |  |  |  |  |  | Design costs are what you paid for models, vectors, or artwork.
 |  |  |  |  | Cost of Box, etc.: $
 |  |  |  |  | Additional Costs: $ |  |  |  | The Minutes spent on Product, Design, and with the Client are calcuated using your Hourly Wage
 |  |  |  |  | Overhead Costs %: | 10
 |  |  |  |  | TOTAL COSTS: | $0.00
 | Resets form for next calculation
