Sienci-Labs/Resources/_downloads/_altmill/3DP-Ready-CLS-Motor-Cover.stl

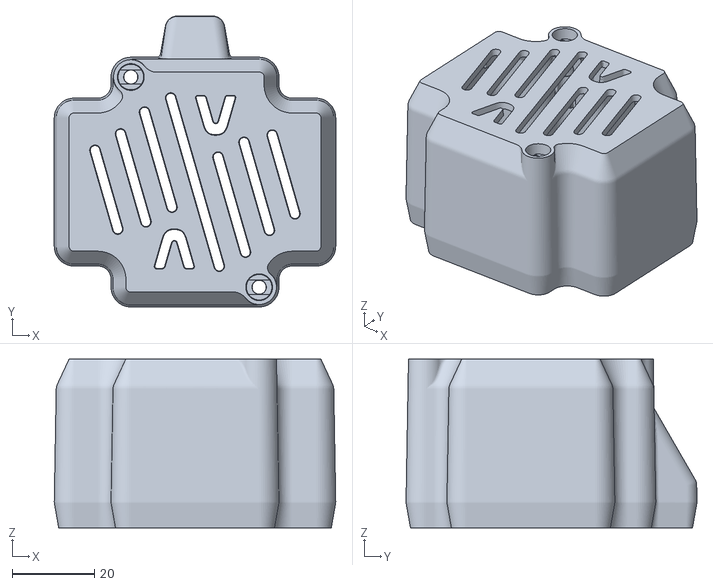
[picture p313: CAD file, 2025-11-12]
_downloads/_altmill/3DP-Ready-CLS-Motor-Cover.stl
68.3 x 70.6 x 41.0
