Sienci-Labs/Resources/_downloads/_longmill/_hardware-files/longmill-mk1-magnetic-dust-shoe-bristle-hold.stl

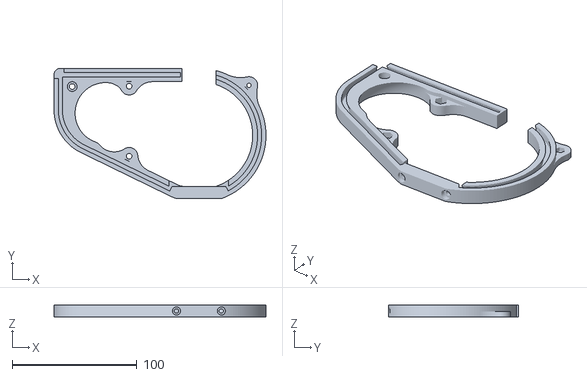
[picture p314: CAD file, 2025-11-12]
_downloads/_longmill/_hardware-files/longmill-mk1-magnetic-dust-shoe-bristle-hold.stl
169.9 x 104.4 x 9.51
