Sienci-Labs/Resources/_downloads/_longmill/_hardware-files/Air_Assist_Body.stl

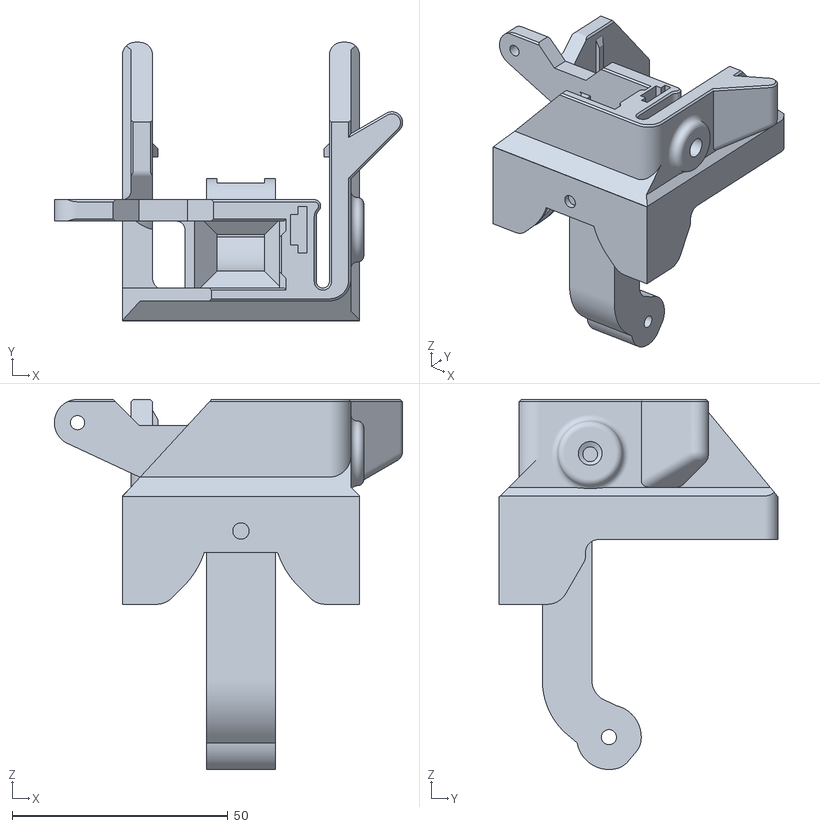
[picture p315: CAD file, 2025-11-12]
_downloads/_longmill/_hardware-files/Air_Assist_Body.stl
80.8 x 64.6 x 85.8
