Sienci-Labs/Resources/_downloads/_longmill/_hardware-files/longmill-mk1-magnetic-dust-shoe-body.stl

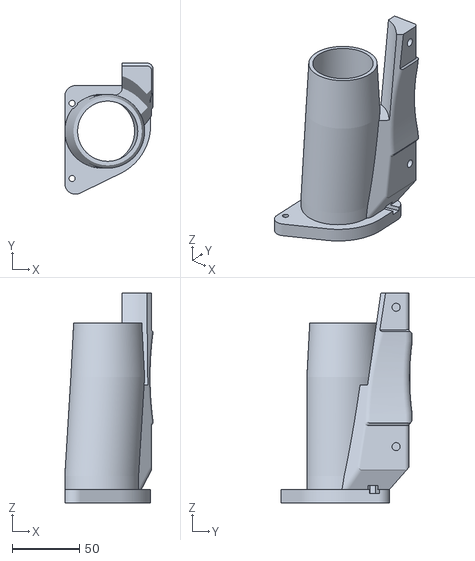
[picture p316: CAD file, 2025-11-12]
_downloads/_longmill/_hardware-files/longmill-mk1-magnetic-dust-shoe-body.stl
65.9 x 97.9 x 156.5
