Sienci-Labs/Resources/_downloads/_longmill/_hardware-files/sienci-steel-clamp-end-cap.stl

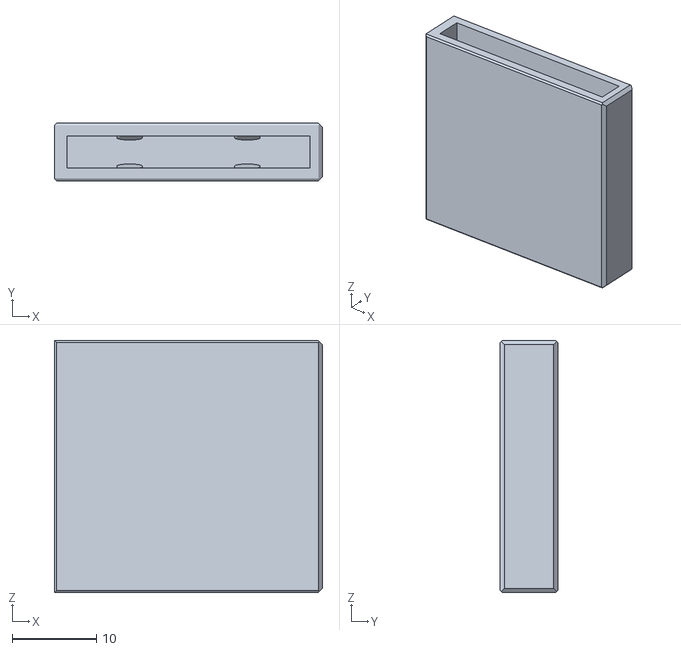
[picture p317: CAD file, 2025-11-12]
_downloads/_longmill/_hardware-files/sienci-steel-clamp-end-cap.stl
31.9 x 6.85 x 30.0
