Sienci-Labs/Resources/_downloads/_longmill/_hardware-files/sienci-wood-clamp-100mm.stl

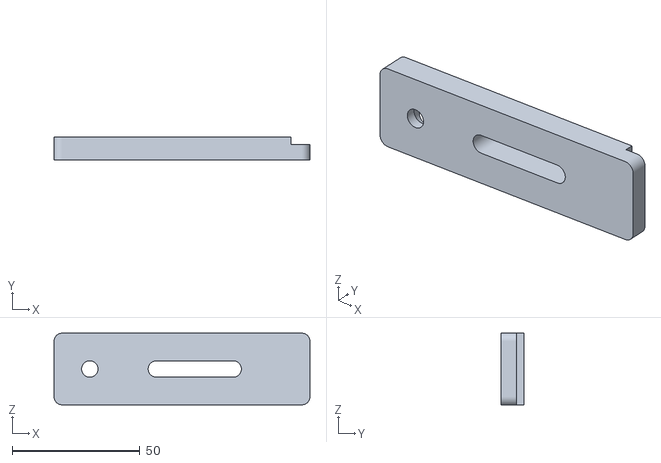
[picture p318: CAD file, 2025-11-12]
_downloads/_longmill/_hardware-files/sienci-wood-clamp-100mm.stl
100.0 x 9.00 x 28.0
