Sienci-Labs/Resources/_downloads/_longmill/_hardware-files/longmill-mk1-dust-shoe-hose-adapter.stl

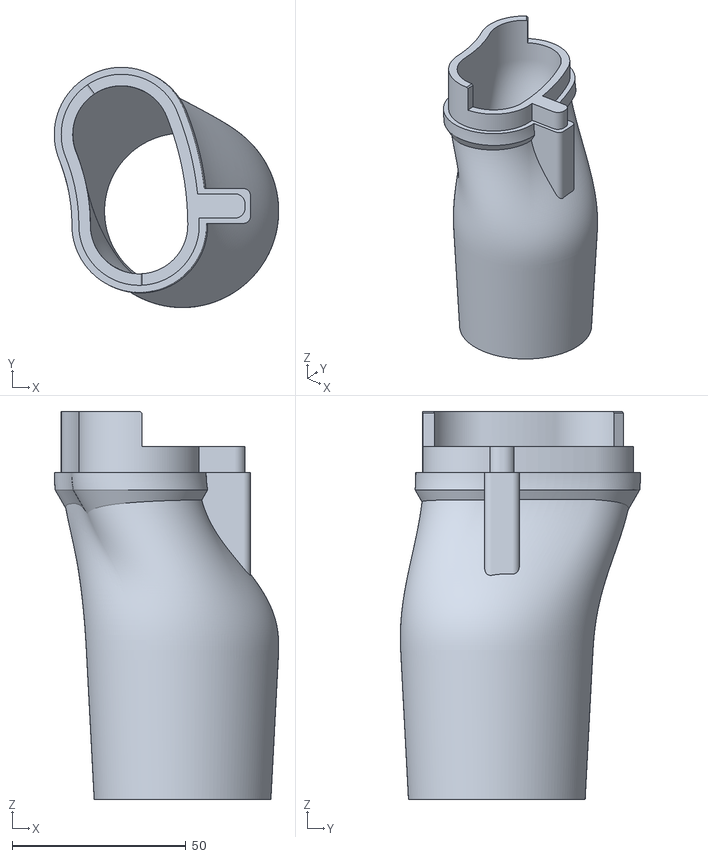
[picture p319: CAD file, 2024-11-01]
_downloads/_longmill/_hardware-files/longmill-mk1-dust-shoe-hose-adapter.stl
64.5 x 69.1 x 111.5
