Sienci-Labs/Resources/lmmk3/lmk3-assembly/lmk3-table-mounting.md

---
title: 5. Table Mounting
menu_order: 6
post_status: publish
post_excerpt: How to mount your LongMill MK3 to your table and how to surface your wasteboard.
post_date: 2026-05-20 10:40:22
taxonomy:
    knowledgebase_cat: lmk3-assembly
    knowledgebase_tag:
custom_fields:
    KBName: LongMill MK3
    basepress_post_icon: bp-caret-right
skip_file: no
featured_image: _images/post-image.jpg
---

## Table Mounting

https://www.youtube.com/watch?v=whaciag4WEk

We will now use gSender to jog the machine to the travel limits, which will square up the machine and allow you to secure down the machine to the MDF sheet. The MDF will act as your wasteboard.

    ⭐ Due to the use of linear guides on the X and Y axes, there is zero play in the axes which means they can be squared to each other simply by jogging front to back.

1. Adjust the position of your assembled machine, so that there is space for the SLB-LITE to sit on the MDF.

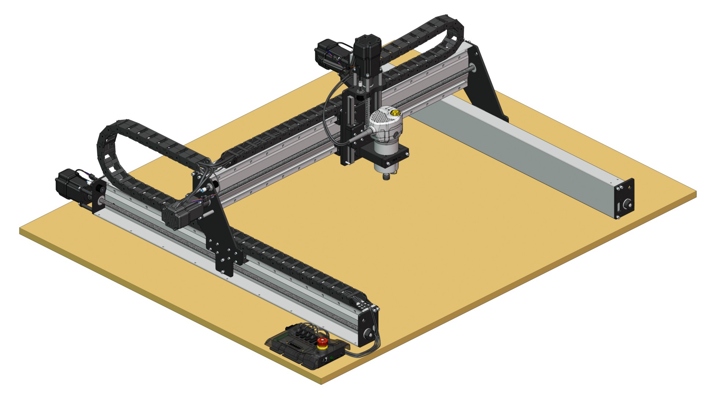
[picture p433: _images/_lmmk3/_assembly/_tablemount/lmk3_tablemounting_render_22.jpg]
    

1. Download the latest version of [gSender](https://sienci.com/gsender/) onto your computer. If it was pre-installed, check that you have gSender 1.6.4 or above, at the top of the window. Detailed installation instructions can be found on [this page](https://resources.sienci.com/view/gs-installation/).

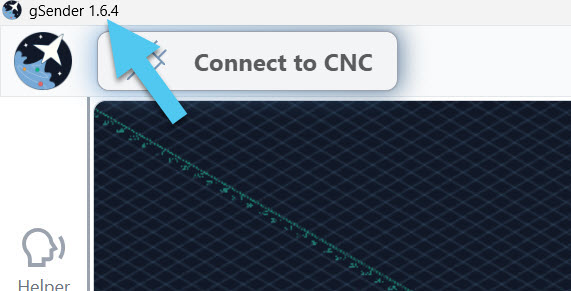
[picture p434: _images/_lmmk3/_assembly/_tablemount/lmk3_tablemount-gsenderver.jpg]
    

1. Connect to gSender through USB using the top left corner dropdown.

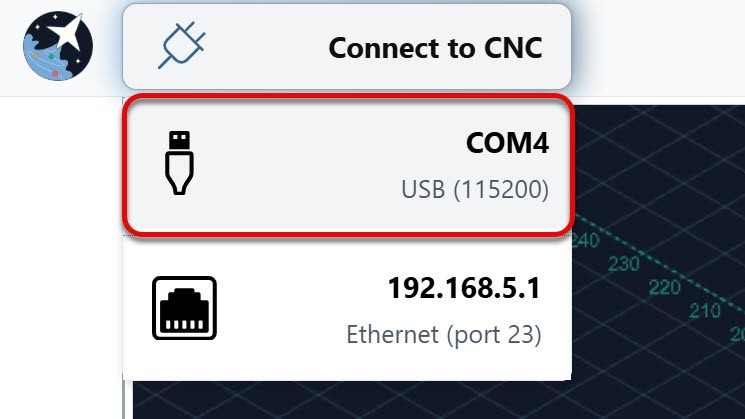
[picture p435: _images/_lmmk3/_assembly/_tablemount/lmk3_tablemount-connectgsender.jpg]
    

1. You will see a red Alarm 11 at the top of the screen. It will prompt you to home your machine, go ahead and press the red button on gSender to proceed. Your machine will move up to the top, then to the back left corner.

    

1. Once homed, move the machine around with the jog wheel buttons, to make sure your motors are moving the expected amount and in the right direction.

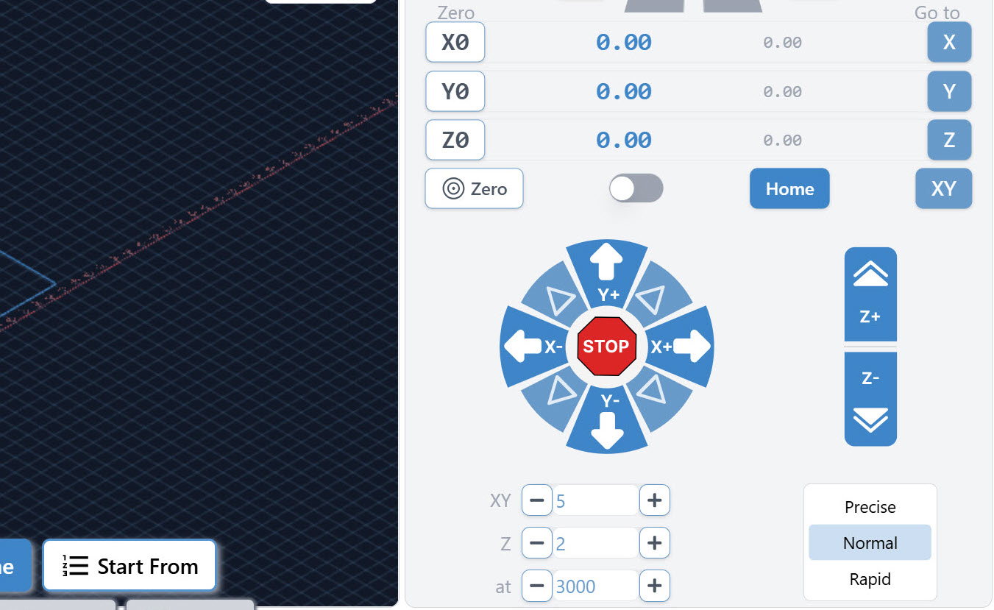
[picture p436: _images/_lmmk3/_assembly/_tablemount/lmk3_tablemount-movedro.jpg]
    

1. Ensure you have the correct machine profile selected in the Config tab.

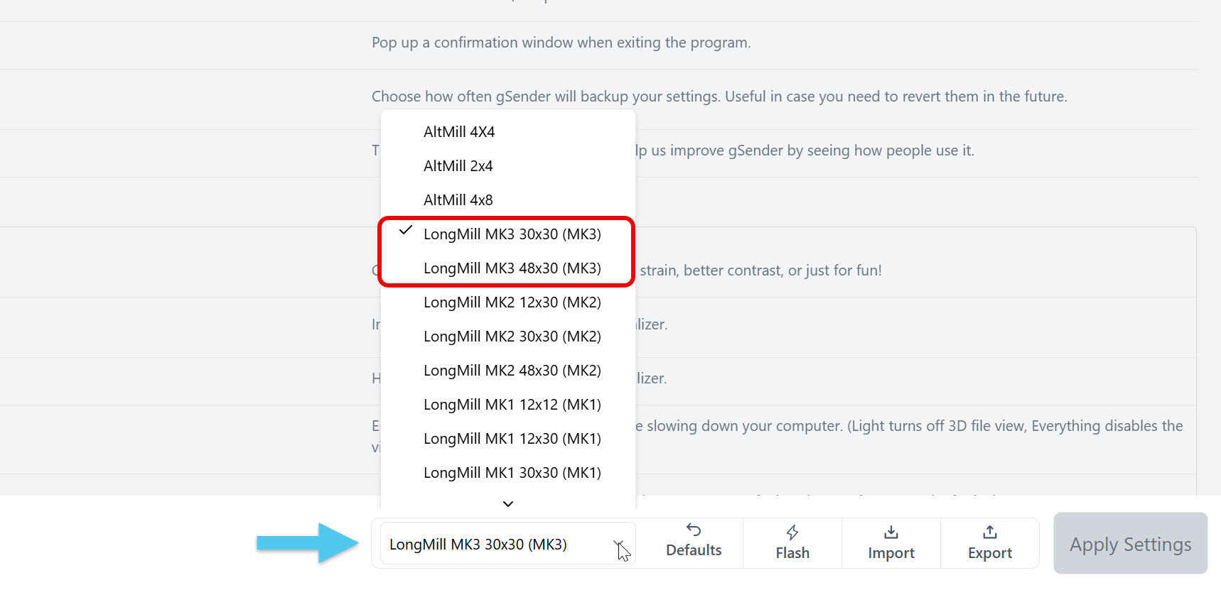
[picture p437: _images/_lmmk3/_assembly/_tablemount/lmk3_tablemount-gsendpro.jpg]
    

1. Then jog the machine to the very back using the Y+ button.

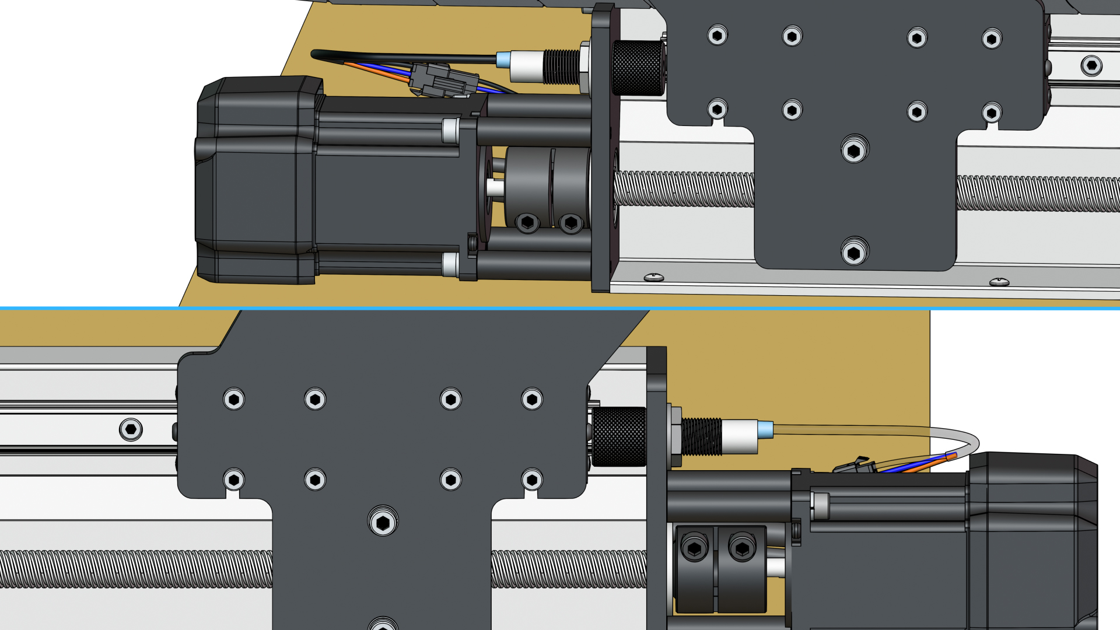
[picture p438: _images/_lmmk3/_assembly/_tablemount/lmk3_tablemount-render_24_A.jpg]
    

1. Square the machine to your MDF sheet; use the measuring tape to evenly offset the Y rail plates from the back edge of the MDF. If you are planing on using the gControl panel, shift your machine to be flush with the front, so the bracket can mount.

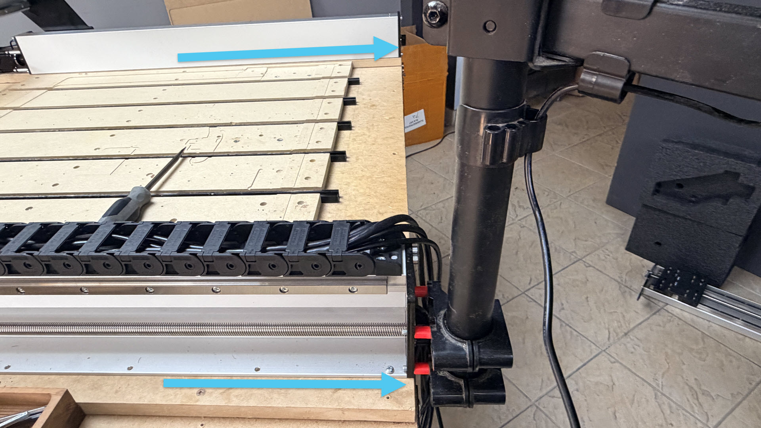
[picture p439: _images/_lmmk3/_assembly/lmk3_assembly_xy_axes-slideforward.jpg]
    

1. Shift your machine to get it into the desired position.

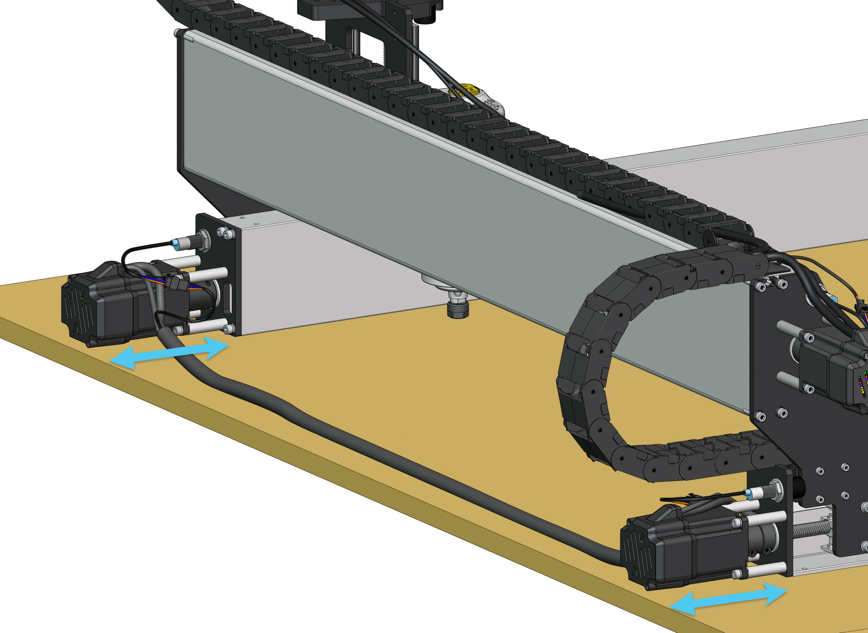
[picture p440: _images/_lmmk3/_assembly/_tablemount/lmk3_tablemount-yaxisoffset.jpg]
    

1. Screw down the back-most holes of both Y rails using the wood screws.

1. Then jog the machine to the very front using the Y- button.

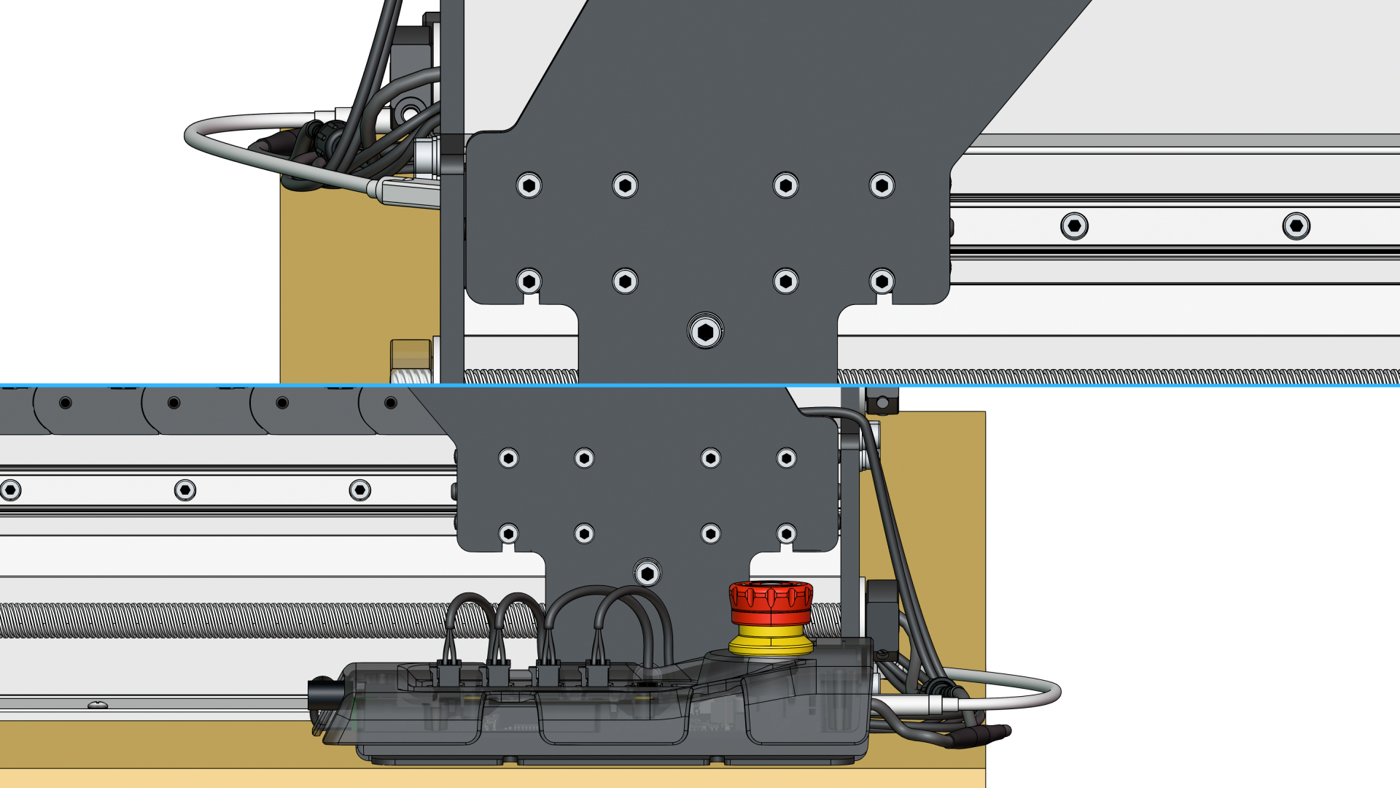
[picture p441: _images/_lmmk3/_assembly/_tablemount/lmk3_tablemount-render_27_A.jpg]
    

1. Screw down the front-most hole of both Y rails using the wood screws. Then finish securing the remaining holes to complete table mounting.

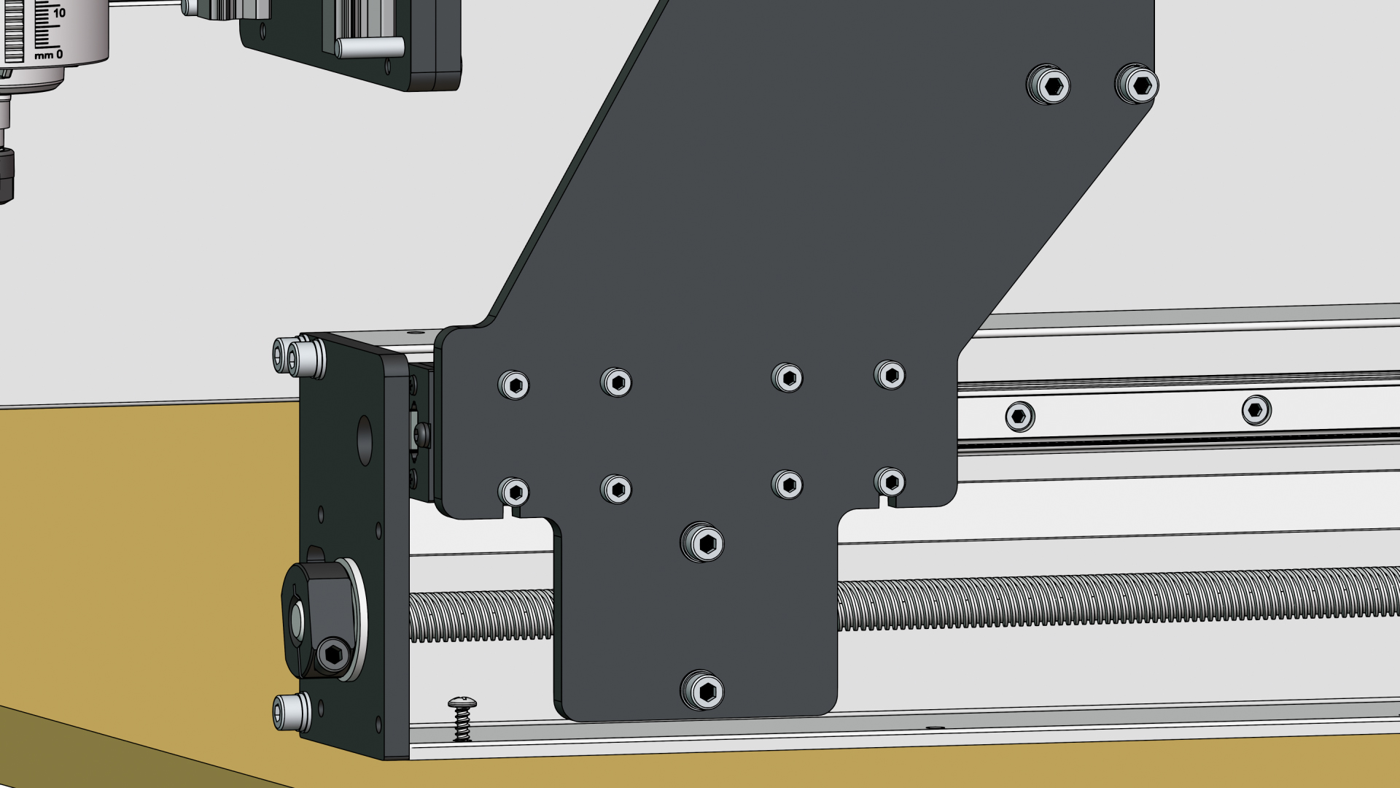
[picture p442: _images/_lmmk3/_assembly/_tablemount/lmk3_tablemount-render_26.jpg]
    

You did it! Your machine is now assembled. We only have a few final set up tasks for some accessories, so go ahead to the next page to finish it up!
