Sienci-Labs/Resources/atc/atc-assembly/atc-before-you-begin.md

---
title: ATC Before You Begin
menu_order: 1
post_status: publish
post_excerpt: 
post_date: 2026-02-09 11:44:53
taxonomy:
    knowledgebase_cat: atc-assembly
    knowledgebase_tag: 
custom_fields:
    KBName: AutoToolChanger
    basepress_post_icon: bp-caret-right
skip_file: no
featured_image: _images/_atc/_atc_assembly/_before/atc_assembly_before-axis.jpg
---

## Before You Begin

If you’re installing the ATC on a **new machine**, please complete the machine assembly first before following this guide.

The expected ATC assembly time is **2–4 hours**, so be sure to allot enough time and pace yourself to avoid errors, damage, or injury during the process.

### Software Upgrade

Before we dive in, we will need to make some changes on the software side. You will need to:

1. **Download or configure** the appropriate post-processor for your CAM software. This is essential for creating g-code that works correctly with the ATC.

    [Vectric](https://drive.google.com/file/d/1mgyv90uslGa4Cadq8EKwFjALcVChzU34/view?usp=drive_link)

    [Vectric with Vortex Rotary Axis](https://drive.google.com/file/d/1tEr16-cVp_aaULNH_i3Dd5rDd4RDe02K/view?usp=drive_link)

    [CarveCo](https://drive.google.com/file/d/1UqWXNDYrgd2CR3ci91QXc0FMH09GMZRi/view?usp=drive_link)

    **Fusion 360**

    Fusion 360 uses the built-in **grbl** post-processor, so no additional download is required. When exporting your g-code, check these post-processor settings:

    - **Safe Retracts:** Set to `Clearance Height` instead of `G28` to help prevent unexpected machine movements.
    - **Output M6:** Set to `Yes` to enable tool changes.
    - **Output Tool Number:** Set to `Yes` so the ATC can identify which tool to load.

    Make sure the tool numbers in Fusion 360 match the tools configured in your ATC before running your job.

    > **Note:** Automatic tool changing requires a paid Fusion subscription. If the g-code is missing tool changes, make sure **Manual Tool Change** is unchecked in each tool's Post Processor settings.

1. **Upgrade** [gSender](https://github.com/Sienci-Labs/gsender/releases) to 1.6.2 or higher, then come back for the next step.

1. **Unplug** your spindle cable, VFD power cable, and RS485 (control) cable if they are plugged in.

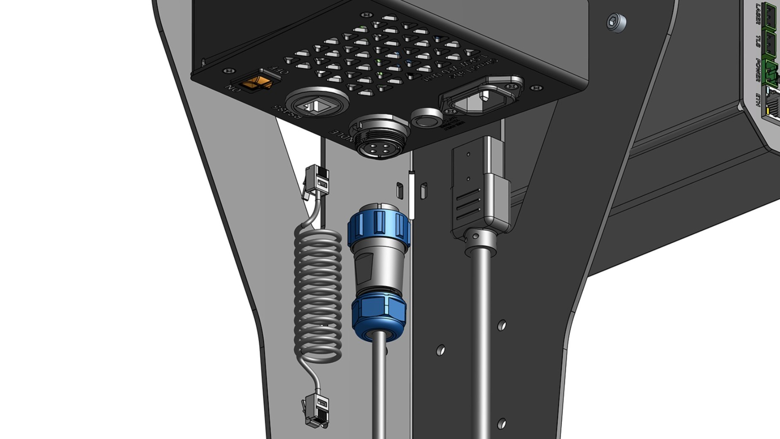
[picture p443: _images/_atc/_atc_assembly/_before/atc_assembly_beforeyoubegin-discon.jpg]
    

1. **Check** your controller firmware by clicking on the machine information icon, and verifying version **20260525** is installed.

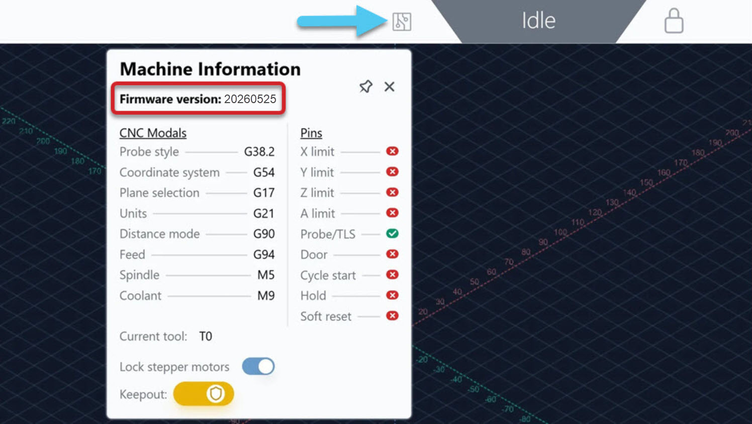
[picture p444: _images/_atc/_atc_assembly/_before/atc_assembly_beforeyoubegin-firmware2.jpg]
    

    If not, **please update by following the [instructions here](https://resources.sienci.com/view/slb-firmware-flashing/),** or watch the **firmware update video** below, then come back for the next step.

    https://www.youtube.com/watch?v=YmmHqQR9WTY

1. **Apply** the appropriate machine profile in gSender. Make sure you turn OFF/ON the controller to have any changes take effect.

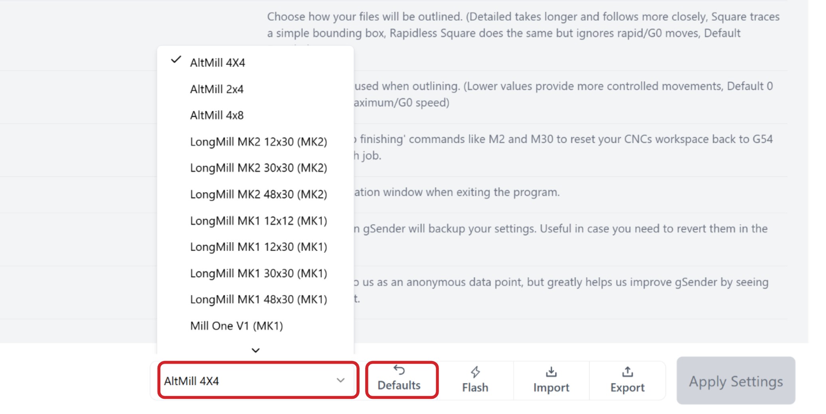
[picture p445: _images/_atc/_atc_assembly/_before/atc_assembly_beforeyoubegin-defaults.jpg]


### Assembly Tips

* The articles are listed in the order they should be followed, make sure you don't skip a page.

* We strongly recommend having a second person available at the Spindle Setup and Tool Rack & TLS sections, due to the weight of the subassemblies.

* Grab a set of **metric Allen keys**, as well as use the provided Allen keys. You can use a regular drill for screws that are M5 or larger, but **do not use impact drills** as they can strip the holes. Begin threading each screw by hand first to prevent cross-threading.  

* Keep components in their **original bags and boxes** until they are needed. The labels will help you quickly identify the correct parts.

* Machine orientation follows this photo:

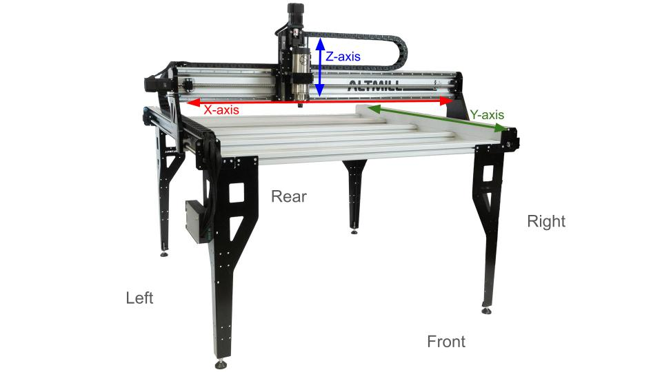
[picture p446: _images/_atc/_atc_assembly/_before/atc_assembly_before-axis.jpg]


## Machine Preparation

    We need to get your AltMill to a "blank state," so that regardless of its size, version, and build journey (i.e. existing or new build), we can easily install your new ATC system! Completing these prep steps beforehand will make the process much smoother and help avoid unnecessary disassembly later.

1. Jog the machine towards the **front** for easier access during assembly.

1. Verify that the **second-to-last crossbeam** on your AltMill is oriented correctly. The flange should face the rear of the machine, unless you have a 4x8 machine, in which case it should face the front.

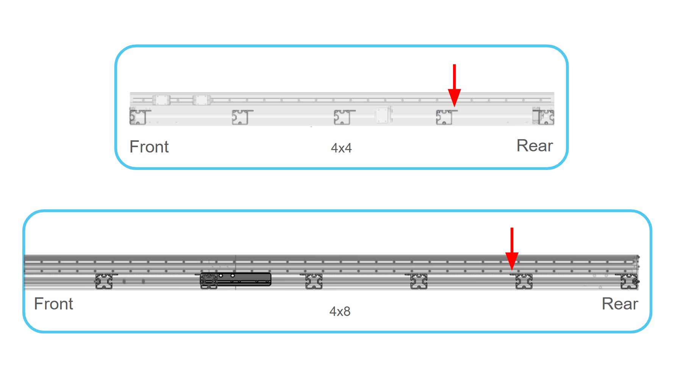
[picture p447: _images/_atc/_atc_assembly/_before/atc_assembly_beforeyoubegin-cbeams.jpg]


1. Power off your **SLB-EXT controller**, and unplug it from power.

1. Got a **wasteboard** installed?

    * Ensure the last 13 inches at the back of the machine is not covered. You can cut it now, or remove it entirely for the duration of the ATC installation.

1. Got a **gControl panel** installed?

    * Unplug it from power, and remove the gControl and its mounting bracket.

1. Got a **Z-Plus Drag Chain Arm** installed?

    * Remove it from the Z-axis gantry, it is not needed for the ATC. Keep the end links on the drag chain.

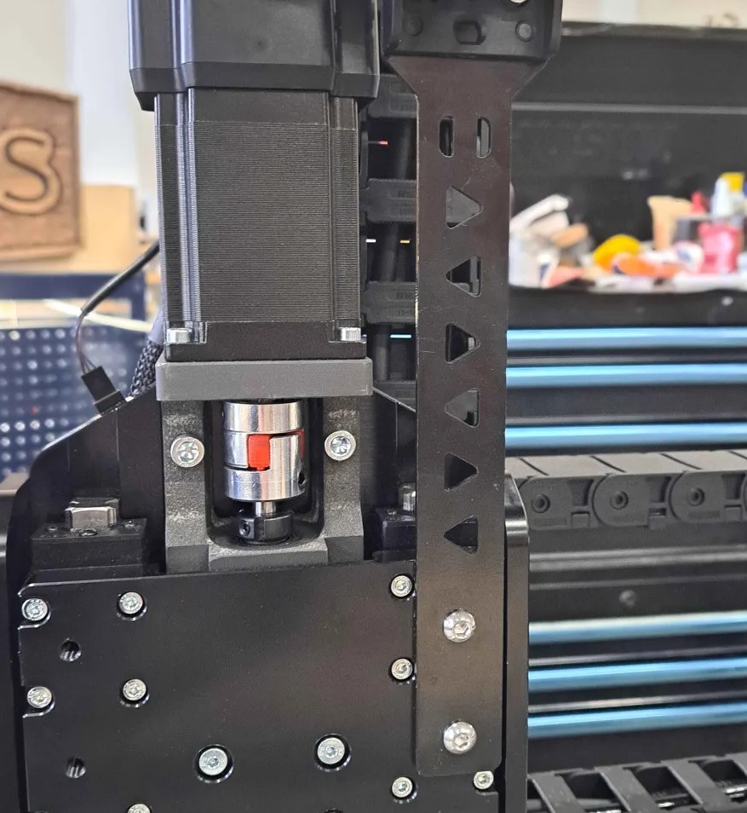
[picture p448: _images/_atc/_atc_assembly/_before/atc_assembly_before-zplus.jpg]
    

1. Got a **non-ATC spindle** installed?

    i. Unplug **connections at the spindle and VFD** (the spindle cable, VFD power cable and RS485 cable).

    ii. Free the existing, **non-ATC spindle cable** from the drag chains.  Once the cable is removed, leave approximately 1 in 10 clips in place to keep the existing wiring organized.

    iii. **Remove the spindle and spindle mount** from the Z-axis.

    iv. **Remove the VFD** from its mount and store it safely.

From the above list, double check that you've done everything that applies to your AltMill. Then you can continue with [**Unboxing**](https://resources.sienci.com/view/atc-unboxing/)!
