Sienci-Labs/Resources/lmmk3/lmk3-assembly/lmk3-best-practices.md

---
title: Best Practices ⭐
menu_order: 1
post_status: publish
post_excerpt: Best practices to keep in mind during setup for the LongMill MK3 CNC. 
post_date: 2026-05-20 10:35:00
taxonomy:
    knowledgebase_cat: lmk3-assembly
    knowledgebase_tag:
custom_fields:
    KBName: LongMill MK3
    basepress_post_icon: bp-caret-right
skip_file: no
featured_image: _images/post-image.jpg
---

## Tips

Before you dive into the assembly of your machine, we have a few recommendations to make your experience a good one:

- The expected assembly and setup time is around 2 hours, take your time and review steps carefully.
- Use the appropriate tool for each fastener. You may use a drill or driver for quicker assembly, but be careful not to overtorque screws
- Before tightening fasteners, take note of whether they should be firmly or loosely secured. Some steps will require that screws initially be left loose so that components can be aligned in later steps.
- Keep the LongMill packaging as some of it will be used in the assembly process
- Ensure you have enough table space for building the machine. We recommend at least 60"x48" for the 30x30 and 78"x48" for the 48x30
- Keep the hardware in its respective bag until needed to make finding the correct type easier using the attached labels
- If you are uncomfortable with using software, we highly recommend you have a computer-savvy friend or family member to help you with the final few steps, starting at Table Mounting.
- If you have the Beginner's Kit, here are the pages to learn how to use the add-ons. Bookmark and refer to them once you are done machine assembly.

  - [AutoZero Touch Plate](https://resources.sienci.com/view/addons-autozero/)
  - [AutoSpin T1 Router](https://resources.sienci.com/view/as-er-collets/)
  - [End Mills and Cutting Tools](https://resources.sienci.com/view/cnc-cutting-tools/)

## Videos

If you prefer video, you can watch the following videos to assemble and set up your LongMill MK3.

These videos cover the following pages:

- [Best Practices](https://www.youtube.com/watch?v=ZLIK5op5FC4)
- [MK3 Unboxing](https://www.youtube.com/watch?v=s1ihVgx0hLY)
- [X and Y-axes](https://www.youtube.com/watch?v=62zib7Jisic)
- [Z-axis](https://www.youtube.com/watch?v=mkkfaaChz5k)
- [Drag Chain and Cables](https://www.youtube.com/watch?v=5f8kO8QCEcs)
- [Table Mounting](https://www.youtube.com/watch?v=whaciag4WEk)

After these videos, please read the remaining pages: [Final Checks](https://resources.sienci.com/view/lmk3-final-checks/) and [Surfacing & First Project](https://resources.sienci.com/view/lmk3-surfacing-first-proj/) to fully prepare for your CNCing journey.

    ⚠️ Any updates to our instructions will be reflected in the written instructions, so if something is not working after following the video, please read our assembly articles!
