Sienci-Labs/Resources/lmmk3/lmk3-assembly/lmk3-drag-chains.md

---
title: 4. Drag Chains and Cables
menu_order: 5
post_status: publish
post_excerpt: 
post_date: 2026-05-20 10:56:06
taxonomy:
    knowledgebase_cat: lmk3-assembly
    knowledgebase_tag:
custom_fields:
    KBName: LongMill MK3
    basepress_post_icon: bp-caret-right
skip_file: no
featured_image: _images/post-image.jpg
---
## Drag Chains and Cables

https://www.youtube.com/watch?v=5f8kO8QCEcs

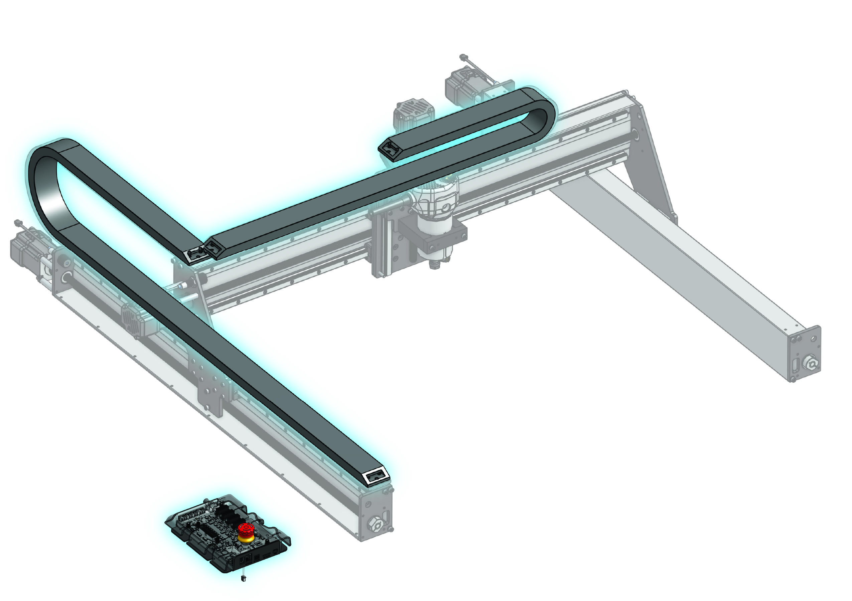
[picture p499: _images/_lmmk3/_assembly/lmk3_dragchain-header.jpg]


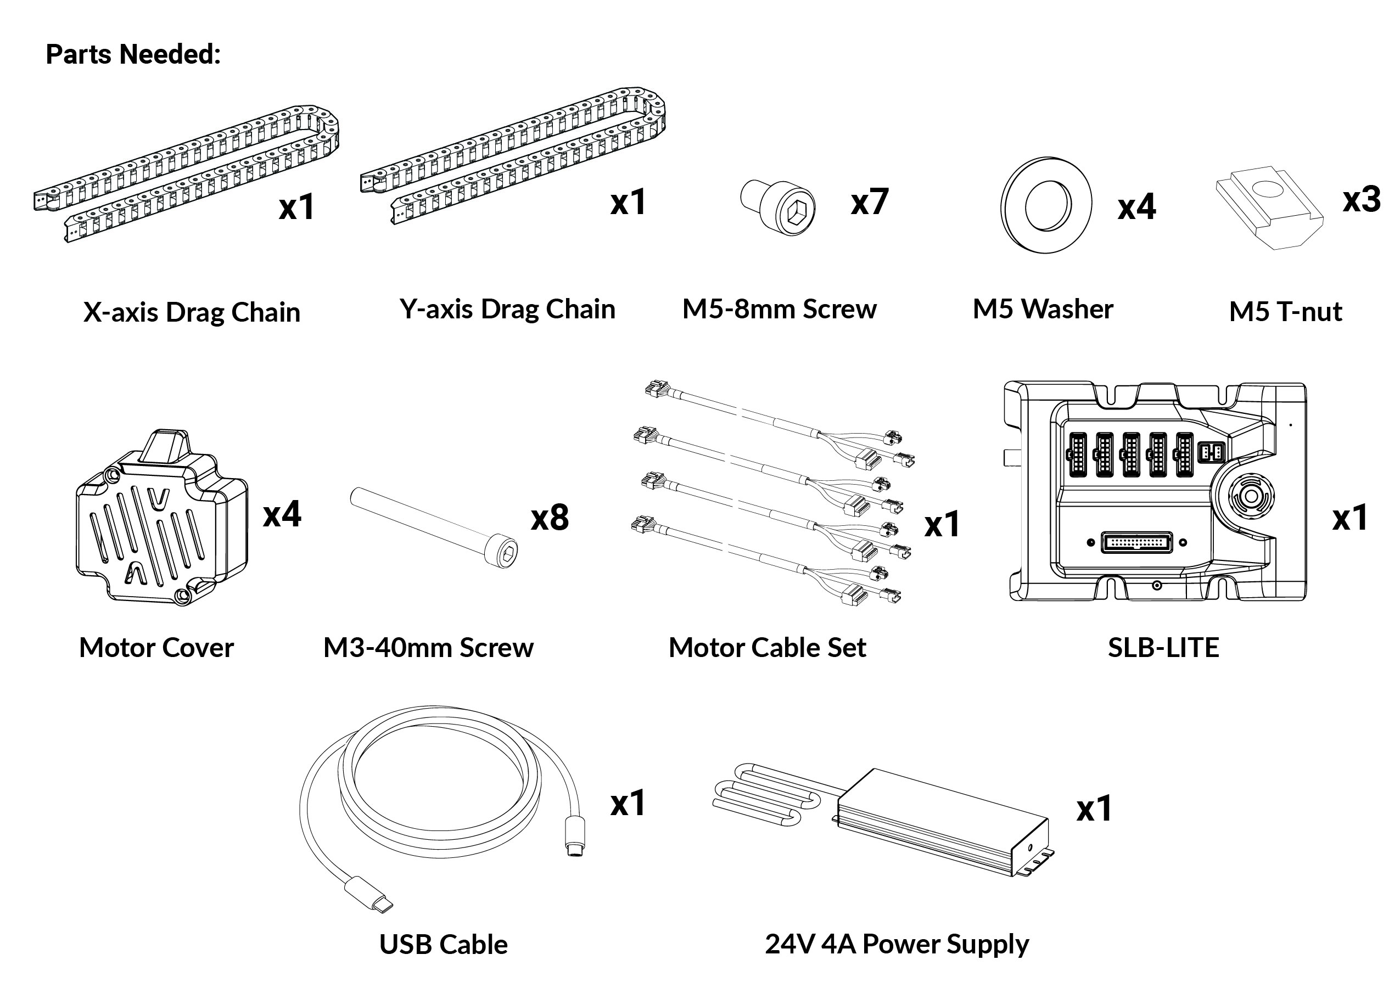
[picture p500: _images/_lmmk3/_assembly/lmk3_dragchain-partsneededv3.jpg]


1. Sort through your drag chains. You may have two (2) drag chain segments for the same axis, which means they need to be attached together to form one continuous drag chain. In total, you should have **two continuous drag chains**, one for X-axis and one for Y-axis.

    💡 If you forget which drag chains are for what axis, look at the number stamped on the drag chain.

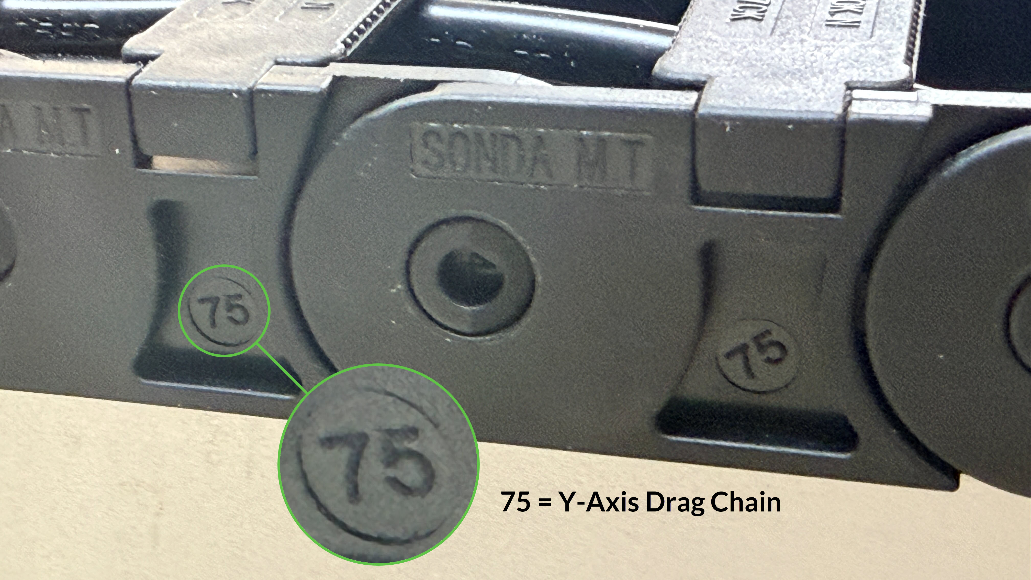
[picture p501: _images/_lmmk3/_assembly/lmk3_assembly_xy_axes-75y.jpg]
    

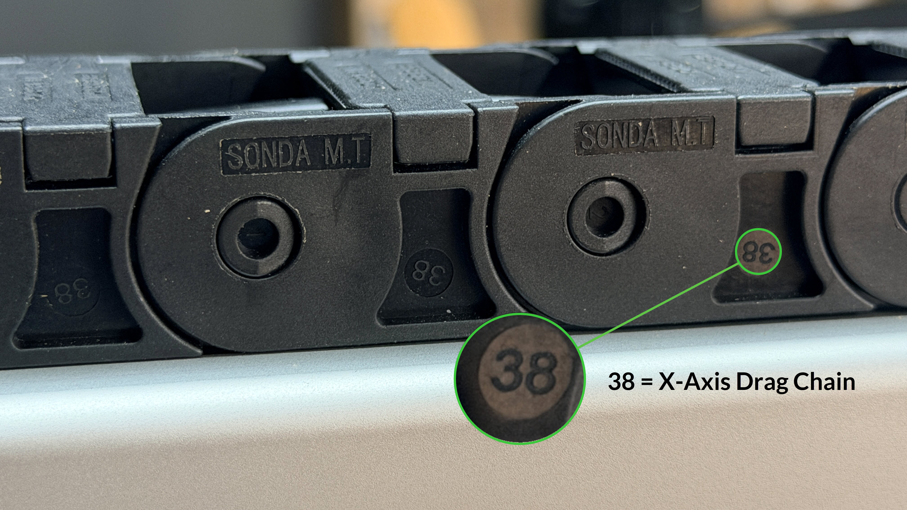
[picture p502: _images/_lmmk3/_assembly/lmk3_assembly_xy_axes-38x.jpg]
    

1. Take off the drag chain **end links** using a flat head screwdriver. There should be four (4) total, two (2) with studs and two (2) with holes at the tabs.

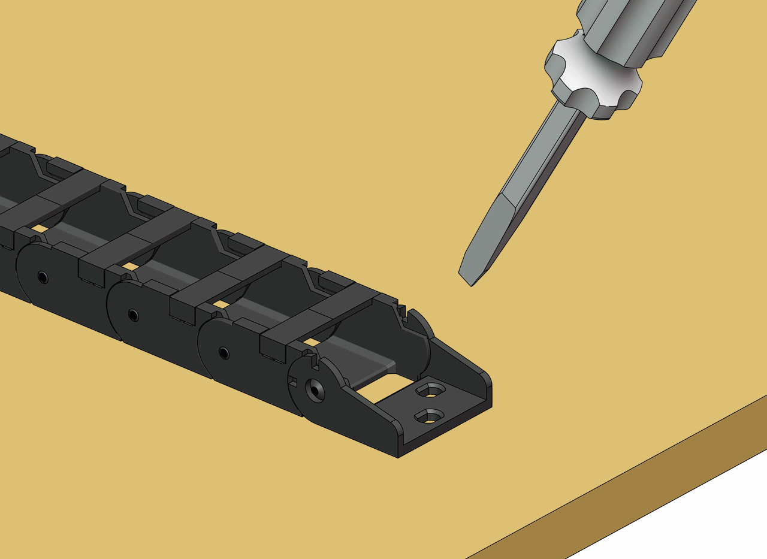
[picture p503: _images/_lmmk3/_assembly/_xy_axes/lmk3_dragchain-endclip.gif]
    

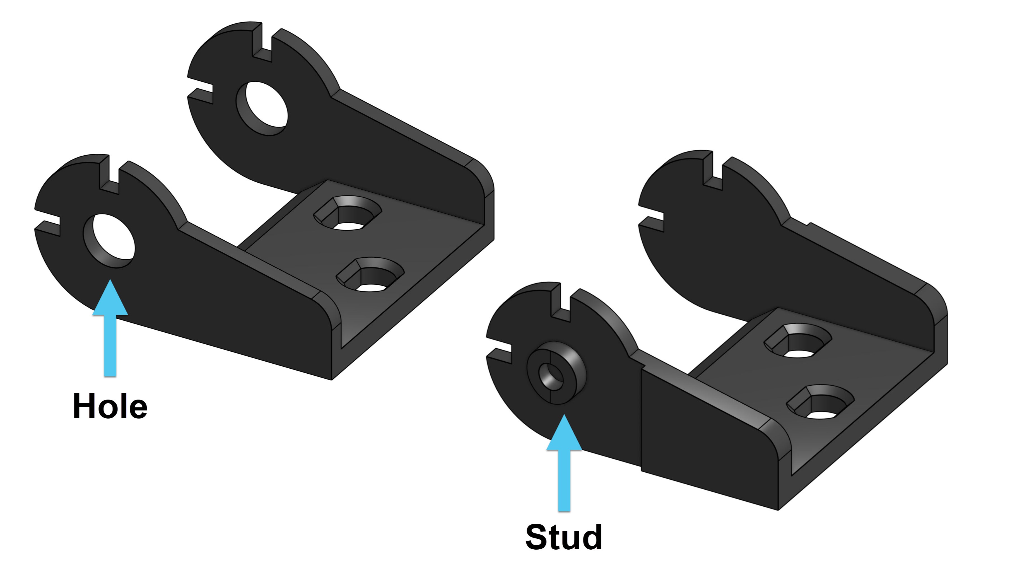
[picture p504: _images/_lmmk3/_assembly/_xy_axes/lmk3_dragchain-ends.jpg]
    

1. For the X-axis drag chain, if you have the 30x30, **remove** 7 links using a flathead screwdriver.

1. Assemble the drag chain ends with fasteners onto the machine, matching the orientation shown in the images. The fasteners should be hand tight, **do not overtighten** or the end links could break.

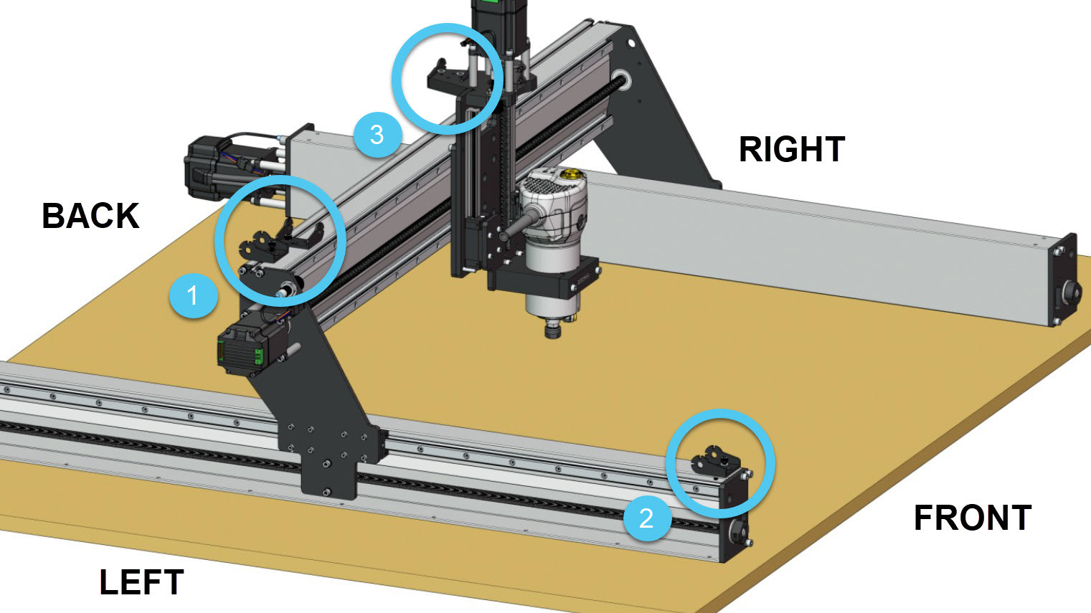
[picture p505: _images/_lmmk3/_assembly/_xy_axes/lmk3_dragchain-render23v2.jpg]
    

    **Left side of X-axis**:
    - Two (2) end links with holes
    - Three (3) M5-8mm screws and three (3) M5 T-nuts

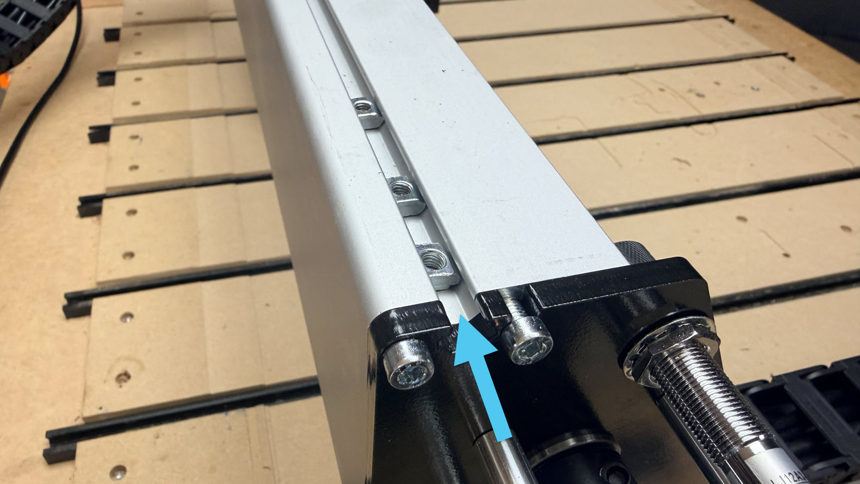
[picture p506: _images/_lmmk3/_assembly/lmk3_assembly_xy_axes-nutsintorail.jpg]
    

    - T-nuts should be inserted with the smaller face inside the T-slot
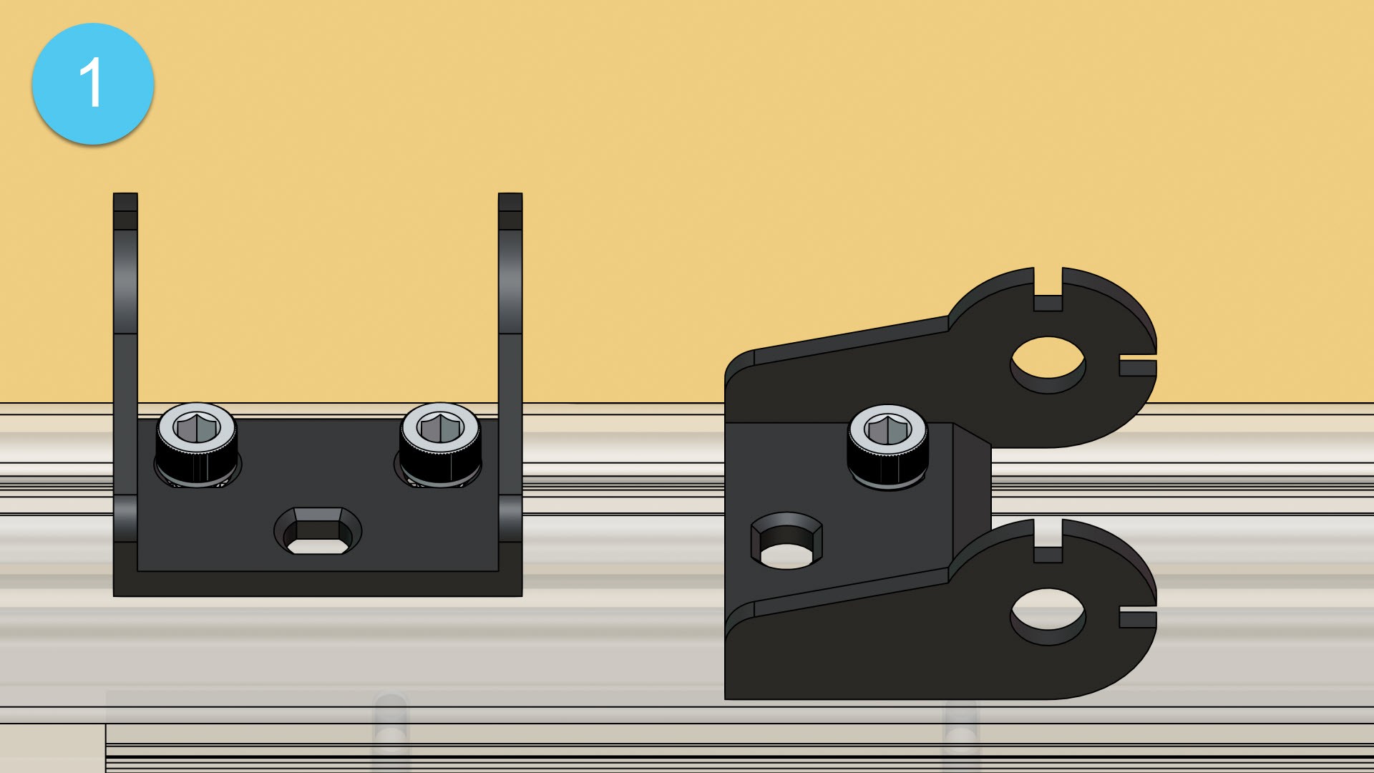
[picture p507: _images/_lmmk3/_assembly/_xy_axes/lmk3_dragchain-render-14v2.jpg]
    

    **Left Y-axis, front of machine**:
    - One (1) end link with studs
    - Two (2) M5-8mm screws, and two (2) M5 washers under the screw head
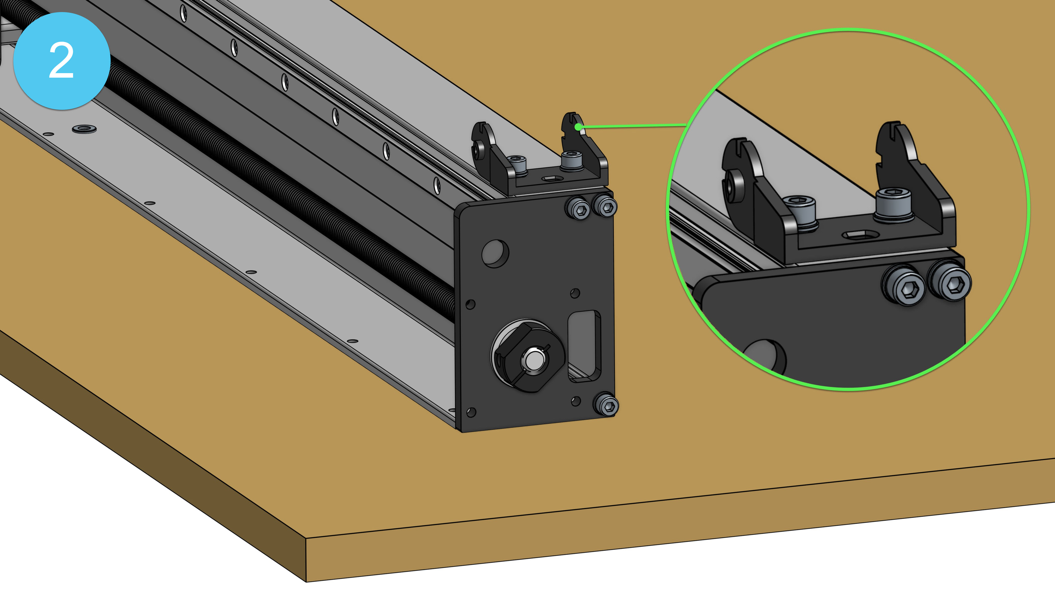
[picture p508: _images/_lmmk3/_assembly/_xy_axes/lmk3_dragchain-frontv2.jpg]
    

    **Z motor mount, back of Z-axis**:
    - One (1) end link with studs
    - Two (2) M5-8mm screws, and two (2) M5 washers under the screw head
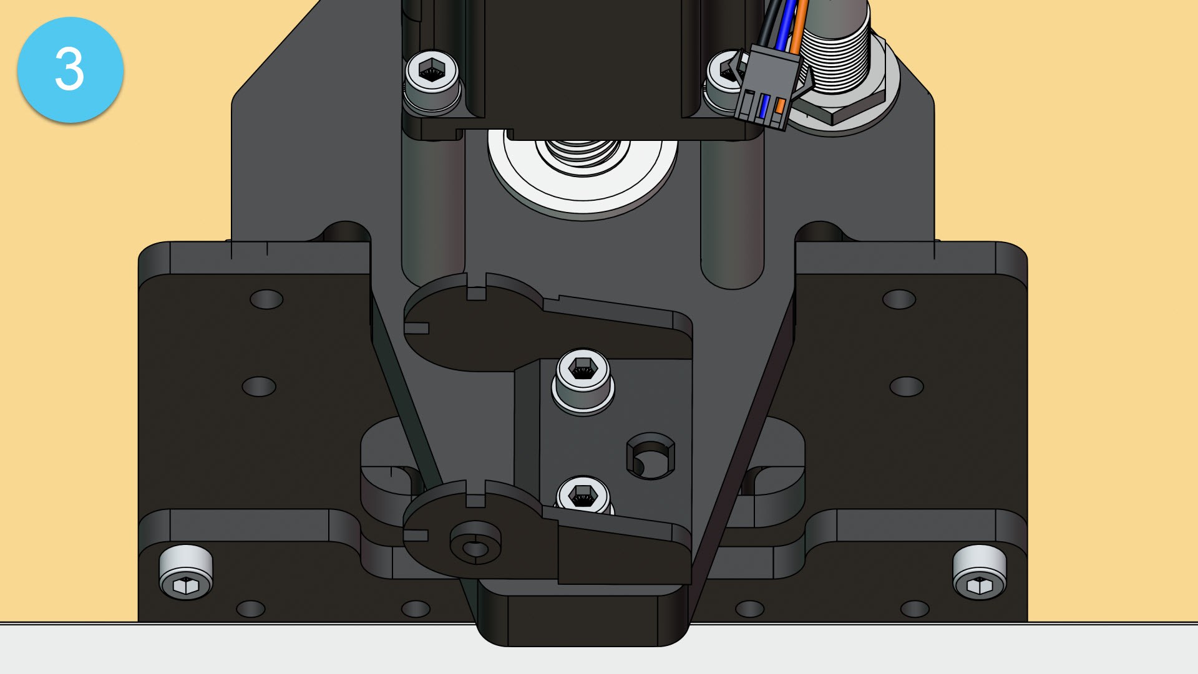
[picture p509: _images/_lmmk3/_assembly/_xy_axes/lmk3_dragchain-render-16v2.jpg]
    

1. **Open** all the clips on both drag chains, using a flathead screwdriver.

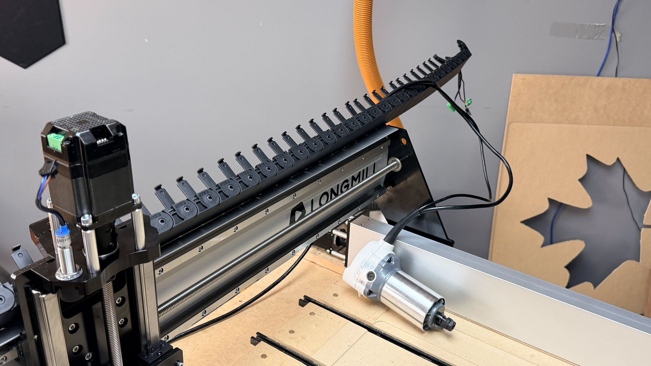
[picture p510: _images/_lmmk3/_assembly/lmk3_assembly_xy_axes-dragchain-open.jpg]
    

1. Grab the motor cables, and notice the labelling - there should be one motor cable for each axis. 

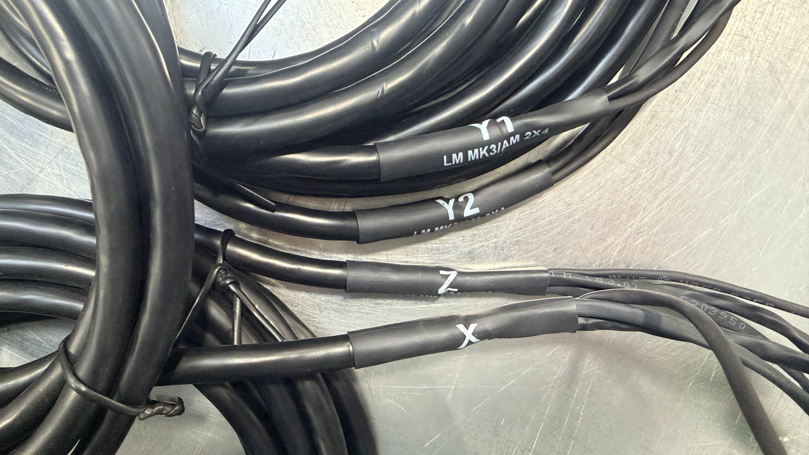
[picture p511: _images/_lmmk3/_assembly/lmk3_assembly_xy_axes-cablelabels.jpg]
    

1. Secure the connections for the limit switch, motor power, and motor signal connectors. Repeat for all four (4) motors.

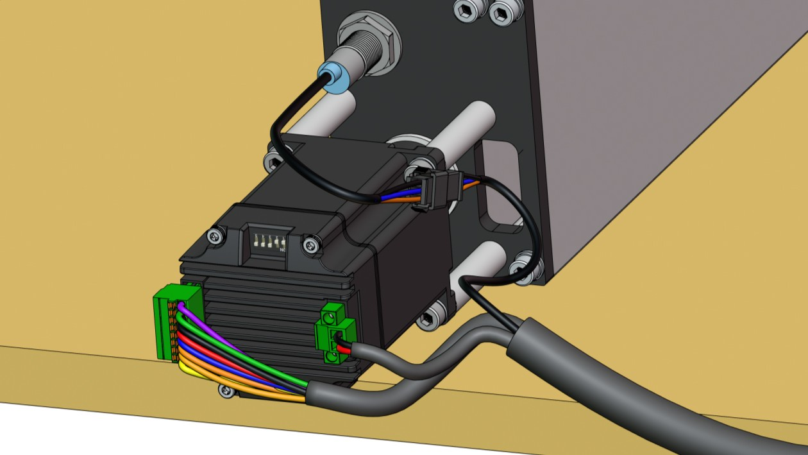
[picture p512: _images/_lmmk3/_assembly/_xy_axes/lmk3_dragchain-render-19A.jpg]
    

1. Check that all motor DIP switches are in the correct positions: **1-OFF 2-OFF 3-ON 4-ON 5-ON**

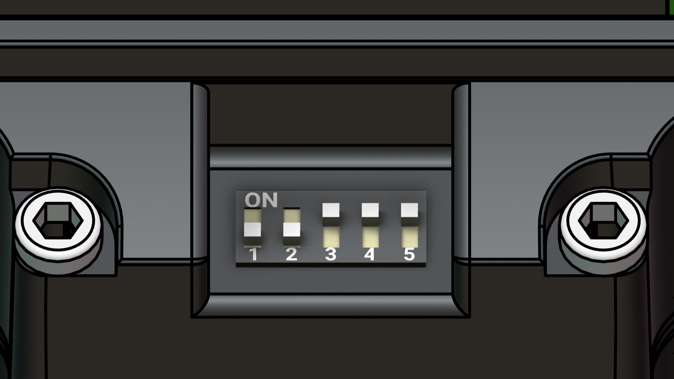
[picture p513: _images/_lmmk3/_assembly/_xy_axes/lmk3_dragchain-render-19.jpg]
    

1. Place the X-axis drag chain onto the X rail.

1. Route the router cables (power and signal for AutoSpin), and the Z motor cable. Attach the drag chain at the **Z motor mount**, to help stop the drag chain from moving around. 

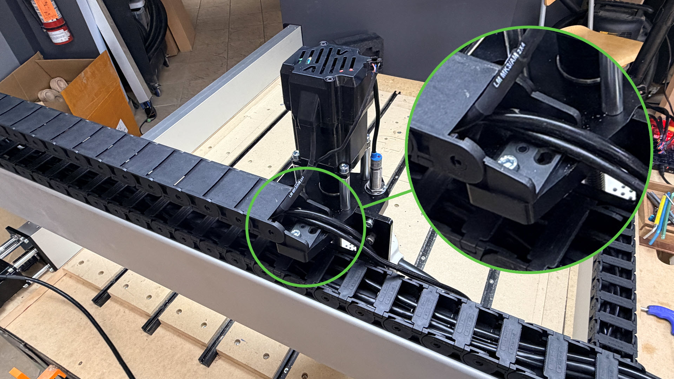
[picture p514: _images/_lmmk3/_assembly/lmk3_assembly_xy_axes-zaxis-endlink.jpg]
    

1. As you run the cables through, close the clips. Then secure the other end of the drag chain at the **X-axis**.

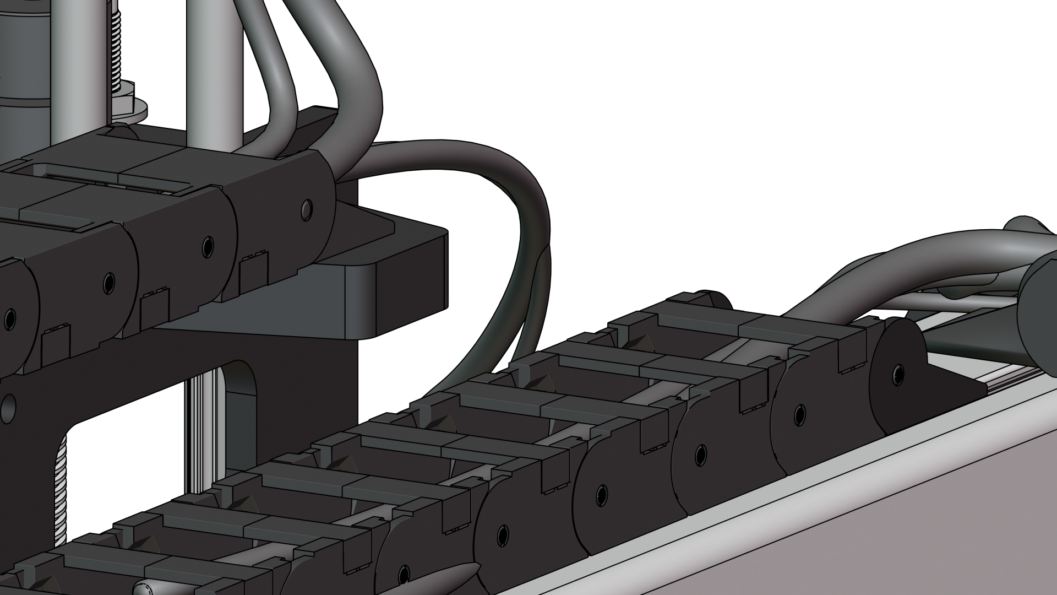
[picture p515: _images/_lmmk3/_assembly/_xy_axes/lmk3_dragchain-render17b.jpg]
    

1. We will now move onto the **Y-axis drag chain.**

1. Route the cables from the X drag chain, and the X motor cable. Attach the drag chain at the **X-axis**, then continue running the cables. As you do this, close the clips. Then secure the other end of the drag chain at the **front left** of the machine.

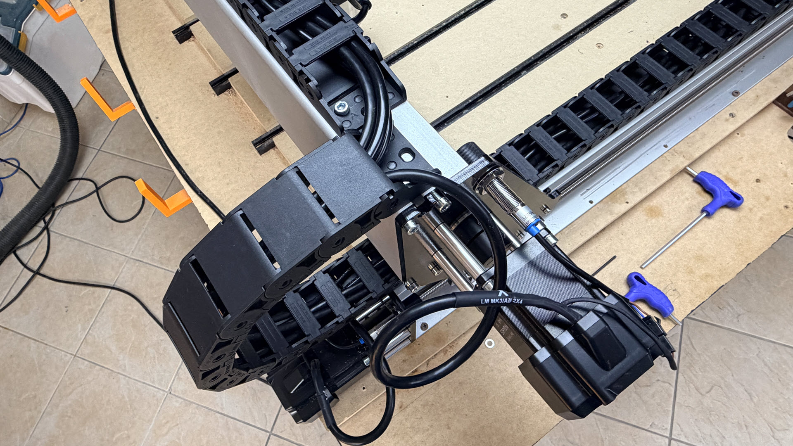
[picture p516: _images/_lmmk3/_assembly/lmk3_assembly_xy_axes-yaxis-wiring.jpg]
    

1. Grab the Y1 and Y2 motor cables. Make note:
    - Y2 cable -> Right motor
    - Y1 cable -> Left motor

1. Route the Y1 and Y2 cables through the left Y-axis extrusion, making sure that the green connectors can reach the correct motor. Use needle nose pliers to grab the black connectors from the front.

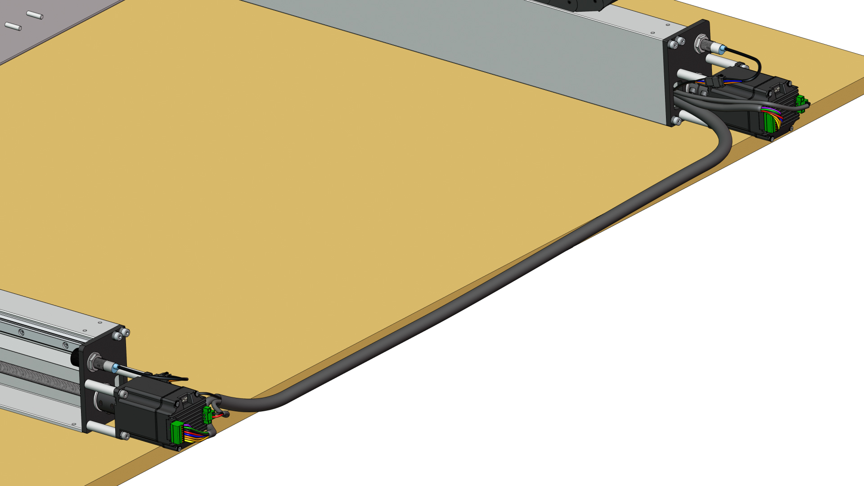
[picture p517: _images/_lmmk3/_assembly/_xy_axes/lmk3_dragchain-render_18_B.jpg]
    

1. Grab a motor cover and orient it so the **small opening is facing either up or down**. Identify the two (2) holes on the motor cover and compare it to the screw location on each motor - these holes will be used to mount the motor cover onto the motor. 

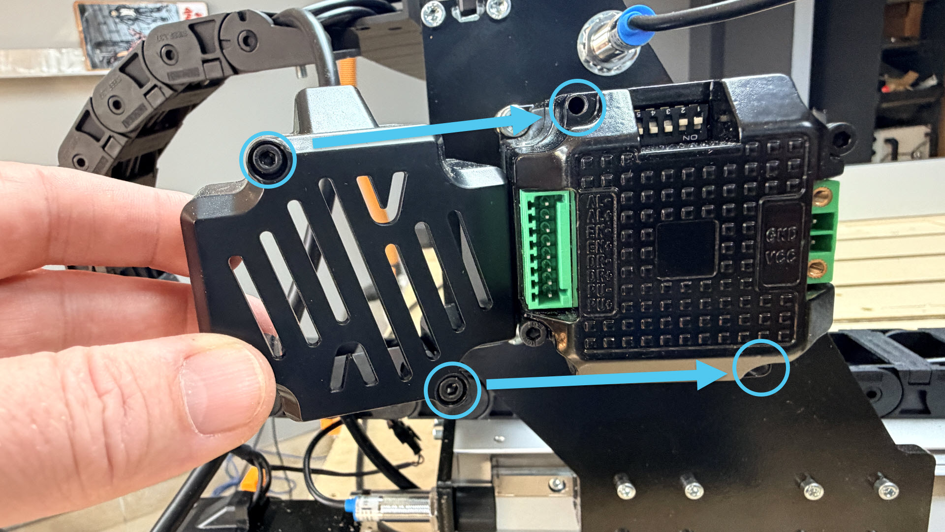
[picture p518: _images/_lmmk3/_assembly/lmk3_assembly_xy_axes-motorcover.jpg]
    

1. On the motors, **remove the two (2) screws** using an Allen key.

    Then place the motor covers on all four (4) motors. Route the wires through the opening, to prevent damage. Then secure motors covers with two (2) M3-40mm screws.

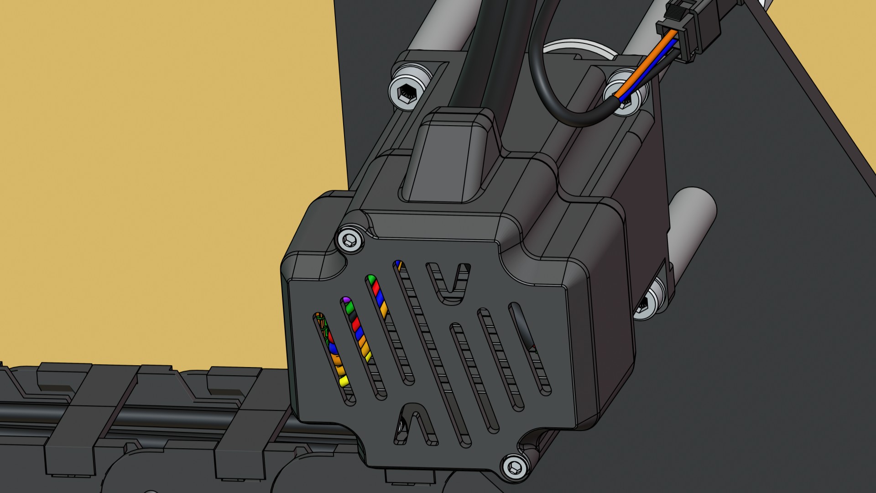
[picture p519: _images/_lmmk3/_assembly/_xy_axes/lmk3_dragchain-render-20.jpg]
    

1. Place the SLB-LITE onto the table, at the front-left corner. You may need to push the machine closer to the right side to do this.

1. Connect the motor cable connectors for each axis as indicated on the SLB-EXT.

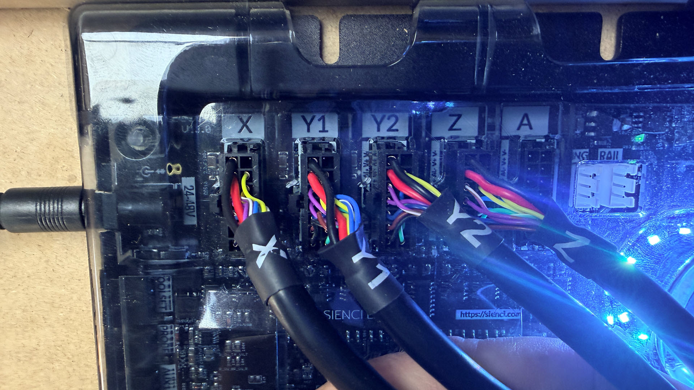
[picture p520: _images/_lmmk3/_assembly/lmk3_assembly_xy_axes-slbplugs.jpg]
    

1. Plug the USB cable into the SLB-LITE, at the USB port.

1. Plug the power supply into the SLB-LITE, at the POWER port. Then plug the power supply into wall power (120V). We recommend putting your router into a separate circuit from the controller and computer.

1. On the AutoSpin, untwist the cable with the green connector.

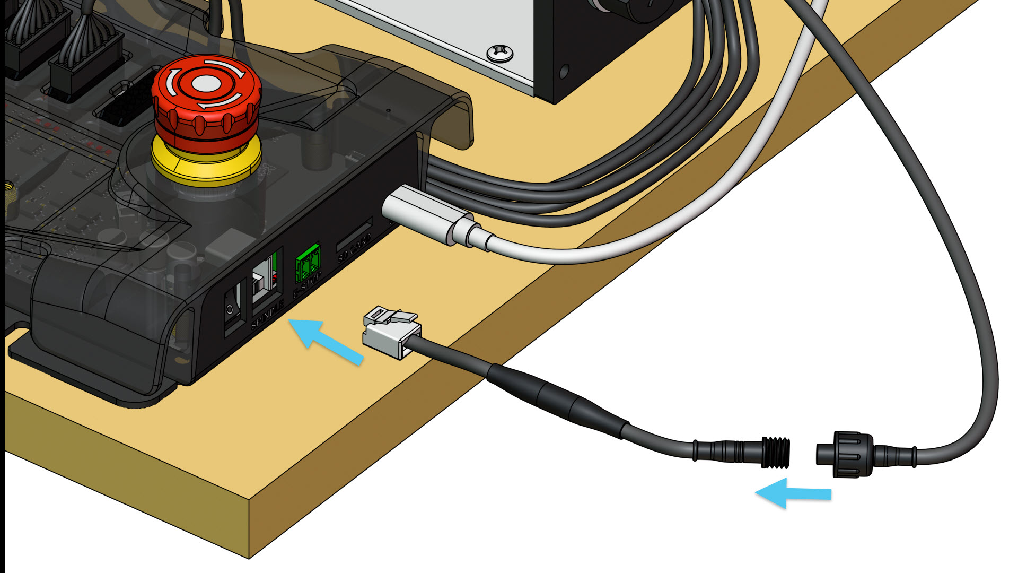
[picture p521: _images/_lmmk3/_assembly/_xy_axes/lmk3_xy_axes-render_29.jpg]
    

1. Grab the adapter cable with the ethernet connector, and twist it onto the AutoSpin Plug the ethernet connector end into the SLB-LITE, at the SPINDLE port. Then connect the power plug end into wall power, and plug the USB cable into your computer.

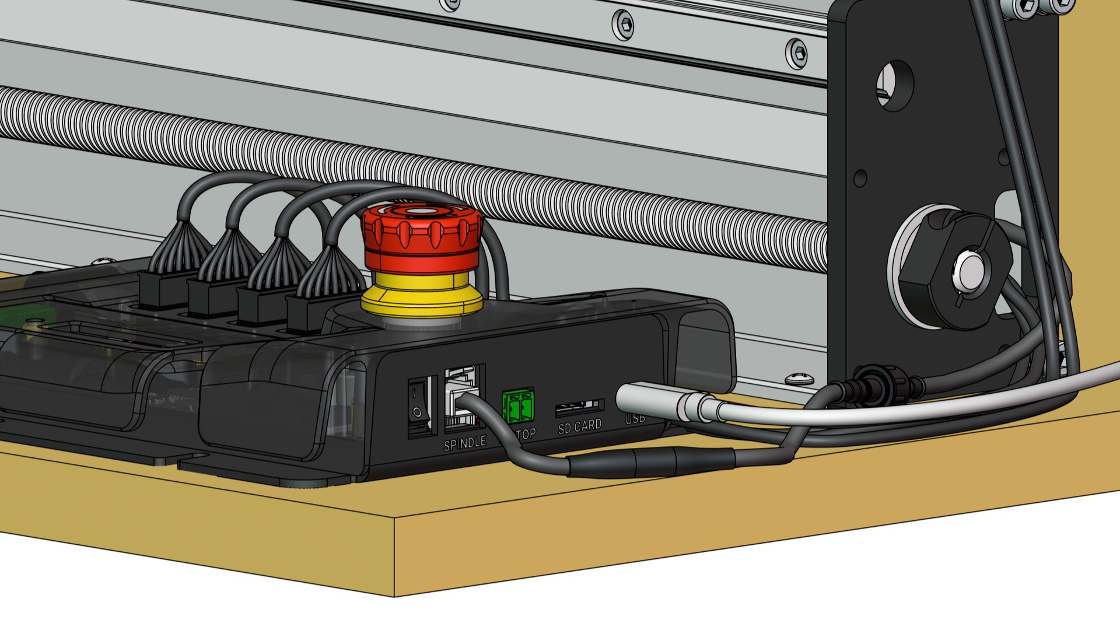
[picture p522: _images/_lmmk3/_assembly/_xy_axes/lmk3_dragchain-render-22.jpg]
    

Great work! The hardest part of assembly is now completed.
