Sienci-Labs/Resources/lmmk3/lmk3-assembly/lmk3-unboxing.md

---
title: 1. MK3 Unboxing 📦
menu_order: 2
post_status: publish
post_excerpt: Start building your LongMill MK2 CNC. You will find detailed assembly steps and videos here.
post_date: 2026-05-20 10:38:11
taxonomy:
    knowledgebase_cat: lmk3-assembly
    knowledgebase_tag:
custom_fields:
    KBName: LongMill MK3
    basepress_post_icon: bp-caret-right
skip_file: no
featured_image: _images/post-image.jpg
---

## MK3 Unboxing

https://www.youtube.com/watch?v=s1ihVgx0hLY

### X-axis Box

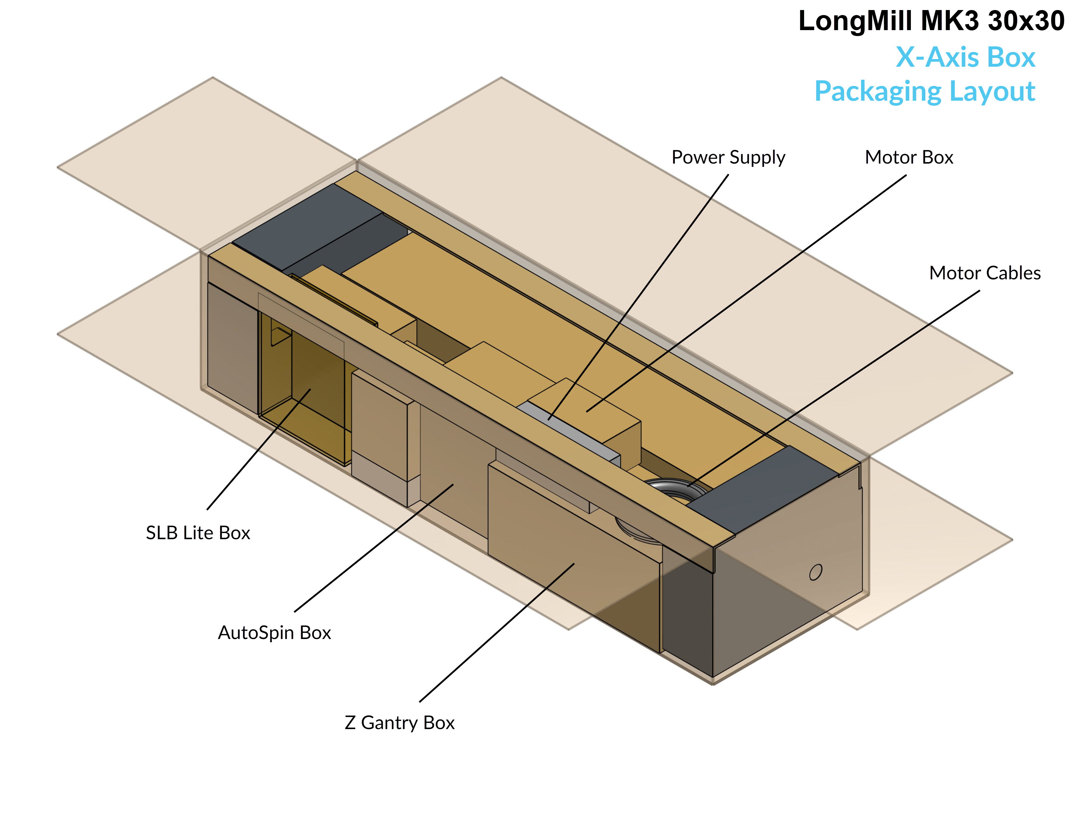
[picture p523: _images/_lmmk3/_assembly/_unboxing/lmk3_unboxing-30-x-axis-box-v3.jpg]


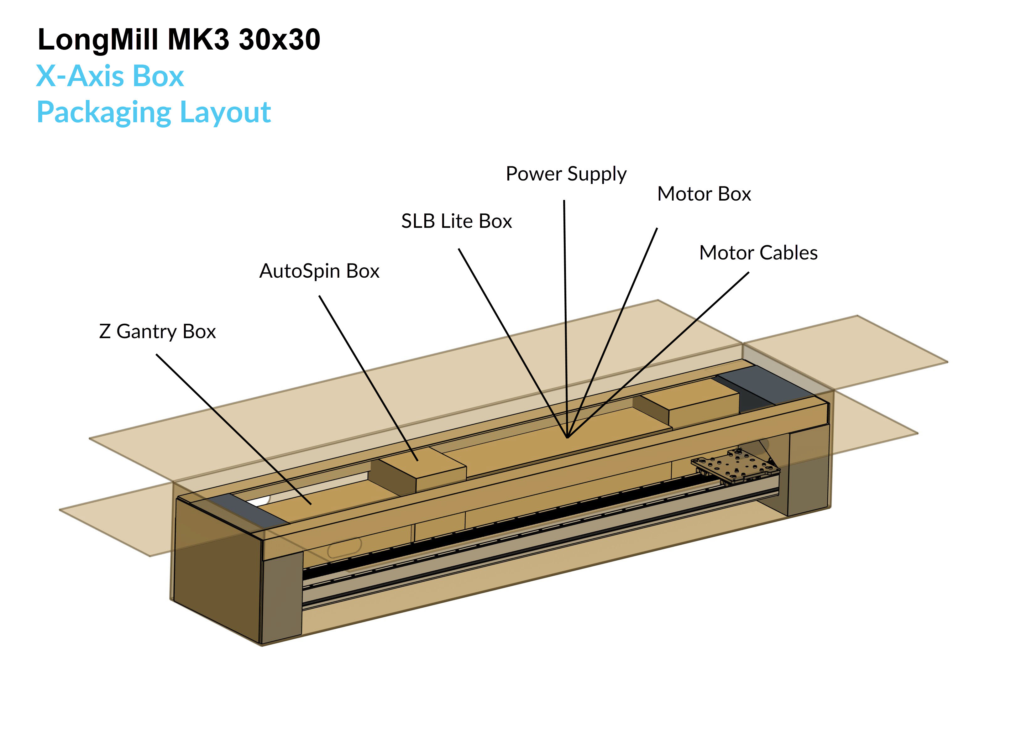
[picture p524: _images/_lmmk3/_assembly/_unboxing/lmk3_unboxing-48-x-axis-box_v3.jpg]


- 1x X-axis Assembly
- 1x Y-axis Drag Chain
- 1x X-axis Drag Chain
- **1x Z-axis Box**
  - 1x Z-axis Assembly
  - 1x Motor Covers Set with M3-40mm Screws
  - 1x 65mm Router Mount
- 1x 24V 4A Power Supply
- 1x SLB-LITE Kit with USB cable
- 1x 1.2Nm Closed Loop Motor
- 1x Motor Cable Set
- **1x Hardware Box**
  - M5-8mm Screws
  - M5-12mm Screws
  - M5-25mm Screws
  - M5-50mm Screws
  - M4-12mm Screws
  - 3/4” Wood Screws
  - M5 T-nuts
  - M5 Washers
  - 4x Aluminum Standoff
  - 1x Inductive Sensor
  - 2x Integrated Bump Stop (1 extra)
  - 1x LongMill MK3 wrench
  - 1x 4mm Allen Key
  - 1x 3mm Allen Key
  - 1x 2.5mm Allen Key
- 1x AutoSpin T1 Router (Beginner’s Kit only)
- 1x MK3 Dust Shoe (Beginner’s Kit only)
- 1x AutoZero Touch Plate (Beginner’s Kit only)
- 1x Starter End Mill Set (Beginner’s Kit only)

### Y-axis Box

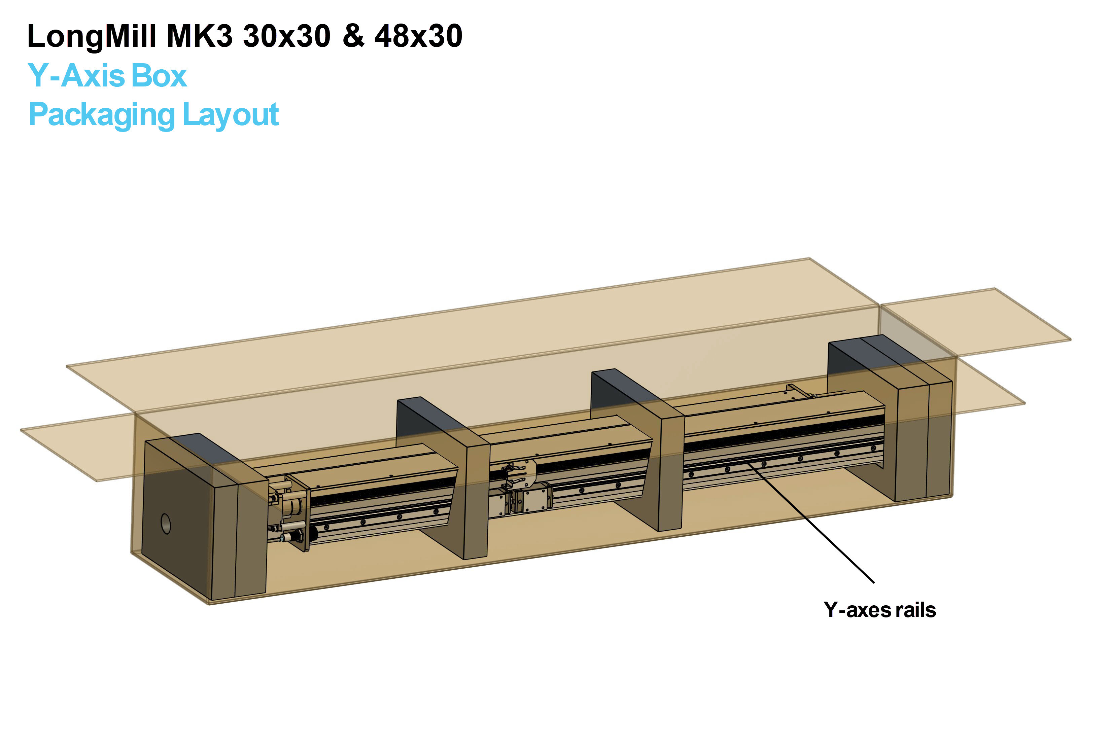
[picture p525: _images/_lmmk3/_assembly/_unboxing/lmk3_unboxing-y-axis-boxv4.jpg]


- 1x Left Y-axis Assembly
- 1x Right Y-axis Assembly
