Sienci-Labs/Resources/lmmk3/lmk3-assembly/lmk3-x-and-y-axes.md

---
title: 2. X & Y-Axes
menu_order: 3
post_status: publish
post_excerpt: 
post_date: 2026-05-20 10:54:44
taxonomy:
    knowledgebase_cat: lmk3-assembly
    knowledgebase_tag:
custom_fields:
    KBName: LongMill MK3
    basepress_post_icon: bp-caret-right
skip_file: no
featured_image: _images/post-image.jpg
---
## X and Y-axes

https://www.youtube.com/watch?v=62zib7Jisic

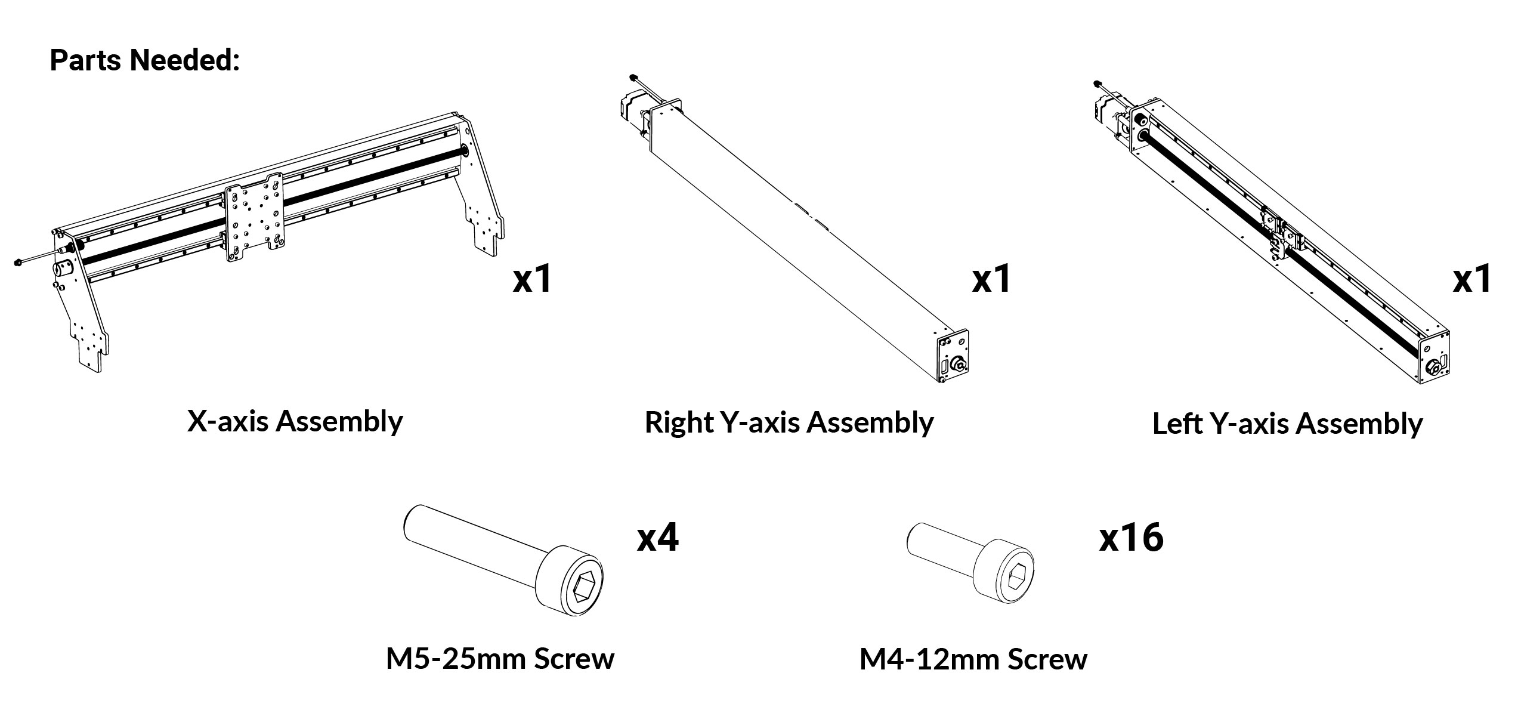
[picture p526: _images/_lmmk3/_assembly/lmk3_xy-partsneeded.jpg]


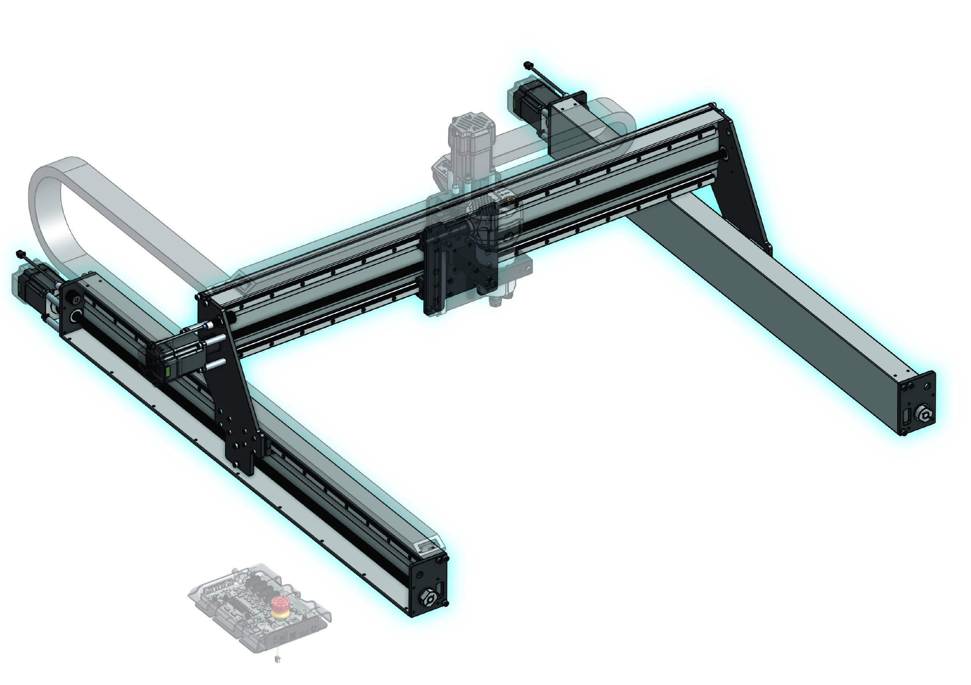
[picture p527: _images/_lmmk3/_assembly/lmk3_xy-header.jpg]


1. Take out the two (2) Y-axis assemblies. The goal is to get the white anti-backlash nuts to the same position on each Y-axis. To adjust the anti-backlash nut: rotate the black clamping nuts at the front Y plates. Then slide the black linear guide blocks above the white anti-backlash nut.

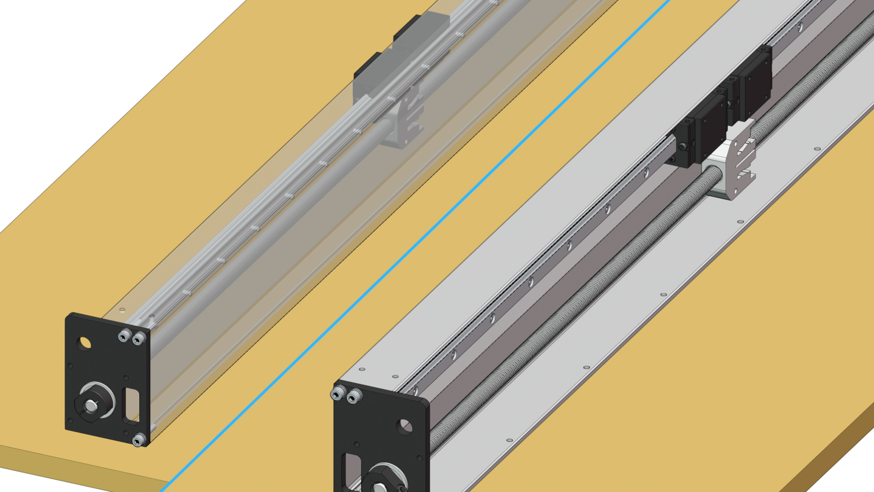
[picture p528: _images/_lmmk3/_assembly/_xy_axes/lmk3_xy_axes-render_03_C.jpg]
    

1. Identify between the **left and right** assemblies. Orient them onto your 4’x4’x3/4” MDF sheet, on top of your table, so that:

    - Lead screws face outwards
    - Motors face the back of table

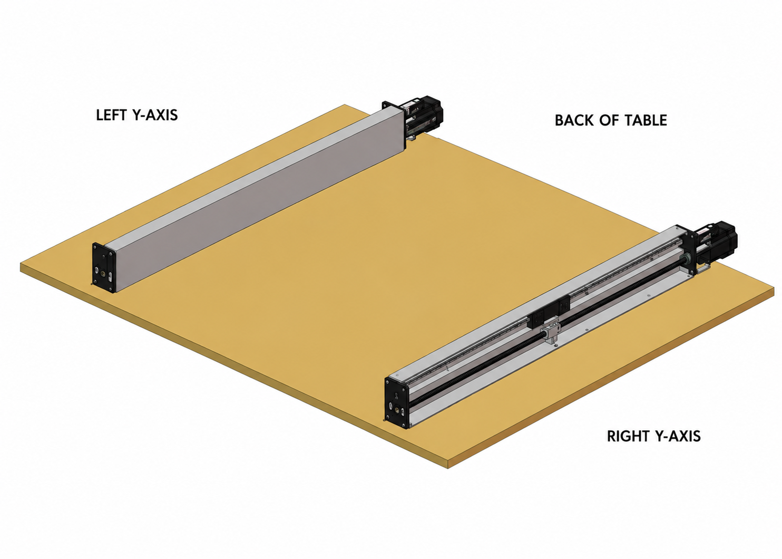
[picture p529: _images/_lmmk3/_assembly/_xy_axes/lmk3_xy_axes-tworailsv2.png]
    

1. On one of the Y-axes, loosely secure two (2) M4-12mm screws into the bottom holes of the linear guide blocks.

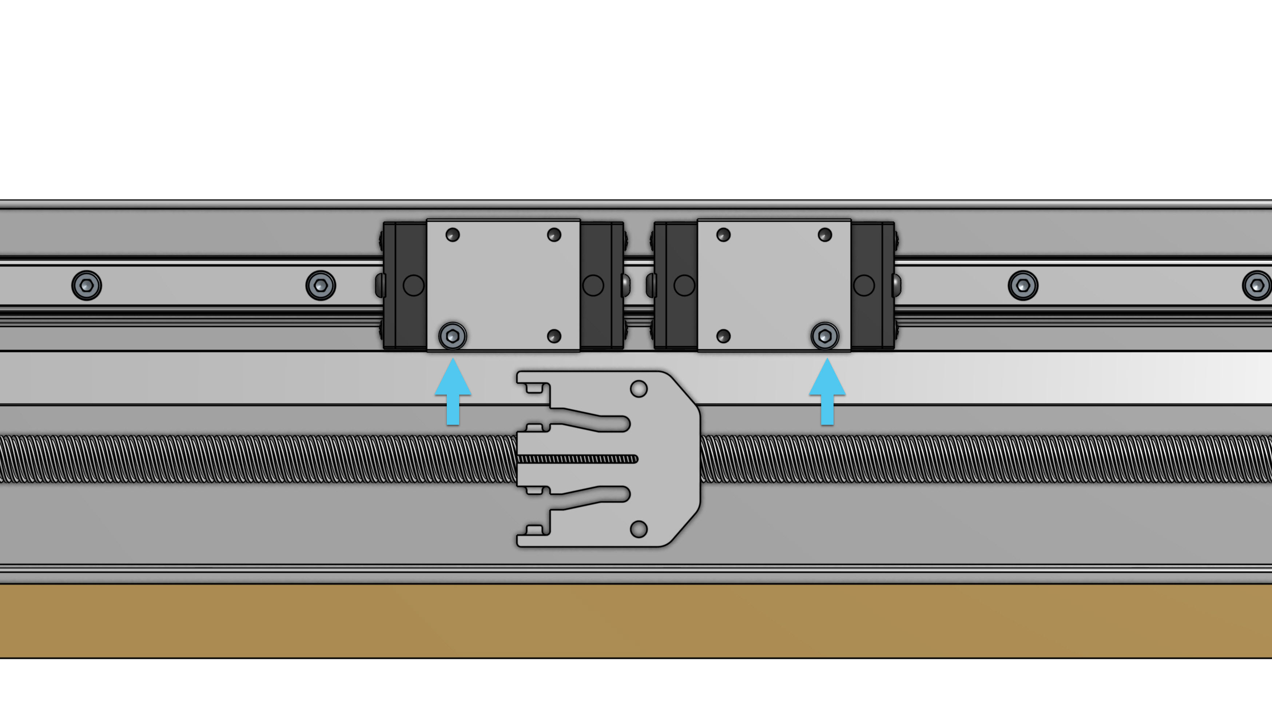
[picture p530: _images/_lmmk3/_assembly/_xy_axes/lmk3_xy_axes-render05.jpg]
    

1. Grab a friend, OR take out the Y gantry packing foam. If using the foam: cut a rectangle in the Y gantry packaging foam (outlined in red).

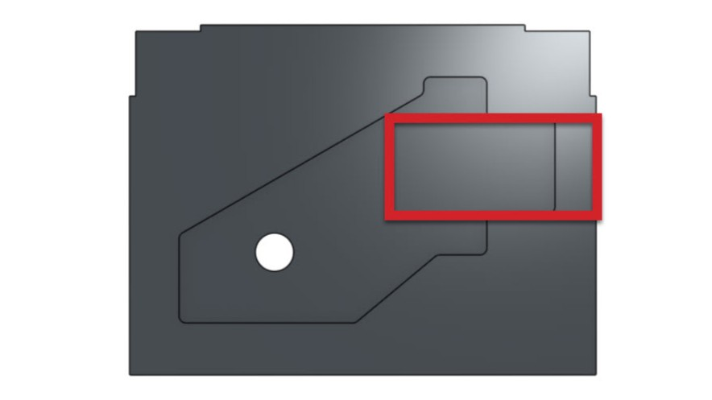
[picture p531: _images/_lmmk3/_assembly/_xy_axes/lmk3_xy_axes-cutfoam.jpg]
    

1. Have your friend or foam support the X-axis rail. Place the X-axis assembly onto the Y-axis gantry at the notches, anchoring onto the M4-12mm screws.

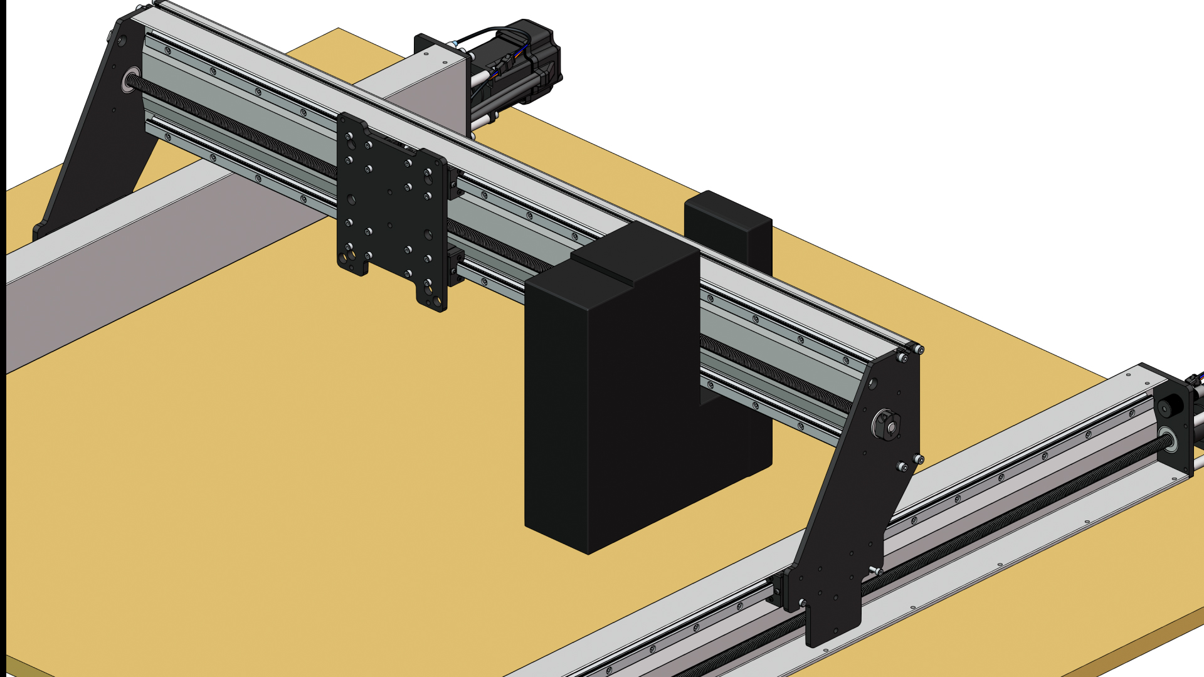
[picture p532: _images/_lmmk3/_assembly/_xy_axes/lmk3_xy_axes-render_04_A.jpg]
    

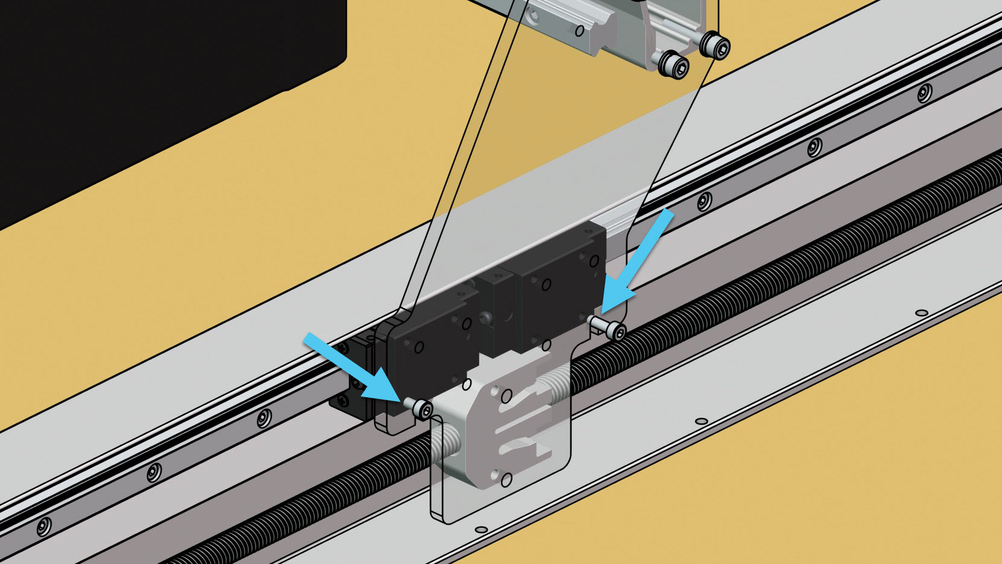
[picture p533: _images/_lmmk3/_assembly/_xy_axes/lmk3_xy_axes-render_04_C1.jpg]
    

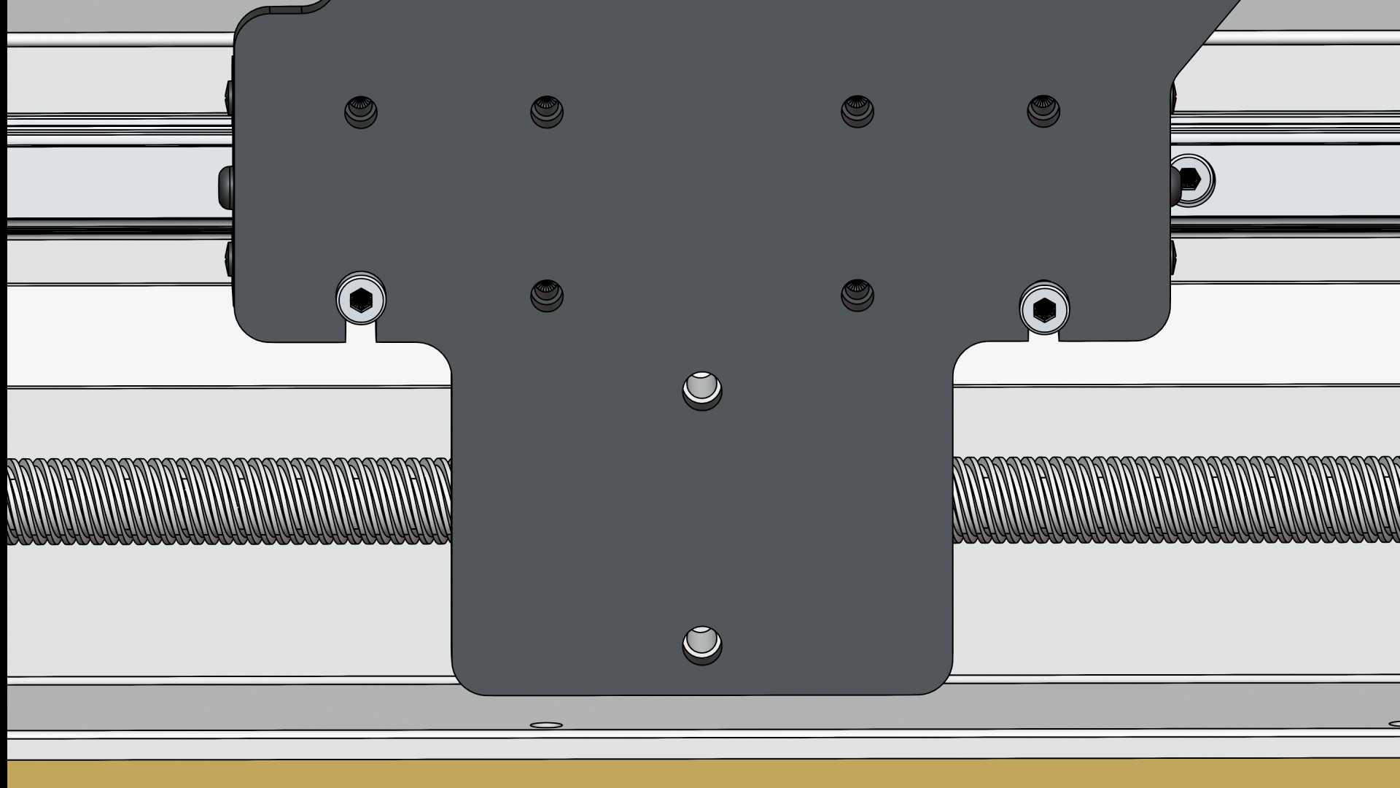
[picture p534: _images/_lmmk3/_assembly/_xy_axes/lmk3_xy_axes-render_06.jpg]
    

1. Finish securing the two (2) M4-12mm screws using an Allen key.

1. Secure the remaining M4-12mm screws onto the linear guide blocks in a diagonal pattern.
Then, secure the two (2) M5-25mm screws to connect the anti-backlash nut with the Y gantry. Only tighten until you feel resistance - do not overtorque these.

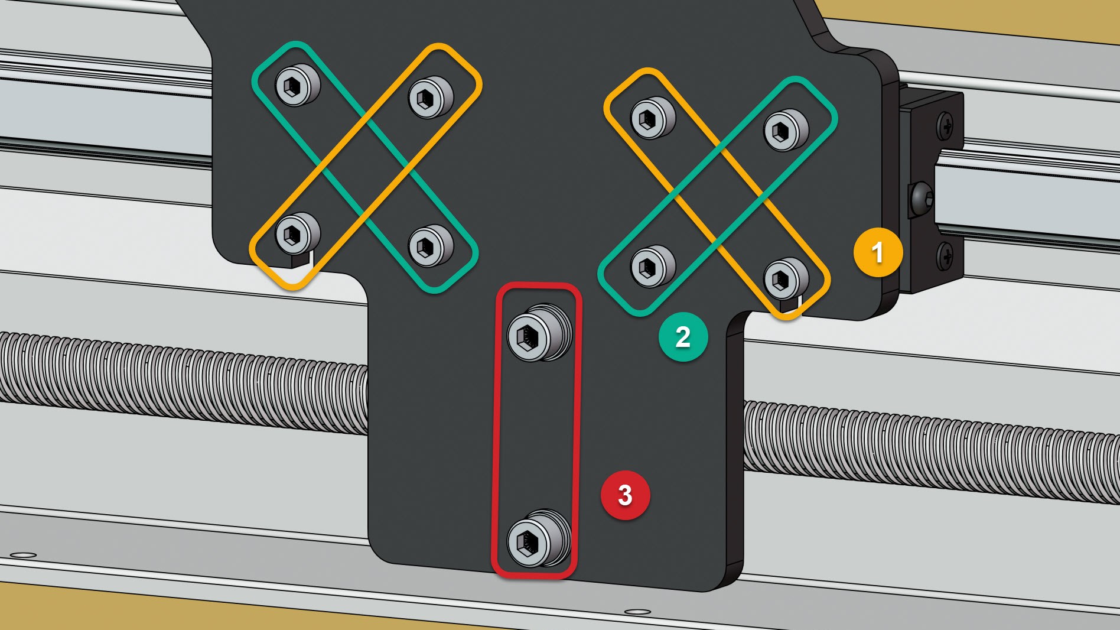
[picture p535: _images/_lmmk3/_assembly/_xy_axes/lmk3_xy_axes-gantryscrews.jpg]
    

1. Repeat securing the anti-backlash nut and linear guide blocks on the other side.

1. Remove the foam from under the X-axis assembly, if you used it.

### X-axis Motor

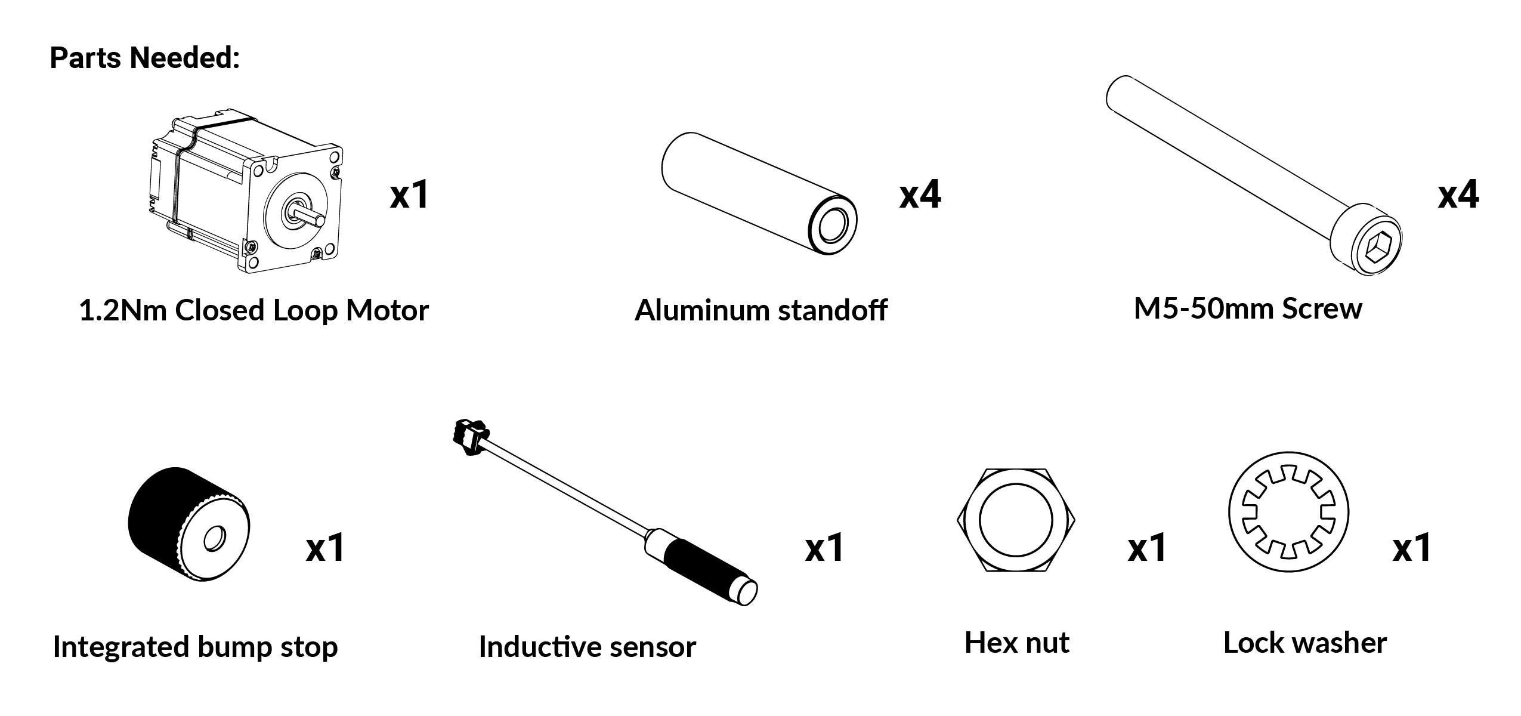
[picture p536: _images/_lmmk3/_assembly/lmk3_xmotor-partsneededv2.jpg]


1. Loosely insert the motor onto the X-axis coupler at the left side of the machine.

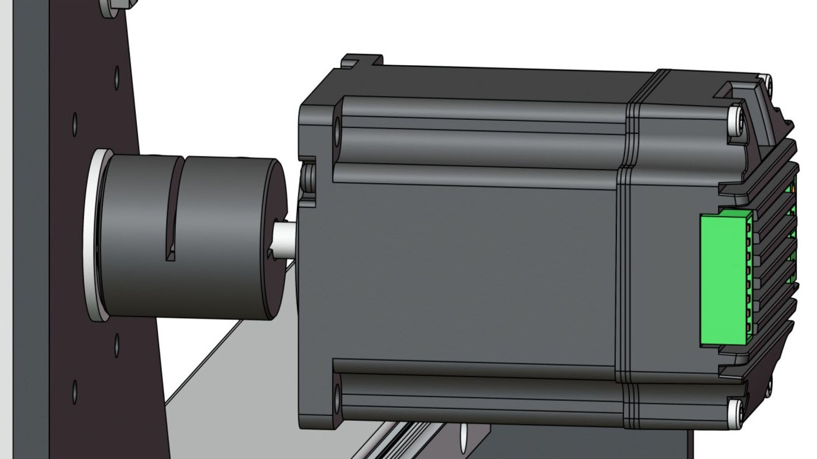
[picture p537: _images/_lmmk3/_assembly/_xy_axes/lmk3_xy_axes-motormount2.jpg]
    

1. Place one (1) standoff between the motor and Y gantry, then insert one (1) M5-50mm screw through the motor and the standoff, loosely fastening into the gantry. Repeat this for the remaining three (3) holes. Then fully secure all M5-50mm screws until snug.

1. Finally, tightly secure the coupler setscrews.

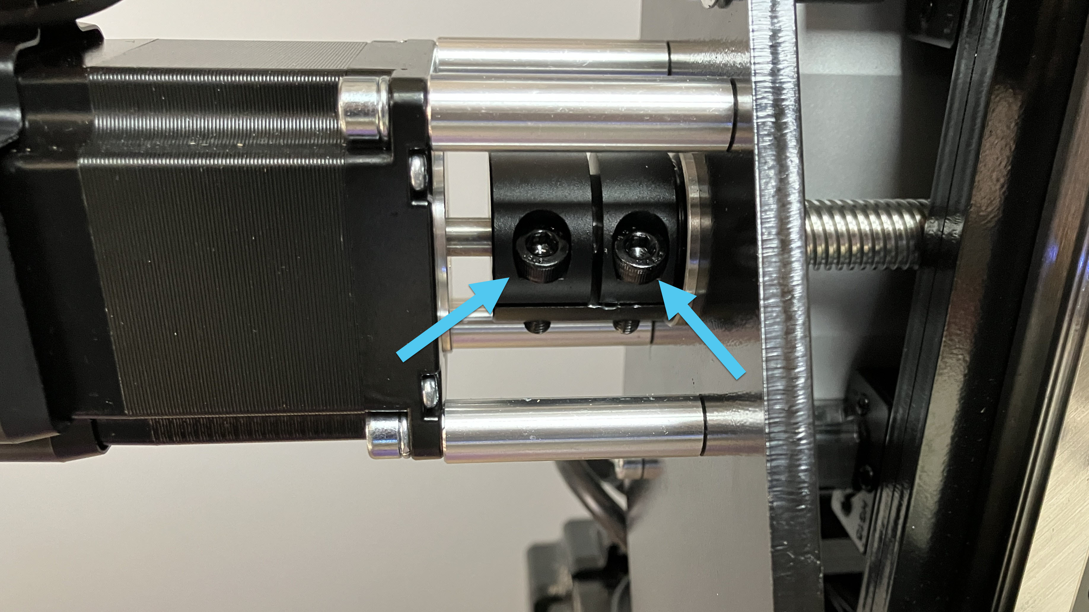
[picture p538: _images/_lmmk3/_assembly/_xy_axes/lmk3_xy_axes-coupler.jpg]
    

1. Prepare one inductive sensor by threading a **nut** onto it approximately 45mm / 1.5 inches from the front, and add a **lock washer** from the front. Pass this inductive sensor through the hole on the left Y-axis gantry plate, and thread the bump stop over the end of the sensor until it bottoms out. **Hand tighten until snug.**

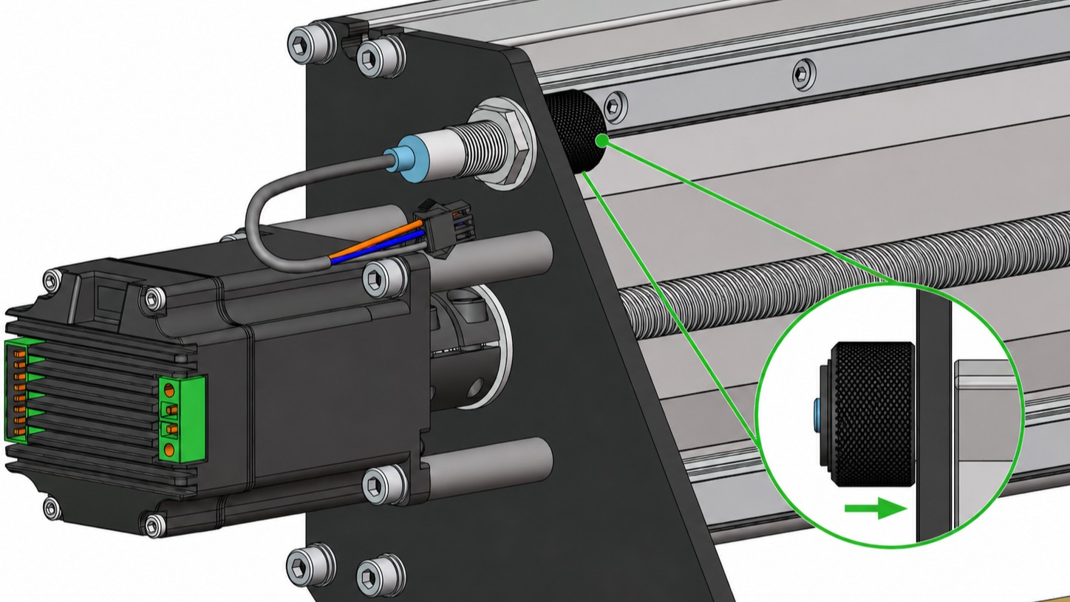
[picture p539: _images/_lmmk3/_assembly/_xy_axes/lmk3_xy_axes-bumpstop.jpg]
    

1. Secure the nut and lock washer against the gantry plate using the LongMill wrench.

        💡 Tip: If adjusting the motor, tighten the coupler first, then tighten down the motor standoffs.

Congrats on finishing up the first section of assembly! You are well on your way.
