Sienci-Labs/Resources/lmmk3/lmk3-assembly/lmk3-z-axis.md

---
title: 3. Z-axis
menu_order: 4
post_status: publish
post_excerpt: 
post_date: 2026-05-20 10:55:55
taxonomy:
    knowledgebase_cat: lmk3-assembly
    knowledgebase_tag:
custom_fields:
    KBName: LongMill MK3
    basepress_post_icon: bp-caret-right
skip_file: no
featured_image: _images/post-image.jpg
---
## Z-axis

https://www.youtube.com/watch?v=mkkfaaChz5k

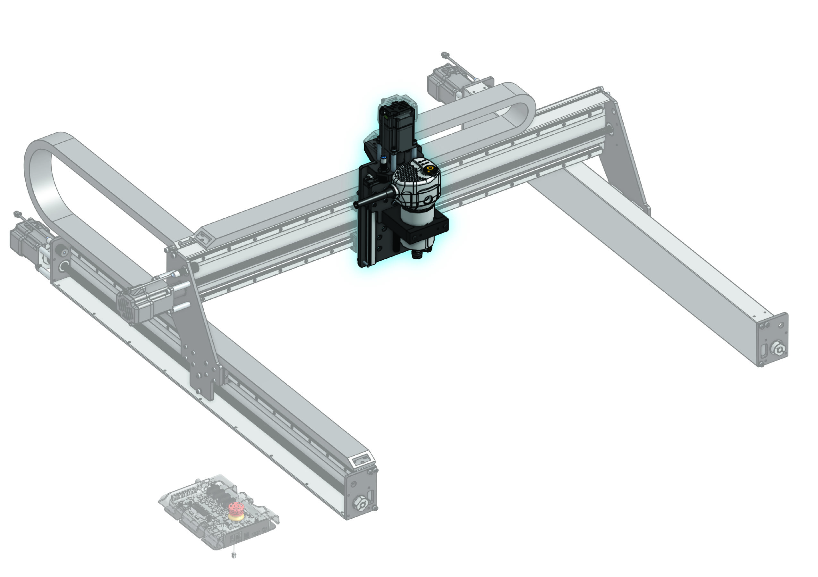
[picture p540: _images/_lmmk3/_assembly/lmk3_z-header.jpg]


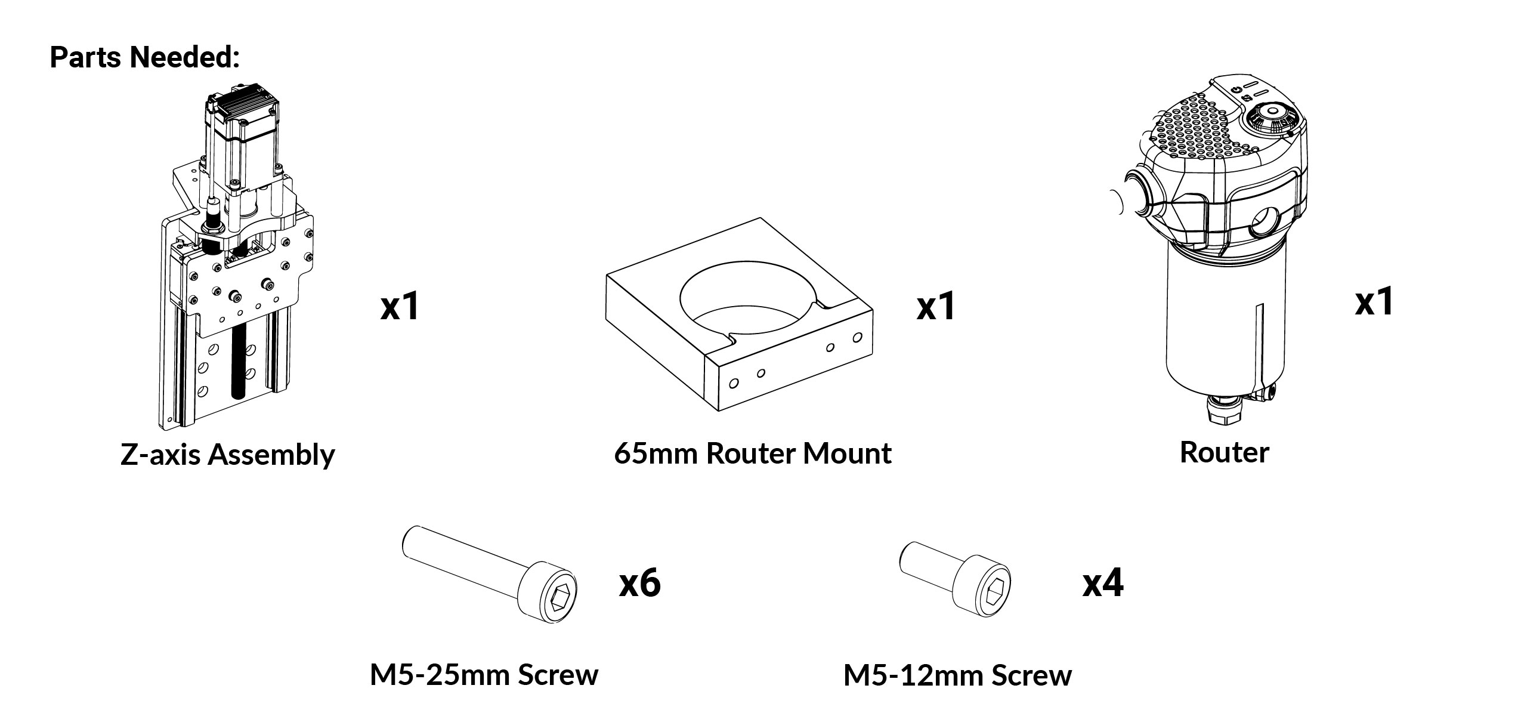
[picture p541: _images/_lmmk3/_assembly/lmk3_z-partsneeded.jpg]


1. Grab the Z-axis assembly. **Rotate** the Z-axis coupler, so the gantry **bottoms out** and you cannot rotate it any further. Look at the back - you should now have access to the four (4) router mount holes.

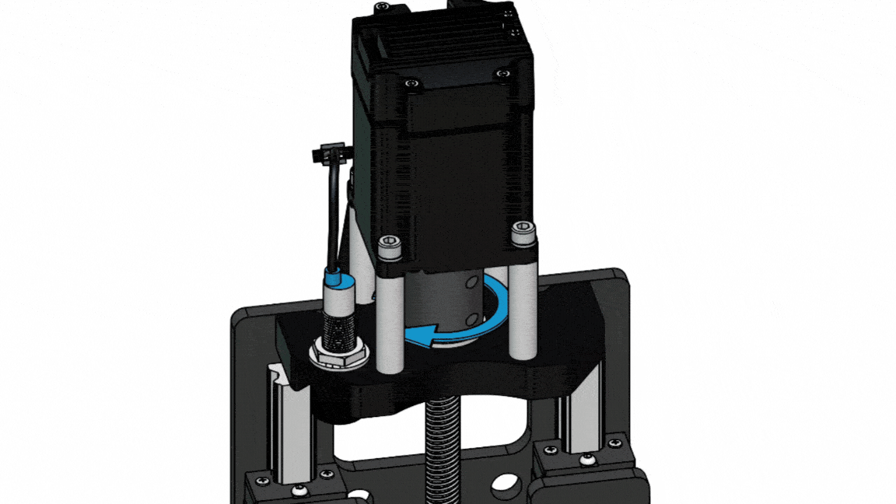
[picture p542: _images/_lmmk3/_assembly/lmk3_assembly_zaxisraise.gif]
    

1. Loosely assemble the router mount using four (4) M5-25mm screws.

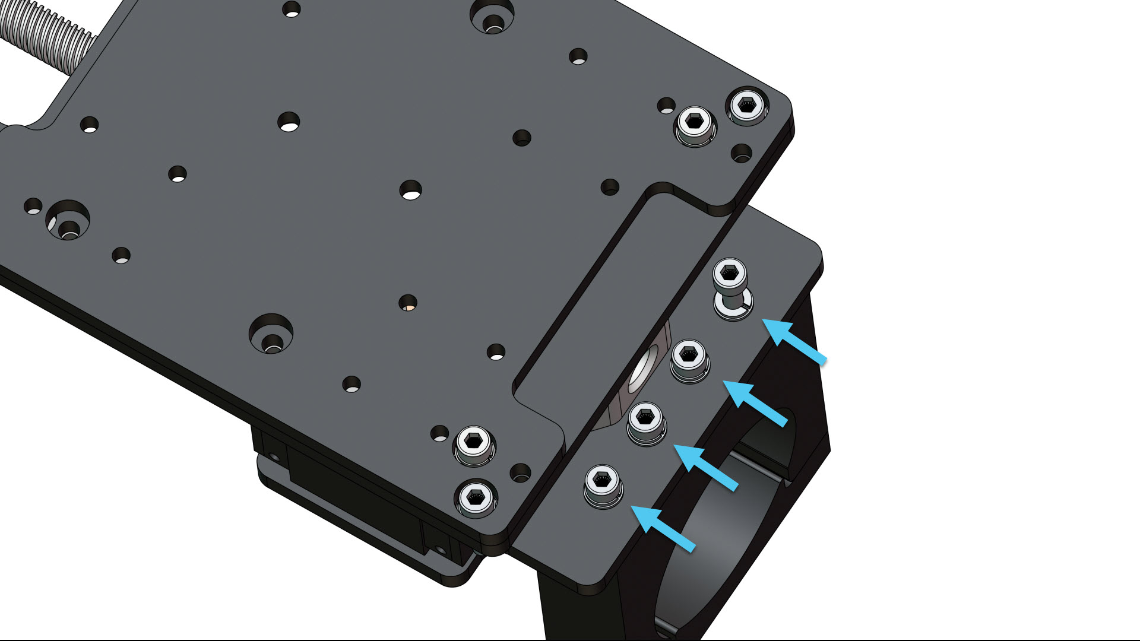
[picture p543: _images/_lmmk3/_assembly/_xy_axes/lmk3_zaxis-router.jpg]
    

1. Align the router mount to the edge of the gantry so it is flush, then finish fastening the M5-25mm screws to **completely secure** the router mount.

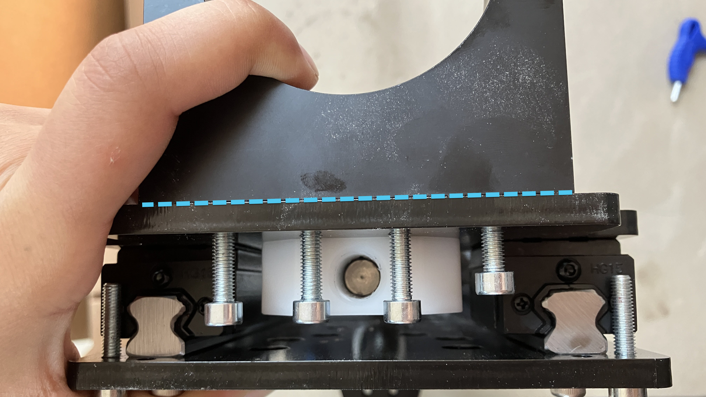
[picture p544: _images/_lmmk3/_assembly/_xy_axes/lmk3_zaxis-flush.jpg]
    

1. From the back of the machine, fasten the entire Z-axis assembly onto the X gantry using four (4) M5-12mm screws by loosely installing all four (4) screws, then fully secure them.

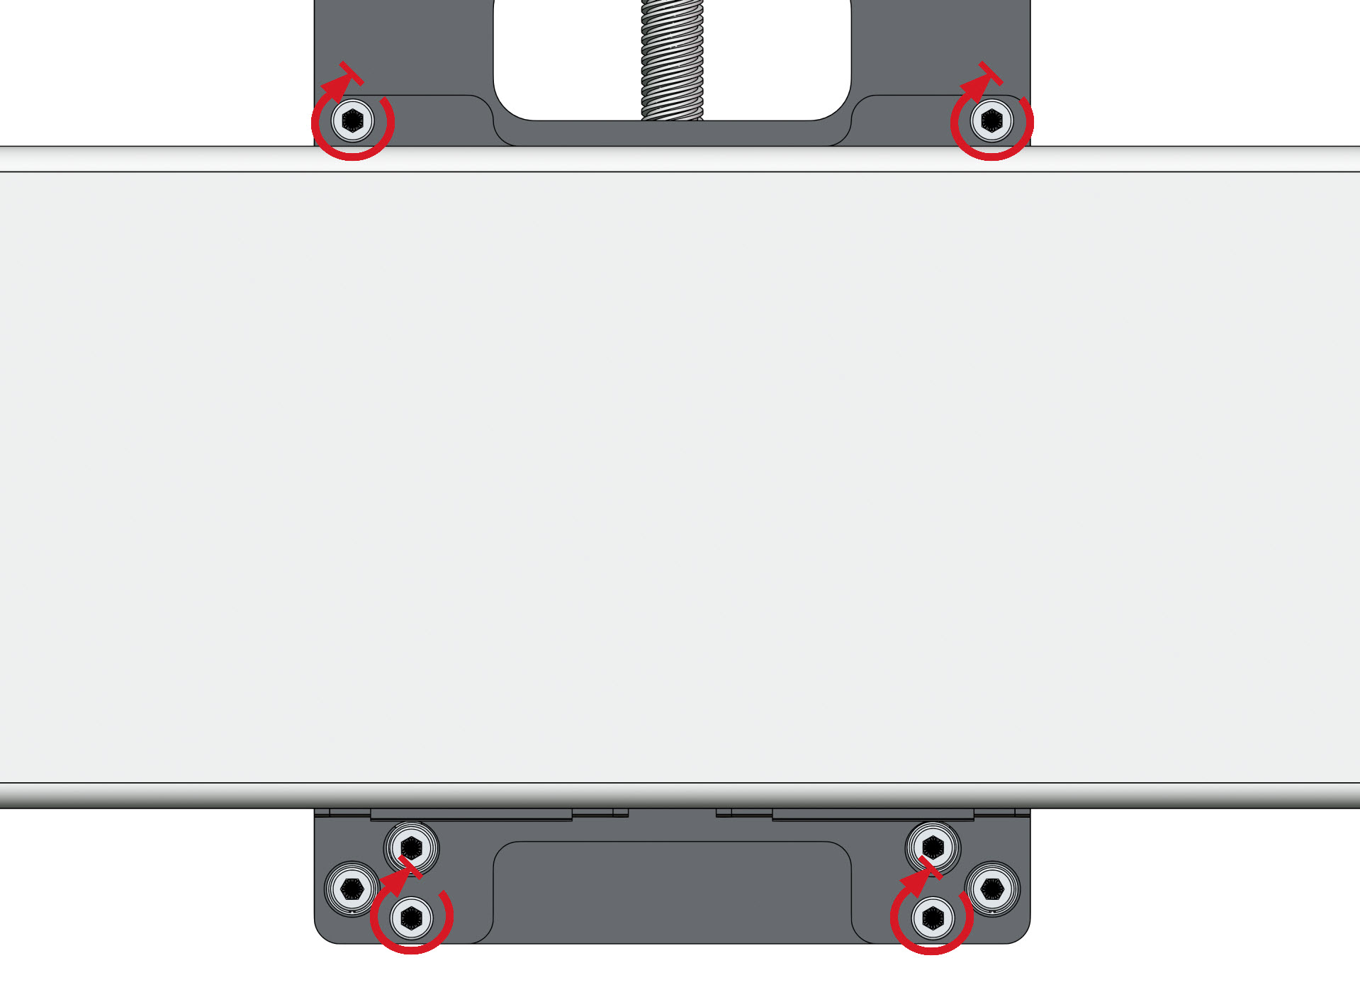
[picture p545: _images/_lmmk3/_assembly/_xy_axes/lmk3_xy_axes-zaxismount.jpg]
    

1. To finish up the router mount, loosely fasten the front half of the router mount using the two (2) M5-25mm screws.

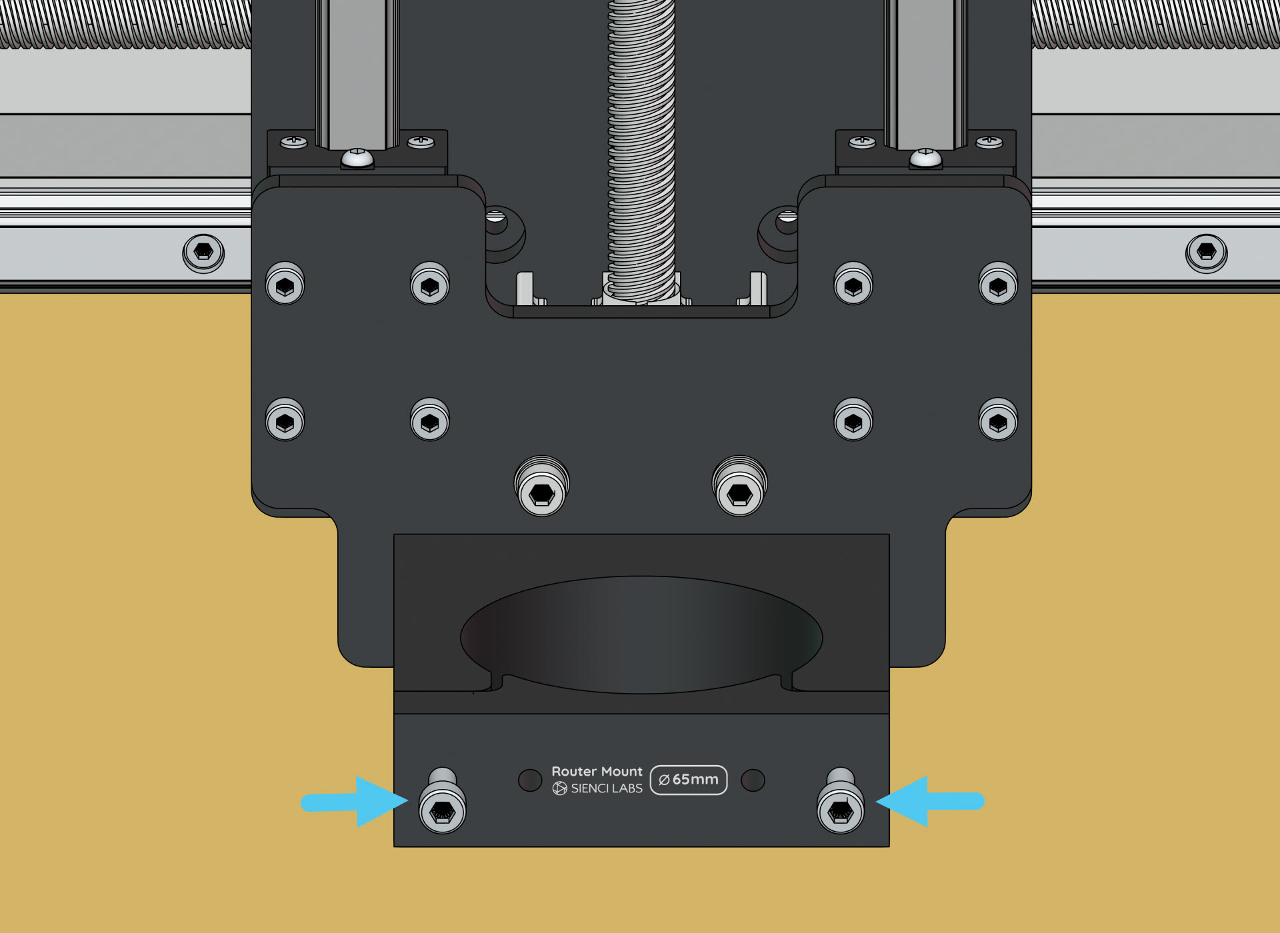
[picture p546: _images/_lmmk3/_assembly/_xy_axes/lmk3_xy_axes-routermount.jpg]
    

1. Grab your router and slide it through the router mount **from above**, until it bottoms out. Then secure it in place using the two (2) pre-installed screws, with an Allen key.

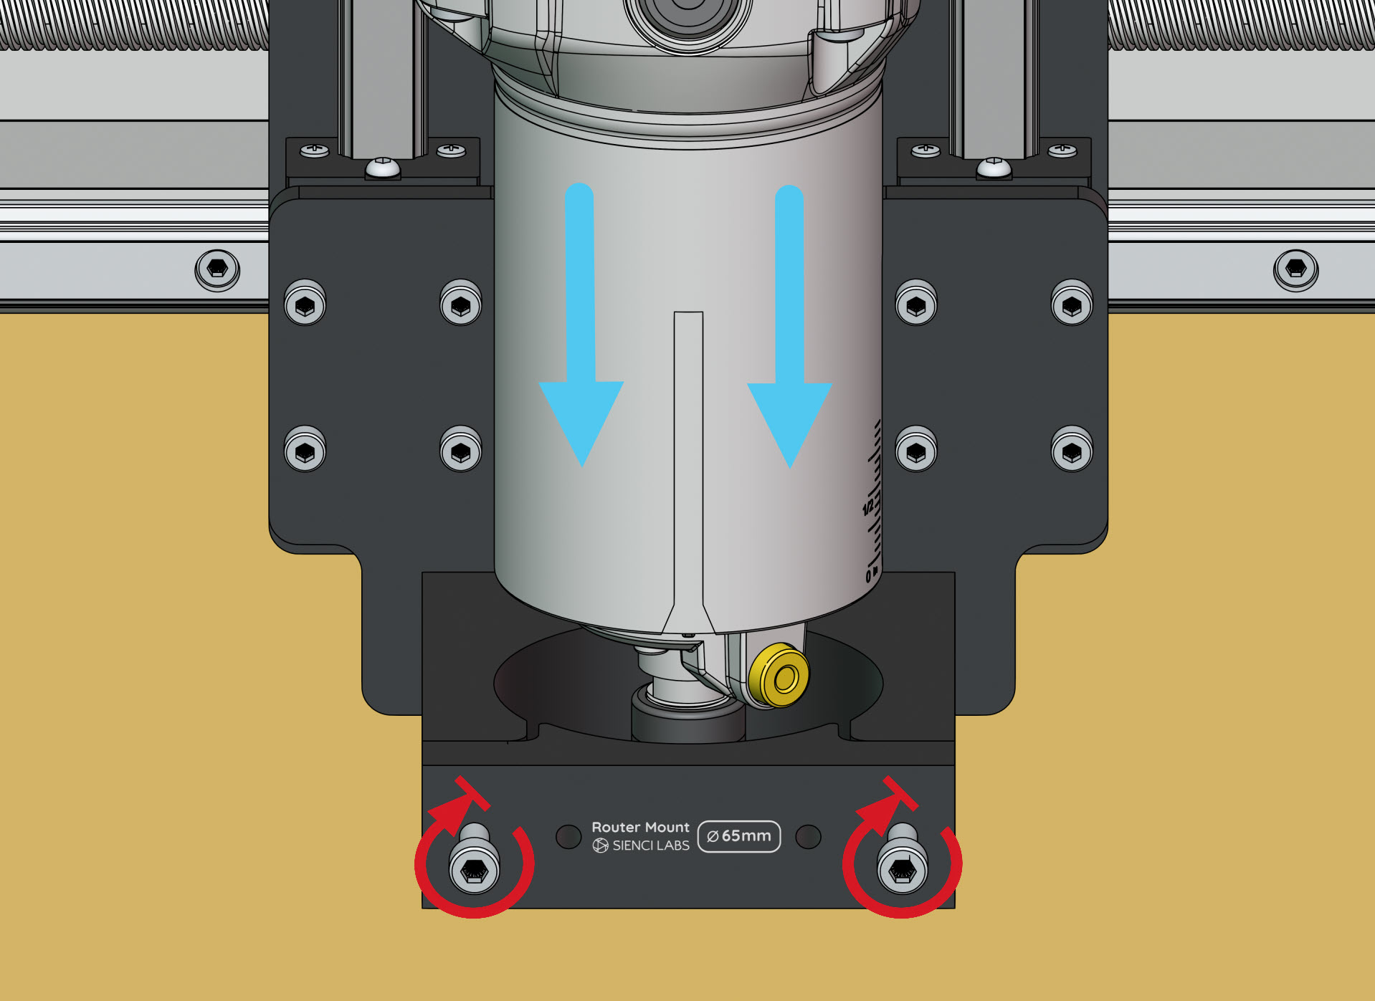
[picture p547: _images/_lmmk3/_assembly/_xy_axes/lmk3_xy_axes-routerin.jpg]
    

        💡 Note: You can adjust the router height later, if you need more space to install longer end mills.

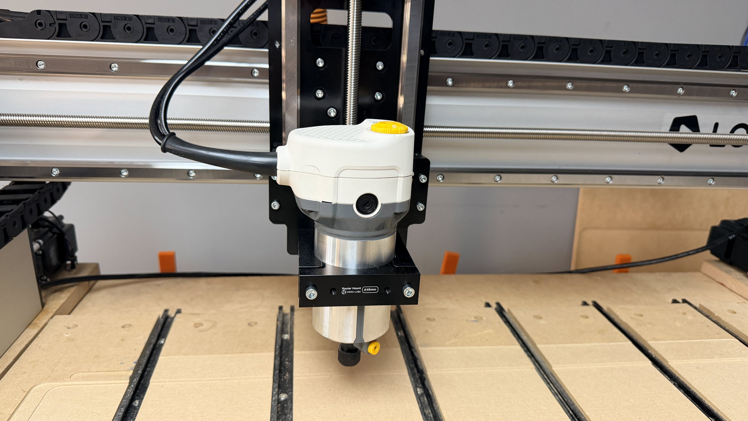
[picture p548: _images/_lmmk3/_assembly/lmk3_assembly_xy_axes-autospincable.jpg]
    

Nicely done! Let's keep going.
