Sienci-Labs/Resources/lmmk3/lmk3-assembly/lmk3-final-checks.md

---
title: 6. Final Checks
menu_order: 7
post_status: publish
post_excerpt: After assembly, make sure your machine is set up and ready for carving.
post_date: 2026-05-20 10:44:33
taxonomy:
    knowledgebase_cat: lmk3-assembly
    knowledgebase_tag:
custom_fields:
    KBName: LongMill MK3
    basepress_post_icon: bp-caret-right
skip_file: no
featured_image: _images/post-image.jpg
---
## Final Checks

We’re sure you’re itching to start cutting! Before chips go flying, we recommend going through these final checks and tasks to ensure you are set up for success.

1. Set up the **AutoSpin router** and check that it can spin up and stop:

    a. Make sure the AutoSpin is **unplugged** and the power switch is in the **OFF “O”** position.

    b. On gSender, go to Config, then to Spindle/Laser at the sidebar, then press the **Setup AutoSpin** button.

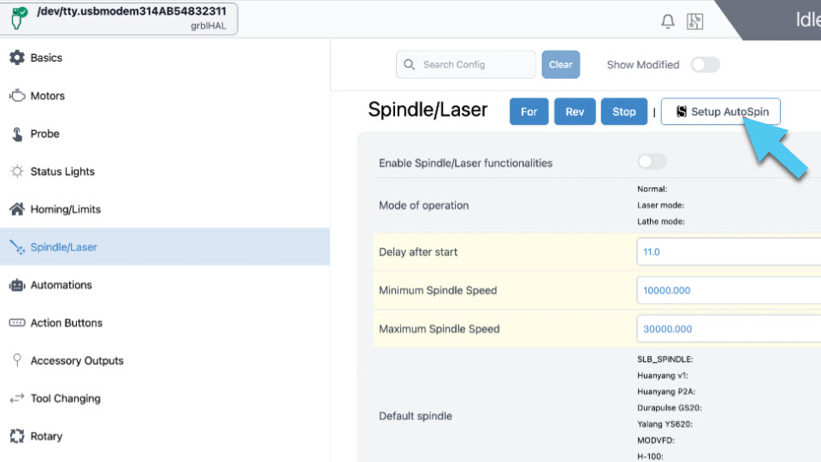
[picture p549: _images/_lmmk3/_assembly/lmk3_final_checks-autospinsetup.jpg]
    

    After pressing OK on the popup window, turn **OFF/ON** the controller and reconnect to gSender.

    c. Turn the dial of the router to the **S** position.

    d. Then plug in the router and flip the power switch to the **I "ON"** position.

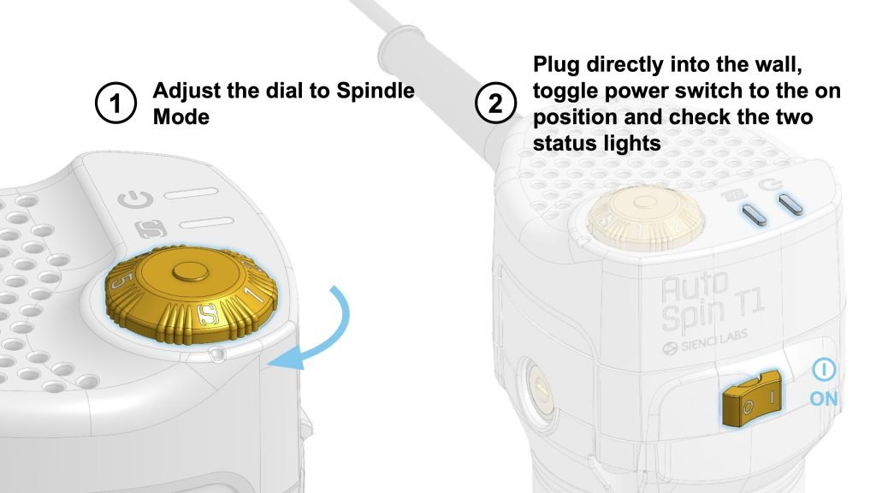
[picture p550: _images/_lmmk3/_assembly/lmk3_final_checks-autospin.jpg]
    

    e. On the bottom right corner of gSender, ensure the toggle is at **Spindle** and that in the dropdown, **PWM** is selected.

    Use the speed slider and **Forward** button to test at different speeds. Press **Stop** when you are done.

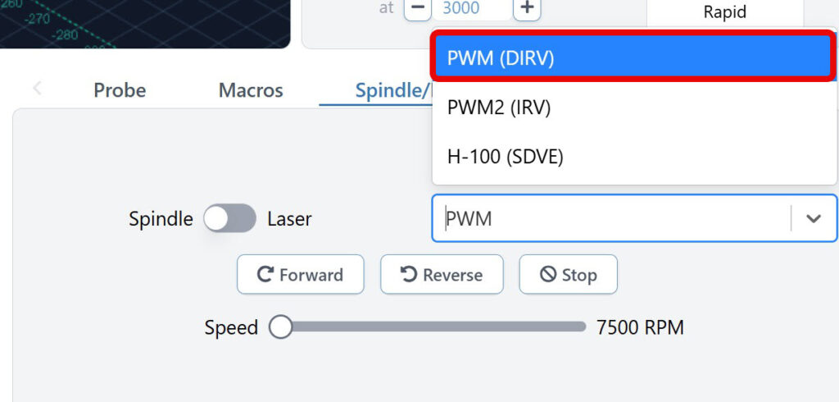
[picture p551: _images/_lmmk3/_assembly/lmk3_final_checks-pwm.jpg]
    

1. If you have the **Sienci Labs Spindle Kit**, open the [Spindle Kit](https://resources.sienci.com/view/mk3-spindle-kit/) page to set up your spindle.

1. Set up and learn how to use your **add-ons**, if you have the Beginner's Kit:

    [AutoZero Touch Plate](https://resources.sienci.com/view/addons-autozero/)

    [AutoSpin T1 Router](https://resources.sienci.com/view/as-er-collets/)

1. Slide the bristles into your MK3 **dust shoe**, if you have one.

If you have gone through the tasks above, then you are ready to start cutting! 🥳 Head over to [Surfacing & First Projects](https://resources.sienci.com/view/mk3-surfacing-first-proj/) to prepare your wasteboard and get some test cuts in.
