Sienci-Labs/Resources/atc/atc-assembly/atc-dust-shoe.md

---
title: 6. ATC Dust Shoe
menu_order: 7
post_status: publish
post_excerpt: Assembling and installing the clear dust shoe for the atc.
post_date: 2026-02-10 11:48:53
taxonomy:
    knowledgebase_cat: atc-assembly
    knowledgebase_tag: 
custom_fields:
    KBName: AutoToolChanger
    basepress_post_icon: bp-caret-right
skip_file: no
featured_image: _images/_atc/_atc_assembly/_dust/atc_assembly_dust_header.jpg
---

## Clear Cut Dust Shoe Installation

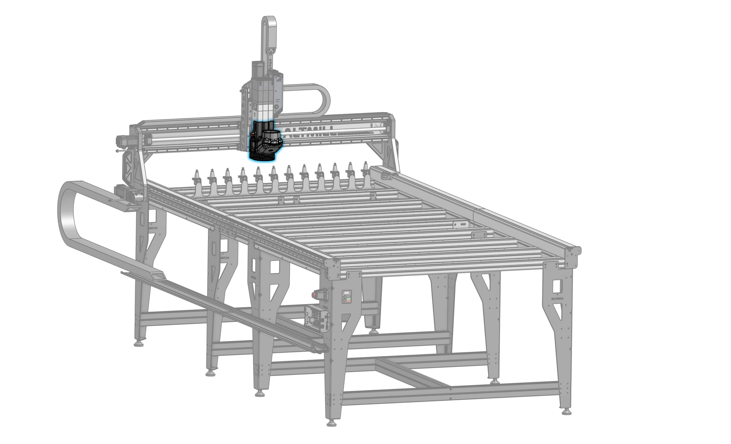
[picture p598: _images/_atc/_atc_assembly/_dust/atc_assembly_dust_header.jpg]


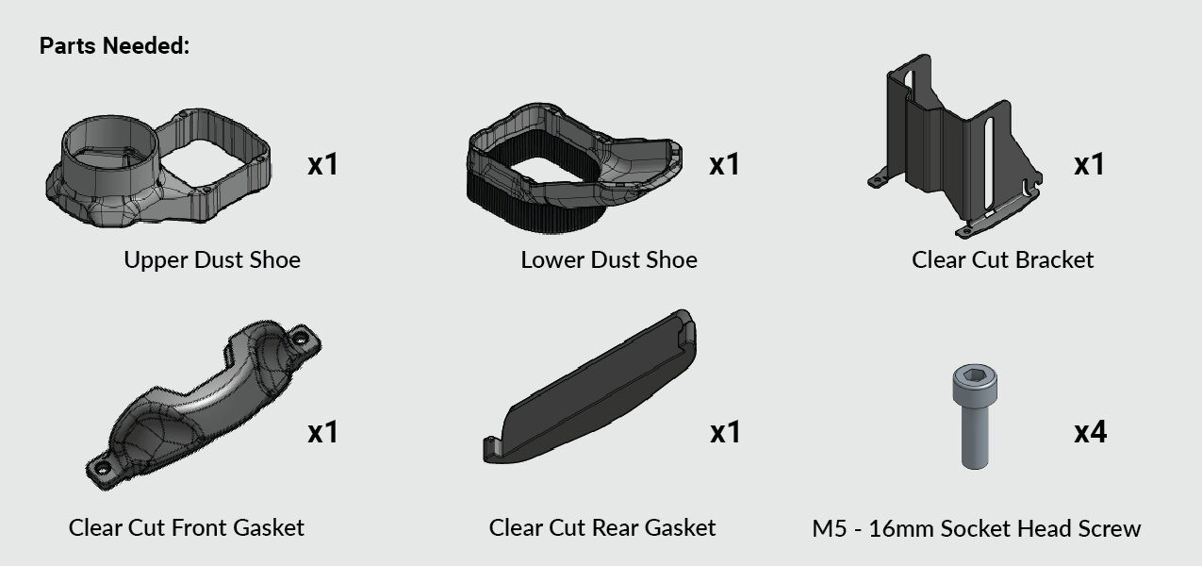
[picture p599: _images/_atc/_atc_assembly/_dust/atc_assembly_dust-parts1.jpg]


See video below for the installation of your dust shoe for the ATC!

https://youtu.be/1Tg-IhbPyow

Otherwise, follow along using the instructions below.

### Assembly

1. Attach the **front and rear gaskets** to the Clear Cut ATC bracket:

   * Align holes between the front gasket and bracket
   * Both gaskets should sit flush to the bottom of the bracket

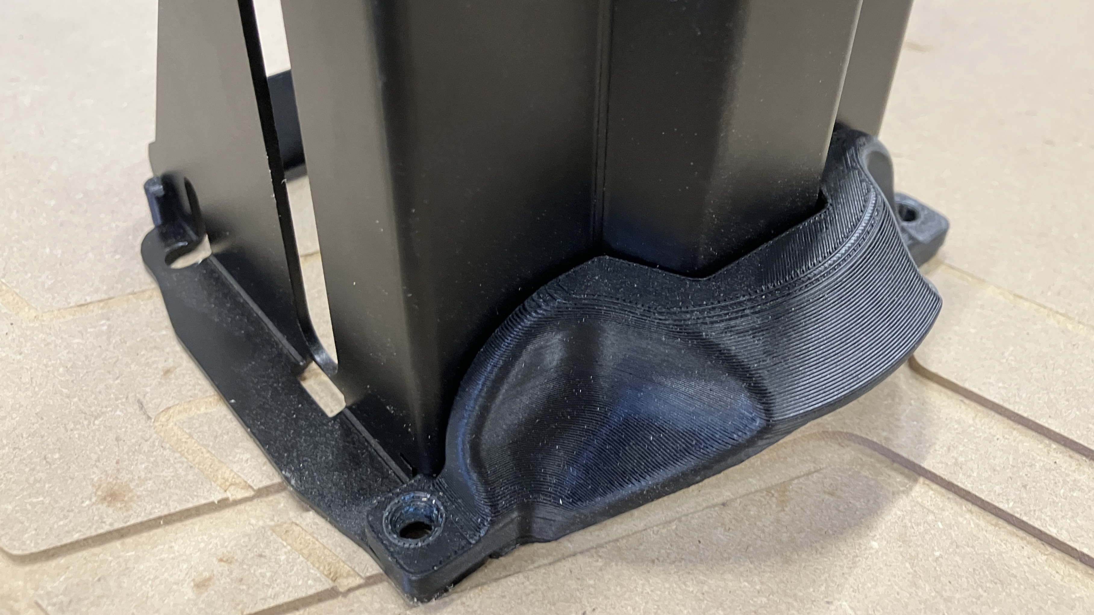
[picture p600: _images/_atc/_atc_assembly/_dust/atc_assembly_dust-gasket.jpeg]
   

1. Insert **four (4) M5 - 16mm socket head screws**, one in each corner. Then fasten the upper dust shoe and lower dust shoe to the bracket using an Allen key.

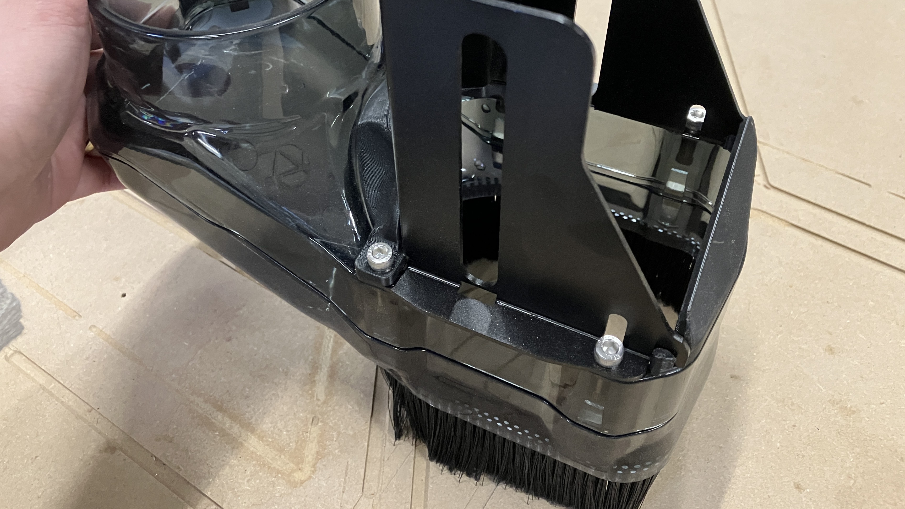
[picture p601: _images/_atc/_atc_assembly/_dust/atc_assembly_dust-upperlower.jpeg]
   

1. Slide the dust shoe assembly on, from the bottom of the spindle.

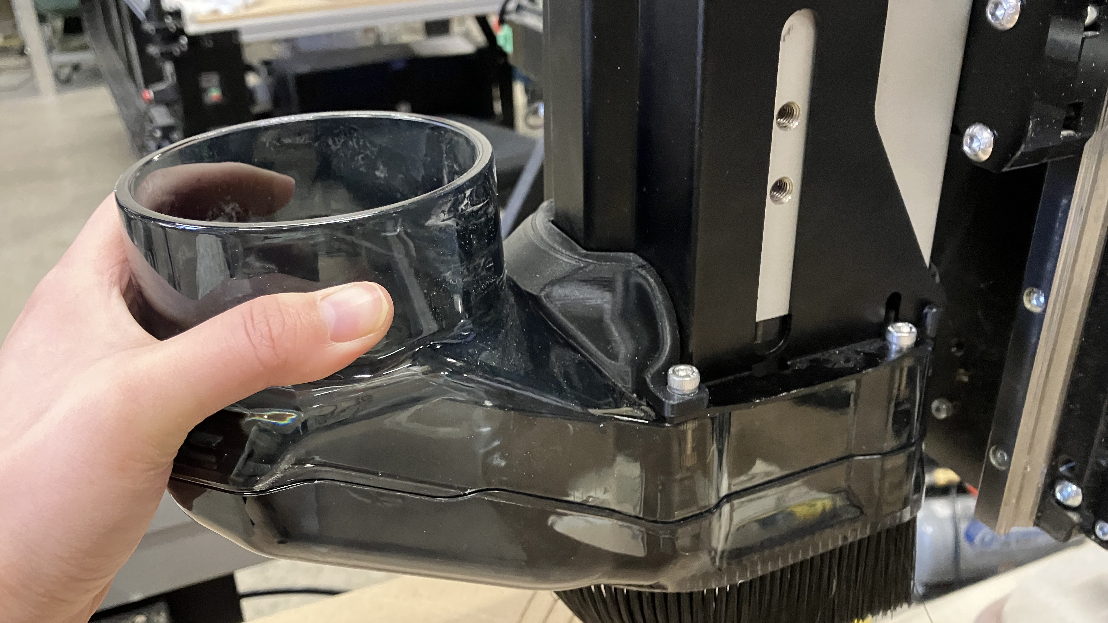
[picture p602: _images/_atc/_atc_assembly/_dust/atc_assembly_dust-mount.jpeg]
   

### Height Adjustment

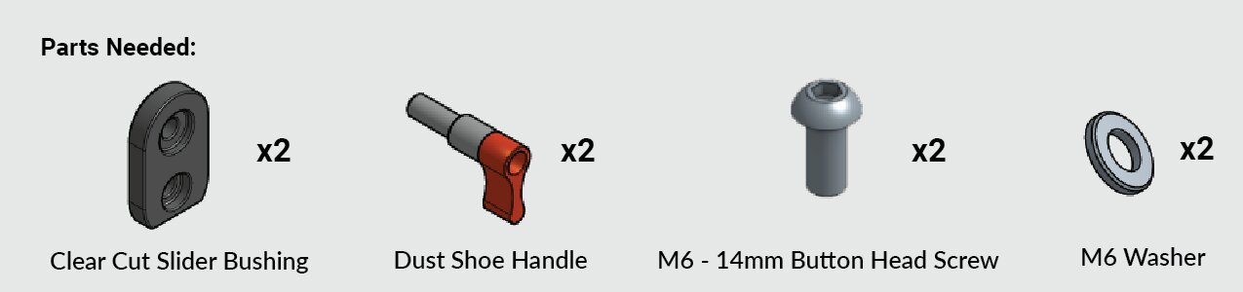
[picture p603: _images/_atc/_atc_assembly/_dust/atc_assembly_dust-parts2.jpg]


1. Insert one (1) **M6 - 14 mm screw** into each slider bushing, for a total of two (2) screws.

1. Place slider bushings on the **left and right sides** of the bracket.

   * Secure into the **bottom threaded holes** on the spindle.

1. Place a washer on each handle, then thread the handle into the **top hole** of each slider.

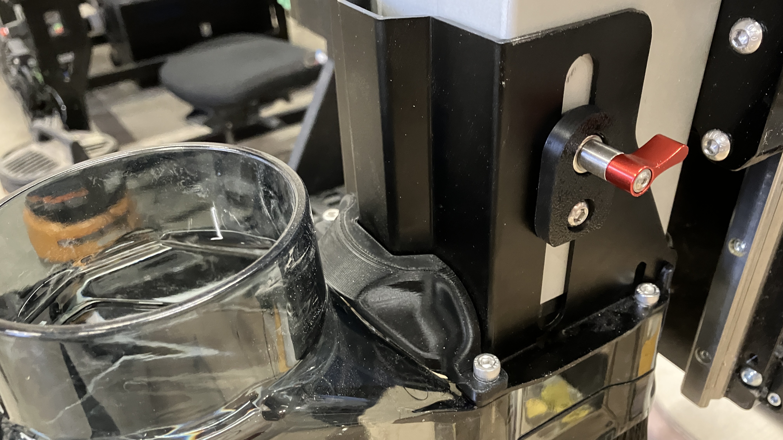
[picture p604: _images/_atc/_atc_assembly/_dust/atc_assembly_dust-fasten.jpeg]
   

1. Adjust dust shoe height to your desired position, then tighten the handle to lock it in place.

### Hose Installation

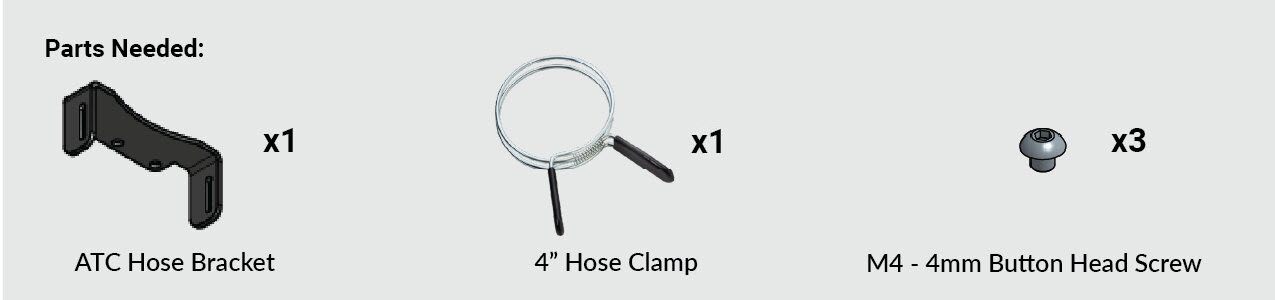
[picture p605: _images/_atc/_atc_assembly/_dust/atc_assembly_dust-parts3v2.jpg]


1. Check that the VFD is turned off.  

1. Assemble the **hose bracket** onto the top of the spindle using three (3) M4 - 4mm button head screws.

   * ⚠️ Do not drop screws into the spindle.
   * You may want to put a piece of paper to cover the spindle holes while assembling the fasteners. Remove the paper when you are done!

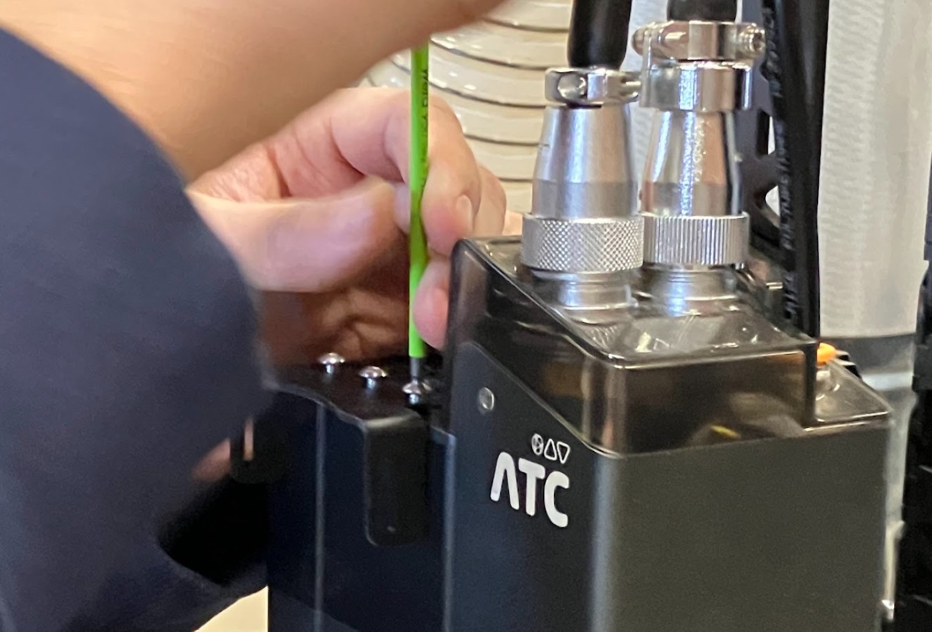
[picture p606: _images/_atc/_atc_assembly/_dust/atc_assembly_dustshoe-7.jpg]
   

1. Slide a hose clamp onto the hose.

1. Attach the hose to the dust shoe inlet and tighten the clamp.

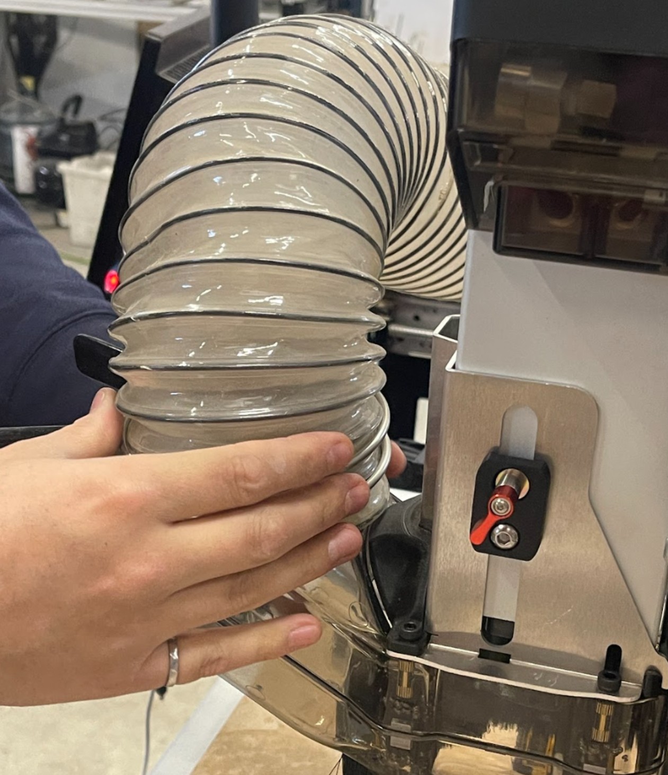
[picture p607: _images/_atc/_atc_assembly/_dust/atc_assembly_dustshoe-8.jpg]
   

1. Zip-tie the hose to the hose bracket for strain relief.

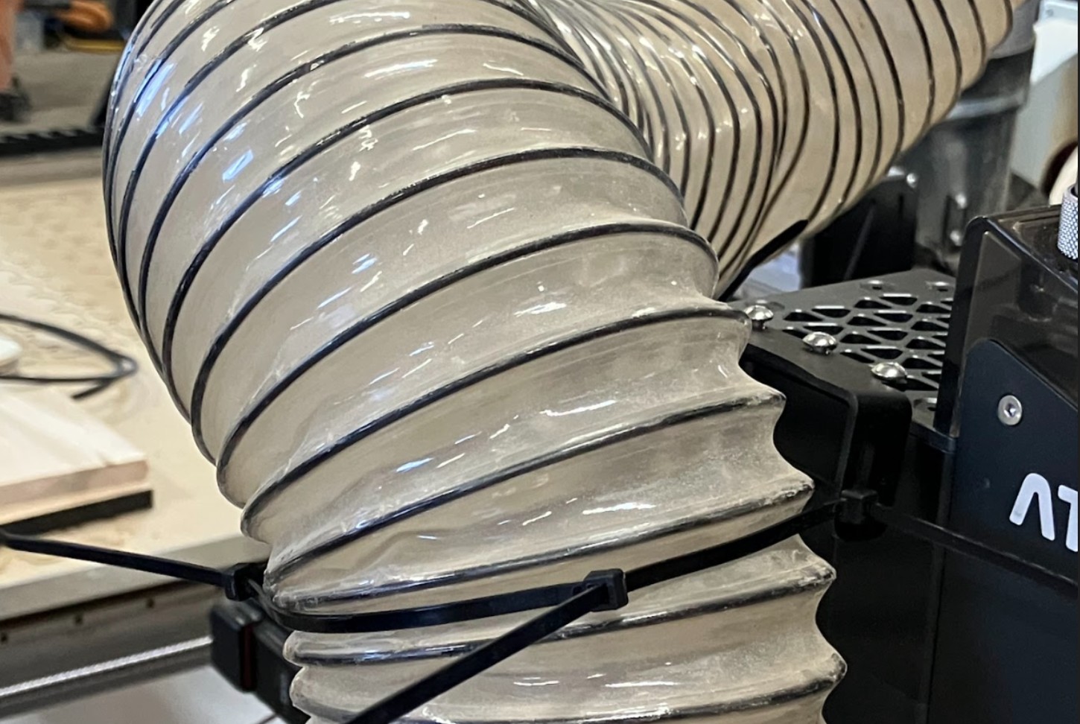
[picture p608: _images/_atc/_atc_assembly/_dust/atc_assembly_dustshoe-9.jpg]
   

### Usage Notes

* The **lower dust shoe** can be removed for probing.
* For tool changes, the dust shoe may remain installed.
