Sienci-Labs/Resources/lmmk3/mk3-assembly/mk3-z-axis.md

---
title: 3. Z-axis
menu_order: 4
post_status: draft
post_excerpt: 
post_date: 2026-05-20 10:55:55
taxonomy:
    knowledgebase_cat: mk3-assembly
    knowledgebase_tag:
custom_fields:
    KBName: LongMill MK3
    basepress_post_icon: bp-caret-right
skip_file: no
featured_image: _images/post-image.jpg
---
