Sienci-Labs/Resources/atc/atc-assembly/atc-software.md

---
title: 7. ATC Software
menu_order: 8
post_status: publish
post_excerpt: Setting up gSender to work with the atc.
post_date: 2026-02-10 11:47:53
taxonomy:
    knowledgebase_cat: atc-assembly
    knowledgebase_tag: 
custom_fields:
    KBName: AutoToolChanger
    basepress_post_icon: bp-caret-right
skip_file: no
featured_image: _images/_atc/_atc_assembly/_software/atc_assembly_soft_install.jpg
---

For this software setup, if you have a **4x8 AltMill** you may want to grab a friend to help you with checking sensor position and lights on the ATC. Otherwise, be prepared to do some walking back and forth!

https://youtu.be/PP0Z2NMc524

## gControl Panel

At this time you can reinstall your gControl panel and mount, [see mounting instructions here](https://resources.sienci.com/view/gc-gcontrol-assembly/).

## Power Up

1. Plug the **VFD power cable** into an outlet and turn on the power switch at the bottom of the VFD.
1. Turn on the **SLB-EXT** using its toggle switch, cycling the E-stop as usual.

## Initial Hardware Checks

1. Verify the **rack sensor** is on, if you have it. It should be on if the rack has been installed correctly. There should be a red light coming from the rack sensor.

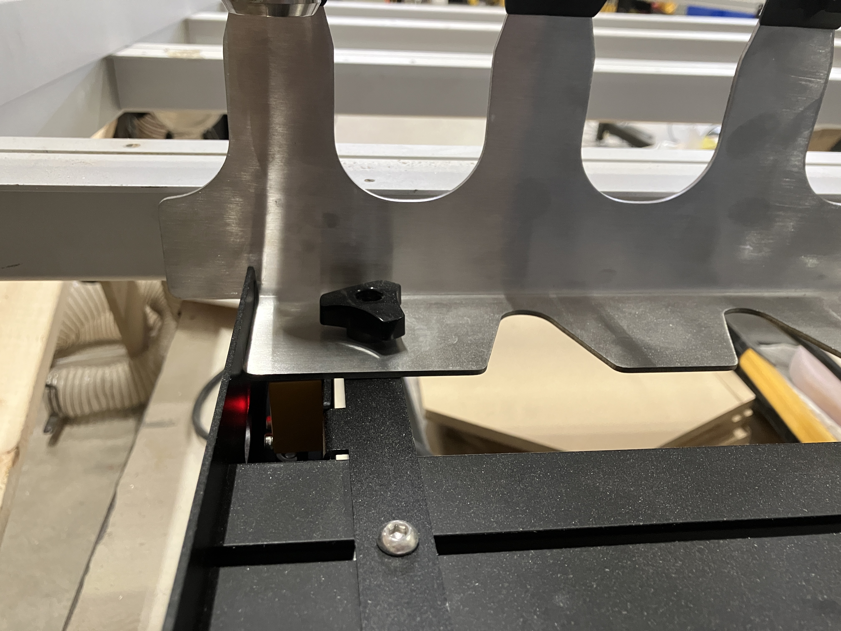
[picture p609: _images/_atc/_atc_assembly/_software/atc_assembly_soft_rack.jpeg]
    

1. Check that the **tool length sensor (TLS)** is functioning.

    * Press down on the TLS (either manually or by jogging the spindle down slowly), and confirm the **orange TLS LED** on the SLB-EXT turns off.

    

1. Check the **white Pressure LED** on the spindle is on.

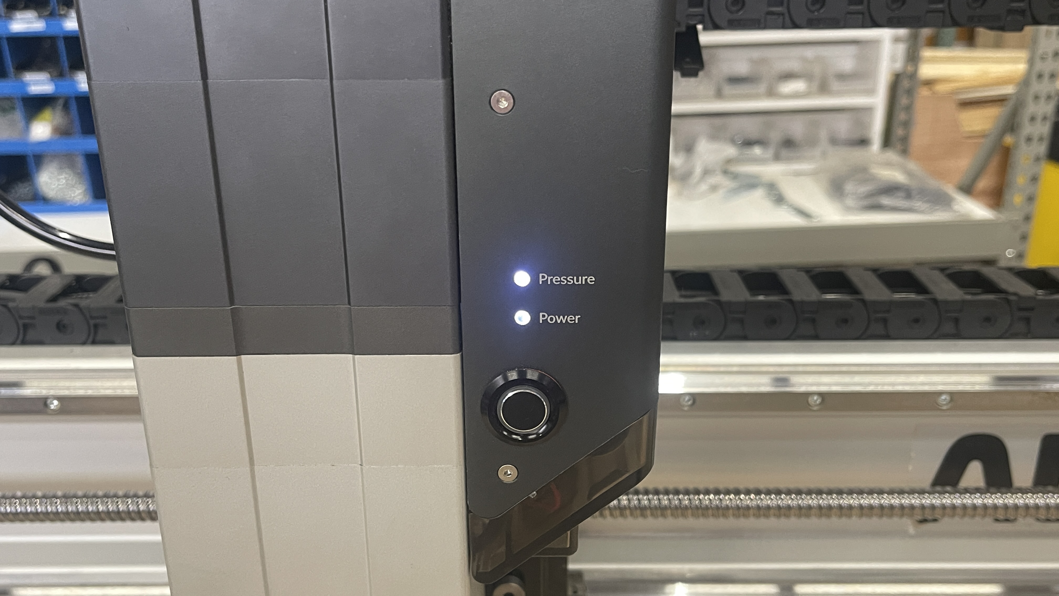
[picture p610: _images/_atc/_atc_assembly/_software/atc_assembly_soft_airpressure.jpg]
    

* If the light is **red**:

  * Check the air compressor gauge
  * Check the filter regulator gauge
  * Ensure the quick-disconnect ball valve is open

> ⚠️ The first time you connect to **gSender** with the spindle connected, air will leak because the system has not yet been configured.

## gSender Setup

1. Open **gSender** and connect to your machine.
1. Check your controller firmware by clicking on the machine information icon, and verifying version **20260525** is installed.

    

    If not, **please update by following the [instructions here](https://resources.sienci.com/view/slb-firmware-flashing/)**. Then come back to this page for the next step.

1. Once firmware has been updated, connect back to gSender and go to **Tools**.
1. If you haven't yet, insert the **microSD card** into the slot on the SLB-EXT.
1. Go to **SD Card Manager**.

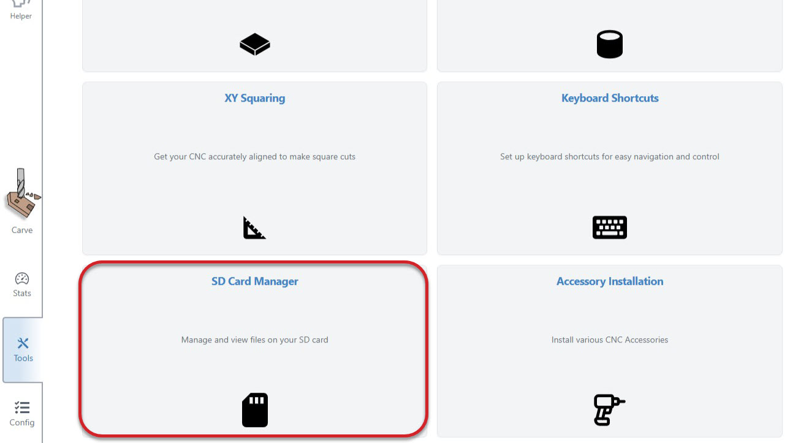
[picture p611: _images/_atc/_atc_assembly/_software/atc_assembly_soft_accessoryv2.jpg]
    

1. Ensure that gSender recognizes the card and shows it as **Mounted**

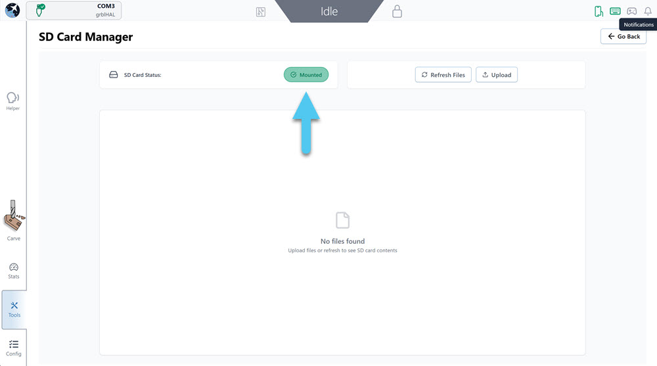
[picture p612: _images/_atc/_atc_assembly/_software/atc_assembly_soft_sdmounted.jpg]
    

* We strongly recommend using the microSD card provided with your kit.
* Other SD cards may need to be reformatted to FAT32 and must not exceed a capacity of 32 GB.

### Accessory Installation

We will be using gSender to upload ATC-related g-code programs to the microSD Card.

1. Navigate back to the Tools tab, and click on **Accessory Installation**.

1. Select **Sienci ATC** to start the setup. This process should take approx 30 min.

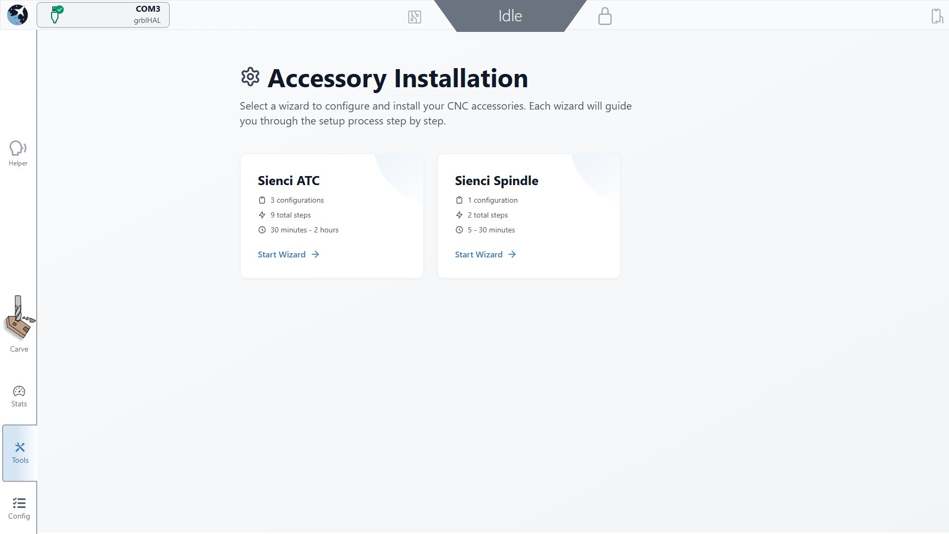
[picture p613: _images/_atc/_atc_assembly/_software/atc_assembly_soft_install.jpg]
    

1. Select **Initial Setup**.

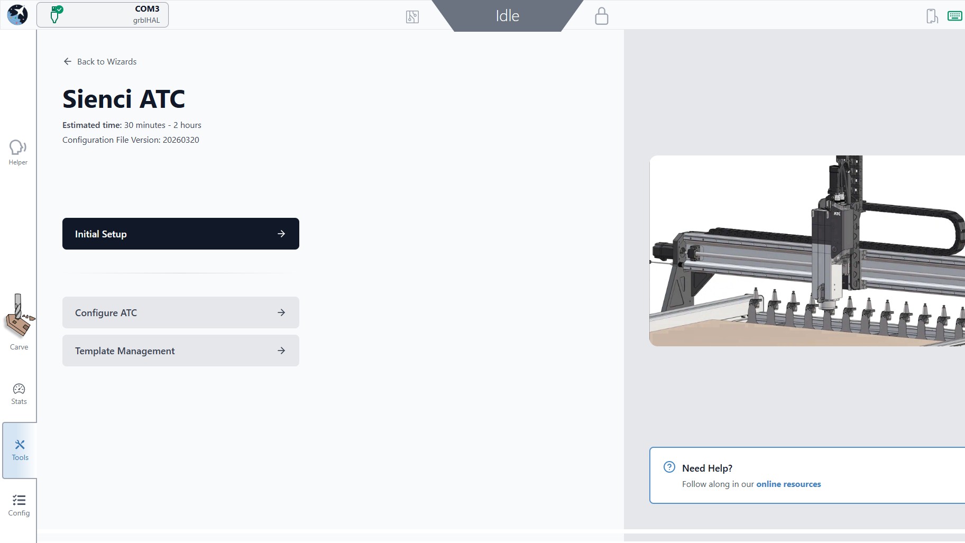
[picture p614: _images/_atc/_atc_assembly/_software/atc_assembly_soft_initial.jpg]
    

1. Select your **Rack Size**. For this example, we are selecting a 6 Tool Rack. Hit Upload Macros.

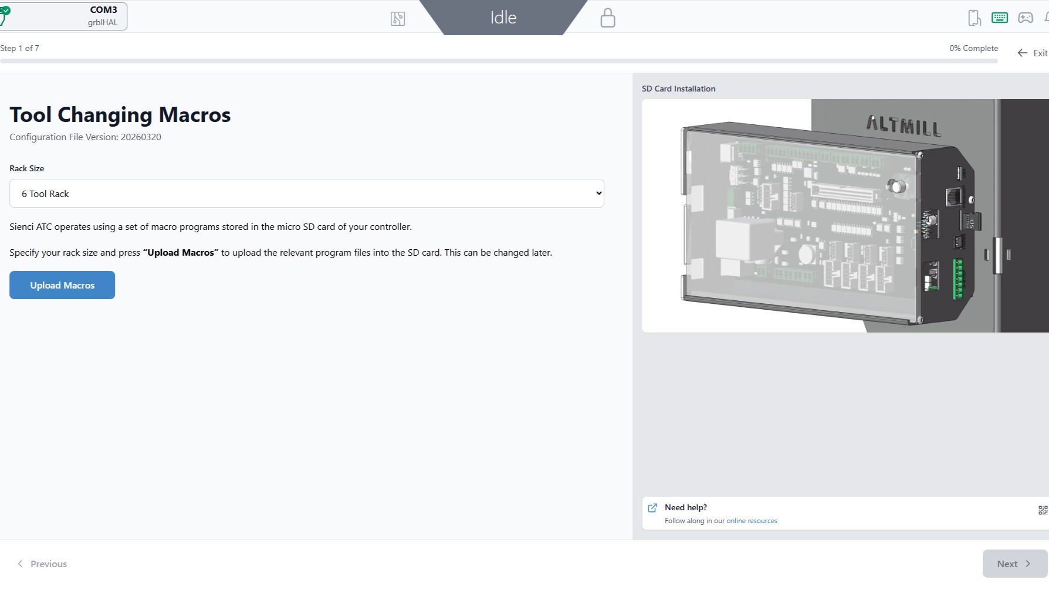
[picture p615: _images/_atc/_atc_assembly/_software/atc_assembly_soft_macro.jpg]
    

1. Once complete, press Next in the bottom right corner.

### Controller Setup

1. This step will configure your controller. Hit the blue Apply button.
1. Once completed, hit Next.

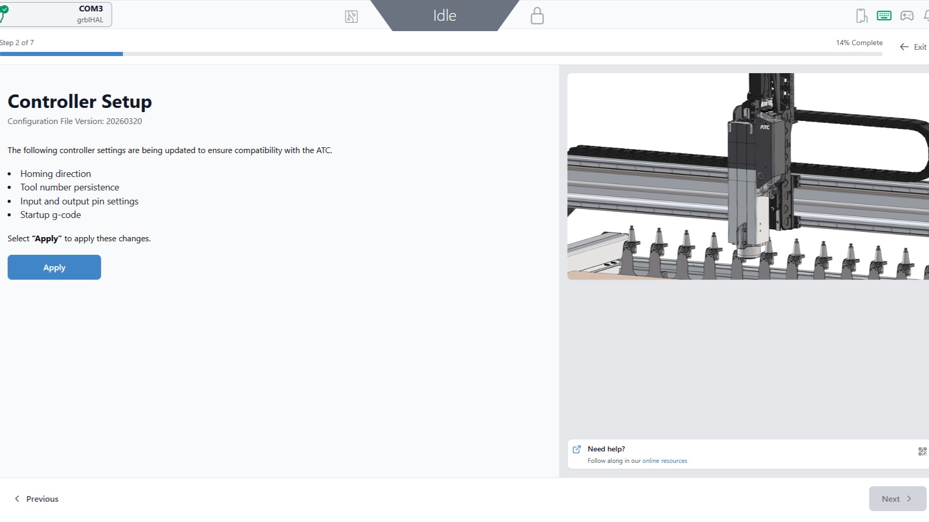
[picture p616: _images/_atc/_atc_assembly/_software/atc_assembly_soft_control.jpg]
    

1. Next, the machine will update its homing position. Hit the blue **Re-home button** to begin this wizard.
1. Once the button turns green and shows Complete, continue with the Next button. At this stage, the air leak at the spindle should **stop**.

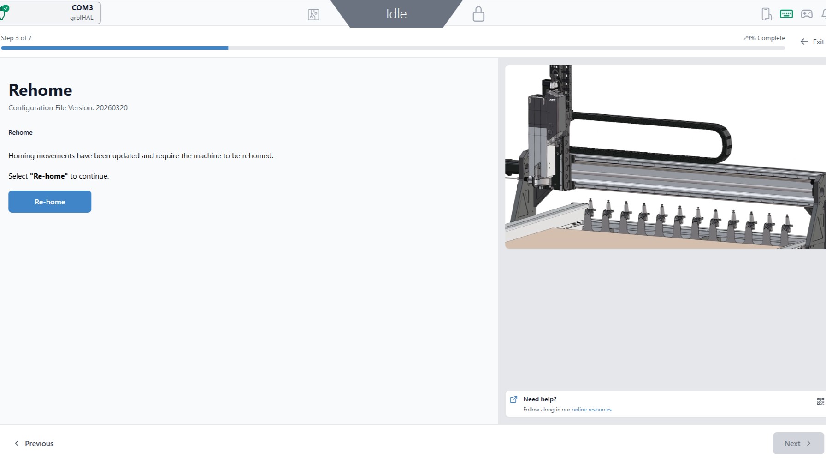
[picture p617: _images/_atc/_atc_assembly/_software/atc_assembly_soft_rehome.jpg]
    

### Rack Position

Next the rack location will be determined. You will be prompted to manually jog the ATC.

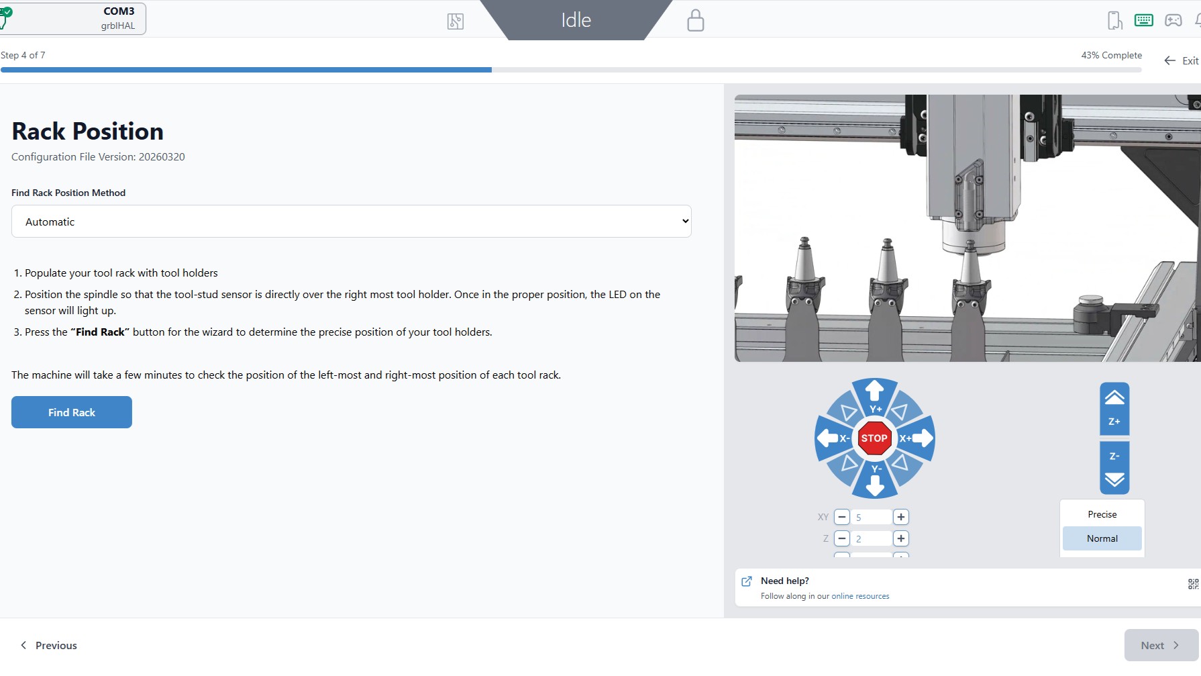
[picture p618: _images/_atc/_atc_assembly/_software/atc_assembly_soft_rackpos.jpg]


1. Ensure **Automatic** is selected in the drop down menu.

    ⚠️ **Caution:** Move slowly. Avoid crashing the **stud finder** or **spindle nose**.

1. Assuming you **start from the back left corner** of the machine, you will be moving the spindle above the right-most tool holder.  

    Manually jog to the right, to the front and then down. You will be moving approximately:

    * 1140 mm to the right
    * 20 mm to the front
    * 100 mm down

        **These values are approximate, you will need to adjust especially if using a MK1 or early MK2**

    The goal is to line up the sensor on ATC over the tool holder stud, triggering an LED to light up. Aim for 1-2mm above the stud, and centered on the stud.

1. Use **precise jog** (short taps only) once you are close to the stud.

    

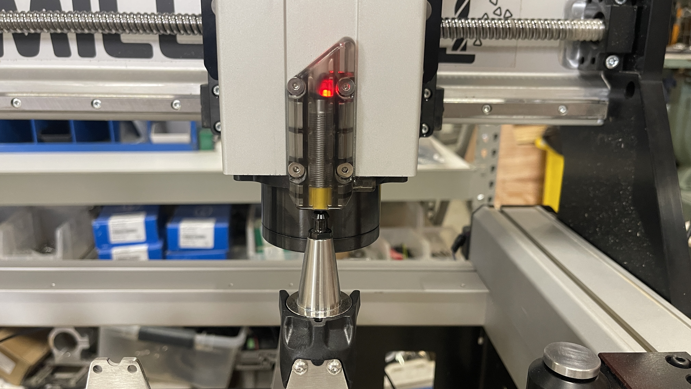
[picture p619: _images/_atc/_atc_assembly/_software/atc_assembly_soft_lighton.JPG]
    

    Once the light is on, hit the blue **Find Rack** button.

1. A **Probing Sequence** confirmation window will appear, hit OK to continue.

    * The machine will move in a small grid pattern to re-locate the stud.

    

    Once it successfully locates, you will see this confirmation window.

    

    > ⚠️ If you encounter an error that it cannot find the stud, make sure to accurately position the sensor 1mm above the stud, centered on the stud. Just because the light turns red does not mean it is in the right position!

1. The locating process will now repeat for the **left-most rack position**. You will see another confirmation window pop up. Ensure the **tool holder** is mounted into the left-most rack position before continuing. Hit OK.

1. Once completed, if you have a 12-tool rack you will be prompted to repeat this process for the right and left-most positions on your second tool rack.

1. Click Next.

### Tool Length Sensor Position

Now we will be setting the location of the TLS.

1. We are going to move the spindle all the way to the right side again, to set the location of the TLS. Jog until the spindle nose is directly above and centered on the TLS.

    

    

1. Hit the blue **Set Position** button.
1. Once the button turns green, indicating the position has been set, hit Next.

### Spindle Configuration

In this section we will be power cycling and reconnecting to the SLB-EXT.

1. Hit the Apply and Restart blue button.

    

1. Hit the Next button in the bottom right corner.

    

1. Reconnect to gSender.

1. Ignore the alarms, and hit the Apply and Restart button again.

    

    Once complete, click the Next button. Setup is complete! Exit the wizard now.

    

1. Go to Config -> Tool Changing.
1. Toggle the **Enable ATC** switch and hit the Apply Changes button.

Once complete, the following tabs should appear in gSender:

* **Spindle / Laser** - which will allow you to start up and run your spindle.
* **ATC** - which will allow you to change out tools.
