Sienci-Labs/Resources/lmmk3/mk3-assembly/index.md

---
title: LongMill MK3 Post
menu_order: 0
post_status: draft
post_excerpt: 
post_date: 2026-05-19 08:14:53
taxonomy:
    knowledgebase_cat: mk3-assembly
    knowledgebase_tag:
        - mk3
custom_fields:
    KBName: LongMill MK3
    basepress_post_icon: bp-caret-right
skip_file: yes
featured_image: _images/post-image.jpg
---
