Sienci-Labs/Resources/atc/atc-assembly/atc-tool-rack-and-tls.md

---
title: 4. ATC Tool Rack & TLS
menu_order: 5
post_status: publish
post_excerpt: Connecting your tool rack(s) and setting up your tool length sensor.
post_date: 2026-02-10 11:38:53
taxonomy:
    knowledgebase_cat: atc-assembly
    knowledgebase_tag: 
custom_fields:
    KBName: AutoToolChanger
    basepress_post_icon: bp-caret-right
skip_file: no
featured_image: _images/_atc/_atc_assembly/_toolrack/atc_assembly_tool-rackparts.jpg
---

## Rack & TLS Installation

**No rack?** [SKIP AHEAD to the TLS](#tool-length-sensor) section in this article.





https://youtu.be/K0RqD32ysjw

## Rack Assembly

1. Grab the **rack sections** and identify:

   * The back right and back left, which are the mirrored pair of sections
   * The front, which are **two identical sections**

   

1. Grab the **ATC rack sensor.** Put two (2) M3 - 20mm socket head screws into the tool rack sensor. Then mount the sensor onto the **back right rack section**:

   * The holes are covered by the sticker, so position the sensor behind the slot cutout first.
   * Then fully secure with the pre-installed screws.
   * Stick the cable from the sensor into the rectangular cutout.

   

   

   

1. Take the **identical front rack sections** and place them onto the back left and right sections.

      Align the sections based on your AltMill type. To find the position, use the **small notch** on the front sections and the **letters** labelled on the back sections.

   * 2x4 -- Use C

   * 4x4 MK2 & 4x8 -- Use B

   * 4x4 MK1 -- Use A

   

1. Find the holes under the rack sections. Keeping the alignment in the previous step, fully secure the sections using **two (2) M6 - 8mm button head screws** per side.

   

1. Place **one assembled rack section** onto one end of the **support extrusion**. Align with the threaded holes. Repeat for the other assembled rack section. Fully secure using **two (2) M5 - 16mm button head screws** at each extrusion end, making sure the extrusion is perpendicular to the support extrusion.

   

1. Insert a M6 roll-in **T-nut** into the extrusion slot.  
   * Ensure correct orientation of the T-nut in the slot, the flat side should be facing up from the slot.
   * Slide it to align with the rack hole.
   * Place **one M6 - 8mm button head screw**, and fasten securely.
   * Repeat for the other side.



## Backbone Assembly



1. Secure one (1) **tool holder clip** onto each end of the backbone, ensuring the clip sits **flush**, using two (2) M4 - 8mm screws. Repeat for each position on the backbone.

   * Hold the clip snug while threading in the screws with an Allen key. Secure fully.
   * Continually check that each clip remains fully seated to the profile.

   > ⚠️ **Important:** Improperly seated clips can cause **ATC accuracy issues**.

   

## Rack Assembly Mounting



1. Place the backbone onto the assembled rack sections, located using the two studs.

   

1. Loosely install the two (2) knobs onto the studs, you will adjust the backbone position later.

   

1. Pre-assemble **four (4) M6 - 8mm button head screws** with the correct **T-nuts** for your machine:

   * **MK1** – Roll-in T-nuts
   * **All other AltMills** – Twist-in T-nuts

   

1. Bring the **assembled rack sections** and pre-assembled fasteners to the **back-right corner** of the AltMill.

1. Confirm that the ends of the rack are **flush** with the crossbeam faces on both the front and back sections.
   * If not, revisit the [Rack Assembly](#rack-assembly) to adjust hole positions.

1. Slide **two (2) pre-assembled M6 fasteners** per crossbeam T-slot where the rack assembly will mount, for a total of four (4) fasteners.

   

1. Place the rack assembly **under** the crossbeams and hook it onto the M6 fasteners. Position the assembly so it butts up against the **rear right AltMill leg.**

   

1. Hold the assembly in place at the support extrusion, clamping the assembly up to the crossbeam, and tighten the fasteners.

   

1. Finally, secure the backbone knobs. Ensure they sit flush to the rack sections.

   

1. If installing a **second tool rack**:

   * Repeat the above steps
   * Install it directly next to the first rack, **butted against the backbone**

   > ⚠️ This is required for **automated setup in gSender**.

   

## Tool Holder Prep

1. Clean the taper on the tool holders using 99% isopropyl alcohol and lint-free cloth (e.g. shop towel).

   

1. Clean the inside of the ATC spindle nose using 99% isopropyl alcohol and lint-free cloth (e.g. shop towel)

   

1. Install tool holders into the **first and last slots** of each tool rack assembly.

* Fully seat each tool holder, the clip must engage the flats on the tool holder  

   

   

## Rack Sensor Cable Routing



1. Grab the cable clips from the ATC box and tool rack box, then place them into the crossbeams, three (3) across the rear-most crossbeam, then one (1) for each remaining crossbeam, stopping before the front-most crossbeam.

   Route the **rack sensor cable** through the cable clips in the crossbeams.

   > This is different from the TLS cable, make sure you are using the correct cable.

   

1. From the **rack sensor cable**, connect:

   * **Female end** → rack sensor
   * **Male end** → ATC shield on the SLB-EXT
      * Use **Rack 1** or **Rack 2** port

   

   

## Tool Length Sensor



## TLS Mounting

We will be mounting the TLS on the **back right corner of the AltMill**, next to the tool rack. If you have an MK1 with dust covers, you will need to mount under them.

1. Put the TLS base and body together.

1. Pre-assemble **two (2) M5 - 10mm screws** with the **M5 - T-nuts** on the TLS.

1. Slide the TLS into the **right Y-axis rail T-slot**.

1. Secure the TLS by tightening the M5 fasteners.

1. Then route the **TLS cable** through the cable clips:

   * Leave the **green connector** end at the SLB-EXT, unconnected
   * Leave the **black Molex connector** at the back right of the AltMill, next to the tool rack, unconnected

   

1. Plug the **green connector** into the **TLS port** on the SLB-EXT.

   

1. Plug the **black Molex connector** from the TLS cable into the TLS.

   

   

Your tool rack and TLS are now completely assembled!
