Sienci-Labs/Resources/atc/atc-assembly/atc-unboxing.md

---
title: 1. ATC Unboxing
menu_order: 2
post_status: publish
post_excerpt: Start building your Automatic Tool Changer. 
post_date: 2026-02-10 11:10:53
taxonomy:
    knowledgebase_cat: atc-assembly
    knowledgebase_tag: 
custom_fields:
    KBName: AutoToolChanger
    basepress_post_icon: bp-caret-right
skip_file: no
featured_image: 
---

https://youtu.be/Y2mevczdZ8M

Make sure you have all the parts you need for a smooth and painless assembly; open all boxes and unwrap the parts. Check for missing parts using the lists below.

## Package Contents

### ATC Box

| Part Name | Qty | Notes |
| --- | --- | ----- |
| Sienci ATC | 1 |In foam|
| ISO20 Tool Holder (Spindle Only Kit) | 3 |In foam|
| MicroSD Card | 1 | |
| ATC Shield (SLB-EXT) | 1 | |
| RJ12 Cable - 0.2m | 1 | |
| M4 - 8mm Flat Head Screw | 7 | |
| M5 - 10mm Socket Head Screw | 7 | |
| M6 - 14mm Button Head Screw | 8 | |
| M6 - 25mm Button Head Screw | 5 | |
| M5 Lock Nut | 5 | |
| M6 Shoulder Screw | 2 | |
| Eccentric Bushing | 1 | |
| 4mm Allen Key (Ball end) | 1 | |
| 2.5mm Allen Key | 1 | |
| 2mm Allen Key | 1 | |
| 1/2" NPT Straight Fitting (8mm) | 1 | |
| ATC Drag Chain Arm | 1 | |
| Z-Plus Drag Chain Bracket | 1 |2x4/4x4|
| ISO20 Wrench Set | 1 | |
| 2.2kW Enclosed VFD | 1 | |
| VFD Controller Cable | 1 | |
| VFD Mounting Spacer | 1 | |
| M5 - 30mm Socket Head Screw | 4 | |
| M5 Lock Nut | 2 | |
| Sienci TLS | 1 | |
| TLS Cable | 1 | |
| M5 - 10mm Button Head Screw | 2 | |
| M5 T-nut | 2 | |
| Z-axis Drag Chain | 1 |2x4/4x4|
| Plug-In Spindle Cable | 1 |2x4/4x4|
| Plug-In Spindle Cable - 7.2m | 1 |  4x8  |
| ATC Signal Cable | 1 | |
| 8mm Pneumatic Tubing | 1 | |
| 240V VFD Power Cord | 1 | |
| ER20 Collet Set (Spindle Only Kit) | 1 |12 pcs |
| ATC Mounting Plate | 1 | |
| Cable Clips | 4 | |
| Cable Ties | 4 | |

#### Dust Shoe (Packed in ATC Box)

| Part Name | Qty | Notes |
| --- | --- | ----- |
| Upper Dust Shoe | 1 | |
| Lower Dust Shoe | 1 | |
| 4" Hose Clamp | 1 | |
| Clear Cut ATC Bracket | 1 | |
| Clear Cut ATC Front Gasket | 1 | |
| Clear Cut ATC Rear Gasket | 1 | |
| Clear Cut ATC Slider Bushing | 2 | |
| ATC Hose Bracket | 1 | |
| M4 - 4mm Button Head Screw | 4 | |
| M5 - 16mm Socket Head Screw | 4 | |
| M6 - 14mm Button Head Screw | 2 | |
| M6 Washer | 3 | |
| Dust Shoe Handle | 2 | |

### Filter Regulator Box (Add-on)

| Part Name | Qty | Notes |
| --- | --- | ----- |
| Auto Drain Filter Regulator | 1 | |
| 3/8" BSPP Straight Fitting (8mm) | 2 | |
| Quick-Disconnect Ball Valve | 1 | |

### Tool Rack Box (6 Tools)

| Part Name | Qty | Notes |
| --- | --- | ----- |
| ISO20 Tool Holder | 6 | |
| ER20 Collet Set | 1 |12 pcs |
| Tool Rack Backbone | 1 | |
| Front Rack Section | 2 | |
| Back Right Rack Section | 1 | |
| Back Left Rack Section | 1 | |
| Support Extrusion | 1 | |
| Tool Holder Clip | 10  | |
| Tool Rack Knob | 2 | |
| M4 - 8mm Button Head Screw | 20  | |
| M5 - 16mm Socket Head Screw | 5 | |
| M6 - 8mm Button Head Screw | 12  | |
| M3 - 20mm Socket Head Screw | 2 | |
| M6 Twist-In T-nut | 5 | |
| M6 Roll-in T-nut | 7 | |
| ATC Rack Sensor | 1 | |
| ATC Rack Sensor Cable | 1 | |
| Cable Clips | 4 | |
| Cable Ties | 4 | |
