Sienci-Labs/Resources/atc/atc-assembly/atc-vfd-install.md

---
title: 3. ATC VFD Install
menu_order: 4
post_status: publish
post_excerpt: How to connect your VFD to your ATC system. 
post_date: 2026-02-10 11:16:53
taxonomy:
    knowledgebase_cat: atc-assembly
    knowledgebase_tag: 
custom_fields:
    KBName: AutoToolChanger
    basepress_post_icon: bp-caret-right
skip_file: no
featured_image: _images/_atc/_atc_assembly/_vfd/atc_assembly_vfd_header1.jpg
---

## VFD Installation & Connections





https://youtu.be/cG_Ziu_uB1U

1. If you already have the **VFD mounting spacer and E-stop assembled**, go to the next step! Otherwise:
  
    * Fully seat two (2) M5 lock nuts into the VFD mounting spacer. Place the VFD mounting spacer onto the **inner face of the front-left AltMill leg**, then assemble the E-stop on the outer face of the leg using two (2) M5-30mm screws.



1. Route the blue connector from the spindle cable through the table leg cutout.

  

1. Plug the spindle cable connector into the bottom of the enclosed VFD.

1. Mount the enclosed VFD inside the table leg using the remaining two (2) M5 - 30mm screws. Ensure that the VFD is positioned so you can see the screen through the table leg cutout.



1. Plug the **E-stop cable** back into the SLB-EXT.

1. Plug the **VFD power cord** into the VFD.

1. Plug the coiled **VFD controller cable** into the VFD.

### Finishing Up Connections

1. Turn **off** the **SLB-EXT**.

1. On the SLB-EXT, remove the **top row of green connectors** (marked in red), above the rectangular black header connector (marked in blue). We need to make space to install the ATC shield, which will eventually plug into that **black header connector**.

  

1. Connect the **RJ12 cable** into the **ATC shield**.

1. Connect the other end of the **signal cable** to the **ATC shield**.

  

1. Then plug in the **ATC shield** onto the **black header connector** on the SLB-EXT.

  

1. Connect the other end of the **RJ12 cable** to the **PENDANT port** on the SLB-EXT.

  

1. Connect the other end of the coiled **VFD controller cable** into the **RS485** port on the SLB-EXT.

  

1. Insert the **SD card** into the **SD card slot** on the SLB-EXT. Make sure it fully sits in the port.

  

## Wiring Sanity Check

Use this section to double-check all connections:

* **Spindle Cable**
  `Spindle (aviation) → VFD (aviation)`

* **Signal Cable**
  `Spindle (aviation) → ATC shield`

* **VFD Controller Cable**
  `VFD (RJ / Ethernet) → RS485 port on SLB-EXT`

* **VFD Power Cable**
  `VFD (IEC) → Power outlet (NEMA 6-15P)`

* **RJ12 Cable**
  `ATC shield → PENDANT port on SLB-EXT`
