Sienci-Labs/Resources/altmill/am-mk2-assembly/ytsb-am-mk2-controller-setup.md

---
title: ytsb 8. Controller Setup
menu_order: 9
post_status: draft
post_excerpt: 
post_date: 2024-11-05 09:13:53
taxonomy:
    knowledgebase_cat: am-mk2-assembly
    knowledgebase_tag: 
custom_fields:
    KBName: AltMill CNC
    basepress_post_icon: bp-caret-right
skip_file: yes
featured_image: 
---
