Sienci-Labs/Resources/gcontrol/gc-assembly/ytsb-gc-gcontrol-assembly.md

---
title: ytsb gControl Assembly
menu_order: 1
post_status: draft
post_excerpt: 
post_date: 2024-11-05 09:13:53
taxonomy:
    knowledgebase_cat: gc-assembly
    knowledgebase_tag: 
custom_fields:
    KBName: gControl Computer
    basepress_post_icon: bp-caret-right
skip_file: yes
featured_image: 
---
