Sienci-Labs/Resources/laserbeam/lb-assembly/ytsb-lb-cables-and-connections.md

---
title: ytsb Cables and Connections
menu_order: 4
post_status: draft
post_excerpt: 
post_date: 2021-12-23 12:56:20
taxonomy:
    knowledgebase_cat: lb-assembly
    knowledgebase_tag:
        - laser
custom_fields:
    KBName: LaserBeam
    basepress_post_icon: bp-caret-right
skip_file: yes
featured_image: 
---

<h3><strong>Parts List:</strong></h3>
<ul>
  <li>Laser diode extension cable (2.5m, blue)</li>
  <li>Laser cooling fan extension cable (2.5m, red) </li>
  <li>Air assist extension cable (2.5m, yellow) </li>
  <li>PWM signal extension cable (0.6m, purple) </li>
  <li>LaserBeam driver</li>
</ul>
If you have the AltMill you will need a longer set of extension cables, which will be released soon. In the meantime you can run the existing cables outside of the drag chain, fastened with zip ties.

If you wish to route the laser cables through the LongMill drag chain, you will need to unclip all the drag chain links.  


<p style="text-align: center;"><i>Unclipping drag chain links using flat head screwdriver </i></p>
Route the blue, red and yellow cables through the entire drag chain, making sure the cables are able to reach the connectors at the laser.


<p style="text-align: center;"><i>Front view of cable routing path</i></p>

<p style="text-align: center;"><i>Back view of cable routing path</i></p>

<p style="text-align: center;"><i>Blue, red and yellow cable connectors next to laser diode assembly </i></p>
For each connection, make sure that the red wire from the female side meets with the red wire from the male side. Attach the fan connector to the red cable. Attach the diode connector to the blue cable. Make sure not to mix the diode and fan connections!


<p style="text-align: center;"><i>Red and blue cables connected to cooling fan and diode respectively</i></p>

<p style="text-align: center;"><i>Cooling fan and diode connections</i></p>
Once you are sure the cables are properly positioned and attached, close your drag chain tabs.

The following instructions will detail cable connections to the laser driver and/or CNC control board, whether you have the SLB/SLB-EXT or the LongBoard.
<h3><b>Laser diode → Driver</b></h3>
The laser diode will receive power through the driver. Assuming one end of the blue cable is already plugged into the diode, connect the blue cable to the driver. Make sure that the location of the driver connection is correct as shown.


<p style="text-align: center;"><i>Laser diode to driver connection</i></p>

<h3><b>Cooling Fan → Driver</b></h3>
The cooling fan will also receive power through the driver. Assuming one end of the red cable is already plugged to the fan, connect the red cable to the driver. Make sure that the location of the driver connection is correct as shown.


<p style="text-align: center;"><i>Cooling fan to laser driver connection</i></p>

<h3><b>Air Assist → Driver (Optional) </b></h3>
To simplify your building process, we will leave the air assist assembly off the diode. However, we can plug one end of the yellow cable into the driver, leaving the other end free, in case you need to use air assist in the future. Make sure that the location of the driver connection is correct as shown.


<p style="text-align: center;"><i>Air assist to laser driver connection</i></p>

<h3><b> Driver → Controller </b></h3>
This connection allows you to control your laser through the CNC controller. The driver uses this PWM signal to turn on/off the laser, as well as adjust the intensity and frequency.

On one end, plug in the male connector to the driver's PWM signal input, at the location shown in the photo.


<p style="text-align: center;"><i>Connecting PWM signal input to driver</i></p>
<span style="color: #800000;"><b>The following steps will vary whether you have the LongBoard or the SLB. Please read carefully to ensure you complete the proper steps for your controller.</b></span>

For the <b>LongBoard</b>, plug in one end of the purple cable to the controller, making sure the red wire is seated at the "SpinPWM" and the black wire is seated at "GND."


<p style="text-align: center;"><i>Connecting PWM signal input to LongBoard </i></p>
If your controller is an <b>SLB or SLB-EXT</b>, you will plug in the cable at the "LASER" port. Ensure that the red wire cable is seated at the "PW" port and the black wire is seated at the "GD<b>"</b> port.


<p style="text-align: center;"><i>Side view of SLB with LASER port indicated</i></p>

<p style="text-align: center;"><i>Front view of SLB with PWM signal connector inserted </i></p>
