Sienci-Labs/Resources/laserbeam/lb-assembly/ytsb-lb-gsender-settings.md

---
title: ytsb gSender Settings
menu_order: 10
post_status: draft
post_excerpt: To enable the LaserBeam on gSender, first determine which controller you have. Then follow the instructions below for your specific controller. Set Up for LongBoard Set Up for SLB or SLB-EXT.
post_date: 2024-09-13 14:30:20
taxonomy:
    knowledgebase_cat: lb-assembly
    knowledgebase_tag:
        - laser
custom_fields:
    KBName: LaserBeam
    basepress_post_icon: bp-caret-right
skip_file: yes
featured_image: 
---

To enable the LaserBeam on gSender, first determine which controller you have. Then follow the instructions below for your specific controller.
<h3>Set Up for LongBoard</h3>
[su_spoiler title="<b>LongBoard:</b>" open="no" style="fancy" icon="chevron" anchor_in_url="yes"]

On gSender, connect to your machine.

Click the gray bar at the bottom labelled "Firmware." Then click on <strong>Grbl.</strong>



Hover over the top of the menu. Under "Recognized Devices" there should be only one option that says <strong>use grbl at 115200 baud,</strong> so let's select that.



Next we will go to the gear icon to check the locally stored settings. Navigate to "Laser/Spindle." Then <strong>toggle Spindle/Laser. </strong>

[caption id="attachment_9031" align="aligncenter" width="960"] Toggling Spindle/Laser[/caption]

Make sure that under "Laser Power" settings, <strong>Min Power = 0</strong> and <strong>Max Power = 255.</strong> Then exit the window.



To check that the laser is set up properly, use the console to see that $30 and $31 are being changed to the correct values each time you <strong>toggle to Laser Mode. </strong>



[/su_spoiler]
<h3>Set Up for SLB or SLB-EXT</h3>
[su_spoiler title="SLB or SLB-EXT<b>:</b>" open="no" style="fancy" icon="chevron" anchor_in_url="yes"]

On gSender, connect to your machine.

Click the gray bar at the bottom labelled "Firmware." Then click on <strong><b>grblHAL.</b></strong>



Hover over the top of the menu. Under "Recognized Devices" there should be only one option that says use <strong>grblHAL at 115200 baud</strong>, so let's select that.



Once you have connected, we will go to the gear icon. Navigate to "Laser/Spindle." Then <strong>toggle Spindle/Laser. </strong>



Exit the window. Then press "Firmware" on the top bar.



In the Firmware Tool box, make sure the following settings are correctly selected.

Make sure <strong>$30 = 24000</strong>, <strong>$31 = 7200 or 7500</strong> and that <strong>$32 is set to Normal.</strong> These are usually the default settings that come with the SLB/SLB-EXT.



Find <b>$395</b> and check that<b> "SLB_SPINDLE"</b> is selected. If you are using the <strong>Sienci Labs Spindle</strong>, select <b>"H-100"</b> instead.

Then, go to<b> $511</b> and check that "<b>SLB_LASER"</b> is selected.



Scroll down further and check that <strong>$730 = 255 and $731 = 0. </strong>



Save these settings by pressing <b>"Apply New Settings."</b> Then<b>, turn off and on the control board</b> to make sure these settings are enabled.



[/su_spoiler]
