Sienci-Labs/Resources/laserbeam/lb-assembly/ytsb-lb-introduction.md

---
title: ytsb Introduction
menu_order: 2
post_status: draft
post_excerpt: 
post_date: 2024-09-13 14:30:20
taxonomy:
    knowledgebase_cat: lb-assembly
    knowledgebase_tag:
        - laser
custom_fields:
    KBName: LaserBeam
    basepress_post_icon: bp-caret-right
skip_file: yes
featured_image: 
---

Ready to set up your LaserBeam? The following information will help you get your laser up and running successfully on your CNC machine, whether that be the LongMill or the AltMill. The expected assembly time is around <b>1-2 hours</b>, so make sure you give yourself enough time to read through the steps and not rush the process.

Before you start assembling, we would recommend completing the following:
<h3>Grab your Tools</h3>
The LaserBeam only requires a few tools, which are probably in your tool chest already.
<ul>
  <li aria-level="1">M5 Allen key or a drill with an M5 Allen key driver bit</li>
  <li aria-level="1">Small flat head screwdriver</li>
  <li aria-level="1">Zip ties</li>
</ul>

<p style="text-align: center;"><i>M5 Allen key and flat head screwdriver </i></p>

<h3>Download Software</h3>
In order to completely set up your laser, please have gSender and LightBurn installed.

<a href="https://sienci.com/gSender/">gSender</a> will allow you to control the laser for initial testing and firmware settings, instructions for downloading the software <a href="https://resources.sienci.com/view/gs-installation/">can be found here.</a>

<a href="https://lightburnsoftware.com/pages/download-trial">LightBurn</a> will allow you to design and generate g-code for your projects; in the later steps we will indicate which settings must be changed to ensure a successful laser job. There is a 30-day trial you can download, so you do not need to immediately purchase it.
<h3>Load Up the Videos</h3>
If you prefer videos over text instructions, go ahead and watch Scott's video series on how to assemble and set up your LaserBeam, as well as run your first job!

https://www.youtube.com/watch?v=NT0T25j3XDQ

https://www.youtube.com/watch?v=MNUhwSkhGSk

https://www.youtube.com/watch?v=Y5tjbXcyzaI
