Sienci-Labs/Resources/laserbeam/lb-assembly/ytsb-lb-lightburn-settings.md

---
title: ytsb LightBurn Settings
menu_order: 9
post_status: draft
post_excerpt: 
post_date: 2021-12-23 12:56:20
taxonomy:
    knowledgebase_cat: lb-assembly
    knowledgebase_tag:
        - laser
custom_fields:
    KBName: LaserBeam
    basepress_post_icon: bp-caret-right
skip_file: yes
featured_image: 
---

On LightBurn, press the wrench icon on the top toolbar. A dialog box should appear with the title "Device settings for grbl."


<p style="text-align: center;"><em>Wrench icon on LightBurn</em></p>
Make sure that:
<ul>
  <li>"S-value max" is set to <strong>255</strong> – Setting your S value max correctly will ensure you have access to 100% of your laser's power. This value should always match your maximum spindle speed in gSender (more details in <a href="https://resources.sienci.com/view/lb-gSender-settings/">gSender Settings</a>)</li>
</ul>

<p style="text-align: center;"><em>LightBurn S-value max setting</em></p>

<ul>
  <li>"Origin" is set as the <strong>bottom left corner</strong> – If you change this, it will flip your work surface when exporting your g-code so it is best to stick with this setting</li>
</ul>

<p style="text-align: center;"><em>Setting origin of projects on LightBurn</em></p>

<ul>
  <li>Under "Z Axis Control," toggle "Enable Z axis" to <strong>ON</strong> – This will allow the machine to move down during laser cutting operations.</li>
</ul>

<p style="text-align: center;"><em>Enable Z axis on LightBurn</em></p>

<ul>
  <li>Press "<strong>OK</strong>" to save your settings</li>
</ul>
