Sienci-Labs/Resources/laserbeam/lb-assembly/ytsb-lb-set-xy-zeros.md

---
title: ytsb Set XY Zeros
menu_order: 13
post_status: draft
post_excerpt: 
post_date: 2024-09-13 14:30:20
taxonomy:
    knowledgebase_cat: lb-assembly
    knowledgebase_tag:
        - laser
custom_fields:
    KBName: LaserBeam
    basepress_post_icon: bp-caret-right
skip_file: yes
featured_image: 
---

<span style="color: #800000;"><b>Put on your laser safety glasses for this section! </b></span>

The purpose of this section is to set your XY origin (aka zeroing) so that the workpiece is positioned correctly for your laser project. Remember we will set our zeros on the <b>bottom left</b> corner of the workpiece, which corresponds to how we set up our LightBurn projects.

The following instructions assume you have already focused your laser. If you have not done this yet, please see this page <a href="https://resources.sienci.com/view/lb-focusing/">here.</a>  

Use a scrap block of wood the same height as your workpiece. We will use its square corner to zero your CNC machine. On gSender, jog the machine to where you would like the workpiece to sit. Put the block underneath the laser diode, then turn <b>ON</b> your laser driver. On gSender, make sure the laser power is at <b>1%</b>, then press "<b>Laser On</b>" on gSender. Position the block or slowly jog the machine, until the block corner is underneath the beam.


<p style="text-align: center;"><i>Beam positioned at corner of scrap material </i></p>
Press <b>"Laser Off"</b> to disable the laser. Then press "<b>Zero X</b>" and <b>"Zero Y</b>" to set our zeros for the X and Y axis. Use a pencil or tape to mark the zero position at the block corner, so that you can easily swap out the scrap for your actual workpiece.


<p style="text-align: center;"><i>Marking the corner of the scrap block</i></p>
You are now ready to load up a project and start burning!
