Sienci-Labs/Resources/laserbeam/lb-assembly/ytsb-lb-setting-max-current-dip-switch.md

---
title: ytsb Setting Max Current DIP Switch
menu_order: 7
post_status: draft
post_excerpt: 
post_date: 2021-12-23 12:56:20
taxonomy:
    knowledgebase_cat: lb-assembly
    knowledgebase_tag:
        - laser
custom_fields:
    KBName: LaserBeam
    basepress_post_icon: bp-caret-right
skip_file: yes
featured_image: 
---

The DIP switch is used to limit how much current goes to your laser.

Before you turn on your laser driver, ensure that all switches located on the DIP switch are set to the OFF position (upward position) to avoid any accidents.

There are 5 settings, each labelled with a number which corresponds to the maximum current limit.
<table class=" aligncenter" style="height: 862px;" width="584">
<tbody>
<tr>
<td>
<p style="text-align: center;">Label</p>
</td>
<td>
<p style="text-align: center;">Maximum current setting (A)</p>
</td>
<td>
<p style="text-align: center;">Photo</p>
</td>
</tr>
<tr>
<td>1</td>
<td>1</td>
<td></td>
</tr>
<tr>
<td>2</td>
<td>2</td>
<td></td>
</tr>
<tr>
<td>3</td>
<td>3</td>
<td></td>
</tr>
<tr>
<td>4</td>
<td>4</td>
<td></td>
</tr>
<tr>
<td>5</td>
<td>5</td>
<td></td>
</tr>
</tbody>
</table>
<b>After you have turned your laser driver on, you must set your maximum current before accessing laser driver function. We recommend setting the switch to "4." <span style="color: #800000;"><i>Warning: Ensure that you only have one switch ON (down position) at a time, or else it could cause damage to the electronics.</i></span></b>



&nbsp;
<p style="text-align: center;"><i>Setting DIP switch to 4A</i></p>
