Sienci-Labs/Resources/longmill/lm-assembly/lm-extension-kit.md

---
title: 48" Extension Kit
menu_order: 11
post_status: publish
post_excerpt: 
post_date: 2021-04-30 15:20:00
taxonomy:
    knowledgebase_cat: lm-assembly
    knowledgebase_tag:
        - mk1
custom_fields:
    KBName: LongMill CNC
    basepress_post_icon: bp-caret-right
skip_file: no
featured_image: /_images/_longmill/_assembly/_xaxisrail/lm_xaxisrail_p01 (cover).jpg
---

Congratulations on getting your LongMill MK1 48" extension kit! In just a few steps, you'll soon have a much larger CNC with 56% more cutting area than before, as well as the ability to pass full width 4' sheets of material through.

The assembly instructions are available as a PDF that you can download by clicking on the link below:

<table class="unboxing-table">
<tbody>
<tr>
<td>
[caption id="attachment_24481" align="alignnone" width="225"] LongMill 48" Extension Kit Manual[/caption]
</td>
<td> </td>
<td> </td>
<td> </td>
<td> </td>
<td> </td>
</tr>
</tbody>
</table>
