Sienci-Labs/Resources/longmill/lm-assembly/lm-more-projects.md

---
title: More Projects 🪑
menu_order: 14
post_status: publish
post_excerpt: What can you make with the LongMill? We provide ideas on projects, additional sample projects, and websites for 2D and 3D files you can download.
post_date: 2021-04-30 15:30:00
taxonomy:
    knowledgebase_cat: lm-assembly
    knowledgebase_tag:
        - mk1
custom_fields:
    KBName: LongMill CNC
    basepress_post_icon: bp-caret-right
skip_file: no
featured_image: /_images/_longmill/_assembly/_moreprojects/lm_mprojects_p2.jpg
---

There's plenty more that CNC routers like the LongMill are capable of doing once you're comfortable with the process of going from an idea on a piece of paper to a final product.

## Project Ideas

If you'd like some inspiration, we spent some time putting together a categorized list below of all the items we could think of that can be made on a CNC router.

[tabby title="General" open="yes"]

- Signs (house number, business, alert, etc.)
- Lettering (indoor decoration / kids names)
- Picture frames
- Wood boxes
- Stands, organizing trays, bins
- Clamping system
- Wood & wire inlays
- Automated CNC joinery
- Bow ties & inlays
- Stencils
- Engrave existing objects

[tabby title="Furniture"]

- Cabinetry
- Stools, step stools, poop stool
- Shelf / shelving unit / bookshelf
- Chairs
- Cradle / rocking chair
- Small bench
- Side tables / nightstands
- Laptop, tablet stands
- Monitor riser
- Coat rack
- Shoe rack
- Lamp
- Drawer pulls
- Tool storage / holders

[tabby title="Household"]

- Coasters / trivets
- Cutting boards
- Wooden plates, bowls, utensils
- Trays, charcuterie boards
- Cat / dog bowl stands
- Bottle opener
- Balance board
- Money bank
- Bookmarks / holders
- Candle holder
- Comb
- Toothbrush holder
- Shopping bag holder
- Glass rimmer
- Bookends
- Bird house
- Keychain
- Bathroom organizer

[tabby title="Toys & Activities"]

- Puzzles
- Mazes
- Chess Board
- Wooden sword
- Wooden cars / vehicles
- Board game
- Cribbage board
- Connect four
- Awards / trophies
- Elastic gun
- Wooden animals
- Dice holder / roller
- Longboard
- Slingshot
- RC cars & planes

[tabby title="Art"]

- Sculpture
- Props, model making
- Custom guitar body
- Earring, necklace, pendant
- Badge
- Topography / mountain range
- Ocean / lake carving
- 3D face
- Custom mask
- Custom stamp
- Branding iron

[tabby title="Other"]

- Injection mold dies
- Carbon fibre frames
- Circuit boards
- Lost foam / wax casting
- Gears
- Custom ruler
- Coins

[tabbyending]

## CNC Creator Guides

If you are looking for cool projects to create, then you are at the right place. We are creating individual e-books for awesome projects that we make YouTube video tutorials on called CNC Creator Guides. These guides are perfect for beginners interested in learning how to create projects on their CNC. They consist of downloadable project files and contain detailed step-by-step instructions with images, making it easier for the maker to understand and follow along. By following these guides, you can successfully build these projects and show off all your hard work.



Creator Guide List (to be continued)

- <a href="https://resources.sienci.com/wp-content/uploads/2022/03/Creator-Guide-Step-Stool-Project.pdf">Creator Guide - Step Stool Project</a>

## Online CNC File Sites

If you're looking for some more inspiration, or would like to start by making some pre-made projects, there are plenty of places online which offer pre-made artwork, drawings, and 3D models that are either free or can be purchased. In order to start you off, we put a list of some of these places together. Please note that we've done our best to filter out reliable file sources, but downloading any files online can pose a risk so be sure to only get files from sources that you trust.

[tabby title="Art / Drawings" open="yes"]

- <a href="https://rebrand.ly/84aaf2s" target="_blank" rel="noopener">Sienci Labs Projects Repository</a> (our Google Drive storing projects we featured on <a href="https://www.YouTube.com/@SienciLabs/videos" target="_blank" rel="noopener">YouTube</a>)
- <a href="https://obrary.com/collections/open-designs" target="_blank" rel="noopener noreferrer">Obrary</a>
- <a href="http://maslowcommunitygarden.org/index.html" target="_blank" rel="noopener noreferrer">Maslow Community Garden</a>
- <a href="https://www.freepatternsarea.com/free-patterns-templates/" target="_blank" rel="noopener noreferrer">FreePatternsArea (templates)</a>
- <a href="https://www.freepatternsarea.com/free-projects/" target="_blank" rel="noopener noreferrer">FreePatternsArea (projects)</a>
- <a href="https://www.ameede.com/" target="_blank" rel="noopener noreferrer">Ameede</a> (need to wait 45 seconds for download)
- <a href="https://freedxf.com/product-category/free/" target="_blank" rel="noopener">FreeDXF</a> (sign-up rqd, free &amp; paid content)
- <a href="http://3axis.co/" target="_blank" rel="noopener noreferrer">3axis.co</a> (need to wait 5 seconds for download)
- <a href="https://www.cnccookbook.com/free-dxf-files/" target="_blank" rel="noopener noreferrer">CNC Cookbook (free dxf files)</a>
- <a href="https://www.toolstoday.com/t-cnc-pattern-directories">ToolsToday Pattern Directory</a> (links to free and paid content)
- <a href="https://www.scan2cad.com/free-downloads/dxf/" target="_blank" rel="noopener noreferrer">Scan2CAD</a> (free collection every month, sign-up rqd)
- <a href="https://www.zenziwerken.de/">ZenziWerken</a> (2D and 3D files, all free, made by one guy: Daniel)
- <a href="https://cutrocket.com/list/all/" target="_blank" rel="noopener noreferrer">CutRocket</a> (good project details, files only for Carbide Create, sign-up rqd)
- <a href="https://www.inventables.com/projects" target="_blank" rel="noopener noreferrer">Inventables Projects</a> (can only open projects in Easel, sign-up rqd)
- <a href="https://www.shapertools.com/hub/search" target="_blank" rel="noopener noreferrer">ShaperHub</a> (can only open files in Shaper Website, sign-up rqd)
- <a href="https://www.readytocut.com/community/forums/cnc-art-file-sharing.136/">Ready To Cut</a> (projects from the community, sign-up rqd)
- <a href="https://akerkits.com/collections/source-files" target="_blank" rel="noopener noreferrer">AKER (source files)</a> (garden products, need to "pay" $0 for files)
- <a href="http://betterblock.org/wikiblock/designs/">wikiblock</a> (most content is paid)
- <a href="https://www.modifile.com/designs" target="_blank" rel="noopener noreferrer">modifile</a> (parametric furniture, sign-up rqd, all content is paid)
- <a href="https://www.cncdesignshop.com/" target="_blank" rel="noopener noreferrer">DesignShop</a> (paid membership rqd, most models paid in addition)
- <a href="https://aribabox.com/collections/all-designs">Ariba Box</a> (sign-up rqd, free &amp; paid content)
- <a href="https://www.etsy.com/market/cnc_patterns">Etsy (CNC patterns)</a> (sign-up rqd, all paid content)
- <a href="https://cncrouterdesign.com/">CNC Router Design</a> (sign-up rqd, all paid content)
- <a href="https://projects.buildbotics.com/explore/creations">Buildbotics Projects</a> (old, almost empty, broken images)<b></b>
- <a href="http://www.cnc4free.org/">cnc4free.org</a> (non-commercial use)
- <a href="https://filson-rohrbacher.com/work/atfab">AtFAB</a> (furniture, sign-up rqd)
- <a href="https://www.opendesk.cc/designs">https://www.opendesk.cc/designs</a> (furniture)

General sources:

- <a href="https://mydxf.blogspot.co.uk/" target="_blank" rel="noopener noreferrer">My DXF</a>
- <a href="https://lovesvg.com/product-category/free-svg-files/" target="_blank" rel="noopener">Love SVG</a>
- <a href="https://www.pngrepo.com/" target="_blank" rel="noopener">PNG Repo</a>
- <a href="https://www.svgrepo.com/" target="_blank" rel="noopener">SVG Repo</a>
- <a href="https://plotterfiles.com/" target="_blank" rel="noopener">PlotterFiles</a>
- <a href="https://www.flaticon.com/" target="_blank" rel="noopener">flaticon</a> (icons &amp; icon packs, sign-up rqd, free &amp; paid)
- <a href="https://pixabay.com/" target="_blank" rel="noopener">Pixabay</a> (must check captcha for download unless logged in)
- <a href="https://www.vhv.rs/" target="_blank" rel="noopener">VHV.RS</a> (non-commercial use)
- <a href="http://clipart-library.com/" target="_blank" rel="noopener">Clipart Library</a> (non-commercial use)
- Some of the 2D file making programs also come with a small subset of free 2D files

[tabby title="3D Models"]

- <a href="https://rebrand.ly/84aaf2s" target="_blank" rel="noopener">Sienci Labs Projects Repository</a> (our Google Drive storing projects we featured on <a href="https://www.YouTube.com/@SienciLabs/videos" target="_blank" rel="noopener">YouTube</a>)
- <a href="https://www.thingiverse.com/SienciLabs/collections/cnc-projects-to-try" target="_blank" rel="noopener noreferrer">Sienci Labs' Thingiverse collection</a> (our curated list)
- <a href="https://cults3d.com/en/tags/bas-relief" target="_blank" rel="noopener noreferrer">Cults 3D (reliefs)</a>
- <a href="https://www.thingiverse.com/search?sort=things&amp;q=cnc+projects&amp;type=collections" target="_blank" rel="noopener noreferrer">Thingiverse (CNC projects)</a>
- <a href="https://store.designandmake.com/" target="_blank" rel="noopener noreferrer">Design &amp; Make</a> (good models, sign-up rqd, most content is paid)
- <a href="https://www.vectorclip3d.com/" target="_blank" rel="noopener noreferrer">VectorClip3D</a> (sign-up rqd, most content is paid)
- <a href="https://3dwave.us/" target="_blank" rel="noopener noreferrer">3D Wave</a> (sign-up rqd, all content is paid)

General sources:

- <a href="https://www.thingiverse.com/" target="_blank" rel="noopener noreferrer">Thingiverse</a> (nice community, good selection)
- <a href="https://www.myminifactory.com/pages/explore" target="_blank" rel="noopener noreferrer">MyMiniFactory</a> (nice community, most models free)
- <a href="https://free3d.com/" target="_blank" rel="noopener noreferrer">Free3D</a> (cool models, some content is paid)
- <a href="https://www.youmagine.com/" target="_blank" rel="noopener noreferrer">YouMagine</a>
- <a href="https://clara.io/library">Clara.io</a> (medium-sized database, sign-up rqd)
- <a href="https://www.3dcontentcentral.com/" target="_blank" rel="noopener noreferrer">3DContentCentral</a> (large database, sign-up rqd)
- <a href="https://grabcad.com/library" target="_blank" rel="noopener noreferrer">GrabCAD</a> (large database, sign-up rqd)
- <a href="https://cults3d.com/en" target="_blank" rel="noopener noreferrer">Cults3D</a> (sign-up rqd, lots of paid content)
- <a href="https://pinshape.com/" target="_blank" rel="noopener noreferrer">pinshape</a> (nice community, sign-up rqd, some content is paid)
- <a href="https://thangs.com/">Thangs</a>
- <a href="https://b2b.partcommunity.com/community/partcloud/" target="_blank" rel="noopener noreferrer">PARTcloud</a> (assorted models)
- <a href="https://open3dmodel.com/" target="_blank" rel="noopener noreferrer">Open3DModel</a>
- <a href="https://libre3d.com/" target="_blank" rel="noopener noreferrer">Libre3D</a>
- <a href="https://repables.com/" target="_blank" rel="noopener noreferrer">Repables</a>
- <a href="https://touchterrain.geol.iastate.edu/" target="_blank" rel="noopener noreferrer">TouchTerrain</a> (topography generator, limited abilities)
- <a href="http://jthatch.com/Terrain2STL/" target="_blank" rel="noopener">Terrain2STL</a> (topography generator, limited abilities)
- <a href="https://terrainator.com" target="_blank" rel="noopener noreferrer">The Terrainator</a> (topography generator, sign-up rqd, paid)
- <a href="https://nasa3d.arc.nasa.gov/models/printable" target="_blank" rel="noopener noreferrer">NASA (3D resources)</a> (NASA models)
- <a href="https://www.embodi3d.com/files/" target="_blank" rel="noopener noreferrer">embodi3D</a> (medical models, sign-up rqd, some content is paid)
- <a href="https://africanfossils.org/search" target="_blank" rel="noopener noreferrer">AfricanFossils.org</a> (models of African fossils, sign-up rqd)
- <a href="https://library.zortrax.com/" target="_blank" rel="noopener noreferrer">zortrax</a> (small collection, sign-up rqd)
- <a href="https://www.3dcadbrowser.com/3dmodels.aspx">3D CAD Browser</a> (sign-up rqd, odd system of requiring uploads to download, free &amp; paid models)
- <a href="https://www.yeggi.com/" target="_blank" rel="noopener noreferrer">yeggi</a> (search engine for 3D printable models)

[tabbyending]

## More Sample Projects

There are a few more internally designed projects that you can also try out if you wish. Each project has a download which contains both the g-code files made for each specific project (pictured) and the original 3D files if you want to CAM them yourself. There are even more designs that we've made for use on the LongMill that can be found here if you're interested in giving them a shot: <a href="https://CAD.onshape.com/documents/526b7c6287b77b77c4b50603/w/e1e191a2557529d4dc468313/e/92d2cf99720fafafddaba831" target="_blank" rel="noopener noreferrer">LongMill Demo Pieces</a>

### Wooden Box

A great starting project for the woodworker at heart. The hardness of wood varies by species and other factors, however most commonly available woods such as pine, oak, cedar, maple, or cherry are quite easy to work with. A depth of cut of about 2mm at around 700mm/min works well with soft to medium hardness woods, but you should reduce the depth of cut to around 1mm if you're working with a very hard wood. Medium speed on the router at around 20,000RPM works well.

The following box was designed by Andy. It's beautiful in its simplicity and fits together nicely. Refer to our Feeds and Speeds table to set up your machine based on your choice of wood.

**Material:** Any species of wood you wish, at least 22mm tall for the base and 13mm tall for the lid
**End Mill:** 2-flute, 1/4″ end mill
**Cutting Time:** 25 minutes



[su_button url="https://resources.sienci.com/wp-content/uploads/2021/05/Wooden-Box.zip" style="flat" background="var(--sl-blue)" radius="3" center="yes" target="blank" size="5" icon="icon: arrow-down"]Download[/su_button]

### Acrylic Gear Train

Acrylic is a sturdy and useful plastic, commonly used in robotics applications due to its functionality, availability, and looks. At the right speed, acrylic and other soft plastics can be smoothly milled to yield very beautiful results. Generally, you'll want to aim for an 800mm/min feed rate at a 1.8mm depth of cut. You'll notice that there are burrs and debris left behind on the cut surfaces if the right speeds and feeds are not selected. Choose spindle speed around 24,000 RPM and adjust these settings as you need to get the best results.

This gear train was designed from scratch by Chris. If cut properly, minimal drilling should be required to use two M4 bolts and washers (or 8-32) and thread them into the gear train base.

**Material:** 6mm acrylic
**End Mill:** 2-flute, 1/8″ end mill
**Cutting Time:** 14 minutes



[su_button url="https://resources.sienci.com/wp-content/uploads/2021/05/Gear-Train.zip" style="flat" background="var(--sl-blue)" radius="3" center="yes" target="blank" size="6" icon="icon: arrow-down"]Download[/su_button]

### Aluminum Bottle Opener

A start at using the hardest material in the Mill One's capability range. Aluminum comes in a variety of alloys, but the most common is 6061 Aluminum. It's a fairly hard and strong material and can be found in aerospace components and bikes. The trickiest part of milling aluminum is preventing the aluminum chips from melting and binding to the end mill, which will stop the end mill from cutting. In order to carry the right amount of heat away via the chips, we recommend an 800mm/min feed rate at a 0.4mm depth of cut and 0.2 step over. The depth of cut is also slower, about 100mm/min.

Choosing the right spindle speed for milling aluminum is a highly debated topic for hobby CNCers. Traditional machines set their spindle speeds at around a few thousand RPM, however routers like the ones used on the Mill One run between 10,000RPM to 30,000RPM. To get around this, less flutes are used (one or two) with shallower cuts and faster feed rates.

Both of these fully functional bottle openers were designed by Chris. They have a sleek, industrial feel and are certainly conversation starters in any scenario.

**Material:** 1/4″ and 2.15mm 6061 aluminum
**End Mill:** 1-flute, 1/8″ or 3mm end mill
**Cutting Time:** 12 minutes and 2 minutes



[su_button url="https://resources.sienci.com/wp-content/uploads/2021/05/Bottle-Openers.zip" style="flat" background="var(--sl-blue)" radius="3" center="yes" target="blank" size="6" icon="icon: arrow-down"]Download[/su_button]
