Sienci-Labs/Resources/mill-one/mo-more/mo-safety-manual.md

---
title: Safety Manual
menu_order: 4
post_status: publish
post_excerpt: 
post_date: 2021-05-07 15:29:00
taxonomy:
    knowledgebase_cat: mo-more
    knowledgebase_tag:
        - mill-one
custom_fields:
    KBName: Mill One CNC
    basepress_post_icon: bp-caret-right
skip_file: no
featured_image: 
---

Your Mill One is a simple machine that can do quite complex cutting tasks. Before using your machine, please read over the below safety manual (also included in the assembly manual) in order to better understand how it should be operated in a way that keeps you safe.

We've tried to make the machine as safe to use as we could by ensuring that you are never directly interacting with line voltages and it's difficult to interact with the machine as it's cutting. We want you to enjoy your Mill One while getting the most out of it, so if you have any questions about our safety guidelines then please don't hesitate to ask.

<b>Safety Warnings and Guidelines</b>

In these warnings, you the user and original purchaser/customer of the Mill One CNC are referred to as the "operator" of the machine:

<ol>
  <li>Be sure to carefully follow provided machine assembly instructions before machine use to ensure operator safety.</li>
  <li>All wires must be appropriately positioned before beginning the operation of this machine. Cutting a "live" wire may cause exposed metal parts of the routing/trimming tool to become electrified and shock the operator.</li>
  <li>Ensure the machine is placed on a flat surface and in a well-ventilated space before operation.</li>
  <li>Always wear eye protection during machine operation.</li>
  <li>Always wear hearing protection during extended machine operation based on proximity to machine.</li>
  <li>Materials may release chemicals that are toxic or unsafe to inhale when cut. Always check the Material Safety Data Sheet (MSDS) of the material in question before cutting. Always cover exposed skin and wear appropriate airway protection (e.g. dust mask/respirator) specific to the material used and its application.</li>
  <li>Any workpiece must be appropriately secured before starting a cutting routine by clamps or other practical securing method. Holding the material by hand or employing any any other unstable form of securing will lead to unsafe loss of machine control.</li>
  <li>Cutting bits used for the Mill One should be used at the discretion of the user. Bits are sharp and can crack and break without notice so appropriate care should be taken by the user while manipulating and installing them. Carefully check bits for cracks or damage before operating the machine and replace any cracked or unfit bits immediately.</li>
  <li>Carefully inspect any consumable material before use on the machine, any unforeseen inconsistency in material hardness or material quality may cause damage to the machine.</li>
  <li>Keep away from all moving parts during machine operation.</li>
  <li>Before beginning a cutting job, ensure the router/trimmer runs properly. Immediately disable the tool if visible vibration or wobble occurs. This might indicate a damaged tool or an improperly installed bit.</li>
  <li>Make sure the bit is not contacting the workpiece before the router/trimmer tool is turned on.</li>
  <li>Do not leave the machine running unattended, the machine should only be operated with the operator present.</li>
  <li>Do not touch the cutting bit immediately after use. It may be hot and could burn the operator.</li>
  <li>Use bits that are appropriate to the material and cutting speed used.</li>
</ol>
