Sienci-Labs/Resources/laserbeam/lb-assembly/ytsb-lb-driver-power-supply.md

---
title: ytsb Driver Power Supply
menu_order: 5
post_status: draft
post_excerpt: 
post_date: 2021-12-23 12:56:20
taxonomy:
    knowledgebase_cat: lb-assembly
    knowledgebase_tag:
        - laser
custom_fields:
    KBName: LaserBeam
    basepress_post_icon: bp-caret-right
skip_file: yes
featured_image: 
---

<strong>Parts list:</strong>
<ul>
  <li>LaserBeam 12V 8A power supply</li>
</ul>
Locate the power supply and insert the female AC cable plug into the power supply.


<p style="text-align: center;"><i>AC cable plugged into power supply</i></p>
Plug in the other end of the AC cable to a power outlet that supplies 100-240VAC.


<p style="text-align: center;"><i>Power supply plugged into 100-240VAC outlet</i></p>
Plug the green male connector from the power supply into the driver power input, making sure the connection location and polarity are correct, as shown.


<p style="text-align: center;"><i>Connecting power to driver</i></p>
On the power supply, confirm that the LED is lit up, which indicates that your power supply is receiving power. Depending on your version of the power supply it may glow green or blue.


<p style="text-align: center;"><i>LED on power supply </i></p>
