Sienci-Labs/Resources/laserbeam/lb-assembly/ytsb-lb-magnetic-mount.md

---
title: ytsb Magnetic Mount
menu_order: 15
post_status: draft
post_excerpt: 
post_date: 2024-09-13 14:30:20
taxonomy:
    knowledgebase_cat: lb-assembly
    knowledgebase_tag:
        - laser
custom_fields:
    KBName: LaserBeam
    basepress_post_icon: bp-caret-right
skip_file: yes
featured_image: 
---

<h3>Introduction</h3>
The Magnetic LaserBeam Mount revolutionizes our LaserBeam system by simplifying the attachment and removal of the diode module. This add-on eliminates the need for bolting, allowing users to easily snap the LaserBeam on and off while ensuring the precise cutting and engraving quality you expect. Experience enhanced convenience and flexibility.

<b><i>Note:</i></b><i> To ensure optimal engraving and cutting quality with the AltMill or SLB, users should limit feed rates to a maximum of 5000 mm/min. </i>
<h3>Mounting and Installation</h3>
https://www.youtube.com/watch?v=d9ewhQR0w1I

The Magnetic LaserBeam Mount is compatible with all current and past versions of the steel LaserBeam Mount, Including the Vortex Riser Mount.

For mounting and installing your new Magnetic Mount you will need:
<ul>
  <li>Two M5-12 bolts (Included with the Magnetic Mount)</li>
  <li>M5 allen key</li>
  <li>Your LaserBeam diode module (original or Vortex Riser steel mount attached)</li>
</ul>
<h4>Step 1</h4>
Start by locating the two counterbored holes on the top of the Magnetic Mount. Align these holes with the corresponding holes on your router mount.

<b><i>Note:</i></b><i> Depending on your mount version, these holes may be located on the front or side of the router mount.</i>




<h4>Step 2</h4>
Insert the M5 bolts and tighten by hand just until the mount stays in place. Proceed to fully tighten with an allen key.




<h4>Step 3</h4>
Grab your LaserBeam diode module and locate the corresponding mounting holes based on which version of the product you have:



V1, V2 and the Vortex Riser Mount are shown.

<b><i>Note:</i></b><i> The Vortex Riser Mount has two options for mounting positions, as shown in the indicated holes.</i>
<h4>Step 4</h4>
Align the mounting holes with the headless M5 bolts of the Magnetic Mount and carefully slide the diode module onto the bolts until the magnets secure it in place.


<h4>Step 5</h4>
Inspect the newly mounted LaserBeam to ensure it is sitting flush with the Magnetic Mount, everything is centered and there is no visible slanting.



Start creating!


<h3>Removal</h3>
To remove the LaserBeam from the Magnetic Mount, place your hand at the bottom back of the laser and tilt it upward with slight pressure until you feel it release from the mount. Note that if you wish to attach a dust shoe onto the spindle or router, you will need to remove the LaserBeam as well as the Magnetic Mount.
