Sienci-Labs/Resources/laserbeam/lb-assembly/ytsb-lb-manual-vortex-riser-mount.md

---
title: ytsb Vortex Riser Mount
menu_order: 14
post_status: draft
post_excerpt: 
post_date: 2021-12-23 12:56:20
taxonomy:
    knowledgebase_cat: lb-assembly
    knowledgebase_tag:
        - laser
custom_fields:
    KBName: LaserBeam
    basepress_post_icon: bp-caret-right
skip_file: yes
featured_image: 
---

The LaserBeam Vortex Riser Mount was designed to raise the Z-axis height of your LaserBeam to provide more room for lens focusing. Below are video and text instructions on how to set it up.

https://www.youtube.com/watch?v=q7oTUADQ_TM
<h2>Assembly 🛠️</h2>
<strong>1.</strong> Begin by using an appropriate allen key to remove the 4 M3 bolts circled in the picture below from your standard LaserBeam Mount:

[gallery size="medium" ids="6402,6399,6401"]

&nbsp;

<strong>2.</strong> Grab your Vortex Riser Mount and align the circled mounting holes with those of the LaserBeam diode:

[gallery columns="2" link="none" size="medium" ids="6409,6407"]

&nbsp;

<strong>3.</strong> Grab the M3 bolts you removed in step 1. Insert them into the aligned mounting holes and hand tighten. From there use your allen key to the tighten them fully:

[gallery columns="2" link="none" size="medium" ids="6411,6413"]

&nbsp;

<em><strong>Note**: </strong></em>You could have flipped the Riser Mount in step 2 and attached it as shown:



This also works fine and is all up to preference. Do what works for your specific setup!

&nbsp;

<strong>4.</strong> Your LaserBeam Vortex Riser Mount is now assembled and can be attached to your LongMill:



&nbsp;
<h2>Mounting 🪛</h2>
There are a few different ways in which you can go about mounting your Vortex Riser onto your LongMill router mount. These mounting orientations vary based on your LongMill model.
<ul>
  <li>Models <b>MK1V1 - V4 (Mark 1 version 1 to 4)</b> router mounts possess holes for mounting on their side </li>
  <li>Models <b>MK1V4B - MK2 (Mark 1 Version 4B to Mark 2)</b>  possess mounting holes on their front face:</li>
</ul>
[gallery columns="2" link="none" size="medium" ids="6222,6221"]

Let's first go through the two ways to mount your Vortex Riser if you have a model <strong>MK1V4B-V2</strong>.
<h3 style="text-align: center;"><strong>Orientation 1</strong></h3>
<strong>1.</strong> Firstly, use an appropriate allen key to remove the circled M5 bolts from your router mount:

[gallery columns="2" size="medium" link="none" ids="6424,6437"]

&nbsp;

<strong>2.</strong> Line up the circled holes with the location of the removed bolts:

[gallery columns="2" size="large" link="none" ids="6430,6431"]

&nbsp;

<strong>3. </strong>Re-insert the M5 bolts previously removed in step 1 and tighten them with your allen key:



&nbsp;
<h3 style="text-align: center;"><strong>Orientation 2</strong></h3>
<strong>1.</strong> Like with orientation one, we firstly want use an appropriate allen key to remove the circled M5 bolts from your router mount.

[gallery columns="2" size="medium" link="none" ids="6424,6437"]

&nbsp;

<strong>2.</strong> Now we want to loosen the side bolt. We loosen it until the circled mounting hole on the Vortex Riser is able to slide past it and become flush with the router mount face:

[gallery columns="2" link="none" size="medium" ids="6464,6439"]

&nbsp;

<strong>3.</strong> Align the mounting holes and re-insert the previously removed M5 bolts:

[gallery columns="2" size="medium" ids="6440,6442"]

&nbsp;

<strong>4.</strong> Tighten the bolts with your allen key to complete the attachment:



&nbsp;

<strong>Now let's look at mounting with models MK1V1-V4.</strong>
<h3 style="text-align: center;">Orientation 3</h3>
<strong>1.</strong> Align your Riser Mount with the side mounting holes on the router mount:

[gallery columns="2" link="none" size="medium" ids="6451,6452"]

&nbsp;

<strong>2.</strong> Place the two M5 bolts that come with your standard LaserBeam Mount into the lined up holes. Then use an allen key and proceed to tighten the bolts to complete the attachment:

[gallery columns="2" size="medium" link="none" ids="6453,6454"]
