Sienci-Labs/Resources/laserbeam/lb-assembly/ytsb-lb-mounting-laser-assembly.md

---
title: ytsb Mounting Laser Assembly
menu_order: 3
post_status: draft
post_excerpt: 
post_date: 2021-12-23 12:56:20
taxonomy:
    knowledgebase_cat: lb-assembly
    knowledgebase_tag:
        - laser
custom_fields:
    KBName: LaserBeam
    basepress_post_icon: bp-caret-right
skip_file: yes
featured_image: 
---

<strong>Parts List: </strong>
<ul>
  <li>Laser assembly with steel mount</li>
  <li>2pcs M5-12mm socket head screws</li>
</ul>
We will first attach the laser assembly onto the router mount.

Depending on your version of the router mount, you will be able to fasten the assembly on either the left/right side or the front of your router mount.

First grab the M5-12mm screws from the Small Parts bag, and identify where the two mounting holes are on your setup.


<p style="text-align: center;"><i>Mounting holes on the side (L) or on the front (R) of the LongMill router mount</i></p>

<p style="text-align: center;"><em>Mounting holes on the AltMill router mount</em></p>
Align the 2 holes at the steel laser mount (on the laser assembly) to the 2 holes on the router mount. Then thread the two M5-12mms screw by hand.

Use a M5 Metric Allen Key to tighten both screws until firmly secured.


<p style="text-align: center;"><i>Laser diode assembly completely fastened onto LongMill router mount </i></p>
&nbsp;


<p style="text-align: center;"><em>Laser diode assembly completely fastened onto AltMill router mount</em></p>
