Sienci-Labs/Resources/laserbeam/lb-assembly/ytsb-lb-unboxing.md

---
title: ytsb Unboxing
menu_order: 1
post_status: draft
post_excerpt: 
post_date: 2021-12-23 12:56:20
taxonomy:
    knowledgebase_cat: lb-assembly
    knowledgebase_tag:
        - laser
custom_fields:
    KBName: LaserBeam
    basepress_post_icon: bp-caret-right
skip_file: yes
featured_image: 
---

<span style="color: #ff0000;"><strong>The LaserBeam 7Watt Diode Laser has been discontinued; some parts and accessories are still available <a href="https://sienci.com/product-category/laser-accessories/" target="_blank" rel="noopener">here.</a></strong></span>

Below we will outline what you will receive when you order the LaserBeam from us. If there are any missing parts, feel free to contact us and we will send them to you.

If you prefer, you can watch Scott's unboxing video instead:

https://www.youtube.com/watch?v=NT0T25j3XDQ


<h3>Foam Case</h3>
The most delicate and important parts of the LaserBeam are included in the foam case:
<ul>
  <li>Laser Diode Assembly with Air Assist &amp; Shield Attachment</li>
  <li>5A Constant Current Laser Driver</li>
</ul>

<h3>AC Cable Padded Envelope</h3>
This padded envelope includes your 6ft AC cable
<ul>
  <li>6ft AC cable</li>
</ul>
<h3>Power Supply Box</h3>
This box contains your Laser Driver power supply
<ul>
  <li>12V 8A Power Supply</li>
</ul>

<h3>Bag #1: Small Parts</h3>
This bag includes small parts needed to fully set up your LaserBeam
<ul>
  <li>Stock G2 Lens</li>
  <li>Lens Focus Ring</li>
  <li>2pcs M5-12mm Socket Head Screws - Router Mount Hardware</li>
  <li>2pcs 7mm Lens Spring - For G2 Lens</li>
  <li>2pcs 10mm Lens Spring - For 3E, G7 or G8 Lens</li>
  <li>2pcs 13mm Lens Spring - For 3E, G7 or G8 Lens</li>
</ul>

<h3>Bag #2: Wire Set #1</h3>
This bag includes a set of wire with blue tags and a set of purple wire
<ul>
  <li>18AWG Laser Extension Cable - Blue Tag</li>
  <li>22AWG PWM Signal Cable - Purple Tag</li>
</ul>

<h3>Bag #3: Wire Set #2</h3>
This bag includes a set of wire with red tags and a set of yellow wire
<ul>
  <li>22AWG Laser Assembly Cooling Fan- Red Tag</li>
  <li>22AWG Air Assist Cooling Fan - Yellow Tag</li>
</ul>

<h3>Bag #4: Lens Focus Finder Set</h3>
This Bag includes 4 Lens Focus Finders that allow you to quickly set the correct focus height for all 4 lenses
<ul>
  <li>G2 Lens Focus Finder</li>
  <li>3E Lens Focus Finder</li>
  <li>G7 Lens Focus Finder</li>
  <li>G8 Lens Focus Finder</li>
</ul>

<h3>Laser Safety Glasses Case</h3>
This Sienci Labs branded case includes your Laser Safety Glasses with a cleaning cloth
<ul>
  <li>Laser Safety Glasses Case</li>
  <li>Laser Safety Glasses</li>
  <li>Cleaning Cloth</li>
</ul>

<h3>Additional Add-ons</h3>
<ul>
  <li>Additional Lenses</li>
  <li>Additional Safety Glasses</li>
</ul>
