Sienci-Labs/Resources/laserbeam/lb-handbook/ytsb-lb-material-guide.md

---
title: ytsb Material Guide
menu_order: 2
post_status: draft
post_excerpt: 
post_date: 2021-12-23 12:56:20
taxonomy:
    knowledgebase_cat: lb-handbook
    knowledgebase_tag:
        - laser
custom_fields:
    KBName: LaserBeam
    basepress_post_icon: bp-caret-right
skip_file: yes
featured_image: 
---

<strong><em>Cut and Engrave only laser safe materials:</em></strong><em> Never cut materials that can generate toxic fumes or are dangerous to cut/engrave, such as</em>
<ul>
  <li><em>PVC</em></li>
  <li><em>ABS</em></li>
  <li><em>Vinyl</em></li>
  <li><em>Fiberglass</em></li>
</ul>
Just like the LongMill and router settings for cnc router functionality we have created a general guideline for different materials and user settings. We advise that you use these settings as a general start point and dial in what works best for you and your specific materials. We encourage you to watch our video, go through our chart and slowly create your own to fit your specific needs

https://youtu.be/EizUVtjLsRw
<h3><b>Material Guide Chart</b></h3>
[su_table responsive="yes"]
<table>
<tbody>
<tr>
<td><b>Material</b></td>
<td><b>Cutting</b></td>
<td><b>Engraving</b></td>
</tr>
<tr>
<td><b>3mm Plywood</b></td>
<td>
<ul>
  <li>Lens: G2</li>
  <li>Speed: 2.2 mm/s</li>
  <li>Power: 100%</li>
  <li>Passes: 3</li>
  <li>Z step per pass: 1mm </li>
</ul>
For cleaner finish decrease power and z step per pass, increase speed and number of passes</td>
<td>
<ul>
  <li>Lens: G2</li>
  <li>Speed :25.4 mm/s</li>
  <li>Power:100%</li>
  <li>Passes: 1</li>
</ul>
Decrease speed for deeper and darker engraving </td>
</tr>
<tr>
<td><b>6mm Plywood</b></td>
<td>
<ul>
  <li>Lens: G2</li>
  <li>Speed: 2.2 mm/s</li>
  <li>Power: 100%</li>
  <li>Passes: 5</li>
  <li>Z step per pass: 1.2mm</li>
</ul>
For cleaner finish decrease power and z step per pass, increase speed and number of passes</td>
<td>
<ul>
  <li>Lens: G2</li>
  <li>Speed :25.4 mm/s</li>
  <li>Power:100%</li>
  <li>Passes: 1</li>
</ul>
Decrease speed for deeper and darker engraving </td>
</tr>
<tr>
<td><b>1/4" Plywood</b></td>
<td>
<ul>
  <li>Lens: G2</li>
  <li>Speed: 5 mm/s</li>
  <li>Power: 100%</li>
  <li>Passes: 16</li>
  <li>Z step per pass: 0.4mm</li>
</ul>
</td>
<td>
<ul>
  <li>Lens: G2</li>
  <li>Speed :25.4 mm/s</li>
  <li>Power:75%</li>
  <li>Passes: 1</li>
</ul>
</td>
</tr>
<tr>
<td><b>1/8th Acrylic (Opaque)</b></td>
<td>
<ul>
  <li>Lens: G2</li>
  <li>Speed: 2.2 mm/s</li>
  <li>Power: 100%</li>
  <li>Passes: 3</li>
  <li>Z step per pass: 1mm</li>
</ul>
</td>
<td>
<ul>
  <li>Lens: G2</li>
  <li>Speed :25.4 mm/s</li>
  <li>Power:100%</li>
  <li>Passes: 1</li>
</ul>
</td>
</tr>
<tr>
<td><b>Organic Leather</b></td>
<td>Organic Leather tends to shrink and deform when cutting is attempted. Although one may be able to cut organic leather. Beware that as the leather shrinks and deforms it can become a fire hazard as the laser is no longer focused. </td>
<td>
<ul>
  <li>Lens: G2</li>
  <li>Speed :25.4 mm/s</li>
  <li>Power:75%</li>
  <li>Passes: 1</li>
</ul>
</td>
</tr>
<tr>
<td><b>3mm Corrugated cardboard</b></td>
<td>
<ul>
  <li>Lens: G2</li>
  <li>Speed: 5 mm/s</li>
  <li>Power: 75%</li>
  <li>Passes: 2</li>
  <li>Z step per pass: 1.5mm</li>
</ul>
</td>
<td>
<ul>
  <li>Lens: G2</li>
  <li>Speed :25.4 mm/s</li>
  <li>Power:75%</li>
  <li>Passes: 1</li>
</ul>
</td>
</tr>
</tbody>
</table>
[/su_table]
