Sienci-Labs/Resources/longmill/lm-assembly/lm-starter-projects.md

---
title: Starter Projects 🧱
menu_order: 9
post_status: publish
post_excerpt: Beginner projects to try out on the LongMill CNC. These simple test cuts will allow you to gauge if every is working properly after assembling your machine.
post_date: 2021-04-30 15:10:00
taxonomy:
    knowledgebase_cat: lm-assembly
    knowledgebase_tag:
        - mk1
custom_fields:
    KBName: LongMill CNC
    basepress_post_icon: bp-caret-right
skip_file: no
featured_image: /_images/_longmill/_assembly/_starterprojects/lm_starterp_p1.png
---

Now that you've put together your LongMill, you're probably in a rush to run it for the first time! Well good news, we've put together two different projects for you to try out with minimal requirements and setup.

## LongMill line writing

This is a very simple file which follows a line writing to spell out "LongMill". The code that's provided below has been made to make a very shallow cut at a low speed out of a 310x45mm piece of material. These conservative settings mean that the file can be run with almost any cutting tool out of almost any type of material. To set it up, mount your material in the cutting area so that it's somewhat square to the machine. Using gSender or the control software of your preference, jog the tool over to the bottom left of where you've laid out a 310x45mm space where the tool can cut. Be sure that this space doesn't have any screws or clamps in it which will interfere with the lettering and also make sure that it's fully within the cutting area. Bring the tool down to the surface of the material (either manually or by jogging) and finally click "Reset zero" to confirm that you want to set this as the tool origin.

Tool (yellow) in the bottom left-hand corner (visualized using CAMotics)

<a href="https://resources.sienci.com/wp-content/uploads/2025/11/LongMill-line.zip">LongMill-line.zip</a>

Download the file above, 'unzip' or 'extract' it, then load it into gSender by clicking the "Load File" button. Once loaded, you'll be able to see a visualization of the tools movements. If you're satisfied, turn on your router (note this file doesn't currently contain spindle control commands) then run the file!

## CNSheep

This is the other one of our first projects, a sheep cut into foam that we call the CNSheep. The code was designed for cutting out of foam with a 2-flute, 1/8" end mill but it should also work on soft woods as well. If you don't have these tools or materials on hand, the .zip file also contains the 3D model of the sheep so that you can run it through your desired CAM software to set it up for another material or tool.

<a href="https://resources.sienci.com/wp-content/uploads/2021/05/CNSheep-files3-1.zip">CNSheep-files.zip</a>

When you're setting up to cut, follow the same setup procedure as outlined in the first project above except that the pre-built g-code starts in the <b>middle</b> instead of the front corner, so reset the zero point in the center. Any workholding method should be sufficient, you can reference these on the 'Workholding' page in 'The Basics' section of the resources. The sheep's dimensions are 100mm wide by 70mm tall and will cut 6mm deep.



If all goes well, your final product should end up looking something like this!
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
