Sienci-Labs/Resources/longmill/lm-assembly/index.md

---
title: LongMill Post
menu_order: 0
post_status: draft
post_excerpt: 
post_date: 2024-04-30 18:14
taxonomy:
    knowledgebase_cat: lm-assembly
    knowledgebase_tag:
        - mk1
custom_fields:
    KBName: LongMill CNC
    basepress_post_icon: bp-caret-right
skip_file: yes
featured_image: 
---
