Sienci-Labs/Resources/_images/_addons/addons_common/addons_tls-accessoryinstall.jpg

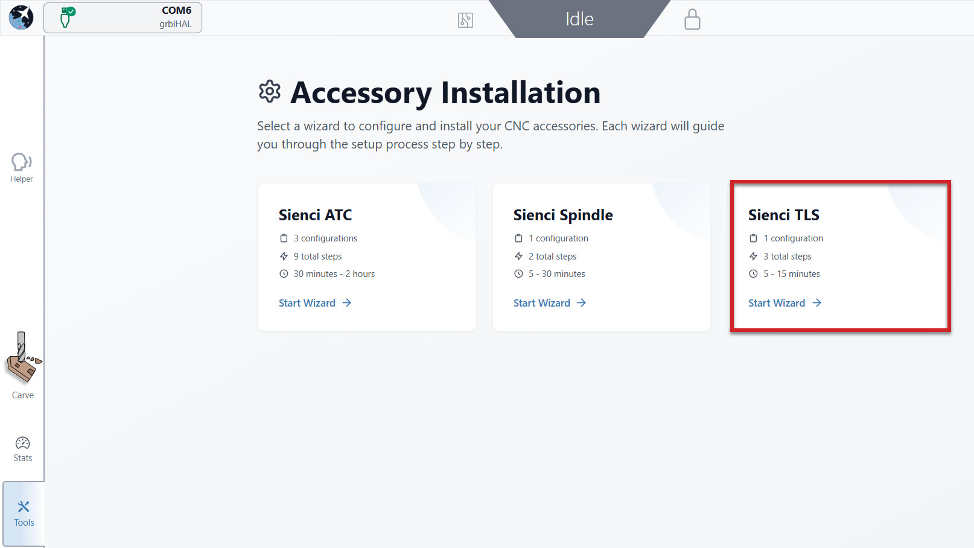
_images/_addons/addons_common/addons_tls-accessoryinstall.jpg
