Sienci-Labs/Resources/_images/_addons/addons_common/addons_tls-manuallocation.jpg

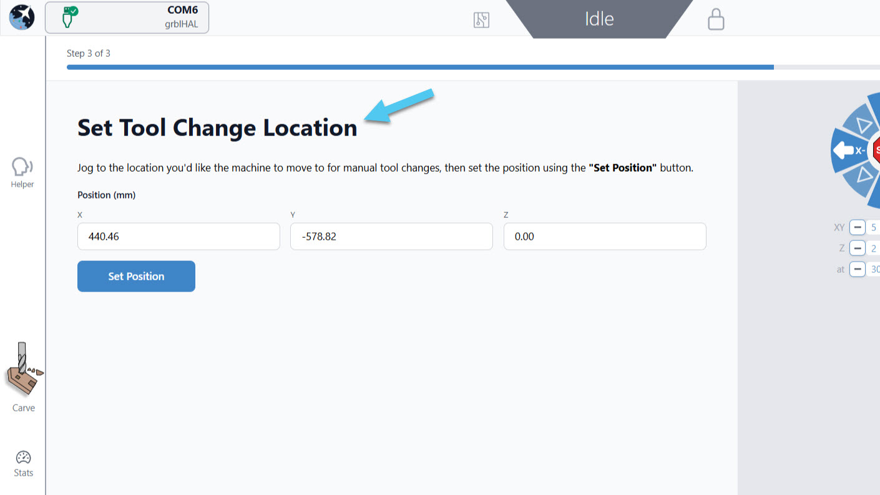
_images/_addons/addons_common/addons_tls-manuallocation.jpg
