Sienci-Labs/Resources/_images/_atc/_atc_assembly/_before/atc_assembly_before-fillercbeamv1.jpg

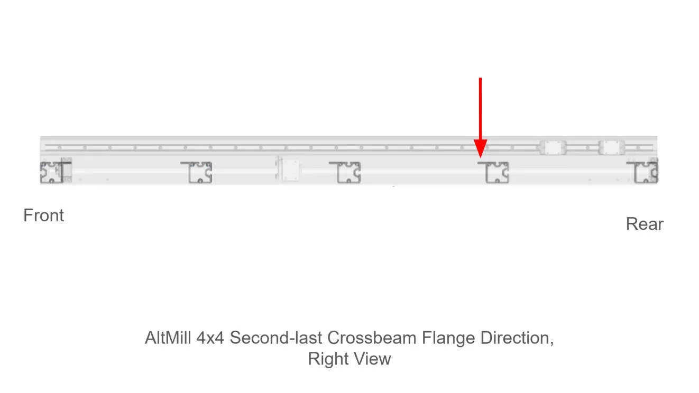
_images/_atc/_atc_assembly/_before/atc_assembly_before-fillercbeamv1.jpg
