Sienci-Labs/Resources/_images/_atc/_atc_assembly/_spindle/atc_assembly_spin-mount24on.jpg

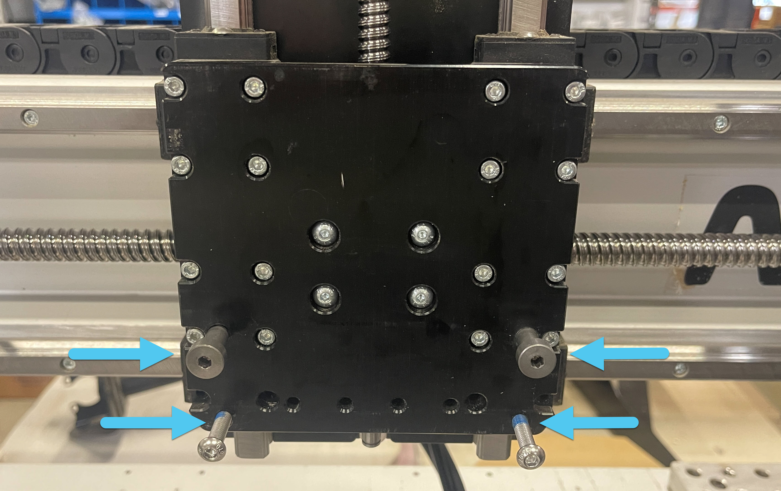
_images/_atc/_atc_assembly/_spindle/atc_assembly_spin-mount24on.jpg
