Sienci-Labs/Resources/_images/_atc/_atc_assembly/_spindle/atc_assembly_spin_finalbolts.png

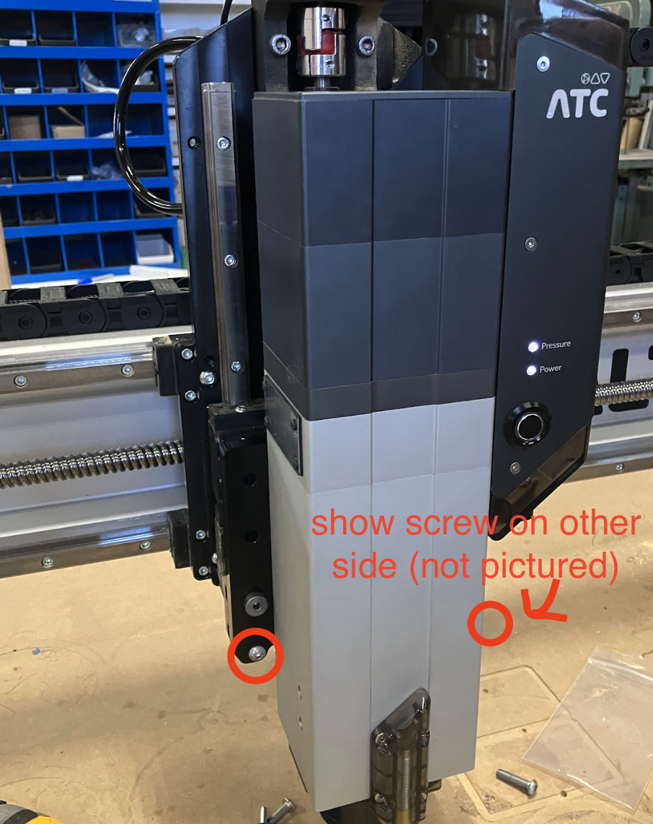
_images/_atc/_atc_assembly/_spindle/atc_assembly_spin_finalbolts.png
