Sienci-Labs/Resources/_images/_atc/_atc_assembly/_spindle/atc_assembly_spin_shoulderbolts.png

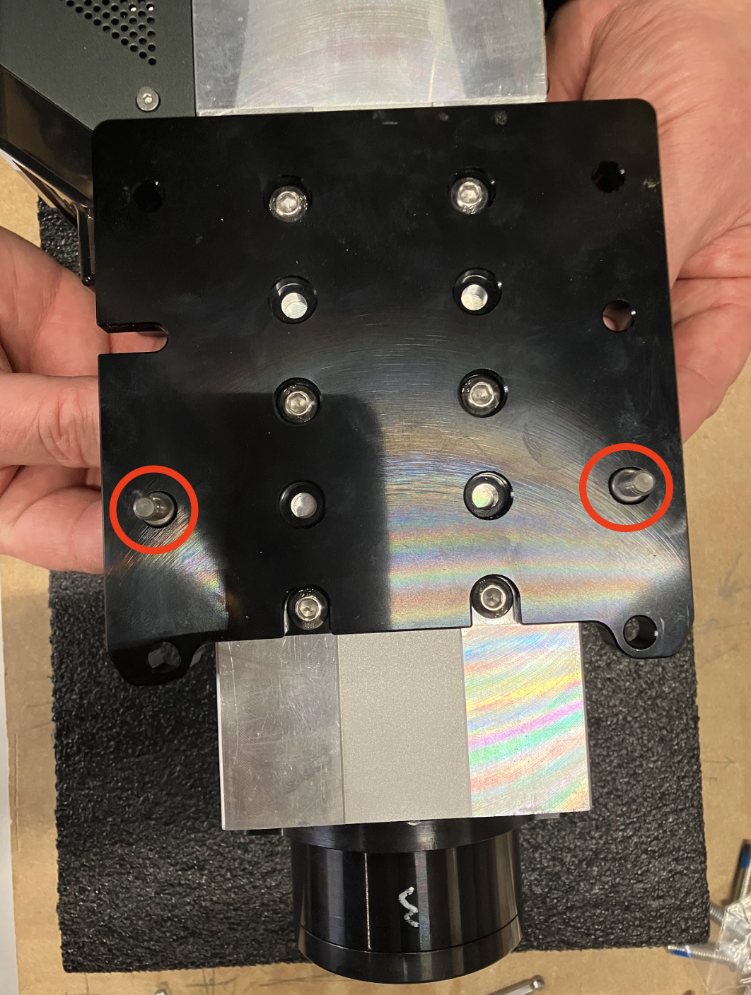
_images/_atc/_atc_assembly/_spindle/atc_assembly_spin_shoulderbolts.png
