Sienci-Labs/Resources/_images/_atc/_atc_assembly/_spindle/atc_assembly_spin_z-plus-drag1.JPG

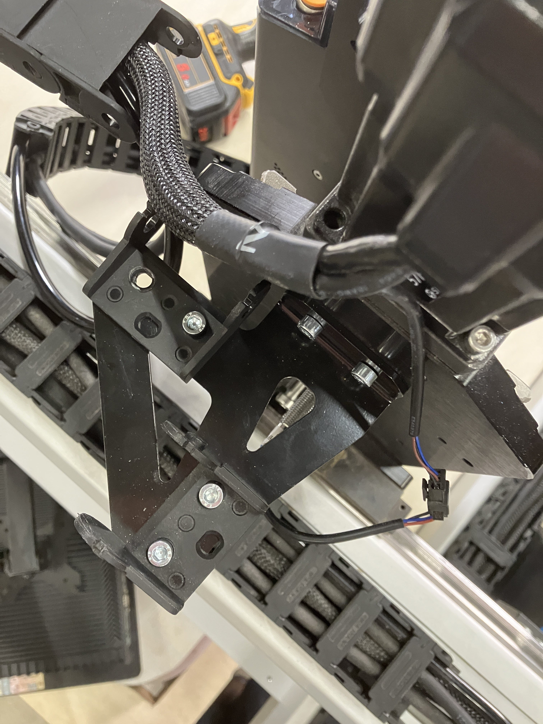
_images/_atc/_atc_assembly/_spindle/atc_assembly_spin_z-plus-drag1.JPG
