Sienci-Labs/Resources/_images/_cnc-fun/_the-basics/_workholding/cnc_ba_wo_making-dust-shoes.jpg

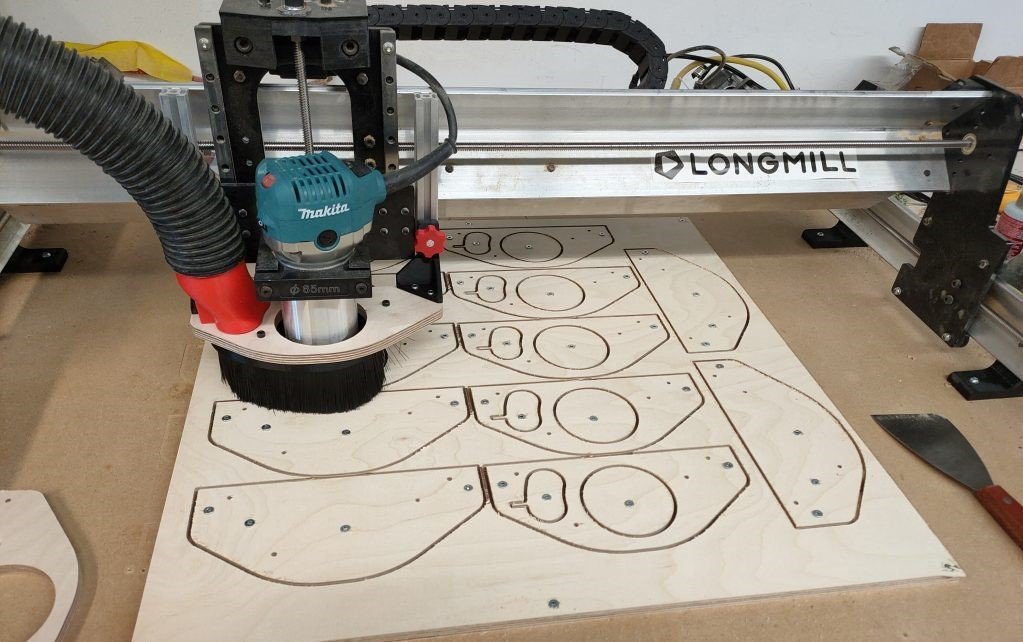
_images/_cnc-fun/_the-basics/_workholding/cnc_ba_wo_making-dust-shoes.jpg
