Sienci-Labs/Resources/_images/_gsender/_install/gs_in_mac-download.jpg

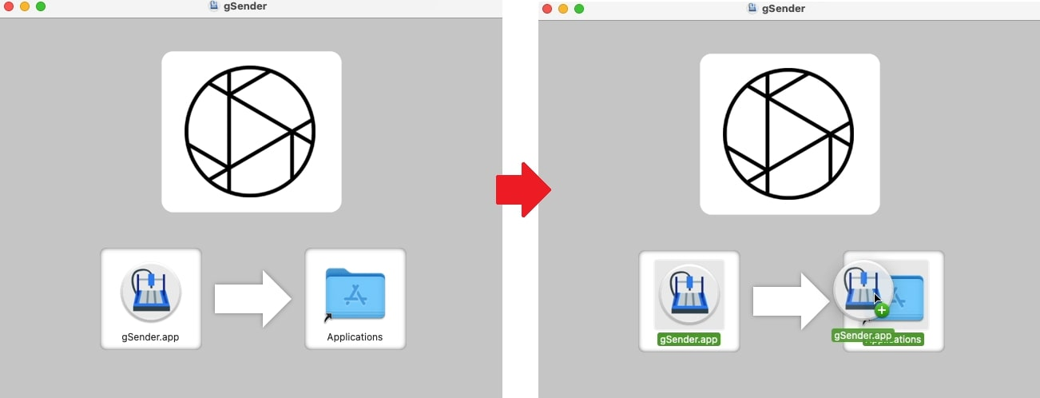
_images/_gsender/_install/gs_in_mac-download.jpg
