Sienci-Labs/Resources/_images/_gsender/_install/gs_in_ras-pi-os.jpg

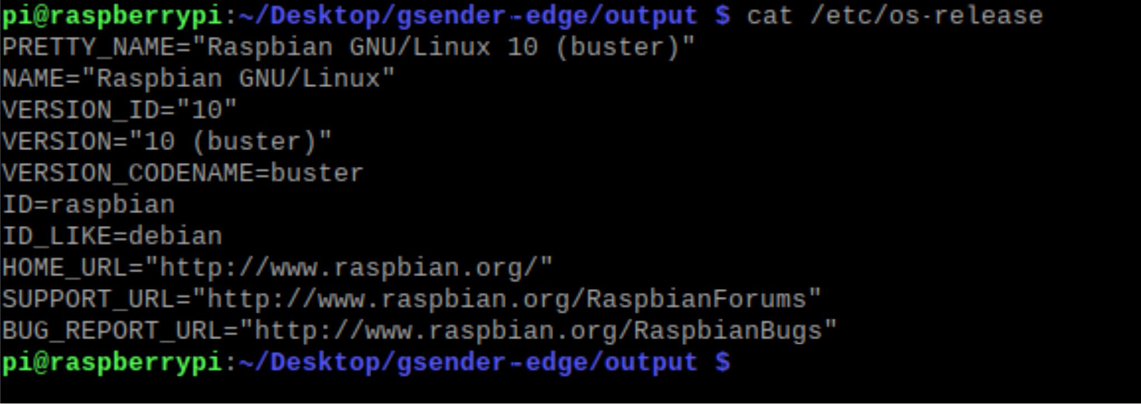
_images/_gsender/_install/gs_in_ras-pi-os.jpg
