Sienci-Labs/Resources/_images/_gsender/_install/gs_in_windows-defender-override.jpg

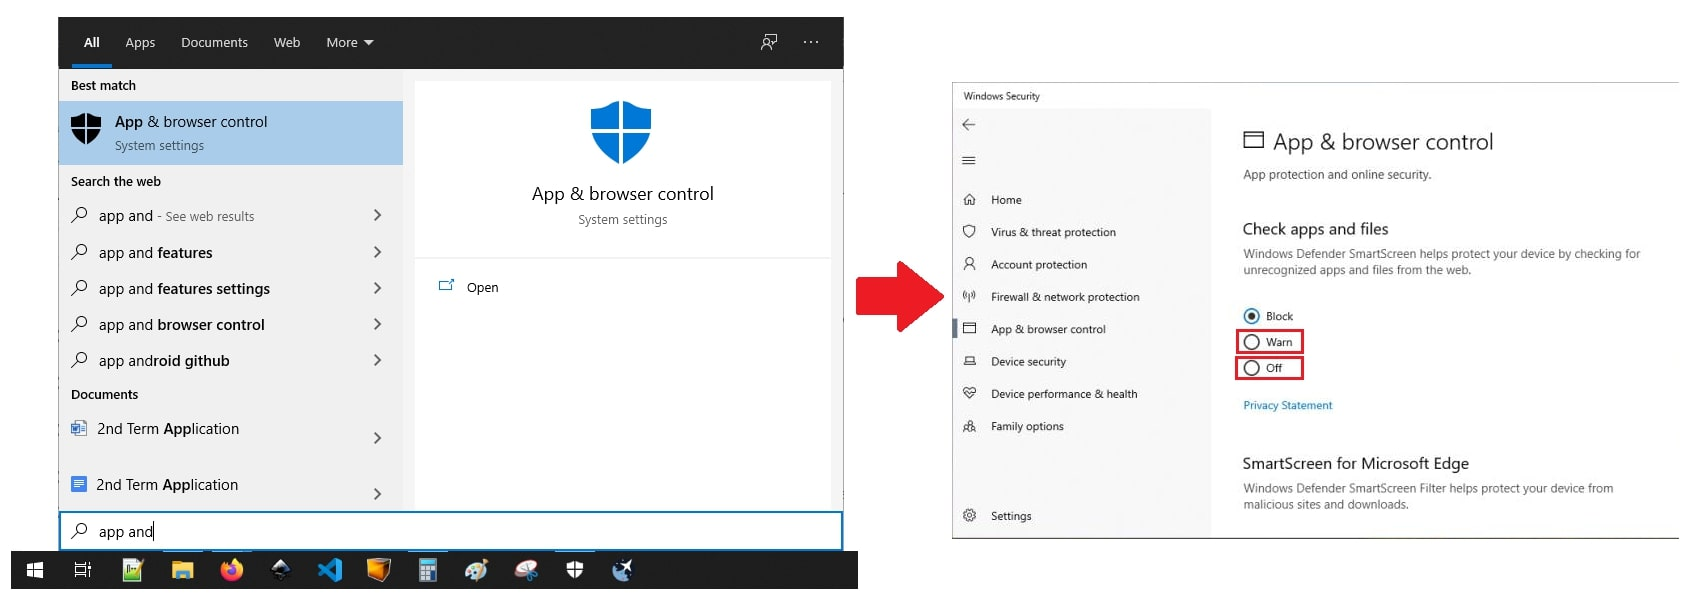
_images/_gsender/_install/gs_in_windows-defender-override.jpg
