Sienci-Labs/Resources/_images/_gsender/_install/gs_in_windows-setup.jpg

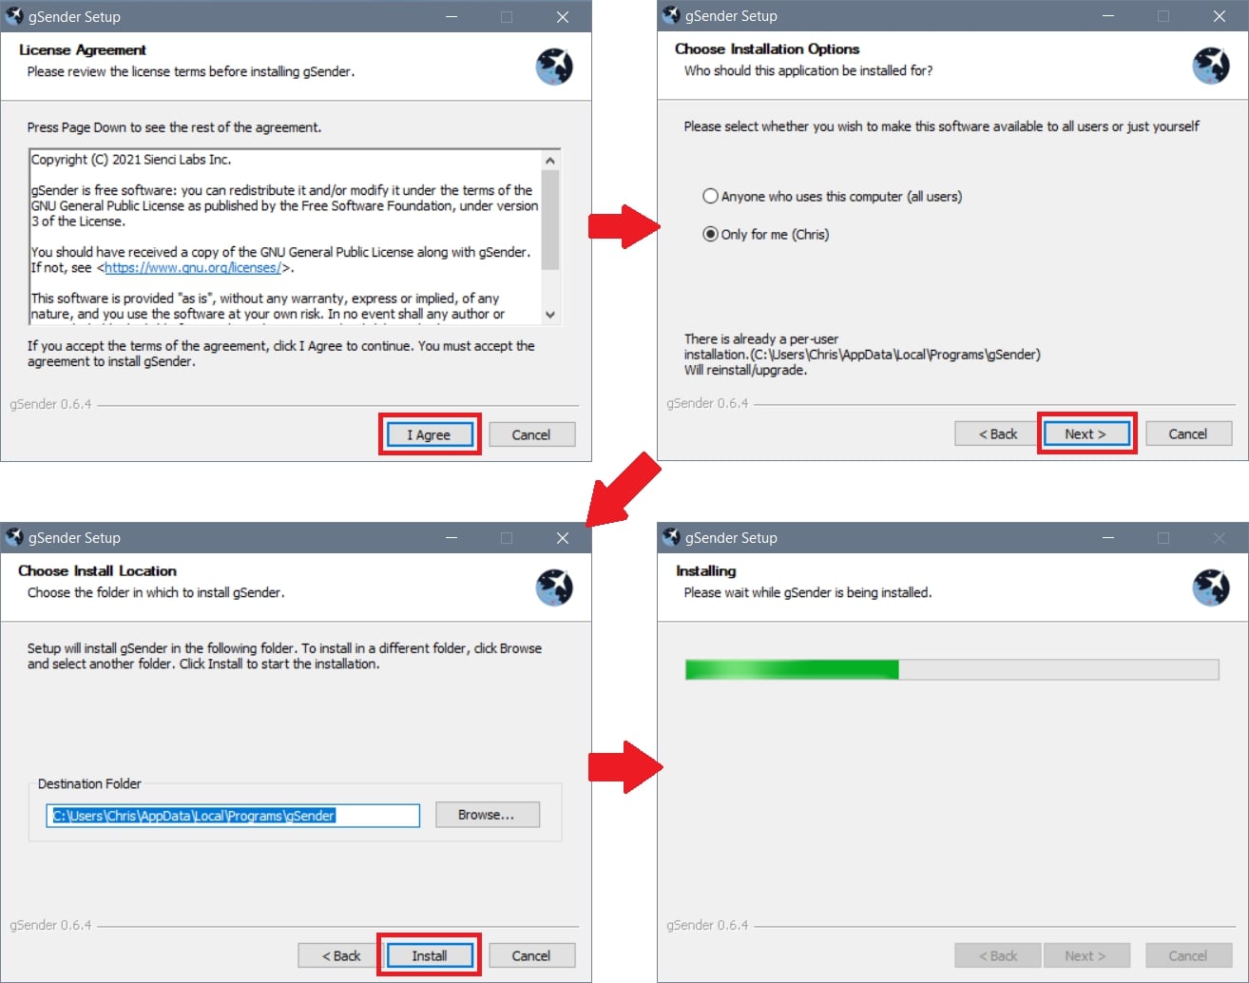
_images/_gsender/_install/gs_in_windows-setup.jpg
