Sienci-Labs/Resources/_images/_gsender/_setup/gs_se_stats-tab.jpg

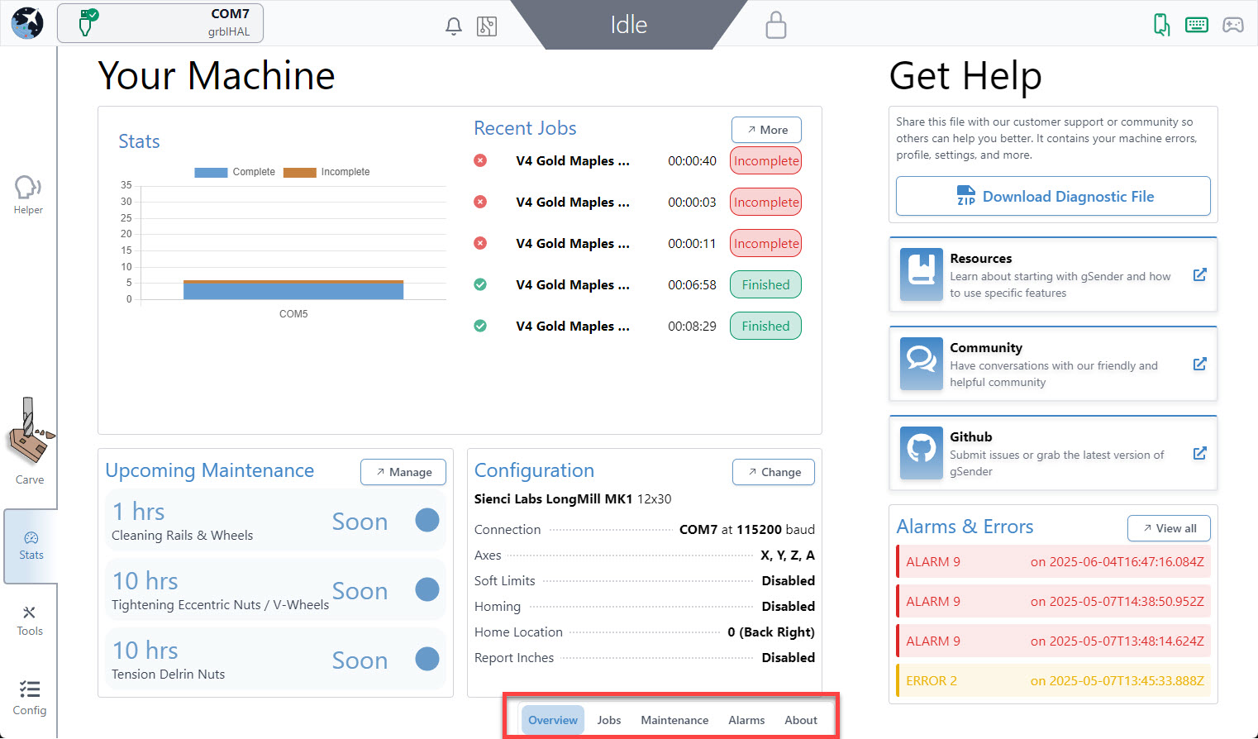
_images/_gsender/_setup/gs_se_stats-tab.jpg
