Sienci-Labs/Resources/_images/_gsender/_setup/gs_se_togglenotifs.jpg

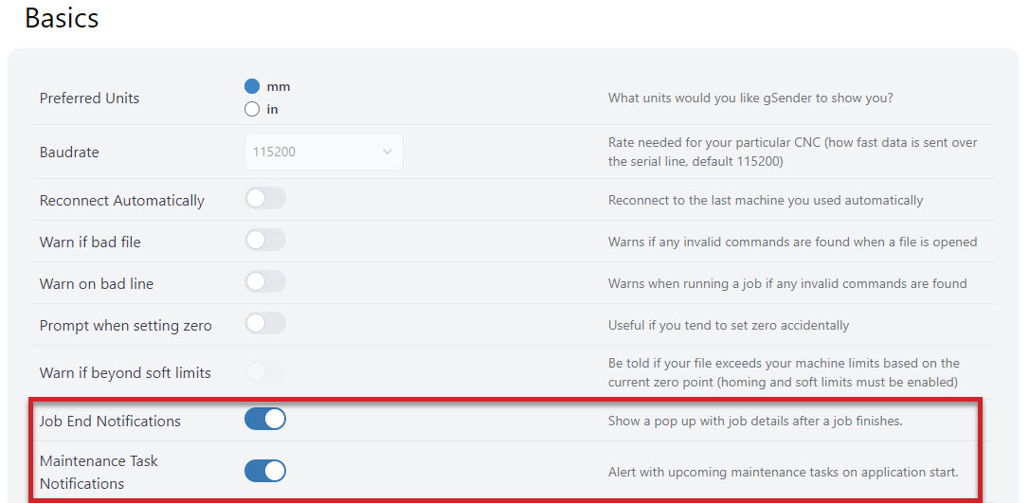
_images/_gsender/_setup/gs_se_togglenotifs.jpg
