Sienci-Labs/Resources/_images/_lmmk2/_assembly/_checksmoves/lmk2_checksmoves_-Connect-5.png

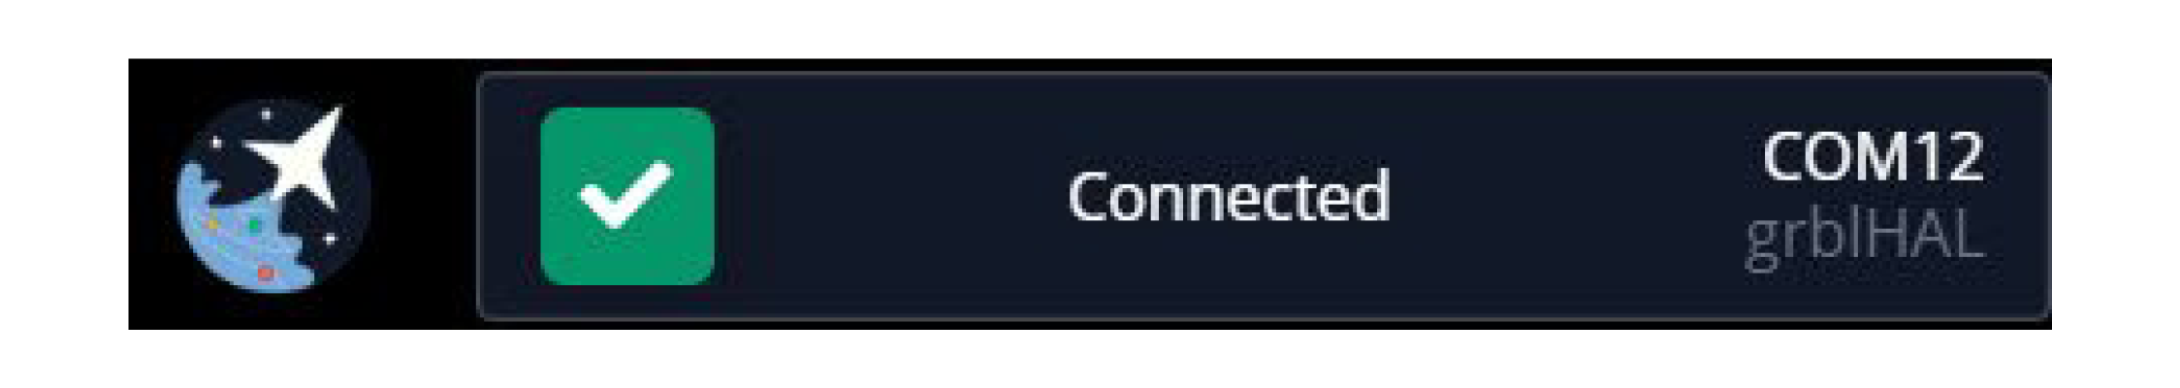
_images/_lmmk2/_assembly/_checksmoves/lmk2_checksmoves_-Connect-5.png
