Sienci-Labs/Resources/_images/_lmmk2/_assembly/_extra48/lmk2_extra48_4830_PN_7.png

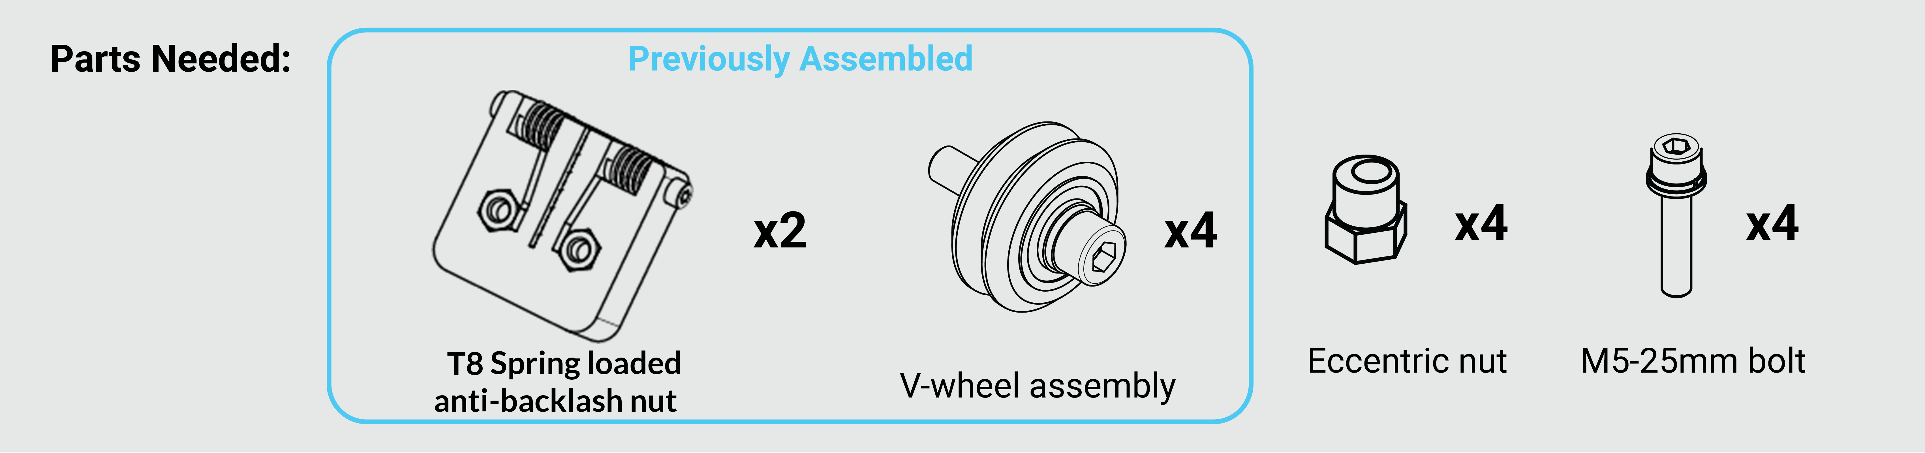
_images/_lmmk2/_assembly/_extra48/lmk2_extra48_4830_PN_7.png
