Sienci-Labs/Resources/_images/_lmmk2/_assembly/_unboxing/lmk2_unboxing_loosefirm.png

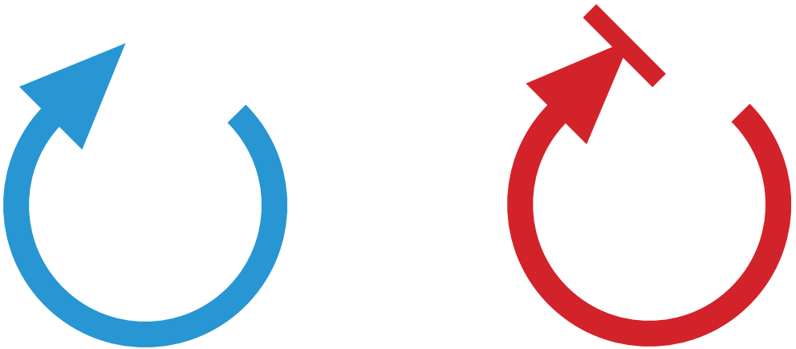
_images/_lmmk2/_assembly/_unboxing/lmk2_unboxing_loosefirm.png
