Sienci-Labs/Resources/_images/_lmmk2/_assembly/_yaxisgantries/lmk2_yaxisgantries_V-wheelSidebyside.png

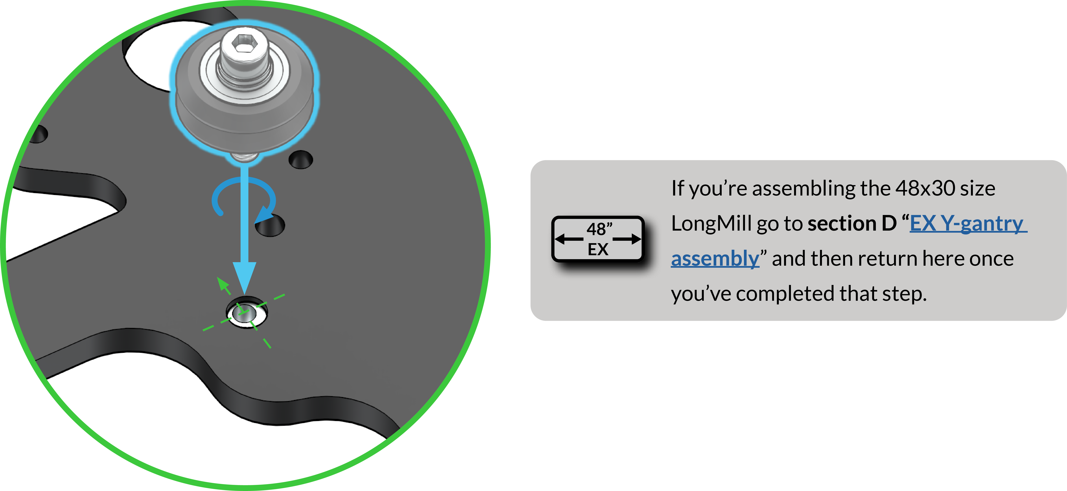
_images/_lmmk2/_assembly/_yaxisgantries/lmk2_yaxisgantries_V-wheelSidebyside.png
