Sienci-Labs/Resources/_images/_lmmk3/_assembly/_tablemount/lmk3_tablemount-yaxisfront.jpg

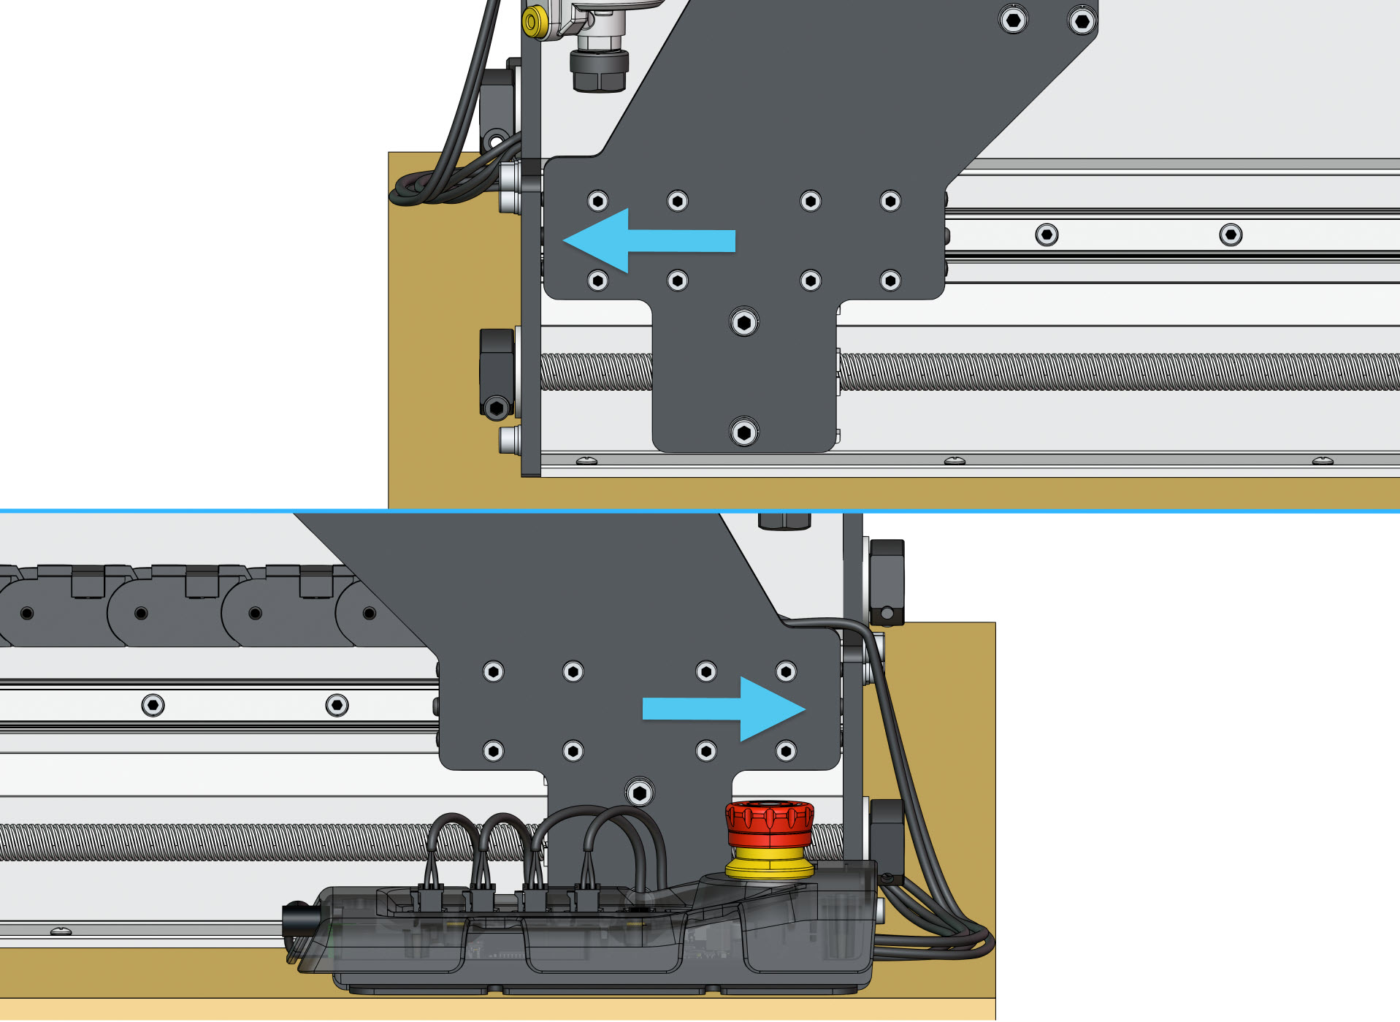
_images/_lmmk3/_assembly/_tablemount/lmk3_tablemount-yaxisfront.jpg
