Sienci-Labs/Resources/_images/_lmmk3/_assembly/_xy_axes/lmk3_assembly_xy_axes-lowerz-v2.gif

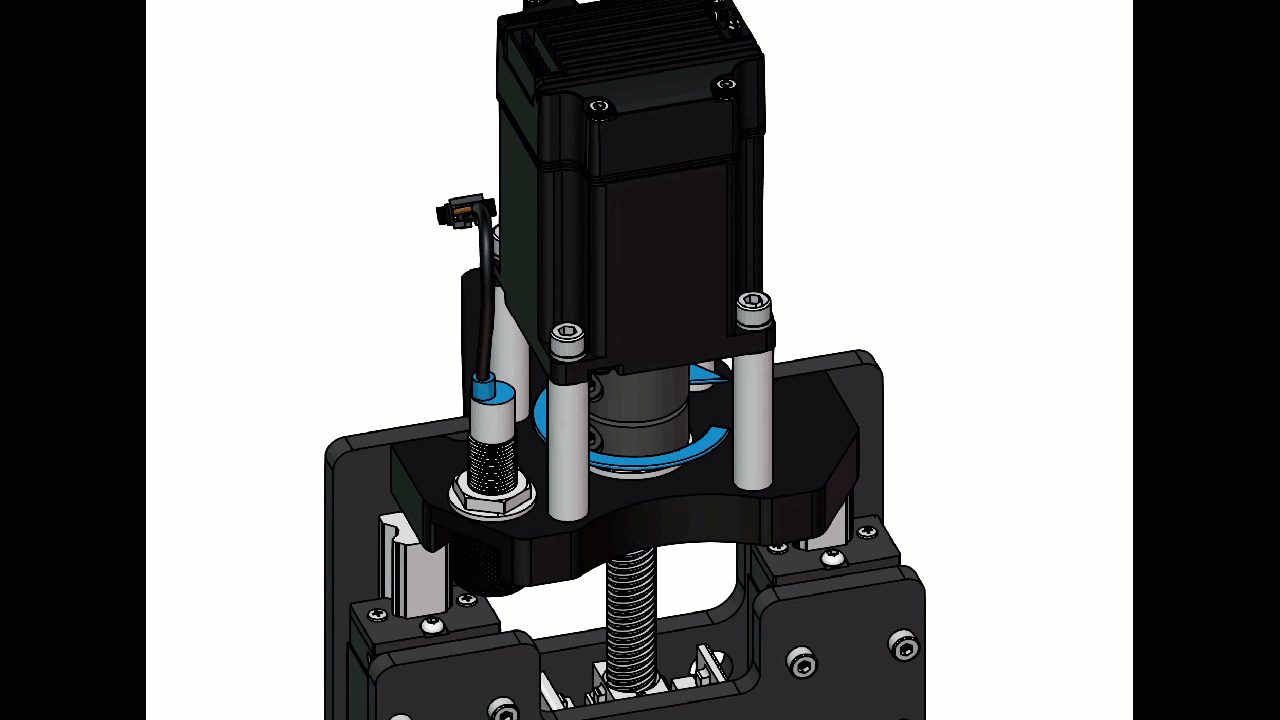
_images/_lmmk3/_assembly/_xy_axes/lmk3_assembly_xy_axes-lowerz-v2.gif
