Sienci-Labs/Resources/_images/_lmmk3/_assembly/_xy_axes/lmk3_dragchain-render-18.jpg

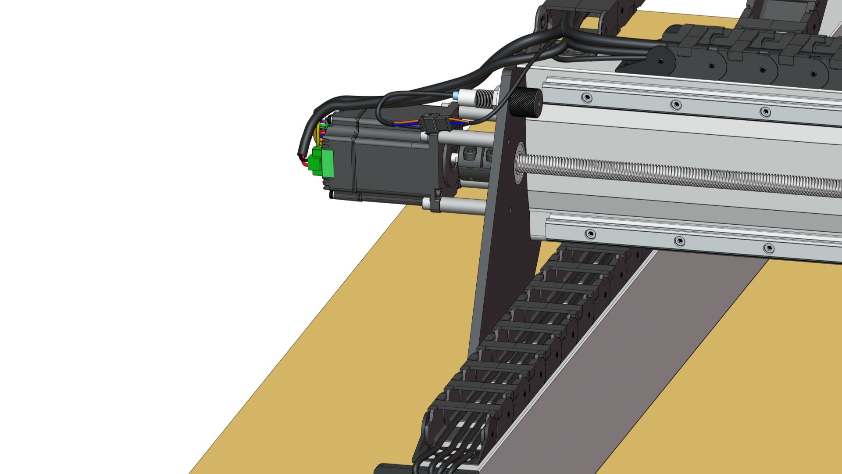
_images/_lmmk3/_assembly/_xy_axes/lmk3_dragchain-render-18.jpg
