Sienci-Labs/Resources/_images/_lmmk3/_assembly/_xy_axes/lmk3_dragchain-render-21.jpg

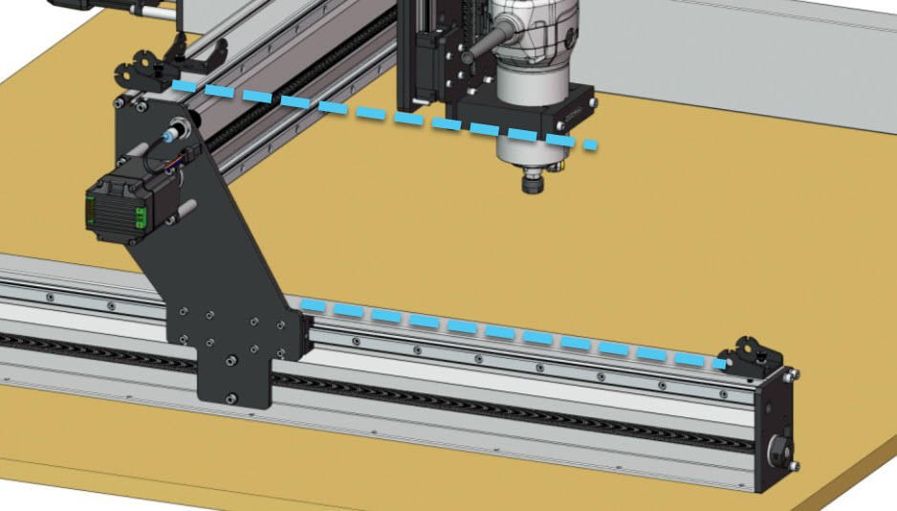
_images/_lmmk3/_assembly/_xy_axes/lmk3_dragchain-render-21.jpg
