Sienci-Labs/Resources/_images/_lmmk3/_assembly/_xy_axes/lmk3_xy_axes-couplerscrews.jpg

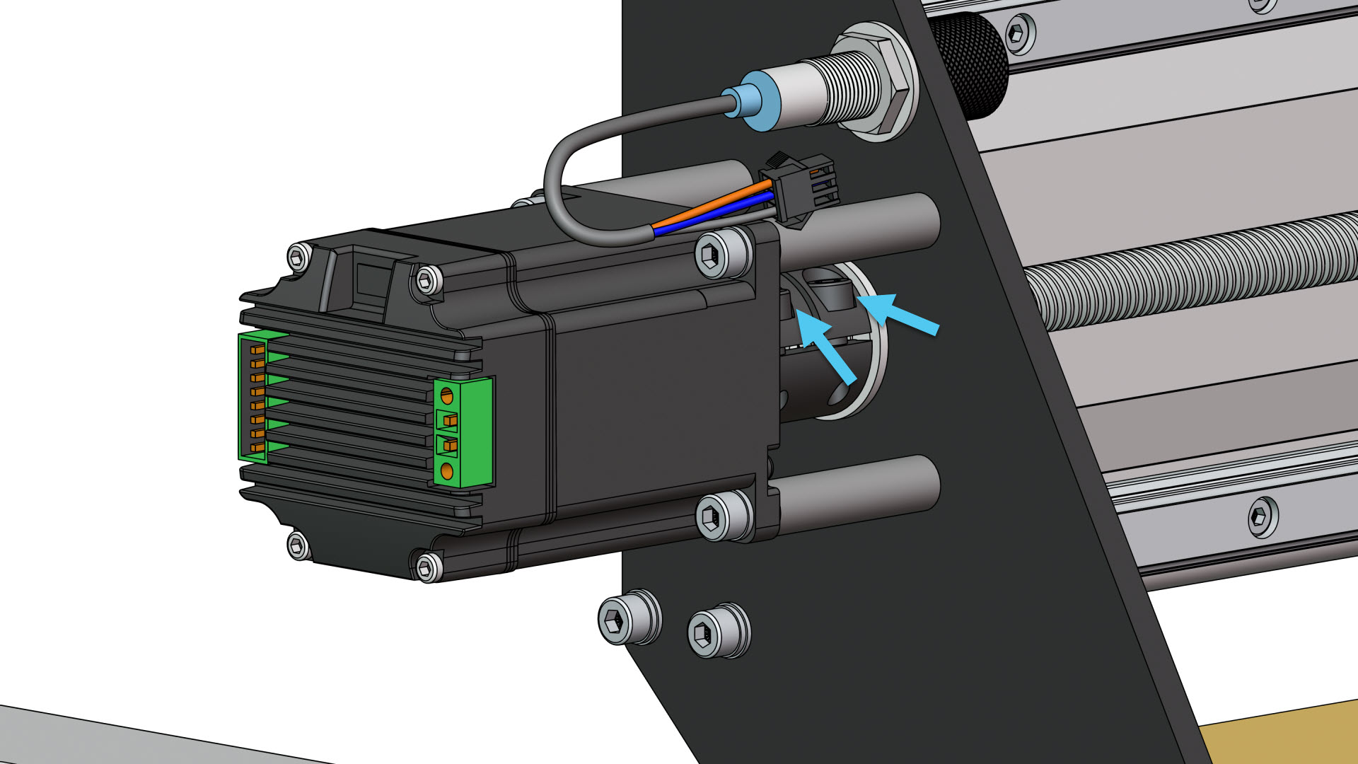
_images/_lmmk3/_assembly/_xy_axes/lmk3_xy_axes-couplerscrews.jpg
