Sienci-Labs/Resources/_images/_slblitev2/slblitev2_techmanual-aux.jpeg

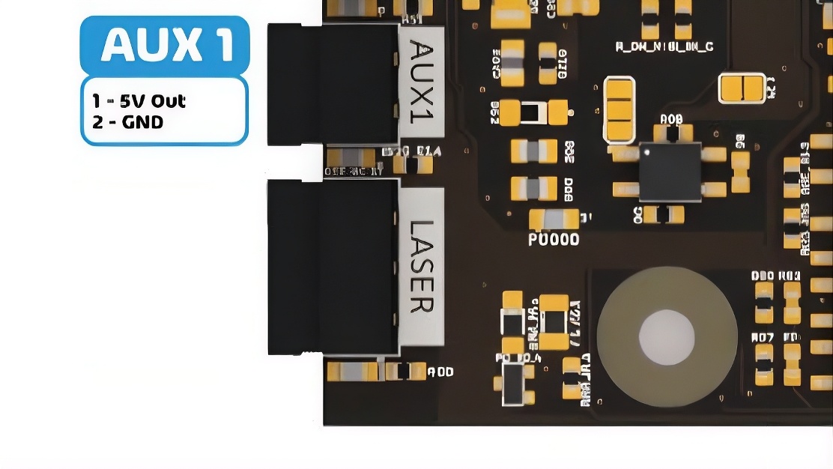
_images/_slblitev2/slblitev2_techmanual-aux.jpeg
