Sienci-Labs/Resources/_images/_superlongboard/_manual/slb_ma_homing-default.jpg

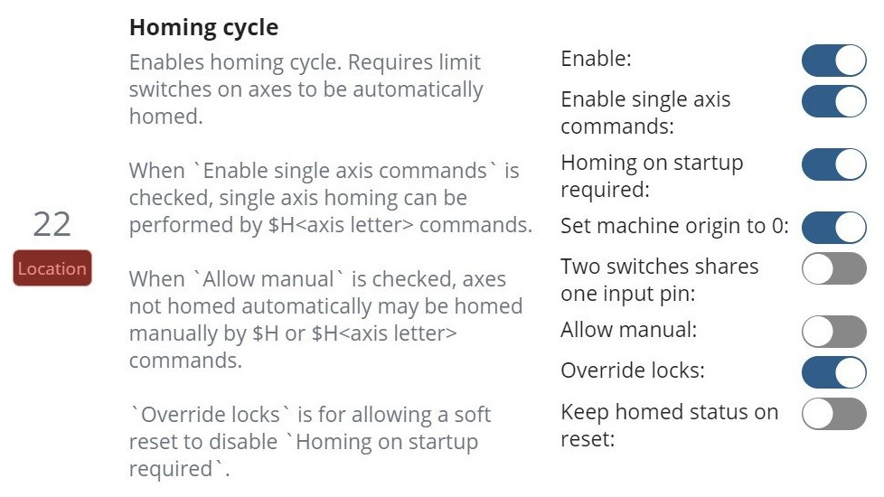
_images/_superlongboard/_manual/slb_ma_homing-default.jpg
