Sienci-Labs/Resources/_images/_superlongboard/_manual/slb_ma_p44_tls-input-newu.jpg

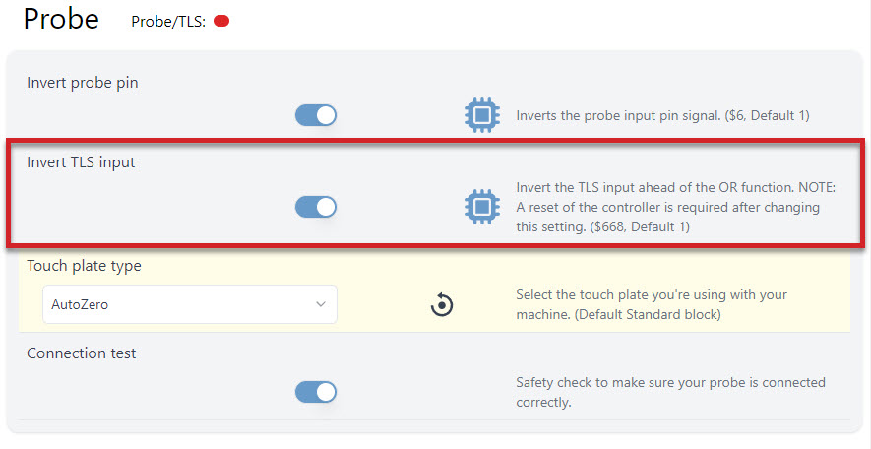
_images/_superlongboard/_manual/slb_ma_p44_tls-input-newu.jpg
