Sienci-Labs/Resources/_images/_vortex/_handbook/_chuck/vx_chuck_chuck-install-angle.jpg

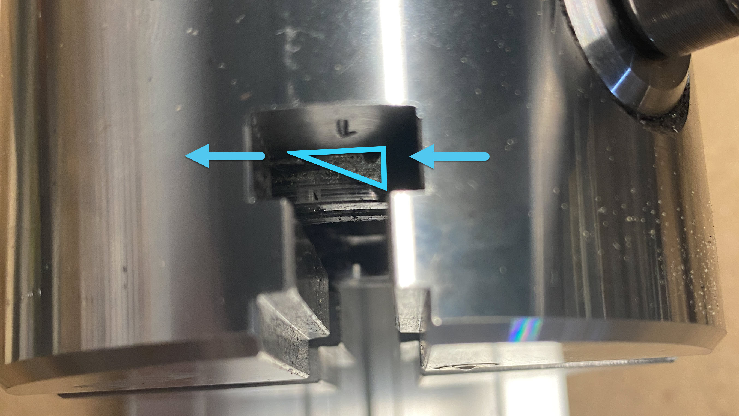
_images/_vortex/_handbook/_chuck/vx_chuck_chuck-install-angle.jpg
