Sienci-Labs/Resources/_images/_vortex/_the-basics/vx_software_job-setup.jpg

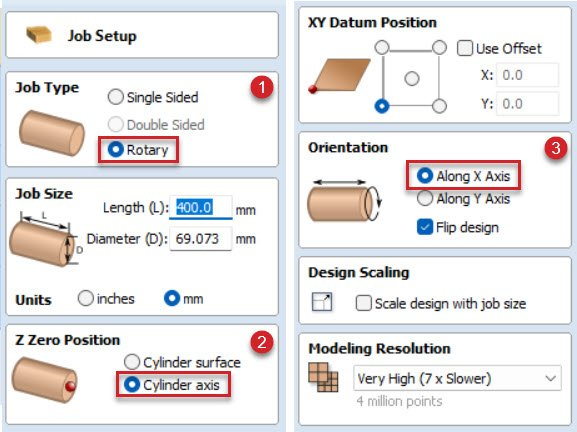
_images/_vortex/_the-basics/vx_software_job-setup.jpg
