Sienci-Labs/Resources/laserbeam/lb-assembly/ytsb-lb-test-out-your-laser.md

---
title: ytsb Test Out Your Laser
menu_order: 11
post_status: draft
post_excerpt: 
post_date: 2024-09-13 14:30:20
taxonomy:
    knowledgebase_cat: lb-assembly
    knowledgebase_tag:
        - laser
custom_fields:
    KBName: LaserBeam
    basepress_post_icon: bp-caret-right
skip_file: yes
featured_image: 
---

<span style="color: #800000;"><b>Put on your laser safety glasses for this section! </b></span>

Let's perform a quick test to make sure the LaserBeam fires up.

Turn on your LaserBeam driver. Refer to the section <a href="https://resources.sienci.com/view/lb-turning-driver-on/">Turning Driver On</a> to make sure you successfully power it on.

Navigate to the Spindle/Laser tab at the bottom of the screen and select <b>"SLB_LASER"</b> in the dropdown list. After this, flip the toggle at the top to <b>"Laser Mode."</b>



Ensure your power is set to<b> 1%</b> and your "<b>Test Duration"</b> to <b>1 second</b>. Now when you hit the "Laser Test" button your diode should momentarily emit a faint beam. This means that it is controlling your laser successfully!




<p style="text-align: center;"><i>Successful laser test!</i></p>
If the laser testing didn't go as expected, check your wiring and DIP switches, and review the instructions for setting up and turning on your driver. Below you can find Chris's video that quickly runs through how to set up the LaserBeam (or a generic PWM laser) for the SLB using gSender, along with troubleshooting tips.

https://www.youtube.com/watch?v=5r_P6eISrnc
