Sienci-Labs/Resources/laserbeam/lb-software/ytsb-lb-laser-test-lightburn-files.md

---
title: ytsb Laser Test Lightburn Files
menu_order: 2
post_status: draft
post_excerpt: 
post_date: 2021-12-23 12:56:20
taxonomy:
    knowledgebase_cat: lb-software
    knowledgebase_tag:
        - laser
custom_fields:
    KBName: LaserBeam
    basepress_post_icon: bp-caret-right
skip_file: yes
featured_image: 
---

<h3>Initial Test</h3>
This Lightburn file was designed for testing laser functionality after assembly and setup, so that you could get a good idea of how the laser is working as-is, then adjust to improve performance. You can download the file <a href="https://drive.google.com/file/d/1IjhHp_9g11VSxBX3Z8eFWSL8wA6AYu1V/view?usp=sharing">here.</a>



Specifically, the following variables can be changed and observed for this test:
<ul>
  <li>Speeds</li>
  <li>Lines</li>
  <li>Text</li>
  <li>Cutting</li>
  <li>Images</li>
  <li>Digital power settings</li>
  <li>DIP switch power settings</li>
  <li>Lenses</li>
  <li>Materials</li>
</ul>
You can use this test project as a reference if you ever need to replicate the results for other projects. Just change the text in the file to keep track of the test file variables.
