Sienci-Labs/Resources/superlongboard/testwchris.md

---
title: SuperLongBoard Post
menu_order: 4
post_status: draft
post_excerpt: See more on SLB settings and troubleshooting, especially useful on DIY CNC setups to better understand how to configure your SLB for your machine.
post_date: 2024-03-18 18:14:53
taxonomy:
    knowledgebase_cat: slb-handbook
    knowledgebase_tag:
        - slb
        - testtag
custom_fields:
    KBName: SuperLongBoard
    basepress_post_icon: 10
skip_file: no
featured_image: _images/_superlongboard/TLED-V1.jpg
---

Here I am writing some text **Bold**  
*Italic text is fun*
1. List item one
2. List item two
    1. Indented List item two A
    2. Indented List item two B
1. List item three

[This](https://docs.google.com/document/d/1Kb5IhFmbdT8EaNg6l5NoGX0OBhlvkBw1tVVKJ9E_a78/) edit is a link to the SLB Google Doc

# MainHeader
## Sub marine

This is my better paragraph

### Triple header
[Click me](#Sub-marine) to be a submarine

[Click me instead](/superlongboard/slb-troubleshooting-test.md) to go to the Vortex page

<a href="https://docs.google.com/document/d/1Kb5IhFmbdT8EaNg6l5NoGX0OBhlvkBw1tVVKJ9E_a78/edit" target="_blank" rel="noopener">Click me for new tab 2</a>

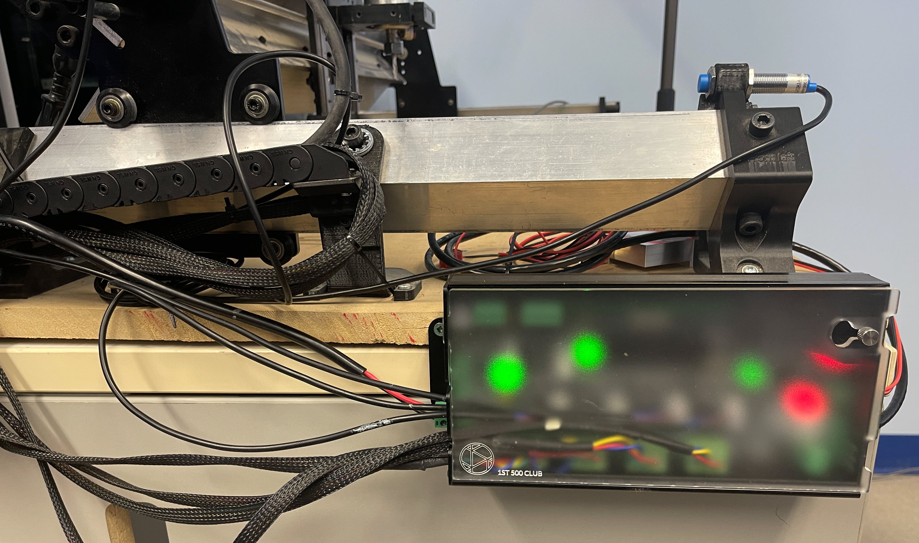
[picture p663: _images/_superlongboard/LB2SLB_p48.jpg]
Caption

Caption

<h2>The other Submarine header</h2>
