Sienci-Labs/Resources/gsender/gs-experimental/index.md

---
title: gSender Post
menu_order: 0
post_status: draft
post_excerpt: 
post_date: 2026-05-25 10:55:33
taxonomy:
    knowledgebase_cat: gs-ex
    knowledgebase_tag:
        - gsender
custom_fields:
    KBName: gSender
    basepress_post_icon: bp-caret-right
skip_file: yes
featured_image: _images/post-image.jpg
---
