Sienci-Labs/Resources/_images/_lmmk2/_add-ons/lmk2_spindle_testingspindle.jpg

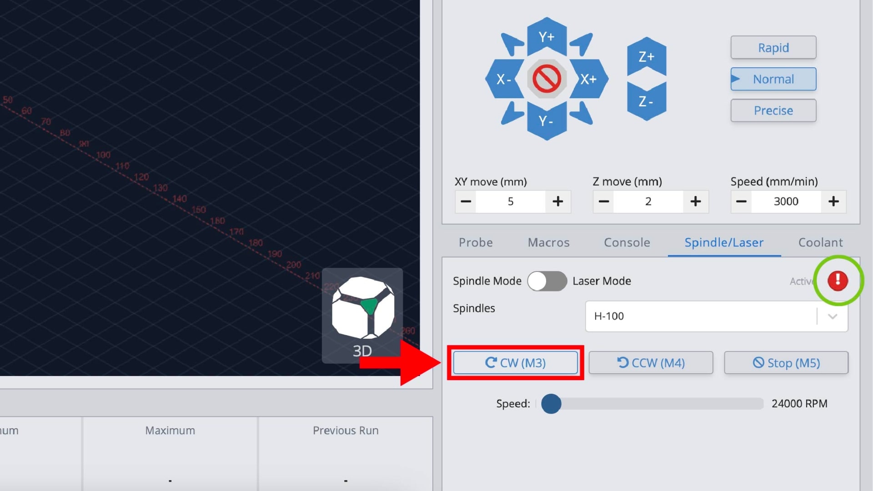
_images/_lmmk2/_add-ons/lmk2_spindle_testingspindle.jpg
