Sienci-Labs/Resources/vortex/ytsb-vx-maintenance.md

---
title: ytsb Maintenance
menu_order: 0
post_status: draft
post_excerpt: 
post_date: 2024-07-18 18:14:53
taxonomy:
    knowledgebase_cat: vx-basics vx-assembly vx-projects vx-handbook
    knowledgebase_tag:
        - vortex
custom_fields:
    KBName: Vortex
    basepress_post_icon: bp-caret-right
skip_file: yes
featured_image: _images/post-image.jpg
---

The Vortex rotary axis was designed to be a reliable, fully enclosed unit which does not require significant cleaning or maintenance. All bearings are fully sealed, and any moving components are concealed from incoming dust during cutting.

The only maintenance item is the wear of the belt-pulley system which drives the chuck. Over time and with lots of use, the belt may slowly stretch and become slightly loose, producing backlash or ‘looseness’ in the chuck. You can check for this by wiggling/turning the chuck by hand with the controller USB cable unplugged, and the machine powered on. Just like the effects of backlash in your linear X, Y, Z axis, having excessive backlash in your A-axis can result in strange artifacting and oscillations in projects done with your Vortex.

To re-tighten the belt and reduce the effects of this, you can check out our troubleshooting guide <a href="https://resources.sienci.com/view/vx-troubleshooting/#pulley-is-slipping">here</a>.
