Sienci-Labs/Resources/altmill/am-troubleshooting/ytsb-am-troubleshooting-homing-and-machine-limits.md

---
title: ytsb Homing and Machine Limits
menu_order: 4
post_status: draft
post_excerpt: 
post_date: 2024-04-24 14:53:53
taxonomy:
    knowledgebase_cat: am-troubleshooting
    knowledgebase_tag: 
custom_fields:
    KBName: AltMill CNC
    basepress_post_icon: bp-caret-right
skip_file: yes
featured_image: 
---
