Sienci-Labs/Resources/vortex/vx-handbook/vx-maintenance.md

---
title: Maintenance
menu_order: 7
post_status: publish
post_excerpt: This handbook contains advanced techniques and concepts to help you carve more intricate things. Also includes troubleshooting and maintenance section.
post_date: 2023-08-30 11:49:18
taxonomy:
    knowledgebase_cat: vx-handbook
    knowledgebase_tag:
        - vortex
custom_fields:
    KBName: Vortex Rotary Axis
    basepress_post_icon: bp-caret-right
skip_file: no
featured_image: 
---

The Vortex rotary axis was designed to be a reliable, fully enclosed unit which does not require significant cleaning or maintenance. All bearings are fully sealed, and any moving components are concealed from incoming dust during cutting.

The only maintenance item is the wear of the belt-pulley system which drives the chuck. Over time and with lots of use, the belt may slowly stretch and become slightly loose, producing backlash or 'looseness' in the chuck. You can check for this by wiggling/turning the chuck by hand with the controller USB cable unplugged, and the machine powered on. Just like the effects of backlash in your linear X, Y, Z axis, having excessive backlash in your A-axis can result in strange artifacting and oscillations in projects done with your Vortex.

To re-tighten the belt and reduce the effects of this, you can check out our troubleshooting guide <a href="https://resources.sienci.com/view/vx-troubleshooting/#pulley-is-slipping">here</a>.
