Sienci-Labs/Resources/mill-one/mo-assembly/mo-maintenance.md

---
title: Machine Maintenance
menu_order: 7
post_status: publish
post_excerpt: 
post_date: 2021-04-30 19:10:00
taxonomy:
    knowledgebase_cat: mo-assembly
    knowledgebase_tag:
        - mill-one
custom_fields:
    KBName: Mill One CNC
    basepress_post_icon: bp-caret-right
skip_file: no
featured_image: 
---

After one or two projects you'll notice that your Mill One will start collecting material chips and dust. Since the Mill One lacks a dust collection system, we recommend cleaning out the build area every couple of jobs with a vacuum. Any form of liquid cleaning solvent is unnecessary and not recommended since it could damage the Mill One. Regularly cleaning your machine will make sure that setting it up for new cutting operations is easier and the rail systems remain accurate since they're free from debris.

If you have any all-purpose oil or grease on hand, you should also lubricate the Mill One's lead screws semi-regularly in order to keep them running smoothly. Lastly, if you notice that your waste board has taken too many hits and is looking a little worn out, we'd suggest gong back to the <b>Preparing to Cut</b> page so that you may cut a new waste board. This will ensure that you can continue to accurately mount material to your machine for cutting.
