Sienci-Labs/Resources/altmill/am-handbook/ytsb-am-maintenance.md

---
title: ytsb Maintenance 🛠️
menu_order: 2
post_status: draft
post_excerpt: 
post_date: 2024-09-13 14:30:53
taxonomy:
    knowledgebase_cat: am-handbook
    knowledgebase_tag: 
custom_fields:
    KBName: AltMill CNC
    basepress_post_icon: bp-caret-right
skip_file: yes
featured_image: 
---
