Sienci-Labs/Resources/altmill/am-troubleshooting/ytsb-am-cnc-preflight-checklist.md

---
title: ytsb CNC Pre-Flight Checklist 📋
menu_order: 6
post_status: draft
post_excerpt: 
post_date: 2024-11-05 09:13:53
taxonomy:
    knowledgebase_cat: am-troubleshooting
    knowledgebase_tag: 
custom_fields:
    KBName: AltMill CNC
    basepress_post_icon: bp-caret-right
skip_file: yes
featured_image: 
---
