Sienci-Labs/Resources/laserbeam/lb-handbook/ytsb-lb-troubleshooting-files.md

---
title: ytsb Troubleshooting Files
menu_order: 6
post_status: draft
post_excerpt: 
post_date: 2024-09-13 14:30:20
taxonomy:
    knowledgebase_cat: lb-handbook
    knowledgebase_tag:
        - laser
custom_fields:
    KBName: LaserBeam
    basepress_post_icon: bp-caret-right
skip_file: yes
featured_image: 
---

<h3><b>How to contact us</b></h3>
If you have any questions or technical difficulties, please feel free to contact us. The easiest way to do this is to submit an email ticket to our customer service experts. You can easily do that <a href="https://sienci.com/contact-us/">here</a>.

Once you contact us, we may ask you to send us some of your files and settings in order to troubleshoot the issue. We may also send you some of our files and settings to load onto your own machine. This process helps us narrow down what may be causing your issues, and resolve them.

The following is a step by step process for both exporting and importing the required files.
<h3><b>Download your diagnostic PDF file</b></h3>
During the troubleshooting process, we may ask you to download and send us your diagnostic file, which contains detailed information about your firmware and machine settings, operating system, alarms, errors, and more.
<p style="padding-left: 40px;">1. In gSender, click the "Calibrate" icon in the upper right corner:</p>

<p style="padding-left: 40px;">2. Click "Download Now" In the bottom right corner:</p>

<h3><b>Export your EEPROM/firmware settings</b></h3>
We may ask to see your firmware settings, which are the settings stored on your controller.
<p style="padding-left: 40px;">1. Click the "Firmware" Icon in the upper right corner

2. Click "Export Settings" on the Left of the screen</p>

<h3><b>Export your gSender settings</b></h3>
These gSender settings, or preferences, are stored locally on your computer and can affect touch probe, spindle and laser functionalities.
<p style="padding-left: 40px;">1. Click the Settings icon (small gear) in the upper right corner</p>

<p style="padding-left: 40px;">2. Click "Export Settings"</p>

<h3><b>Import EEPROM/firmware settings</b></h3>
Similarly to the way we may ask for some of your settings files, we may also send you some of our own that you can then upload and test on your own machine.
<p style="padding-left: 40px;">1. Click the "Firmware" Icon in the upper right corner
</p>

<p style="padding-left: 40px;">2. Click "Import Settings"</p>

<h3><b>Import gSender settings</b></h3>
<p style="padding-left: 40px;">1. Click the Settings Icon (small gear) in the upper right corner</p>
<p style="padding-left: 40px;">
2. Click "Import Settings"</p>
