Sienci-Labs/Resources/(threads)

Thread 12 (2024-09-10):

Update Workspaces section

StephenGitHuber, 2024-09-10:
Chris says -"The improvement is nice, a step in the right direction where I think even more writing to provide examples might be useful. I don't like some of my original writing with "therefore" and whatnot so there's some reasonable room for improvement from what I've already done"

SienciLabs, 2024-09-10:
Would you be able to add into here what the original text was and what attempts we took at modifying it?

StephenGitHuber, 2024-09-16:
Now live on WP -->

Workspaces
Usually you would only have one origin or zero position for your project, therefore gSender will only save one zero. However, if you plan to do a series of projects that require different zero positions, or are lining up to do some more complex jigging or part batches, you may want to set up multiple workspaces all at once. This can save you time by not having to set a zero position for repetitive tasks or specific jig setups. You can do this by creating up to six different zero positions with the six workspaces in gSender. Access each 'Workspace' at the top right of the program by pressing the drop down to select which workspace to use. gSender will act completely in-line with whatever workspace you've selected, whether you want to set zero, probe, surface, or anything else.

Old Version
Usually you would only have one origin or zero position for your project, therefore gSender will only save one zero. **However, if you plan to do a series of projects that require different zero positions, or are lining up to do some more complex jigging or part batches, you may want to set up multiple zero positions all at once**. You can do this by creating up to six different zero positions with the six workspaces in gSender. Access each 'Workspace' at the top right of the program by pressing the drop down to select which workspace to use. gSender will act completely in-line with whatever workspace you've selected, whether you want to set zero, probe, surface, or anything else.

StephenGitHuber, 2024-09-16:
Seems like a small tweak back in May 2023. I have it on the list to update in the new writing phase.

SienciLabs, 2024-09-27:
Tons of videos recently on workspaces from users on our FB group, Garrett, even forum threads
https://forum.sienci.com/t/setting-up-g54-g55-ect/7852
https://forum.sienci.com/t/macros-for-my-workflow-updated-2023-10-27/9648/7

Thread 14 (2024-09-10):

gSender grblHAL Firmware Tool

StephenGitHuber, 2024-09-10:
grblHAL Firmware Tool
Connect to and run jobs as normal on any grblHAL device
Connect over ethernet where hardware is supported
New grblHAL specific firmware tool that is dynamically generated based on reported settings
New UI elements where appropriate to support new functionality such as single axis homing

SienciLabs, 2024-09-10:
What's this one referring to?

SienciLabs, 2024-09-10:
Oh I see, it's because writing on support for grblHAL was never added to the Edge features page and thus was never added into the general documentation.

To some extent, some of these notes have already been added into the main docs but I agree that there is still some lack of mention of some aspects that would be good to address.

Thread 15 (2024-09-10):

Tool Changing update

StephenGitHuber, 2024-09-10:
Not finished or on WP yet...

On CNC routers and mills, tool changes are very common since it’s not often that a whole project can be cut out with a single cutting tool. For most situations a tool change is just the act of swapping from one cutting tool to another (for example: from a 60° v-bit to a ¼” flat end mill) while keeping track of the location of the end / tip of the tool when that change happens. The main ways to keep track of the ends of the tools when changing them is:
Re-zero the Z-axis to the same spot that you originally used: if you zero Z at the top or corner of your material at the start of the job and zero Z at that same spot with every following tool then the change in length of the tools won’t matter
Can use the paper method or a touch plate
Very straightforward as long as you follow the steps
Use a hard-stop system: if you can ensure that all your tools have the same length, you can keep changing them and not have to worry about any compensation
Can hover the router/spindle collet above a piece of material that the tool rests on while the collet gets tightened, use a C-shaped height-setter, or using tool shank collars
The most simple in terms of steps and setup but the least accurate

At its core, all a tool change accomplishes
On CNC routers and mills, tool changes are a type of ‘pause’ typically put into the g-code if a single file contains toolpaths for more than one cutting tool. This “M6” command is meant to tell the machine and the user that it’s

Thread 16 (2024-09-10):

Additional Features

StephenGitHuber, 2024-09-10:
Additional Features
For Additional Features, we say - This page covers all the advanced features of gSender such as shortcuts, macros, workspaces, calibration tools, controlling spindles, lasers, coolant, and more.
Put the following in order of most used to least needed.

1 |   | Shortcuts |   |  
2 |   | Lightweight Mode |   |  
3 |   | Coolant Control/IOT Relay |   |  
4 |   | Spindle & Laser Support |   |  
5 |   | Macros |   |  
6 |   | Console |   |  
7 |   | Calibrate Tool |   |  
8 |   | Stats Page |   |  
9 |   | Firmware Tool |   |  
10 |   | Start/Stop G-code |   |  
11 |   | Tool Changing |   |  
12 |   | Workspaces |   |  
13 |   | Settings |   |  
14 |   | Remote Mode |   |  
15 |   | About Page |   |  
16 |   | More |   |  

This markdown may help?...

<html>
<body>
<!--StartFragment--><b style="font-weight:normal;" id="docs-internal-guid-a4c24f47-7fff-af34-e889-41428c8349bc"><h1 dir="ltr" style="line-height:1.38;margin-top:18pt;margin-bottom:12pt;"><span style="font-size:16pt;font-family:Lato,sans-serif;color:#000000;background-color:transparent;font-weight:700;font-style:normal;font-variant:normal;text-decoration:underline;-webkit-text-decoration-skip:none;text-decoration-skip-ink:none;vertical-align:baseline;white-space:pre;white-space:pre-wrap;">Additional Features</span></h1><p dir="ltr" style="line-height:1.38;margin-top:12pt;margin-bottom:12pt;"><span style="font-size:11pt;font-family:Lato,sans-serif;color:#000000;background-color:transparent;font-weight:400;font-style:normal;font-variant:normal;text-decoration:none;vertical-align:baseline;white-space:pre;white-space:pre-wrap;">For Additional Features, we say -</span><span style="font-size:11pt;font-family:Lato,sans-serif;color:#000000;background-color:transparent;font-weight:700;font-style:normal;font-variant:normal;text-decoration:none;vertical-align:baseline;white-space:pre;white-space:pre-wrap;"> This page covers all the advanced features of gSender such as shortcuts, macros, workspaces, calibration tools, controlling spindles, lasers, coolant, and more.</span></p><p dir="ltr" style="line-height:1.38;margin-top:12pt;margin-bottom:12pt;"><span style="font-size:11pt;font-family:Lato,sans-serif;color:#000000;background-color:transparent;font-weight:700;font-style:normal;font-variant:normal;text-decoration:none;vertical-align:baseline;white-space:pre;white-space:pre-wrap;">Put the following in order of most used to least needed.</span></p><div dir="ltr" style="margin-left:0pt;" align="center">
Now | New | Title | Why | # Community posts
-- | -- | -- | -- | --
1 |   | Shortcuts |   |  
2 |   | Lightweight Mode |   |  
3 |   | Coolant Control/IOT Relay |   |  
4 |   | Spindle & Laser Support |   |  
5 |   | Macros |   |  
6 |   | Console |   |  
7 |   | Calibrate Tool |   |  
8 |   | Stats Page |   |  
9 |   | Firmware Tool |   |  
10 |   | Start/Stop G-code |   |  
11 |   | Tool Changing |   |  
12 |   | Workspaces |   |  
13 |   | Settings |   |  
14 |   | Remote Mode |   |  
15 |   | About Page |   |  
16 |   | More |   |  

</div><br /><p dir="ltr" style="line-height:1.38;margin-top:12pt;margin-bottom:12pt;"><span style="font-size:11pt;font-family:Lato,sans-serif;color:#000000;background-color:transparent;font-weight:400;font-style:normal;font-variant:normal;text-decoration:none;vertical-align:baseline;white-space:pre;white-space:pre-wrap;">This page covers all the advanced features of gSender such as shortcuts, macros, workspaces, calibration tools, controlling spindles, lasers, coolant, and more. Remember, you can always quickly navigate the page by clicking the headings in the 'Page Contents'.</span></p></b><br class="Apple-interchange-newline"><!--EndFragment-->
</body>
</html>

Thread 22 (2024-09-25):

LongMill Troubleshooting Improvements

SienciLabs, 2024-09-25:
- Add replace v-wheels to maintenance section [Bucky’s Customs](https://www.youtube.com/watch?v=EjTjpZvvniY&t=1140s) Video
- My spoil board has slight stripes as opposed to being perfectly flat… is this normal or do I have a tilt on my router that needs to be fixed? If so, how’s that done? (link to new tramming page)
- Issues & Fixes section needs pics to be updated to MK2.5 parts
