Sienci-Labs/Resources/_community-docs/Fraction-Decimal-Conversion.pdf

## FRACTION - DECIMAL - MILLIMETERS CONVERSION CHART

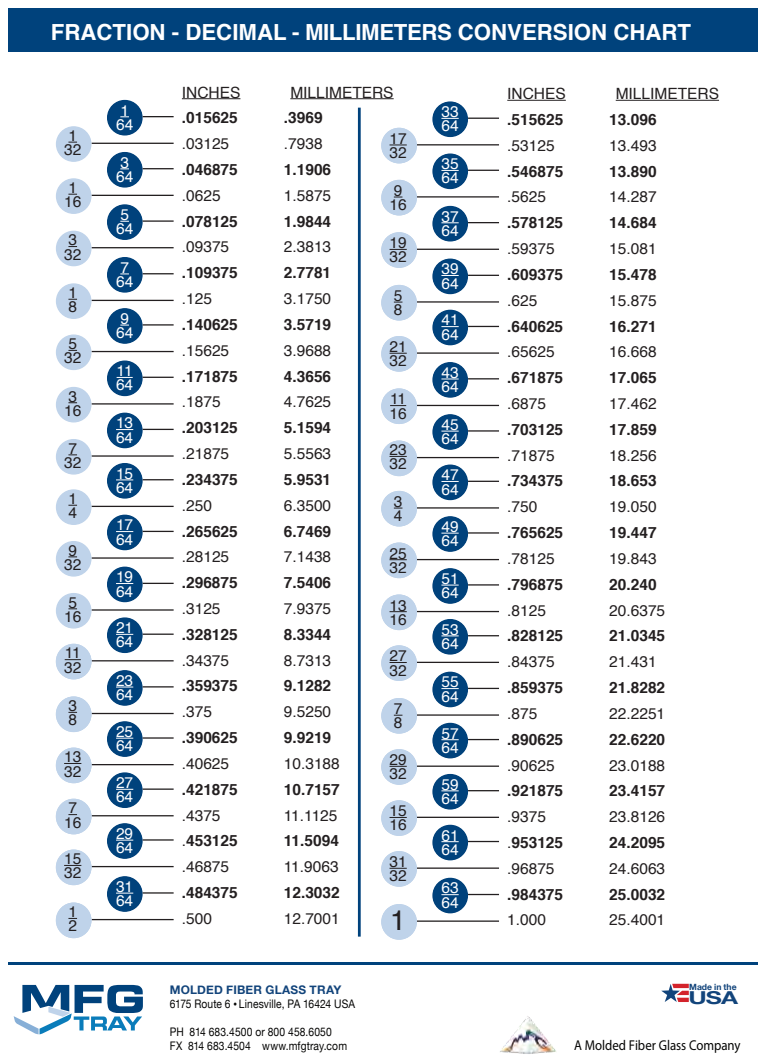
[picture p739: page 1]
INCHES; MILLIMETERS; FX 814 683.4504 www.mfgtray.com; A Molded Fiber Glass Company

MOLDED FIBER GLASS TRAY
6175 Route 6 • Linesville, PA 16424 USA

Made in the
USA
