Sienci-Labs/Resources/_downloads/_altmill/AltMill-Table-Leg-Dimensions.pdf

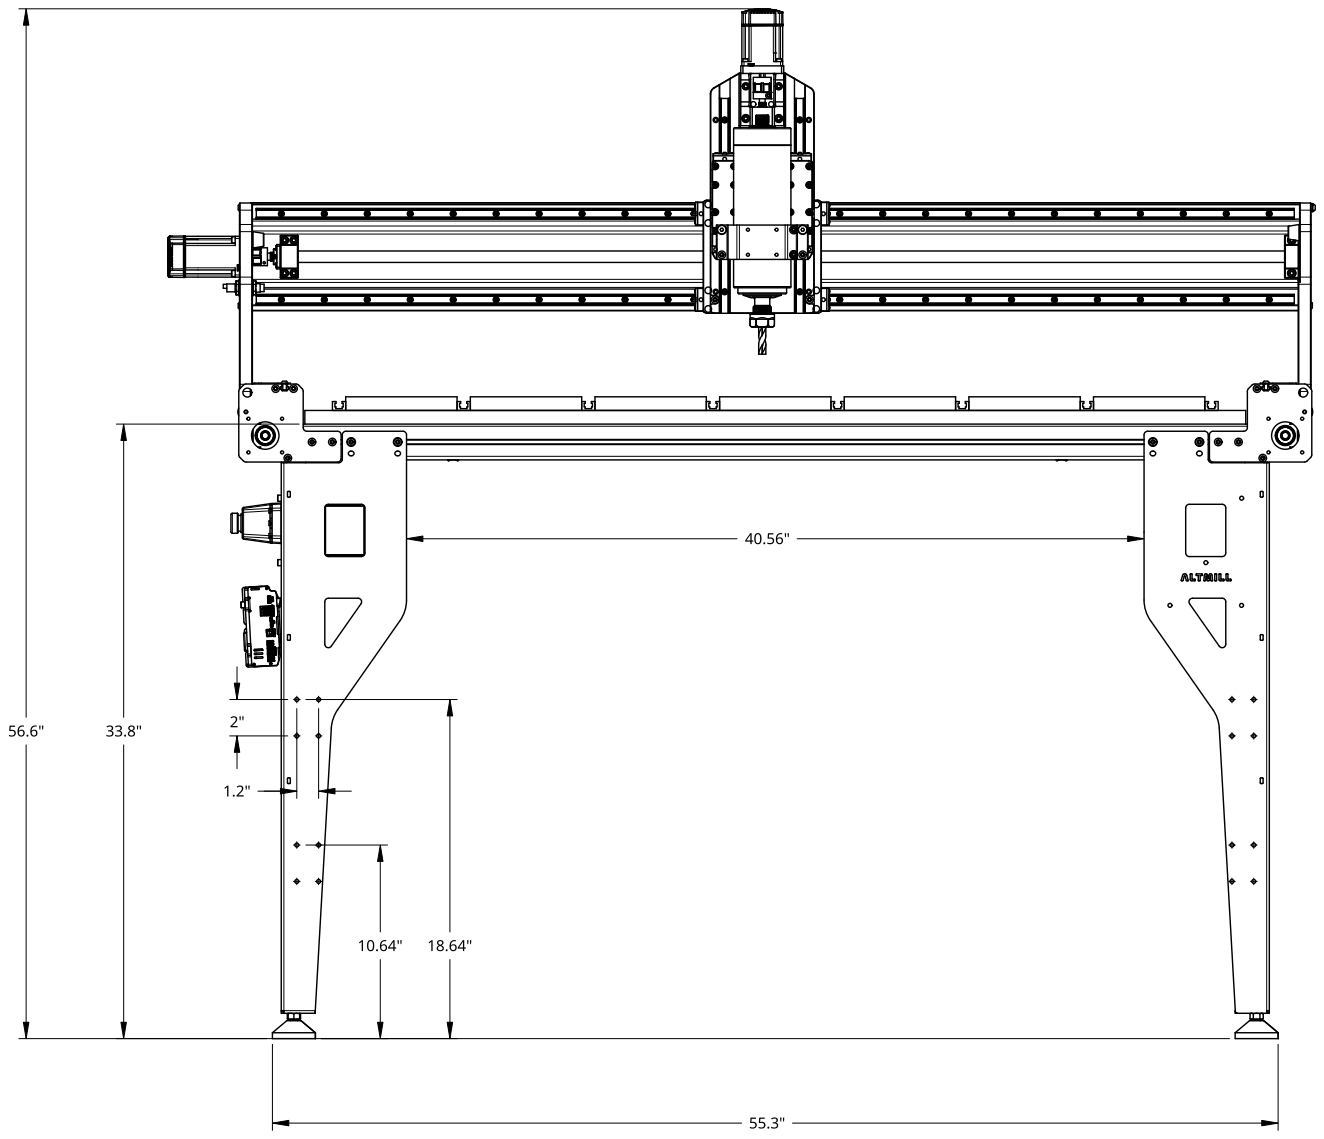
[picture p740: page 1]
