Sienci-Labs/Resources/_downloads/_altmill/MK2-2x4-Key-Dimensions.pdf

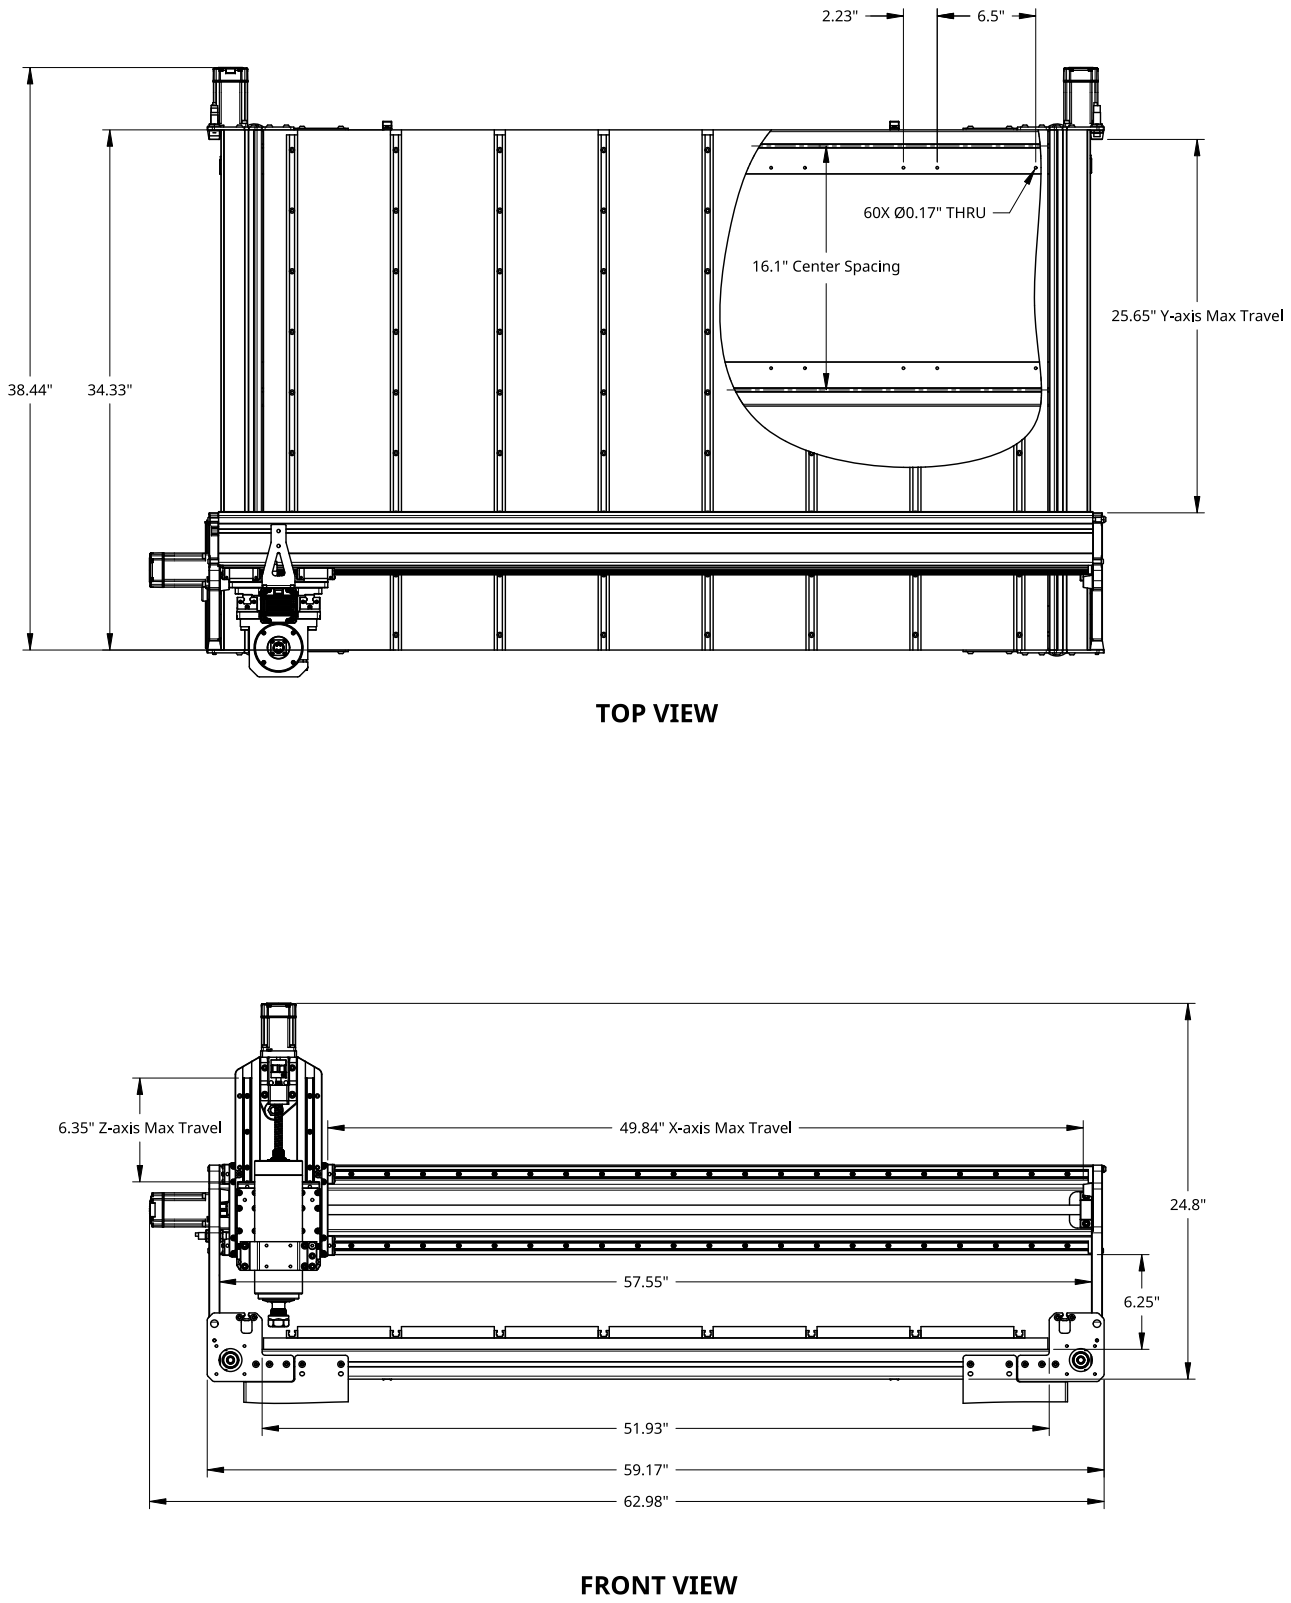
[picture p741: page 1]
