Sienci-Labs/Resources/_downloads/_altmill/MK2-4x4-Key-Dimensions.pdf

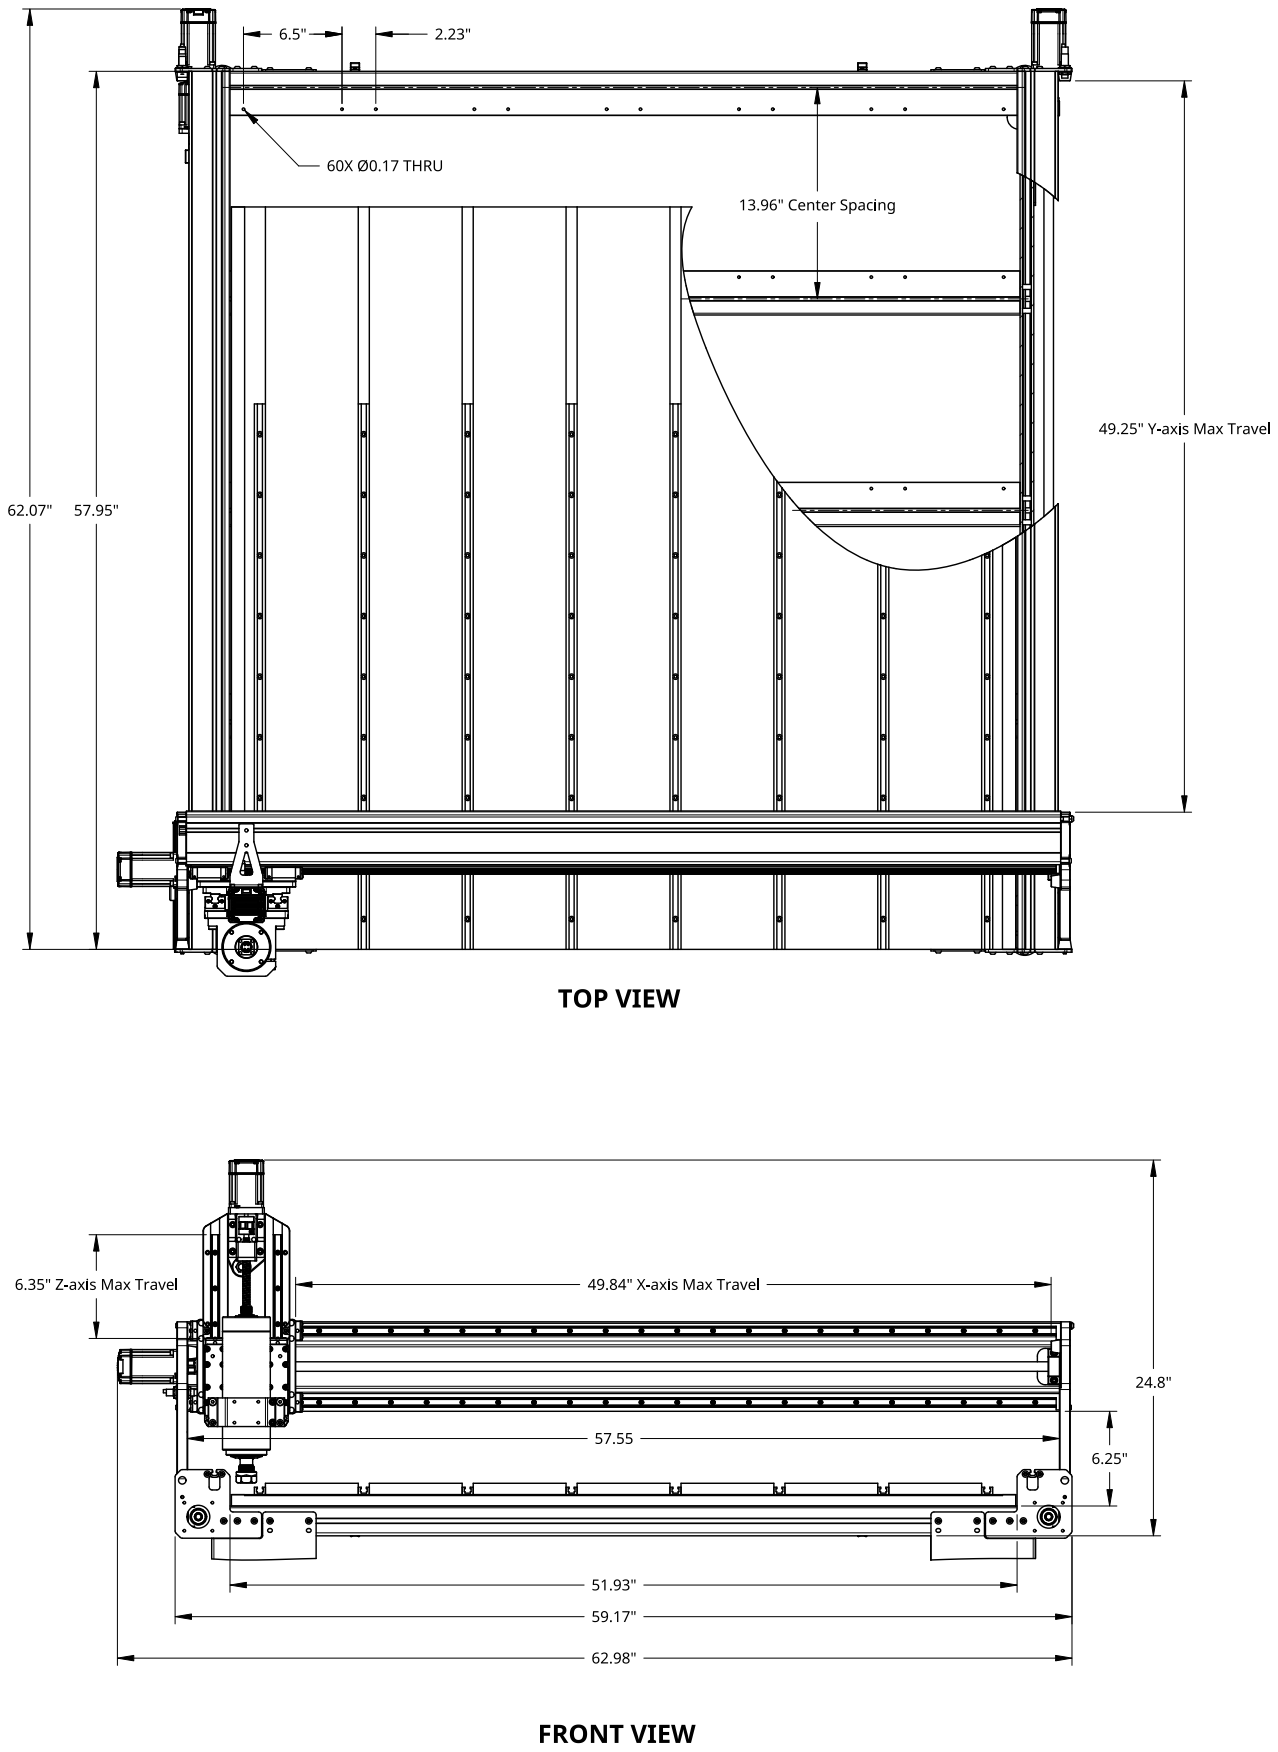
[picture p742: page 1]
