Sienci-Labs/Resources/_downloads/_longmill/LongMill-MK2-48x30-30x30-and-12x30-dimensions.pdf

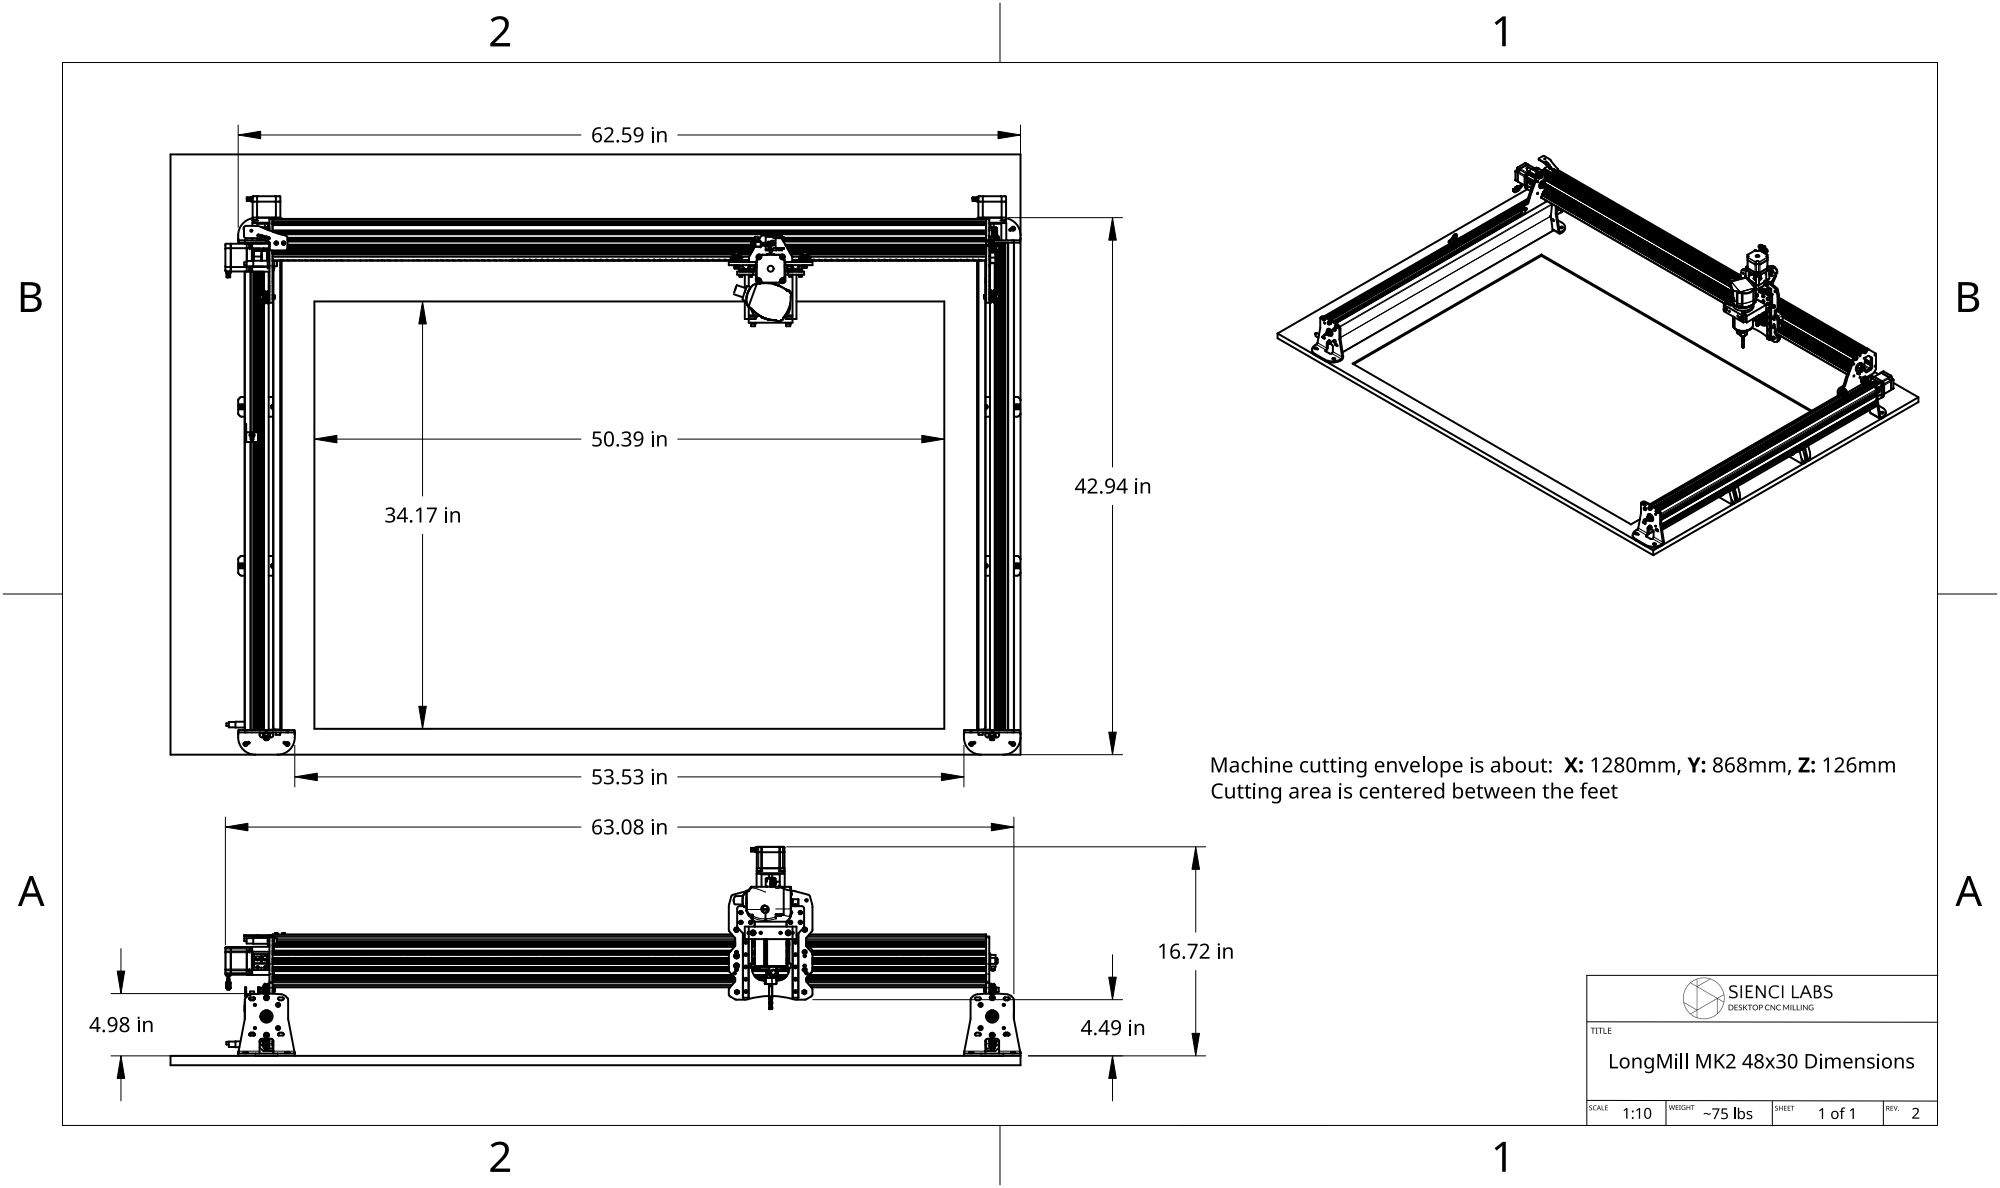
[picture p743: page 1]

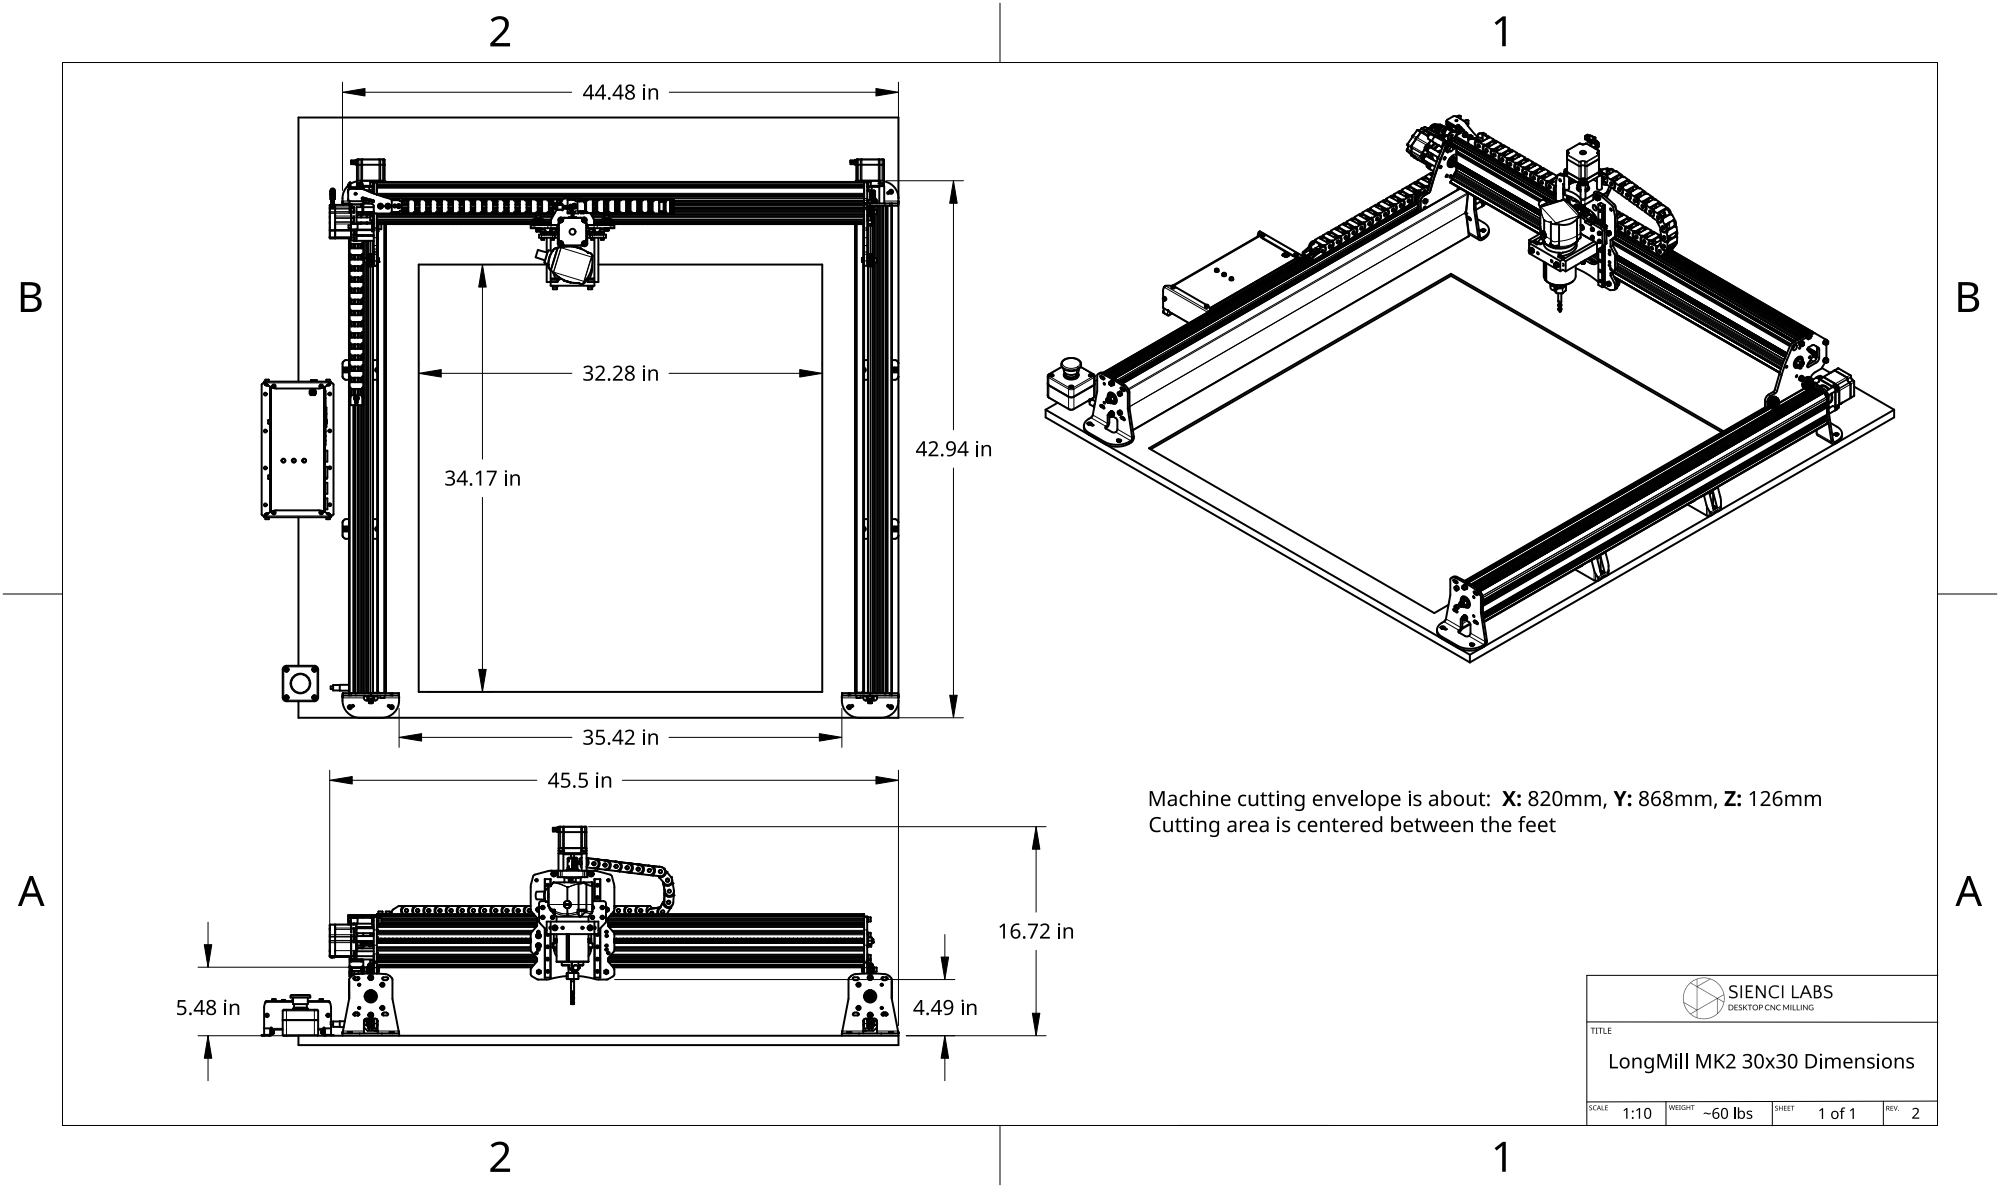
[picture p744: page 2]

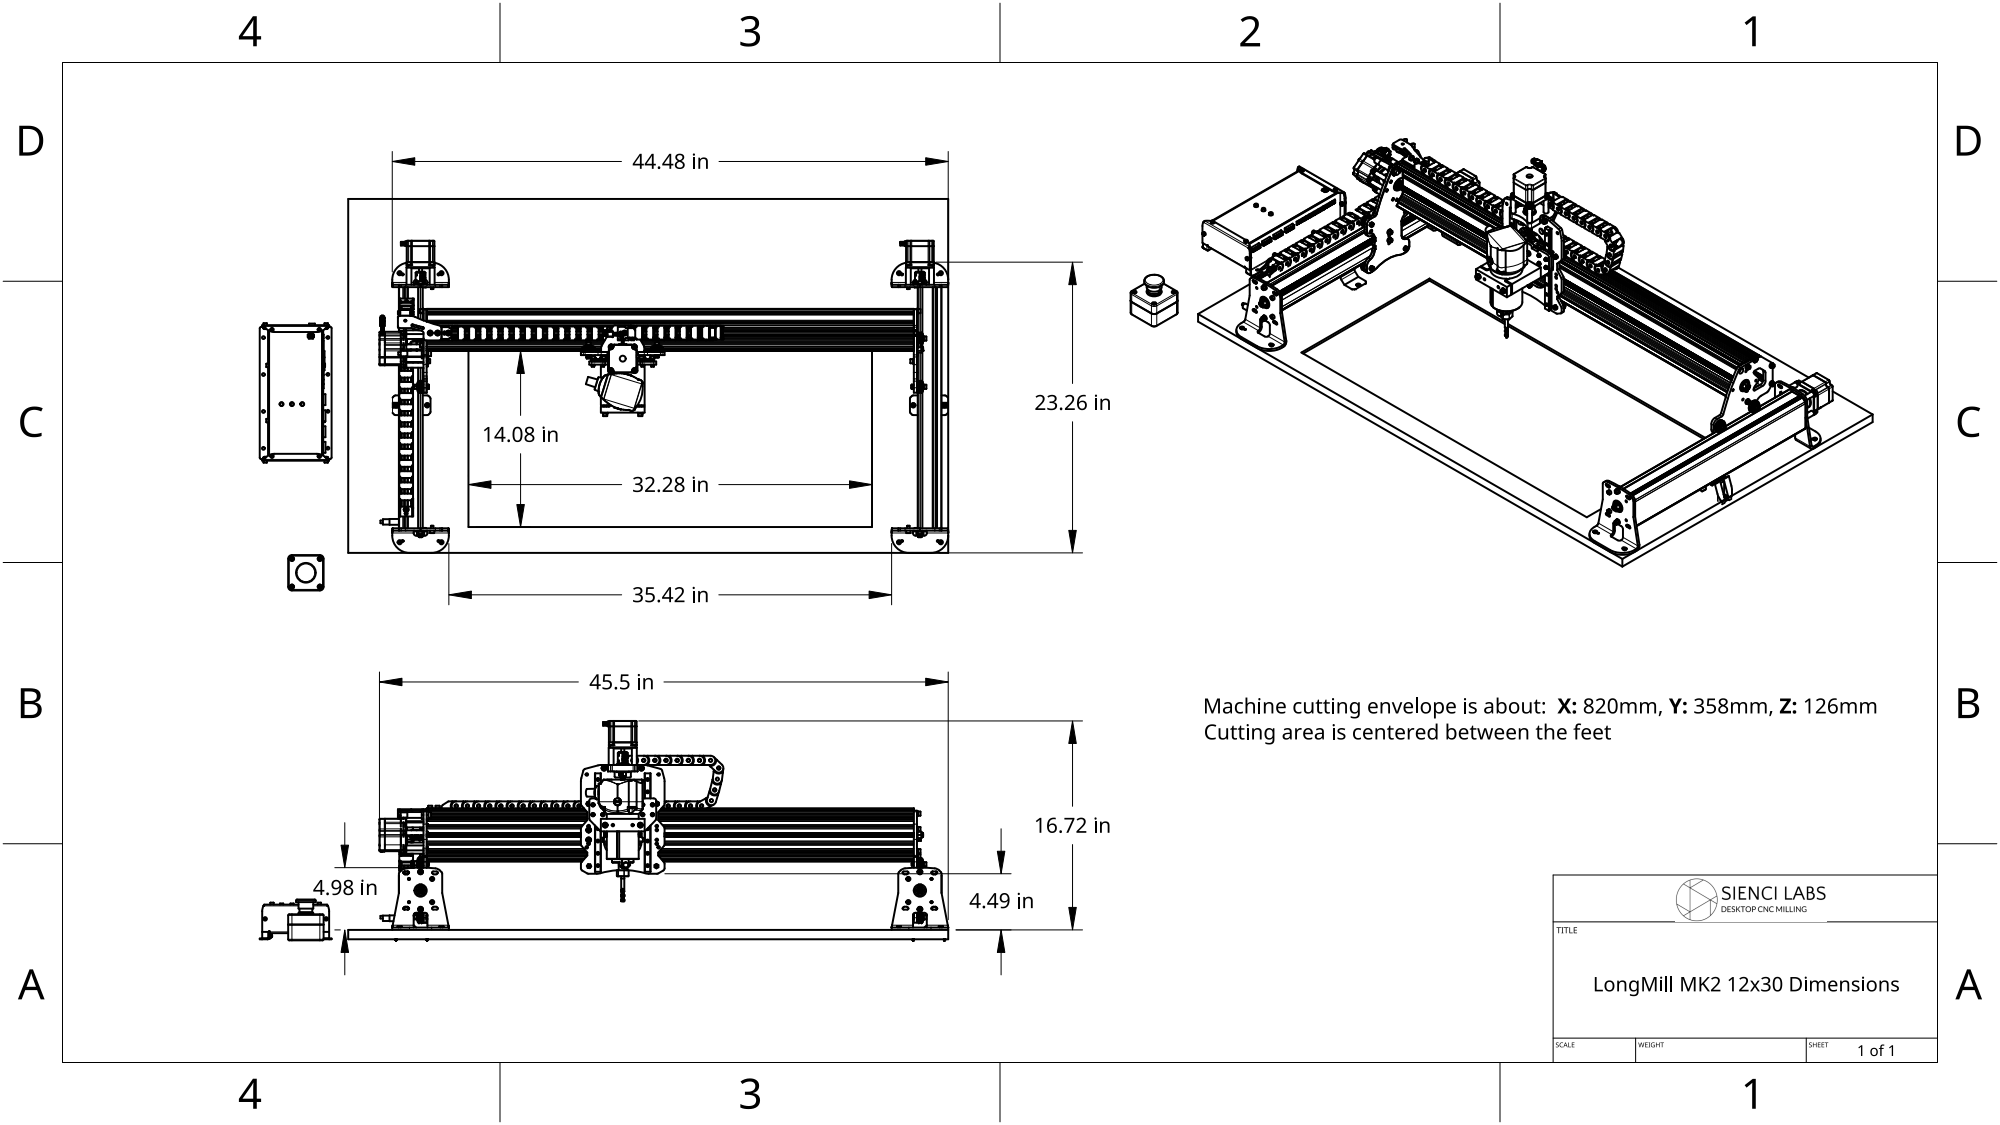
[picture p745: page 3]
