Sienci-Labs/Resources/(commit log)

2024-07-12 Update test-doc-3.md
    millone sample
2024-07-15 Added more description of backlash nut install
    I changing this because.....
2024-07-19 Youtube links make me tired
2024-07-30 Mill one documentation Initial push (#6)
    * Mill One Welcome
    * Welcome update - removed featured image
    * naming updates and mo-router page added
    * workholding added, image line added to index file as I use it often
    * new cutting tools page, pictures are all in their new naming conventions
    * file and pic into the basics folders - note to self, do folders first, then rename, then relink in that order to avoid duplicating work
    * Added software section
    * Assembly section. Still needs pics to be Done
    * Assembly section fully updated
    * Software section updated
    * The Basics updated
    * Initial More section, pics still need to be uploaded and updated
    * More section c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
2024-07-30 Fixing incorrect publish dates on some Mill One pages
2024-07-30 Mill One text, spaces, links missing Check 1
2024-07-31 Another batch Mill One docs to publish
2024-07-31 Batch 3 Mill One docs to publish
2024-08-02 Remaining Mill One pages published!
2024-08-02 Spaces removed, Mill One should be fully online now
2024-08-27 LongMill MK1 complete merge in (#7)
    * Initial LongMill setup
    * Working through the basics
    * Progress push
    * All pages are created, still need to update pics on final two
    * Pics added to community tables page
    * LongMill the basics complete
    * index file update
    * LongMill - Software section complete
    * LongMill - Assembly file structure complete - need clean up and pics done
    * LongMill Assembly - md files setup, errors removed, spacing complete. Just need pics now...
    * Hit sync by mistake...
    * Whew - Unboxing pics all renamed
    * Unboxing pics added, image subfolders added for assembly
    * XZ Assembly pictures organized and named
    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
2024-09-06 Update LongMill EEPROM settings table and SLB spindle RJ11 wiring diagram
2024-09-06 RJ connector clarifications
2024-09-10 Edge to main complete (#11)
    * Edge to main complete - some pics added and some updated. Updated pics have tag _Updated and the duplicates have been removed from git
    * cleaned up a couple more pics
    * Fixing arrow braces with proper arrows
    * Incorrect excerpt
    * Removed "updated"
    * Update spelling json
    * png to jpg and pic naming complete
    * Some tweaks
    * Some more reversions of changes that were working
    * Tweaks to Using page
    * Should be done now!
    ---------
2024-09-23 Update Connectors list to include SLB EXT
2024-09-24 gSender job loss recovery update (#18)
    * ready for review
    * quick update
    * Initial pass
    * Rearranged with my take
    * couple tweaks
    * Final edit
    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
2024-10-01 SLB Ubuntu USB driver fix
2024-10-02 Mill One Buttons
2024-10-02 Mill One buttons amend
2024-10-02 Mill One buttons notes
2024-10-04 Error 33 and adding laser
2024-10-16 Sanding painting finishing (#25)
    * new branch
    * images brought over
    * ncfs = new content from stephen
    * Tiniest of tweaks
    * Tweaks 3
    * Add hyphen to X-Carve
    * pics updated
    * draft 2
    * draft 2 quick fix
    * Couple updates to text and notes
    * Draft 3
    * quick clean up
    * Edits to prepare to merge online
    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
2024-11-01 Open source, use gSender no CNC
    [longmill-mk1-dust-shoe-hose-adapter.stl]
2024-11-15 SLB RGB LED and Switch clarifications
2024-11-15 Sienci Projects, & fixes, SLB 40-pin and RGB strip fixes, $10 picture
2025-02-14 Pics WP side update 1 (#38)
    * Pics WP side update 1
    * Update cspell.json
    * Update ytsb-lmk2-48-extension-kit.md
    * Update ytsb-lmk2-axes-completion.md
    * Update ytsb-lmk2-motors-and-wiring.md
    * Update ytsb-lmk2-x-and-z-axes.md
    * Update ytsb-lmk2-x-and-z-axes.md
    * Update ytsb-lmk2-y-axis-gantries.md
    * Update ytsb-lmk2-choosing-software.md
    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
2025-02-20 LMK2 Materials ytsb
2025-02-28 Laser again
2025-02-28 Laser 3
2025-02-28 Laser 4
2025-02-28 Laser 5
2025-02-28 Laser 6
2025-02-28 Laser 7
2025-02-28 Laser 8
2025-03-26 Spring loaded anti backlash nut update (#28)
    * Spring Loaded setup
    * Spring Loaded Draft 1
    * "Leadscrew" isn't a word
    * Initial tweaks
    * Initial read through
    * Spring loaded initial tweaks
    * Spring loaded final version
    * Update looks good with some final tweaks
    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
2025-03-26 MK1 & MK2 Spring loaded live
2025-03-26 Remove extra laser
2025-04-04 SLB accessories couple more tweaks
2025-04-09 grblHAL specific Alarms codes
2025-08-01 Update gs-grbl-alarm-error-codes.md (#59)
    * Update gs-grbl-alarm-error-codes.md
    * revised error troubleshooting
    * Update gs-grbl-alarm-error-codes.md
    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
2025-10-31 Updating t-track links
2025-11-03 LM gS New U full updates (#58)
    * update 1
    * Update ytsb-lmk2-spindle-kit.md
    * Update ytsb-lmk2-spindle-kit.md
    * updates
    * Fixed aspect ratios, tabs not needed during assembly
    * Redundant text removed
    * Unassociated change while I noticed it
    * lm gs - first project
    * lm gs - add a laser
    * lm gs - longmill add a laser
    * lm gs - common terms mk1
    * lm gs - firmware pic update
    * lm gs updates
    * lm gs - cnc issues complete pull into git
    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
2025-11-05 Revert LMK2 spindle page
2025-11-05 Unpublish Spindle kit page
2025-11-05 Publish LMK2 Laser
2025-11-05 Updates to Spindle and Laser
2025-11-05 Laser update
2025-11-05 Finally publish laser perhaps
2025-11-10 Updates to spindle add-on page
2025-11-12 Updates to broken links, duplicate open source files added to git
    [Air_Assist_Body.stl, Open Source LongBoard BOMs (Sienci Labs).xlsx, Open source Hardware BOMs (Sienci Labs).xlsx, Sienci Mill One_ Bill Of Materials.xlsx, longmill-mk1-dust-shoe-hose-adapter.stl, longmill-mk1-magnetic-dust-shoe-body.stl, longmill-mk1-magnetic-dust-shoe-bristle-hold.stl, sienci-steel-clamp-end-cap.stl]
2025-11-12 Remaining duplicate open source files added to git and fixes to broken links
    [3DP-Ready-CLS-Motor-Cover.stl]
2025-11-14 Import medium-done version of all LaserBeam content, including metadata, linting fix, and spelling fixes
2025-11-19 Gs 151 f and f (#54)
    * testing pics
    * gs 151 setup
    * gs full doc overhall
    * gs 151 pic organizing tweaks
    * gs 151 issues feedback tweaks
    * gs 151 ui options update
    * Updates to feedback page
    * Revert Feedback Updates since they're pushed main now
    * Finished reviewing shortcuts section, excess files deleted, text tidied, images cropped in
    * Some other shortcut images that don't belong
    * Finished reviewing Macros, squaring, and tuning
    * Delete more excess pictures
    * Finished reviewing surfacing, did parts of rotary, more excess pictures removed
    * Finished reviewing Macros, Touch Plate, Coolant, and parts of Stats
    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
2025-11-21 Placeholders in case of future migration
2025-11-21 Dust collection Draft 1 (#29)
    * new dust branch
    * update
    * dust draft 1
    * Corrected Powertec
    * dust rework - read monday
    * Dust final
    * dust feedback
    * update
    * more updates
    * updates dust
    * dust update
    * Tweak to intro
    * dust changes
    * dust safety break out and kelly feedback complete
    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
2025-12-03 Incorrect Allen key size in LongMill assembly
2025-12-04 Fixed ‘gSender reflashing’ typo in image on Step 7 “$RTS=$”, LM CNC terms page random [tabbyending] in the text, and updated the sources to open in a new tab
2025-12-04 SLB added note on laser setup polarity, removed excess spans
2025-12-04 Added in SparksTech video links, fixed bad grbl and YouTube links, upgraded gS install links
2025-12-17 GC Placeholders in case of future migration
2025-12-18 AM Placeholders in case of future migration
2025-12-18 LM gSender NewU Remaining updates (#69)
    * Moving over Touch Plate x2 pages and CNC Issues and Fixes
    * Undo work on Issue and fixes because it's already been pushed to main
    * Something about spaces being wrong?
    * Something about spaces being wrong? 2
    * running jobs complete
    * wasteboard
    * wasteboard complete
    * removed mk2 png files and replaced with jpg - removed ytsb tag on file
    * touchplate complete
    * add ons fixed
    * touch plate fixed png replaced
    * Fixed picture naming and order of information on surfacing page
    * Fixed broken pics, reviewed Wasteboard and Running Jobs updates then moved to new files to avoid merge conflicts
    * Undone changes to original pages missed
    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
2026-01-19 Cleanup of open source and community contributed files
    [Drew-G.-CNC-Chip-Load-Calculator.xls, Selling-Calculator.xlsm, Sienci Mill One_ Bill Of Materials.xlsx, Sienci-Mill-One-All-BOMs.xlsx]
2026-01-20 LM MK2 AutoSpin text updates (#53)
    * Grouping all of Kelly's AutoSpin text updates into a single branch
    * Perhaps fix conflict?
    * Perhaps fix conflict 2
    * Perhaps fix conflict 3
    * Add files via upload
    * add autospin photo
    * Add files via upload
    * Update lmk2-routers-and-spindles.md
    * edit to heading
    * Update lmk2-routers-and-spindles.md
    * small edit to "recommendations for the longmill" sentence
    * Update lmk2-motors-and-wiring.md
    * Add files via upload
    * Update lmk2-48x30-supplementary-manual.md
    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
2026-01-21 CLSM cable length update (#79)
2026-02-03 changed right to left side for controller cable installation in 2 spots (#83)
2026-02-09 aux power list changed to 0123 (#84)
    customers were trying values 1, 2, 3, 4 as reflected in our list structure. Tweaked to list 0, 1, 2, 3 the actual values used.
2026-02-17 Atci basics and assembly for AltMill (#85)
    * initial setup, text fill, formatting of atc assembly
    * unboxing and spindle complete
    * pictures going in
    * spindle pictures update
    * vfd page update
    * spindle setup updates
    * test
    * 1st draft
    * photo inputs vfd install
    * vfd install more pictures
    * air filter photos
    * initial tool rack photos
    * unboxing and spindle pages have pics added and tweaks made
    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
2026-02-26 Atc assembly vfd feb (#86)
    * vfd beginning updates
    * atc unboxing revision
    * revisions on multiple pages
    * t-nuts and header edit
    * unboxing page format tweaks
    * software section updates
    * formatting changes
    * further formatting
    * dust shoe pictures and edits
    * software page updates
    * fastener edit, starting final chec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
2026-03-05 clsm a axis fix to x axis (#87)
2026-03-14 Atc final checks project (#91)
    * final checks writeup
    * term changes
    * 1st project outline
    * terminology changes
    * first project progress
    * first project pics
    * pic testing on tool rack page
    * atc welcome page before you begin updates
    * spindle welcome before you begin updates
    * before you begin updates
    * spindle half way through updates
    * spindle v1 updates
    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
2026-03-16 spindle page johann tweaks and skip no to yes on before you begin (#92)
2026-03-18 slb to slb ext in a couple places (#93)
2026-03-20 Atc vfd toolrack air v3 (#94)
    * terms changed to match bom
    * term changes dust shoe
    * atc shield unboxing edit
    * vfd and tool rack headers
    * air filter and dust shoe headers
    * vfd install cleanup
    * pic naming tweaks
    * updates to air
    * air updated w render requests
    * small unboxing tweak
    * dust shoe renders revisited
    * tool rack render
    * tool pic name tweaks
    * unboxing revamp and software wip
    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
2026-03-23 Atc consolidation v4 (#95)
    * vfd edits
    * tool rack changes
    * air filter tweaks final checks 1st project changes
    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
2026-03-30 Atc finalchecks 1stpro v5 (#96)
    * final checks draft
    * small edit to final check
    * gcontrol panel update to software start
    * 1st project updates
    * removed tips from unboxing - rejig before you begin - spindle setup wip
    * spindle setup edits, articles reorder
    * tool tls rejig
    * small edits to dust shoe
    * fixing up photo links in vfd install
    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
2026-04-08 Atc 1stpro software v6 (#98)
    * picture link fix vfd install and dust shoe
    * more picture edits
    * spindle mounting holes pictures
    * picture restructure begin
    * more picture work
    * parts needed edits on tool rack
    * spindle picture updates
    * vfd pictures update
    * atc drag chain arm term
    * air pictures complete
    * tool rack photo replace
    * spindle z plus drag chain mount update
    * software setup photos, air comp edits
    * minor edits to software
    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
    [3DP-Ready-CLS-Motor-Cover.stl]
2026-04-08 Atc v7 (#99)
    * vortex video added to welcome
    * altmill doc folder moved and firmware tweaks
    * firmware file uploaded
    [3DP-Ready-CLS-Motor-Cover.stl]
2026-04-14 Atc v8 (#100)
    * software final checks dust shoe picture moving delete temp pics
    * tool rack picture edits
    * unboxing fixes
    * spindle image update
    * tool rack renders
    * spindle page updates
    * tool rack cable routing
    * spindle before you begin tweaks
    * pic modifications
    * modified dust shoe photo
    * updated dust shoe pics
    * tool rack tweaks
    * spindle pics
    * software setup tip
    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
2026-04-15 Atc johann tweaks v11 (#103)
    * welcome and before you begin publish
    * spindle publish
    * tool rack publish
    * air publish
    * software publish
2026-04-16 header z axis change
2026-05-05 atc spindle tweaks
2026-05-12 spindle vs router revision
2026-05-13 grbl alarms
2026-05-13 homing section complete (#123)
2026-05-14 Gsender final advanced articles v6 (#124)
    * calibration complete
    * gsender feature tear apart complete
2026-05-19 added laser config files
2026-05-25 steppers 2
2026-06-01 edits to TLS, autozero, laser, dust shoe, mk3 title changes
2026-06-08 publish spindle KB
2026-06-08 updated mounting pictures
2026-06-09 iot relay publish, slb firmware flashing unhide stm cube
2026-06-17 added more pictures for tls mounting, removed obsolete gsender setting step, draft notes in inductive sensor mk3 page
2026-07-07 standard touch plate page
2026-07-08 collet nut thread and size
2026-07-15 rearranged articles, added spindle kit instructions
2026-07-16 renamed laser file links to encompass range of firmware versions
2026-07-16 added step to rotate coupler to move z-axis
2026-07-27 updated mk2 buttons link, incorporated feedback for mk3 surfacing / first proj
2026-09-03 reorganized based on video assembly
2026-09-09 publish mk3 plus a couple renders (#197)
2026-09-14 mk3 drag chain tweaks
2026-09-22 mk3 drag chain image fix
2026-09-28 probe corner note
2026-10-06 lmk3 cad, more images
2026-10-13 all images inserted
